Reedgarden/WRS-HW/mechanics/v3.4/emblema seven.JPG

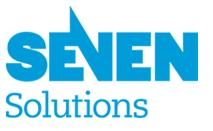
mechanics/v3.4/emblema seven.JPG
