Reedgarden/WRS-HW/mechanics/v3.4/BOX_WRS_PART_LIST.xls

 | SEVEN SOLUTIONS S.L.
TEAM | BOX_WRS
PROYECT | WHITE RABBIT
DOCUMENT | Part List
VERSION | 3.4
MADE BY | RODRIGO AGIS
VERIFIED BY | DAVID RAMIREZ
APPROVED BY | RODRIGO AGIS
DATE | 05/11/2015
OBSERVATIONS
ITEM | DESCRIPTION | MANUFACTURER | MANUFACTURER PN | QUANTITY PER SWITCH
1 | FAN 40x40x20 | Gicoda | MB40201VX-000U-A99 | 2
2 | FINGER GUARD | MULTICOMP | 1710466 | 2
3 | WIRE TO BOARD CONNECTOR | WURTH ELEKTRONIK | 61900211621 | 2
4 | PIN TERMINAL FAN | WURTH ELEKTRONIK | 61900113722DEC | 4
5 | COOLER MOUNTING FPGA | MALICO | CL-Y-35X35 | 1
6 | COOLER FPGA H = 12 mm | MALICO | MBH35002-12P/2.6 | 1
7 | SILICON PAD 1.06mm, 4"x4" | BERGQUIST | GP5000S35-0.040-02-0404 | 1 / 9
8 | POWER SUPPLY, 12V, 80W | EOS | LFVLT80-1001 | 1
9 | POWER FILTER, 4 A-230V | SCHURTER | DC12.3102.001 | 1
10 | POWER WIRE 230V | APSA | 1450/2.5 SW | 1
11 | WIRE 18AWG, 1.169mm^2 BLACK | ALPHAWIRE | 6715 BK005 | 25 CM
12 | WIRE 18AWG,1.169mm^2 RED | ALPHAWIRE | 6715 RD005 | 45 CM
13 | WIRE 18AWG, 1.169mm^2 BLUE | ALPHAWIRE | 6715 BL005 | 25 CM
14 | WIRE 18AWG, 1.169mm^2 YELLOW/GREEN | ALPHAWIRE | 6715 GY005 | 40 CM
15 | TERMINAL PIN SOCKET FACTON, RED 6.35MM ISOLATED | MULTICOMP | FDFNYD1-250 | 4
16 | TERMINAL PIN, BULLET, PLUG, RED | JST (JAPAN SOLDERLESS TERMINALS) | FVDAGM1.25-5 (LF) | 1
17 | TERMINAL PIN, BULLET, SOCKET, RED | JST (JAPAN SOLDERLESS TERMINALS) | CVDAGF1.25-5 (LF) | 1
18 | TERMINAL PIN FASTON ISOLATED, RING, 3MM, RED | JST (JAPAN SOLDERLESS TERMINALS) | FVWS1.25-3 (LF) | 4
19 | RESET WIRE | JST (JAPAN SOLDERLESS TERMINALS) | SMF-20LV300-D.. | 1
20 | WIRE CASE CONNECTOR | JST (JAPAN SOLDERLESS TERMINALS) | 1P-SMF | 25 CM
21 | WIRE CONNECTOR | SULLINS CONNECTOR SOLUTIONS | LPPB032CFFN-RC | 1
22 | SPACERS SCB H=8mm D=4,75mm | HARWIN | 1703088 | 4
23 | NUT IOX M4 | DURATOOL | M4- HFA2-S100- | 9
24 | WASHER INOX M3 | DURATOOL | 6797/3.0 | 2
25 | WASHER INOX M4 | DURATOOL | 6797/4.3 | 5
26 | SCREW METAL BOX INOX DIN7991 M3x8MM | TR FASTENINGS | M38 KHHTMCS100- | 13
27 | SCREW METAL BOX INOX DIN7991 M3x12MM | TR FASTENINGS | M312 KHA2MCS50- | 2
28 | SCREW PCB MINI BACK-PLANE GROUND ISO 7380 M3x8MM | DURATOOL | M38 BHA2MCS100- | 12
29 | SCREW SCB ISO 7380 M3X16MM | TR FASTENINGS | W/M3/16/BHA2MC/TC1D | 4
30 | SCREW GROUND METAL BOX ISO 7380 M4x10MM | TR FASTENINGS | M410 BHA2MCS100- | 5
31 | SCREW GROUND (BACK) 4x25MM INOX | TR FASTENINGS | M425 SOA2CSS50- | 1
32 | SCREW FAN ISO 7380 M4X30MM | TR FASTENINGS | M430 KHHTMCS100- | 8
33 | PIN TERMINAL SUPPLY (OUT 12V, IN 230V), paso 3.96MM, 18 a 24 DWG | MOLEX | 08-50-0106 | 6
34 | TERMINAL PIN IN 12V PCB. | TE CONNECTIVITY / AMP | 163306-2 | 2
35 | SUPPLY CONNECTOR COVER PCB (12V), 2 PINS | TE CONNECTIVITY / AMP | 1-480318-0 | 1
36 | SUPPLY CONNECTOR COVER ( OUT 12V), 12 PINS, 3.96mm,. | MOLEX | 09-50-3121 | 1
37 | SUPPLY CONNECTOR PINS COVER 3 PINS (IN 230V), 3.96mm. | MOLEX | 09-50-3031 | 1
