Reedgarden/WRS-HW/circuit_board/wrs_v3/SCB_SAM9G45/PartLists/SCB_White_Rabbit_Part_List_3_4.1.xls

 |  |  | SEVEN SOLUTIONS S.L.
 |  | EQUIPO | SCB
 |  | PROYECTO | WHITE RABBIT
 |  | DOCUMENTO | 7S_IDC14-SCB-V3_4-PL-V3_41
 |  | VERSIÓN | 3.41
 |  | REALIZADO POR | J. GABRIEL RAMÍREZ
 |  | VERIFICADO POR | ÁNGEL TOBARUELA
 |  | APROBADO POR | J. GABRIEL RAMÍREZ
 |  | FECHA | 22/09/2014
 |  | COMENTARIOS | Cambios conforme PC-02
Position | Manufacturer PN | Manufacturer | Description | Designator | Footprint | Quantity | Distributor1 | Distributor1 PN | Cambios con respecto a V3.4
1 | SCB_V3_4 | Labs Circuits | 12 Layers PCB | N/A | N/A | 1 | N/A | N/A
2 | C2012X5R0J226M | TDK | 22uF ±20% 6,3V X5R Capacitor | C1, C2, C3, C4, C75, C76, C85, C86, C247, C263, C266, C268, C269, C270, C271, C283, C292, C294, C295, C296, C297, C300, C301, C302, C311, C429, C430, C431, C432 | CC2012-0805 | 29 | Digikey | 445-1422-1-ND
3 | C1608X5R1A475K | TDK | 4,7uF ±10% 10V X5R Capacitor | C10, C23, C68, C71, C72, C74, C84, C91, C92, C93, C94, C95, C96, C218, C238, C246, C255, C256, C264, C267, C273, C274, C275, C276, C277, C284, C287, C303, C304, C312, C318, C322, C323 | CC1608-0603 | 33 | Digikey | 445-5170-1-ND
4 | C1005X7R1C224K | TDK | 220nF ±10% 16V X7R Capacitor | C104, C105, C106, C107, C108, C109, C110, C111, C112, C113, C114, C115, C116, C117, C118, C119, C120, C121, C123, C124, C126, C127, C128, C129, C130, C131, C132, C133, C134, C135, C136, C137 | CC1005-0402 | 32 | Digikey | 445-5936-1-ND
5 | C1005X7R1E102K | TDK | 1nF ±10% 25V X7R Capacitor |  | CC1005-0402 | 0 | Digikey | 445-4924-1-ND
6 | C1608C0G1H330J | TDK | 33pF ±5% 50V COG Capacitor | C164 | CC1608-0603 | 1 | Digikey | 445-1275-1-ND
7 | CC0603KRX7R9BB104 | Phycomp | 100nF ±10% 50V X7R Capacitor |  | CC1608-0603 | 0 | Digikey | 311-1344-1-ND
8 | C1005C0G1H100C | TDK | 10pF ±5% 50V NP0 Capacitor | C166, C202, C204, C205, C314 | CC1005-0402 | 5 | Digikey | 445-4896-1-ND
9 | CC0603KRX7R6BB224 | Yageo | 220nF ±10% 10V X7R Capacitor | C165, C168 | CC1608-0603 | 2 | DigiKey | 311-1346-1-ND
10 | C1608C0G1H680J | TDK | 68pF ±5% 50V COG Capacitor | C170 | CC1608-0603 | 1 | Digikey | 445-1279-1-ND
11 | C1005C0G1H150J | TDK | 15pF ±5% 50V NP0 Capacitor | C19, C20 | CC1005-0402 | 2 | Digikey | 445-1237-1-ND
12 | C1005X7R1H471K | TDK | 470pF ±10% 50V X7R Capacitor |  | CC1005-0402 | 0 | Digikey | 445-1255-1-ND
13 | C1005C0G1H270J | TDK | 27pF ±5% 50V NP0 Capacitor | C21, C22 | CC1005-0402 | 2 | Digikey | 445-1240-1-ND
14 | B32529C1104K000 | EPCOS | 100nF ±10% 100V Polyester Capacitor | C214 |  | 1 | Farnell | 9750983
15 | C2012X5R1C226K | Phycomp | 22uF ±10% 16V X5R Capacitor | C239, C248, C254, C257, C278, C279, C305, C306 | CC2012-0805 | 8 | Digikey | 445-6797-1-ND
16 | ECJ-0EB1H272K | Panasonic | 2,7nF ±10% 50V X7R Capacitor | C163, C206, C245, C262, C265, C282, C310 | CC1005-0402 | 7 | Digikey | PCC1726CT-ND
17 | T520D227M010ATE018 | Kemet | 220uF ±20% 10V 18mOhm Tantalum Capacitor | C249, C258, C280, C307 | D | 4 | Digikey | 399-4045-1-ND
18 | T520D227M006ATE009 | Kemet | 220uF ±20% 6,3V 9mOhm Tantalum Capacitor | C259, C260, C288, C289, C290, C291, C427, C428 | D | 8 | Digikey | 399-4042-1-ND
19 | C1005X7R1E223K | TDK | 22nF ±10% 25V X7R Capacitor |  | CC1005-0402 | 0 | Digikey | 445-1261-1-ND
20 | C1608X5R0J106M | TDK | 10uF ±20% 6,3V X5R Capacitor | C35, C36, C42, C46, C47, C55, C140, C144, C151, C155, C156, C161, C167, C175, C203, C211 | CC1608-0603 | 16 | Digikey | 445-4112-1-ND
21 | C1005X7R1E473K | TDK | 47nF ±10% 25V X7R Capacitor | C53, C54, C328 | CC1005-0402 | 3 | Digikey | 445-4941-1-ND
22 | C1005X7R1C104K | TDK | 100nF ±10% 16V X7R Capacitor | C5, C6, C7, C8, C9, C11, C12, C13, C14, C15, C16, C17, C18, C24, C25, C26, C29, C30, C31, C33, C34, C37, C38, C40, C41, C44, C45, C52, C56, C57, C59, C60, C100, C141, C142, C143, C146, C148, C159, C160, C162, C169, C171, C172, C173, C174, C176, C177, C178, C180, C181, C183, C184, C186, C187, C191, C192, C193, C194, C201, C207, C208, C209, C210, C212, C213, C215, C216, C217, C219, C220, C221, C222, C223, C224, C225, C226, C227, C228, C229, C230, C231, C232, C233, C234, C240, C241, C242, C243, C244, C253, C261, C285, C286, C293, C298, C299, C309, C316, C317, C319, C320, C321, C324, C325, C326, C422 | CC1005-0402 | 111 | Digikey | 445-4952-1-ND
23 | C1005X7R1E103K | TDK | 10nF ±10% 50V X7R Capacitor | C43, C58, C88, C89, C90, C99, C101, C102, C103, C122, C125, C138, C139, C149, C150, C152, C153, C154, C157, C158, C185, C189, C190, C195, C196, C197, C199, C327 | CC1005-0402 | 28 | Digikey | 445-1260-1-ND
24 | C1005X5R1C105K | TDK | 1uF ±10% 16V X5R Capacitor | C61, C235, C236, C237, C250, C251, C252, C272, C281, C315 | CC1005-0402 | 10 | Digikey | 445-4978-1-ND
25 | o.c. | Phycomp | Capacitor |  | CC1608-0603 | 0 | Digikey
26 | C1005X5R1C474K | TDK | 470nF ±10% 16V X5R Capacitor | C69, C70, C73, C83, C87 | CC1005-0402 | 5 | Digikey | 445-4976-1-ND
27 | T520D337M006ATE025 | Kemet | 330uF ±20% 6,3V 25mOhm Tantalum Capacitor | C77, C78, C79, C80, C81, C82, C97, C98 | D | 8 | Digikey | 399-4053-1-ND
28 | 1888250-1 | Tyco Electronics | Low Profile uTCA Ethernet Jack (RJ45) | CN1 | TYCO_ETHERNET_1888250-1 | 1 | Digikey | A98526-ND
29 | KX15-20K4DE |  | Multipin B2B Connector (plug) 20 pins |  | JAE_KX15_20P | 0 | Digikey | 670-1305-ND
30 | BM02B-SRSS-TB(LF)(SN) | JAPAN SOLDERLESS TERMINALS | Disconnectable Crimp Style Connector, 1.0mm pitch | CN3 | SH_CRIMP_1MM_2 | 1 | Farnell | 1679127
31 | UTCA_MCH_TONGUE3 | N/A | microTCA MTCA.0 standard MCH connector 3 |  | UTCA_MCH_TONGUE2_3_4 | 0 | N/A | N/A
32 | 1734035-1 | TE CONNECTIVITY | Mini USB Receptacle Type B Right Angle |  | USBB-G | 0 | Farnell | 1654060
33 | TS4148 RZ | Taiwan Semiconductor | High Speed Switching Diode | D1, D2, D3, D4 | CC1608-0603 | 4 | Farnell | 8150192
34 | LG L29K-G2J1-24-Z | Osram | LED SMARTLED GREEN 570NM | D11, D12, D13, D14 | CD1608-0603 | 4 | DigiKey | 475-2709-1-ND
35 | S2M-TP | Fairchild | Standard Diode 2A, 1KV, SMD | D16 |  | 1 | Digikey | S2M-TPMSCT-ND
36 | BAT54A-G | Comchip Technology | Schottky Barrier Double 200mA Diode | D5, D6, D9, D10 | SOT23 | 4 | Digikey | 641-1319-1-ND
37 | BAV99 | NXP | Silicon Switching Diode Array for High-Speed Switching | D8, D15 | SOT-23 | 2 | Farnell | 1081211
38 | SN74LVT125D | TEXAS INSTRUMENTS | Quad Buffer with 3-State Outputs with TTL Compatible Inputs | IC1 | PW014 | 1 | Farnell | 9592849
39 | AD8541AKSZ | Analog Devices | General-Purpose CMOS Amplifier, Rail-to-Rail input and output, 1MHz Bandwidth |  | SOT65P210X110-5N | 0 | Digikey | AD8541AKSZ-REEL7CT-ND
40 | ADCMP600BRJZ-R2 | Analog Devices | Rail-to-Rail, Very Fast, 2.5V to 5.5V, Single-Supply TTL/CMOS Comparators | IC11 | SOT23-5AL | 1 | Digikey | ADCMP600BRJZ-REEL7CT-ND
41 | MC100LVEP14DTG | On Semiconductors | Low-Voltage 1:5 Differential LVECL/LVPECL/LVEPECL/HSTL Clock Driver | IC12 | 948E-02_N | 1 | DigiKey | MC100LVEP14DTGOS-ND
42 | CDCM61002RHBT | Texas Instruments | Low Jitter Clock Generator, Two Outpust, Integrated VCO | IC13 | QFN32_POWERPAD | 1 | Farnell | 1710794
43 | AD9516-4BCPZ | Analog Devices | Clock Generator 2.5GHz VCO, 14 outputs (LVPECL, LVDS/CMOS) | IC16 | QFN50P900X900X100-64M | 1 | Digikey | AD9516-4BCPZ-ND
44 | TMP100NA/250 | TEXAS INSTRUMENTS | I2C Temperature Sensor | IC17, IC18, IC19, IC20 | SOT23A-6L | 4 | DigiKey | 296-12749-1-ND
45 | DS1374U-33+ | Maxim | I2C, 32 BIT BINARY COUNTER WATCHDOG RTC |  | UMAX10 | 0 | Digikey | DS1374U-33+-ND
46 | DS90LV011ATMF | National Semiconductor | Single High Speed Differential Driver | IC21 | MF05A_N | 1 | Digikey | DS90LV011ATMFCT-ND
47 | FNETHE025 | Pericom | SMD oscillator 3.3V (Elfa) | IC22, IC40 | SPXO | 2 | DigiKey | FNETHE025CT-ND
48 | AT45DB642D-CNU | Atmel | 64-megabit 2.7V, Dual-Interface DataFlash | IC25 | 8CN3 | 1 | DigiKey | AT45DB642D-CNU-ND
49 | SN74LVC1G32DBVR | TEXAS INSTRUMENTS | Single 2-Input Positive-OR Gate | IC26 | SOT23-5AL | 1 | DigiKey | 296-9847-1-ND
50 | LM385M3-2.5/NOPB | National Semiconductor | Micropower Voltage Reference 2.5V Diode | IC28 | MF03A_N | 1 | DigiKey | LM385M3-2.5CT-ND
51 | DS1374U-18+ | Maxim | I2C, 32 BIT BINARY COUNTER WATCHDOG RTC |  | UMAX10 | 0 | Digikey | DS1374U-18+-ND
52 | MT29F4G16ABBDAHC:D TR | Micron Techology | NAND Flash 256Mx16, 1.8V Asynch/Page | IC30 | VFBGA63 | 1 | Digikey | 557-1463-1-ND
53 | MAX3232CDBR | TEXAS INSTRUMENTS | 3-V to 5.5V Multichannel RS-232 Line Driver/Receiver with +/-15-KV ESD Protection | IC31 | SSOP16 | 1 | DigiKey | 296-13093-1-ND
54 | AP7173-SPG-13 | Diodes Inc. | 1.5A Low Dropout Linera Regulator | IC32, IC34, IC35, IC39, IC48 | SOIC127P600-8AL | 5 | Digikey | AP7173-SPG-13DICT-ND
55 | XC6VLX240T-1FFG1156C | Xilinx | Virtex-6 LXT Platform FPGA, 600 User I/Os, 20 GTXs, 1156-Ball FFBGA, Speed Grade 1, Commercial Grade | IC33 | FF1156 | 1 | CERN | N/A
56 | PC28F256P30BFA | Numonyx | NOR Flash Memory, 256Mbit |  | BGA64C100P8X8_1300X1000X120 | 0 | Digikey | PC28F256P30BFA-ND
57 | MCP1802T-3002I/OT | Microchip Technology | 300 mA, High PSRR, Low Quiescent Current LDO, 5-Pin SOT-23, Industrial Temperature, Tape and Reel | IC38, IC44 | SOT-23-OT5_N | 2 | DigiKey | MCP1802T-3002I/OTCT-ND
58 | VM53S3-25.000-2.5/-30+75 | MEC | VCTCXO 25MHz Oscillator | IC4 | VCTCXO_VM53S | 1 | RS | 672-0797
59 | LAN8720A-CP | SMSC | RMII Ethernet Transceiver with Auto MIDIX | IC41 | QFN50P400X400-24W4M | 1 | Digikey | 638-1080-ND
60 | CY7C1314KV18-250BZXC | Cypress Semic. | 18-Mbit (512Kx36) QDRII SRAM 2-Word Burst Architecture |  | BGA165C100P11X15_1300X1500X140 | 0 | Digikey | CY7C1314KV18-250BZXC-ND
61 | TPS51200DRCR | TEXAS INSTRUMENTS | Sink/Source DDR Termination Regulator |  | SON50P300X300X100-11N-R175X250 | 0 | Digikey | 296-26978-1-ND
62 | TPS53126RGET | TEXAS INSTRUMENTS | Dual Synchronous Step-Down Controller For Low Voltage Power Rails | IC46, IC47 | QFN50P400X400X100-25N-S255 | 2 | DigiKey | 296-24598-1-ND
63 | AD5662BRJZ | Analog Devices | NanoDAC 16 Bits, SPI, 2.7V to 5.5V, 250uA, Rail-to-Rail Output | IC5, IC8 | SOT23-8 | 2 | DigiKey | AD5662BRJZ-2REEL7CT-ND
64 | MT47H32M16HR-25E IT:G TR | Micron Techology | DDR2 SDRAM 8Mx16x4 Banks | IC50 | BGA-84 | 1 | DigiKey | 557-1520-1-ND
65 | AT91SAM9G45-CU | Atmel | ARM9 MCU 400 MHZ, RAM 64KB, ROM 64KB, 160 I/Os, Ethernet, I²C, MMC, SPI, SSC, UART/USART, USB, AC'97, LCD, POR, PWM, WDT | IC6 | TFBGA324 | 1 | DigiKey | AT91SAM9G45-CU-ND
66 | FRETHE025 | Pericom | VCXO 25MHz Oscillator | IC7 | vs-705 | 1 | Digikey | FRETHE025-ND
67 | ICS83023AMILF | IDT | 350MHz Differential-to-LVCMOS Dual Translator/Buffer | IC9 | TSOP65P490-8AN | 1 | Digikey | 800-1102-5-ND
68 | QSS-048-01-L-D-DP QSS-075-01-L-D-A | Samtec | High Speed Ground Plane Socket, 48 Differential Pair Signaling, | J1, J2 | QSS-048-01-X-D-DP-A | 2 | Samtec
69 | QSS-016-01-L-D-DP | Samtec | High Speed Ground Plane Socket, 16 Differential Pair Signaling, |  | QSS-016-01-X-D-DP-A | 0 | Samtec
70 | DC10A | CLIFF ELECTRONIC COMPONENTS | Power Jack 5A @ 12V |  | dc-10 | 0 | Farnell | 224959
71 | 742792093 | Wurth Electronics Inc | FERRITE BEAD 2200 OHM .20A 0805 | L1, L16, L17, L18 | 742792093 | 4 | DigiKey | 732-1609-1-ND
72 | IHLP2525CZER1R5M01 | Vishay/Dale | Low Profile, High Current Inductor, 1.5uH±20%, 9A, 15mOhm | L11, L13, L14, L15 | IHLP2525 | 4 | Digikey | 541-1007-1-ND
73 | BLM18KG221SN1D | Murata | 220R@100MHz 2,2A 50mOhm Ferrite Bead | L2, L3, L4, L5, L6, L7, L8, L9, L12, L19, L20 | 0603 | 11 | Digikey | 490-5255-1-ND
74 | 152123 | Amphenol | SMC Straight Connector | P1, P3, P4, P7, P8 | SMB_V-RJ45 | 5 | Digikey | ACX1509-ND
75 | M22-5320305 | Harwin | Header, 6-Pin, Dual row, 2,54 mm pitch | P2 | HDR2X3 | 1 | Digikey | 952-1340-ND
76 | 0878321421 | Molex | SMD Header, 7-Pin, Dual row, 2mm pitch | P5 | CONN_HDR_SMD_2mm_2x7 | 1 | Digikey | WM4231-ND
77 | SBH11-PBPC-D10-ST-BK | Sullins Connector Solutions | Header, 10-Pin, Dual row, 2,54mm pitch | P6 | HDR2X10 | 1 | DigiKey | S9172-ND
78 | BG055-03A-1-0450-0530-0350-L-G | GLOBAL CONNECTOR TECHNOLOGY |  |  | HDR1x3_BG055 | 0 | Farnell | 1798981
79 | NDS331N | Fairchild | N-Channel Logic Level Enhancement Mode Field Effect Transistor | Q1, Q2, Q3 | SOT23-3 | 3 | Digikey | NDS331NCT-ND
80 | CRCW0805100RFKEAHP | Vishay/Dale | 100R ±1% 0.33W ±100ppm/°C Resistor | R31, R32, R257, R258 | 0805 | 4 | Digikey | 541-100TCT-ND
81 | ERJ-2RKF2201X | Panasonic | 2K2 ±1% 0.1W ±100ppm/°C Resistor | R36, R38 | 0402 | 2 | DigiKey | P2.20KLCT-ND
82 | ERJ-2RKF3002X | Panasonic | 30K ±1% 0.1W ±100ppm/°C Resistor | R107, R175 | 0402 | 2 | DigiKey | P30.0KLCT-ND
83 | RC0402FR-0722KL | Yageo | 22K ±1% 0.063W ±100ppm/°C Resistor | R116, R176, R206 | 0402 | 3 | DigiKey | 311-22.0KLRCT-ND
84 | ERJ-2RKF4701X | Panasonic | 4K7 ±1% 0.1W ±100ppm/°C Resistor | R45, R47, R48, R49, R55, R100, R102, R110, R111, R117, R120, R126, R132, R185, R189, R200, R202, R203, R208, R209, R232, R237, R239, R240, R243, R248, R249, R252, R256 | 0402 | 29 | DigiKey | P4.70KLCT-ND
85 | ERJ-2RKF33R0X | Panasonic | 33R ±1% 0.1W ±100ppm/°C Resistor | R30, R63, R70, R78, R142, R143, R144, R146, R147, R151 | 0402 | 10 | DigiKey | P33.0LCT-ND
86 | ERJ-2RKF1501X | Panasonic | 1K5 ±1% 0.1W ±100ppm/°C Resistor | R159, R186, R195, R196, R236 | 0402 | 5 | DigiKey | P1.50KLCT-ND
87 | ERJ-2RKF4871X | Panasonic | 4K87 ±1% 0.1W ±100ppm/°C Resistor | R178 | 0402 | 1 | DigiKey | P4.87KLCT-ND
88 | ERJ-2RKF2431X | Panasonic | 2K43 ±1% 0.1W ±100ppm/°C Resistor | R180 | 0402 | 1 | DigiKey | P2.43KLCT-ND
89 | ERJ-2RKF6811X | Panasonic | 6K81 ±1% 0.1W ±100ppm/°C Resistor | R194 | 0402 | 1 | DigiKey | P6.81KLCT-ND
90 | ERJ-2RKF1212X | Panasonic | 12K1 ±1% 0.1W ±100ppm/°C Resistor | R197 | 0402 | 1 | DigiKey | P12.1KLCT-ND
91 | o.c. | N/A, Panasonic | SMD Resistor |  | 0402 | 0 | DigiKey, N/A | N/A
92 | ERJ-2RKF4700X | Panasonic | 470R ±1% 0.1W ±100ppm/°C Resistor | R20, R22, R33, R145 | 0402 | 4 | DigiKey | P470LCT-ND
93 | RC0603JR-070RL | Panasonic | 0R0 Ohm 1/10W 0603 Resistor | R177 | 0603 | 1 | DigiKey | 311-0.0GRCT-ND
94 | ERJ-2RKF2490X | Panasonic | 249R ±1% 0.1W ±100ppm/°C Resistor |  | 0402 | 0 | DigiKey | P249LCT-ND
95 | ERJ-2RKF9311X | Panasonic | 9K31 ±1% 0.1W ±100ppm/°C Resistor | R228, R234 | 0402 | 2 | DigiKey | P9.31KLCT-ND
96 | ERJ-2RKF2000X | Panasonic | 200R ±1% 0.1W ±100ppm/°C Resistor | R42, R68, R71, R72, R73, R81, R82, R84, R85, R87, R88, R89, R91, R92, R93, R141, R246, R247 | 0402 | 18 | DigiKey | P200LCT-ND
97 | ERJ-2RKF2801X | Panasonic | 2K8 ±1% 0.1W ±100ppm/°C Resistor | R230 | 0402 | 1 | DigiKey | P2.80KLCT-ND
98 | ERJ-2RKF1302X | Panasonic | 13K ±1% 0.1W ±100ppm/°C Resistor | R241 | 0402 | 1 | DigiKey | P13.0KLCT-ND
99 | ERJ-2RKF1000X | Panasonic | 100R ±1% 0.1W ±100ppm/°C Resistor | R29, R39, R59, R90, R171, R193, R218, R220, R223, R224, R225, R245, R250 | 0402 | 13 | DigiKey | P100LCT-ND
100 | ERJ-2RKF1002X | Panasonic | 10K ±1% 0.1W ±100ppm/°C Resistor | R4, R5, R6, R11, R35, R37, R106, R128, R129, R138, R165, R166, R167, R168, R169, R170, R181, R188, R190, R191, R198, R199, R207, R211, R229, R231, R238, R242 | 0402 | 28 | DigiKey | P10.0KLCT-ND
101 | CRCW060333R0FKEAHP | Vishay/Dale | 33R ±1% 0.25W ±100ppm/°C Resistor | R34, R41, R172, R173, R182, R183 | 0603 | 6 | DigiKey | 541-33.0SCT-ND
102 | ERJ-2RKF1001X | Panasonic | 1K ±1% 0.1W ±100ppm/°C Resistor | R101, R103, R104, R105, R112, R113, R114, R115, R121, R124, R133, R136, R205 | 0402 | 13 | DigiKey | P1.00KLCT-ND
103 | CRCW060349R9FKEAHP | Vishay/Dale | 49R9 ±1% 0.25W ±100ppm/°C Resistor | R40, R154, R155, R156, R157 | 0603 | 5 | DigiKey | 541-49.9SCT-ND
104 | ERJ-2RKF3300X | Panasonic | 330R ±1% 0.1W ±100ppm/°C Resistor | R1, R46, R160, R161, R162, R163, R184, R217, R219, R221, R222, R226 | 0402 | 12 | DigiKey | P330LCT-ND
105 | ERJ-2GE0R00X | Panasonic | 0R0 Ohm 1/10W 0402 Resistor | R28, R152, R153, R187, R192, R210, R233, R251 | 0402 | 8 | DigiKey | P0.0JCT-ND
106 | ERJ-2RKF1003X | Panasonic | 100K ±1% 0.1W ±100ppm/°C Resistor | R7, R8, R9, R10, R158 | 0402 | 5 | DigiKey | P100KLCT-ND
107 | ERJ-2RKF49R9X | Panasonic | 49R9 ±1% 0.1W ±100ppm/°C Resistor | R23, R24, R25, R26, R27, R75, R77, R174 | 0402 | 8 | DigiKey | P49.9LCT-ND
108 | ERJ-3EKF8200V | Panasonic | 820R ±1% 0.1W ±100ppm/°C Resistor | R79 | 0603 | 1 | DigiKey | P820HCT-ND
109 | ERJ-3EKF3900V | Panasonic | 390R ±1% 0.1W ±100ppm/°C Resistor | R80 | 0603 | 1 | DigiKey | P390HCT-ND
110 | ERJ-2RKF4121X | Panasonic | 4K12 ±1% 0.1W ±100ppm/°C Resistor | R83, R98, R99, R108, R109, R118, R130, R148, R204 | 0402 | 9 | DigiKey | P4.12KLCT-ND
111 | ERJ-2RKF5101X | Panasonic | 5K1 ±1% 0.1W ±100ppm/°C Resistor | R86 | 0402 | 1 | DigiKey | P5.10KLCT-ND
112 | EXB-E10C470J | Panasonic | 47R, 62.5mW Chip Resistor Bussed Network |  | EXBE | 0 | DigiKey | U8470CT-ND
113 | MNR18E0APJ270 | Rohm | 27R, 62.5mW Chip Resistor 8 Elements Array | RP15, RP16, RP17, RP18, RP19, RP20 | RESCAXS50P160X380X60-16N | 6 | DigiKey | MNR18270CT-ND
114 | FSM6JSMA | Tyco Electronics | Push button | S1, S2 | SWITCH | 2 | Farnell | 1555991
115 | 219-4MST | CTS Electrocomponents | 4 Positions DIP SWITCH |  | NHDS-8 | 0 | Digikey | CT2194MST-ND
116 | IRF9910Pbf | INTERNATIONAL RECTIFIER | Dual N-Channel 20V 10A MOSFET Logic Level Gate, 9.3mOhm@12A | T2, T3, T4, T5 | SOIC127P600X175-8N | 4 | DigiKey | IRF9910PBFCT-ND
117 | H1260NL | Pulse | Ethernet Trafo (TME) | Tr1 | H1260NL | 1 | Digikey | 553-1328-ND
118 | 1812WBT2_4LB | Coilcraft | SMT Mini WideBand Transformer 2:1, 11-200 MHz |  | 1812WBT2_4LB | 0 | Coilcraft | 1812WBT2_4LB
119 | ABS09-32.768KHZ-T | Raltron | Crystal Oscillator 32768 Hz 12,5 pF | X1 | XTAL_32k | 1 | Newark | 14N8752
120 | 7M-12.000MAAJ-T | TXC Corp. | SMD Crystal 7M Series 18pF 30 ppm | X2 | OSC_IQD_CFPS-39 | 1 | DigiKey | 887-1121-1-ND
121 | GRPB032VWVN-RC | Sullins Connector Solutions | THT Header, 3-Pin, Dual row, 1.27mm pitch | P10 | MHDR2X3_1.27mm | 1 | DigiKey | S9015E-03-ND
122 | ABS09-32.768KHZ-7-T | Abracon Corp. | Crystal 32.768 Hz 7,0pF SMD |  | ABS09 | 0 | Farnell | 1633672
123 | IVT3200C | Rakon | SMD Temperature Compensated Crystal Oscillators |  | OSC_RAKON_IVT3200C | 0
124 | WBC1-1LB | Coilcraft | SMT Mini WideBand Transformer 1:1, 10uH | Tr3 | SMT-6P150P | 1 | Coilcraft
125 | ERJ-3EKF75R0V | Panasonic | 75R ±1% 0.1W ±100ppm/°C Resistor |  | 0603 | 0 | DigiKey | P75.0HTR-ND
126 | ERJ-2RKF75R0X | Panasonic | 75R ±1% 0.1W ±100ppm/°C Resistor | R69, R76, R94, R95, R140, R253, R254, R255 | 0402 | 8 | DigiKey | P75.0LCT-ND | Se añaden R69, R94, R140 y R95. Cantidad pasa de 2 a 8
127 | MC100EP52DTG | On Semiconductors | Differential Data and Clock D-Type Flip-Flop | U1 |  | 1 | Digikey | MC100EP52DTGOS-ND
128 | CRCW060320R0FKEAHP | Vishay Dale | 20R ±1% 0.25W ±100ppm/°C Resistor | R21 |  | 1 | Digikey | 541-20.0SCT-ND
