Reedgarden/WRS-HW/mechanics/v3.4/Creotech_WRS_mechanics/WRS_assembly_20160425.stp

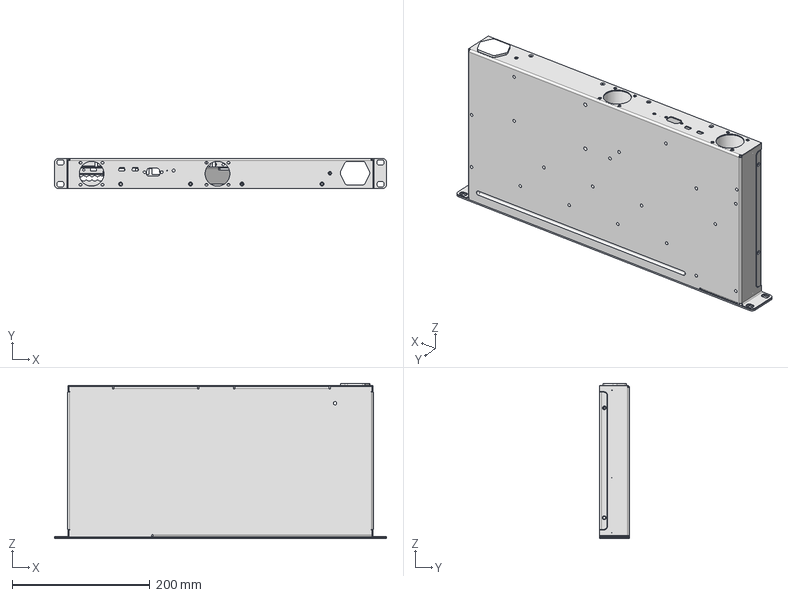
[picture p2: CAD file, 2016-04-26]
mechanics/v3.4/Creotech_WRS_mechanics/WRS_assembly_20160425.stp
482.6 x 43.5 x 225.8 mm
WRS_FMC_20150925_MK
WRS_gniazdo_zasilania_20150925_MK
WRS_kierownica_20150925_MK
WRS_panel_przedni_20150925_MK
WRS_podstawa_20150928AK
WRS_pokrywa_20150925_MK
WRS_wentylator_20150925_MK x 2
WRS_PCB_main_20150925_MK
WRS_blaszka_laczaca_20150928_MK
WRS_slupek_z_szesciokat_M3x8_nieprzelotowy_20151208_MK x 5
WRS_slupek_z_szesciokat_M3_20150925_MK x 19
WRS_slupek_z_szesciokat_M3x6_przelotowy_krotki_20151208_MK
EMC SFP
Mocowanie Gory prawy
Mocowanie Gory
