Reedgarden/WRS-HW/(list of files, cad)

Other CAD files:
mechanics/v3.4/silk-screen_printing_v3.4.dwg
mechanics/White Rabbit V3 Box.dwg
mechanics/old/v3.1/White Rabbit V3 Box.dwg
mechanics/v3.3/wrs-v3.3-box_v4-1-2.dwg
