Reedgarden/WRS-HW/circuit_board/wrs_v3/Docs_PDF/SCB Manufacturing PCB Specification.pdf

## SCB (Switching Core Board) Manufacturing PCB Specification

1 PCB General data.

- Dimension: 180,61 mm x 73,51mm
- Thickness: 1,60 mm ± 10%
- Number of layers: 12
- 6 routing layers (“Top Layer”, “MidLayer1”, “MidLayer2”, “MidLayer3”, “MidLayer4” and “Bottom Layer”)
- 6 plane layers (“GND1”, “GND2”, “GND3”, “PWR1”, “PWR2” and “PWR3”)
- Components total: 818 (top: 445, bottom: 373)
- SMD components: Yes, both sides
- Silkscreen: Yes, both sides
- Nets: 1006
- Vias: 3110, two sizes:
- Hole Sizes: 0,15mm and 0,4 mm
- Via Diameters: 0,4mm and 0,6 mm
- Pads: 4866
- Plating Finish: Nickel-Gold
- Controlled Impedance: Yes, in all the routing layers

### 2 Stack-Up Diagram

Top Layer | 17 + 25 µm
PrePreg | 65 µm
GND1 | 17 µm
Core | 150 µm
MidLayer1 | 17 µm
PrePreg | 130 µm
PWR1 | 17 µm
Core | 150 µm
MidLayer2 | 17 µm
PrePreg | 130 µm
GND2 | 17 µm
Core | 100 µm
PWR2 | 17 µm
PrePreg | 130 µm
MidLayer3 | 17 µm
Core | 150 µm
GND3 | 17 µm
PrePreg | 130 µm
MidLayer4 | 17 µm
Core | 150 µm
PWR3 | 17 µm
PrePeg | 65 µm
Bottom Layer | 17 + 25 µm
Thickness Total: | 1,604 mm ± 10%

### ©Seven Solutions S.L. 2011

Version: 0.0.

## SCB (Switching Core Board) Manufacturing PCB Specification

### 3 Layer Stack-Up Detail

Layer Name | Gerber Document | Copper Thickness | Dielectric Height | Dielectric Material | Dielectric Constant | 50Ώ Impedance Width | 100Ώ Differential Impedance Width/Gap
Top Solder Mask | (.GTS) | | 10 µm | Solder Resist | 3,5
Top Layer | (.GTL) | 42 µm | | | | 100 µm | 100µm/265µm
PrePreg | | | 65 µm | FR-4 | 4,6
GND1 | (.GP1) | 17 µm
Core | | | 150 µm | FR-4 | 4,5
MidLayer1 | (.G1) | 17 µm | | | | 100 µm | 100 µm/261 µm
PrePreg | | | 130 µm | FR-4 | 4,7
PWR1 | (.GP2) | 17 µm
Core | | | 150 µm | FR-4 | 4,5
MidLayer2 | (.G2) | 17 µm | | | | 100 µm | 100 µm/261 µm
PrePreg | | | 130 µm | FR-4 | 4,7
GND2 | (.GP3) | 17 µm
Core | | | 100 µm | FR-4 | 4,5
PWR2 | (.GP4) | 17 µm
PrePreg | | | 130 µm | FR-4 | 4,7
MidLayer3 | (.G3) | 17 µm | | | | 100 µm | 100 µm/261 µm
Core | | | 150 µm | FR-4 | 4,5
GND3 | (.GP5) | 17 µm
PrePreg | | | 130 µm | FR-4 | 4,6
MidLayer4 | (.G4) | 17 µm | | | | 100 µm | 100 µm/261 µm
Core | | | 150 µm | FR-4 | 4,8
PWR3 | (.GP6) | 17 µm
PrePreg | | | 65 µm | FR-4 | 4,8
Bottom Layer | (.GBL) | 42 µm | | | | 100 µm | 100µm/265µm
Bottom Solder Mask | (.GBS) | | 10 µm | Solder Resist | 3,5

### ©Seven Solutions S.L. 2011

Version: 0.0.
