Reedgarden/WRS-HW/circuit_board/wrs_v3/mini_backplane_18SFP/Bugs and changes of V3_2.odt

List of modifications of Version 3.2 of miniBackplane (SFP, 18 ports):

Schematics:

- Connector_GTX.SchDoc:
  - Added signals ARM_DEBUG_TXD, ARM_DEBUG_RXD (both from ARM) and USB_SWITCH_CTR (from FPGA)
- Powe_Supply.SchDoc:
  - R37 changed from 4K7 to 10K
  - C39 and C40 voltage rated increased up to 10V
- I2C_Multiplexers.SchDoc:
  - Added I2C Temperature Sensor TMP100 for sensing PCB Tª (placed close the PSU)
- FPGA_USB.SchDoc name changed by TEST_USB.SchDoc:
  - Added two 1:2 multiplexer controlled by the FPGA. By default the usb port is connected to the ARM.
  - USB CP2101 chip configuration changed to bus powered.
- Connectors_GPIOs.SchDoc:
  - Added individual PSU fan controlled by the signal FAN_BOX_EN_PB7.
  - Added 0R resistors to choice the FPGA fan voltage (5V or 12V).
- WR_LINK.SchDoc:
  - Serial resistor on leds changed by 49R9 (FPGA fed) and by 133R (I2C fed)

PCB:

- Power supply connector J7 orientation changed in order to allow connection of the new PSU.
- Added teardrops on vias.
