Reedgarden/WRS-HW/circuit_board/wrs_v3/Docs_PDF/SCB_Schematics_V3_4.pdf

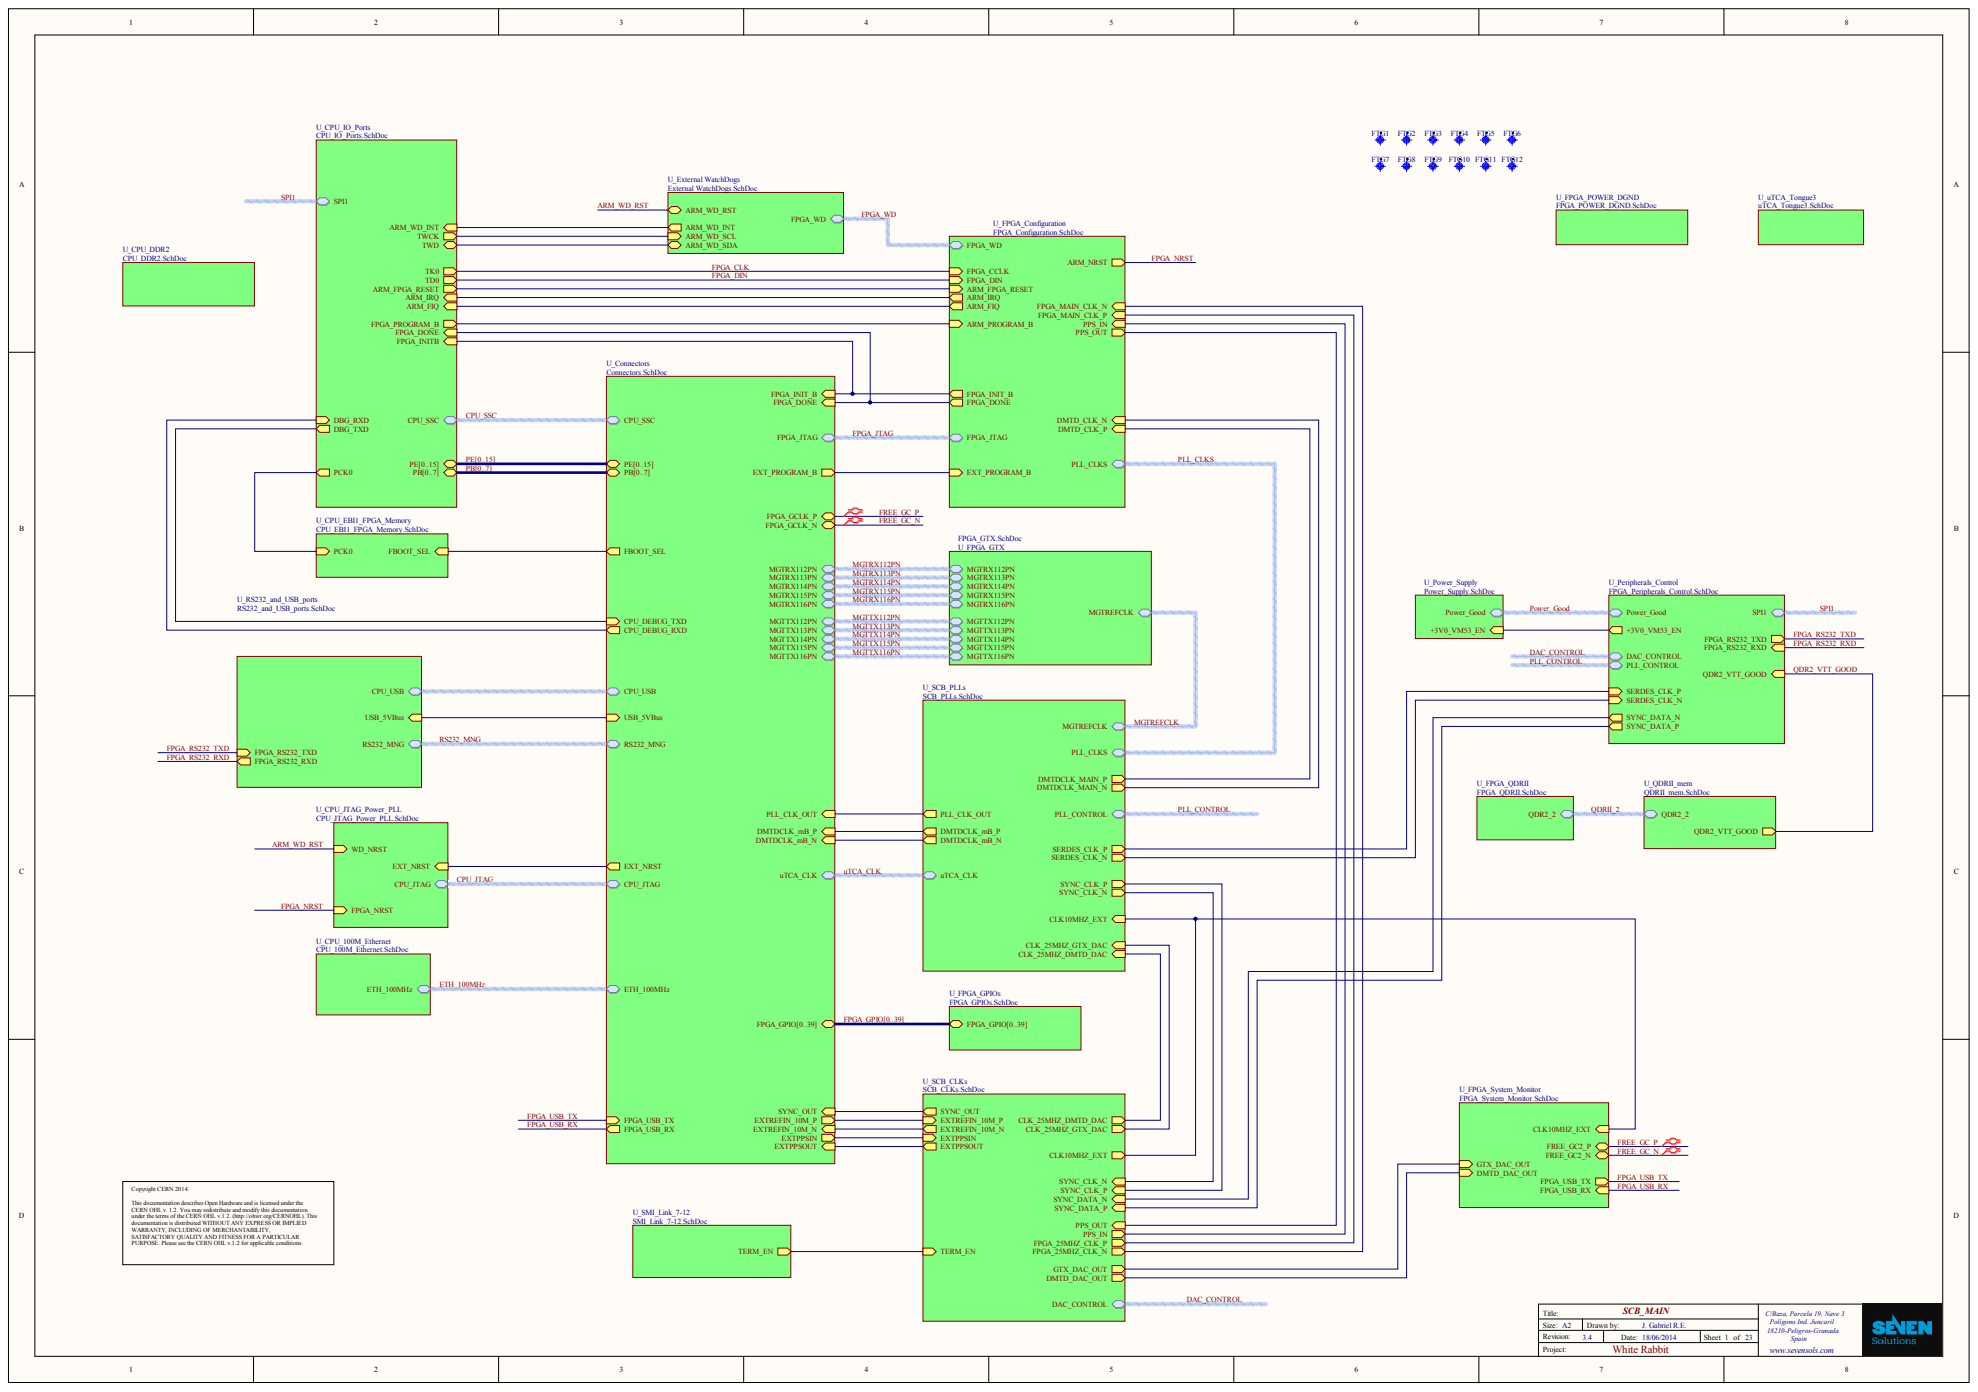
[picture p3: page 1]

FPGA_INIT_B

DBG_RXD CPU_SSC DBG_TXD

CPU_SSC | | FPGA_JTAG

This documentation describes Open Hardware and is licensed under the
CERN OHL v. 1.2. You may redistribute and modify this documentation
under the terms of the CERN OHL v.1.2. (http://ohwr.org/CERNOHL). This
documentation is distributed WITHOUT ANY EXPRESS OR IMPLIED
WARRANTY, INCLUDING OF MERCHANTABILITY,
SATISFACTORY QUALITY AND FITNESS FOR A PARTICULAR
PURPOSE. Please see the CERN OHL v.1.2 for applicable conditions.

Title: SCB_MAIN | C/Baza, Parcela 19, Nave 3 Polígono Ind. Juncaril 18210-Peligros-Granada Spain www.sevensols.com

Size: A2 | Drawn by: J. Gabriel R.E.
Revision: | Date: | Sheet of 23

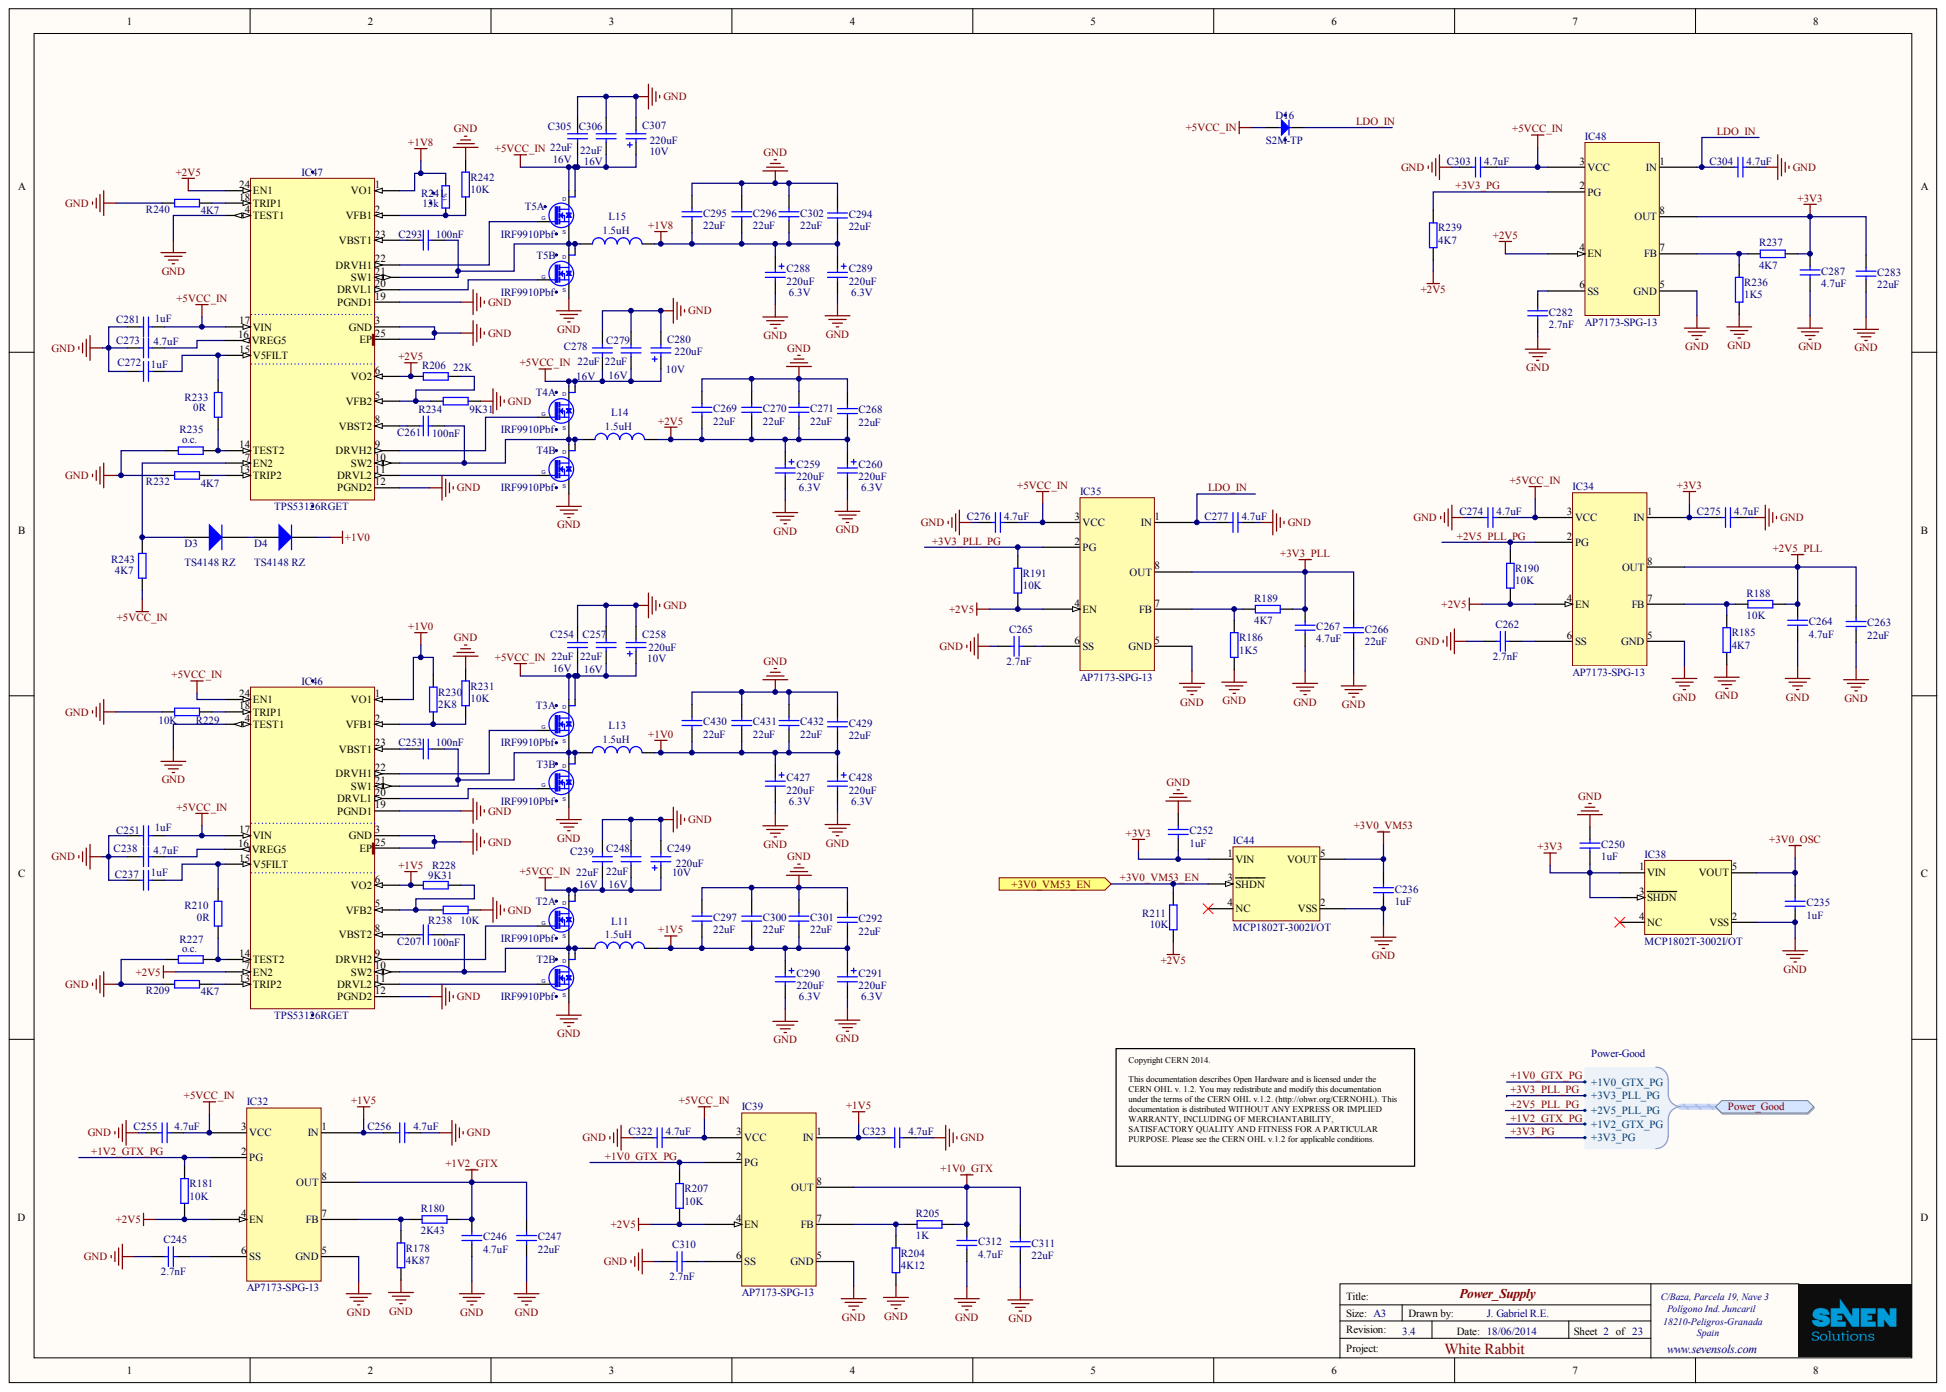
[picture p4: page 2]
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

Power_Supply | Spain

A3 | J. Gabriel R.E.

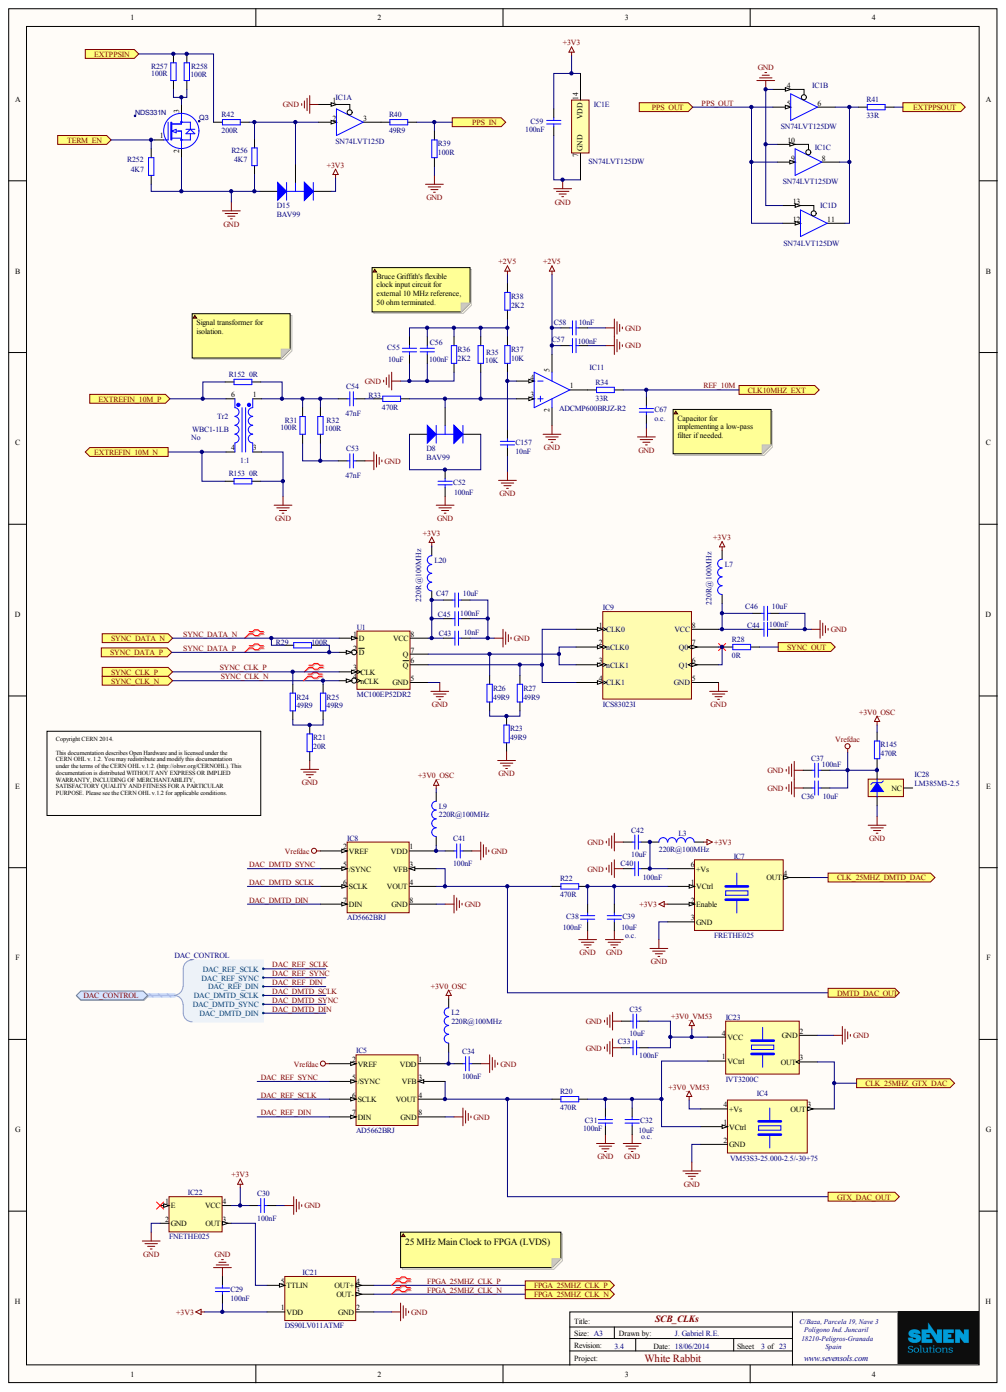
[picture p5: page 3]

Bruce Griffith's flexible
clock input circuit for
external 10 MHz reference,
50 ohm terminated.

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

25 MHz Main Clock to FPGA (LVDS)

SCB_CLKs | Spain

A3 | J. Gabriel R.E.

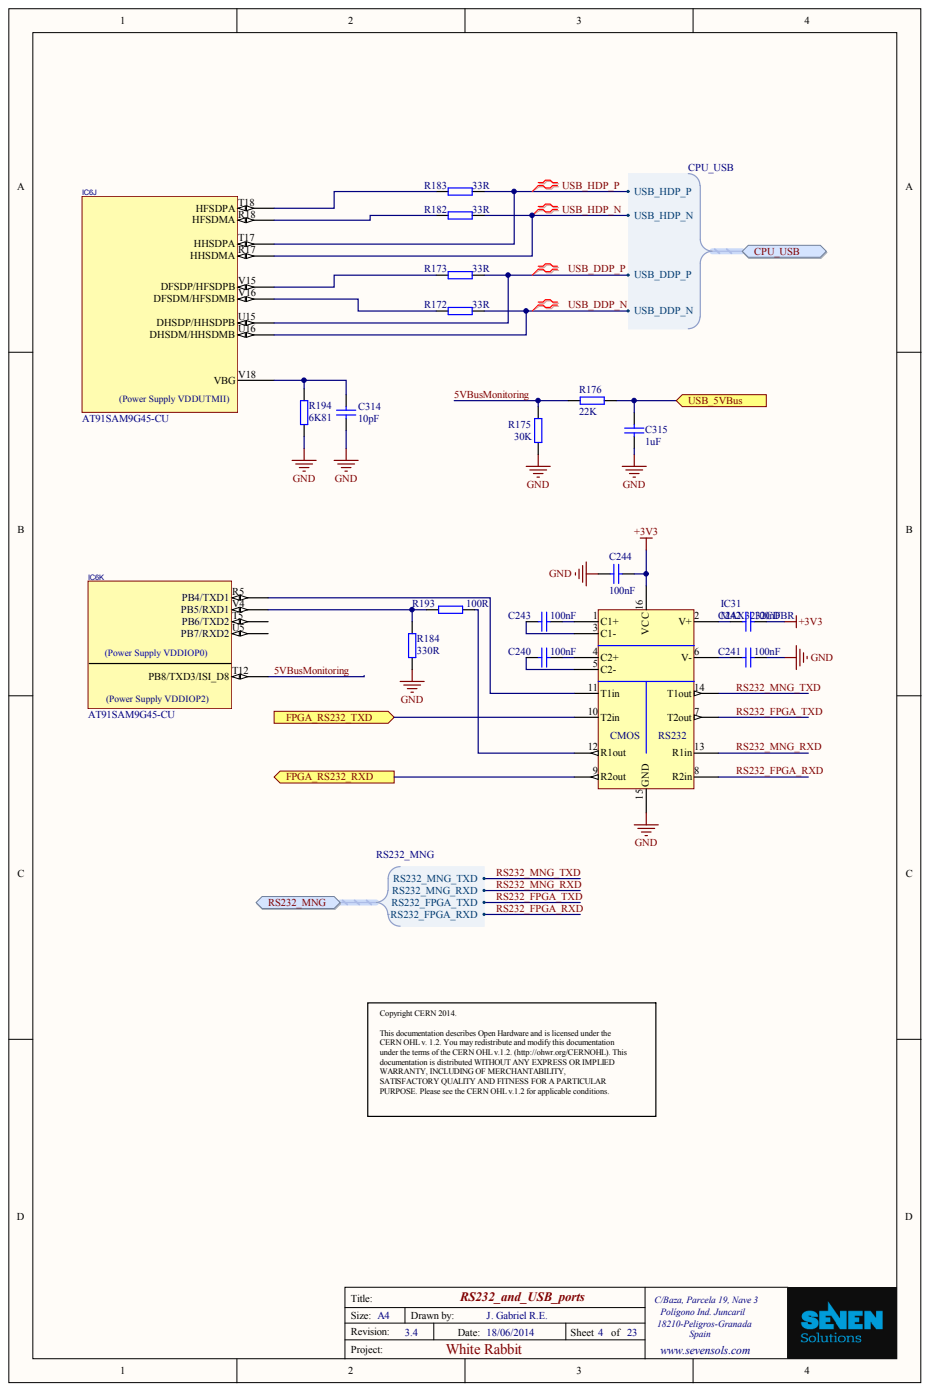
[picture p6: page 4]

DFSDM/HFSDMB V16 DFSDP/HFSDPB V15

DHSDM/HHSDMB U16 DHSDP/HHSDPB U15

T1in 11 | R2in 8 R2out 9

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

RS232_and_USB_ports | Spain

A4 | J. Gabriel R.E.

18210-Peligros-Granada 23

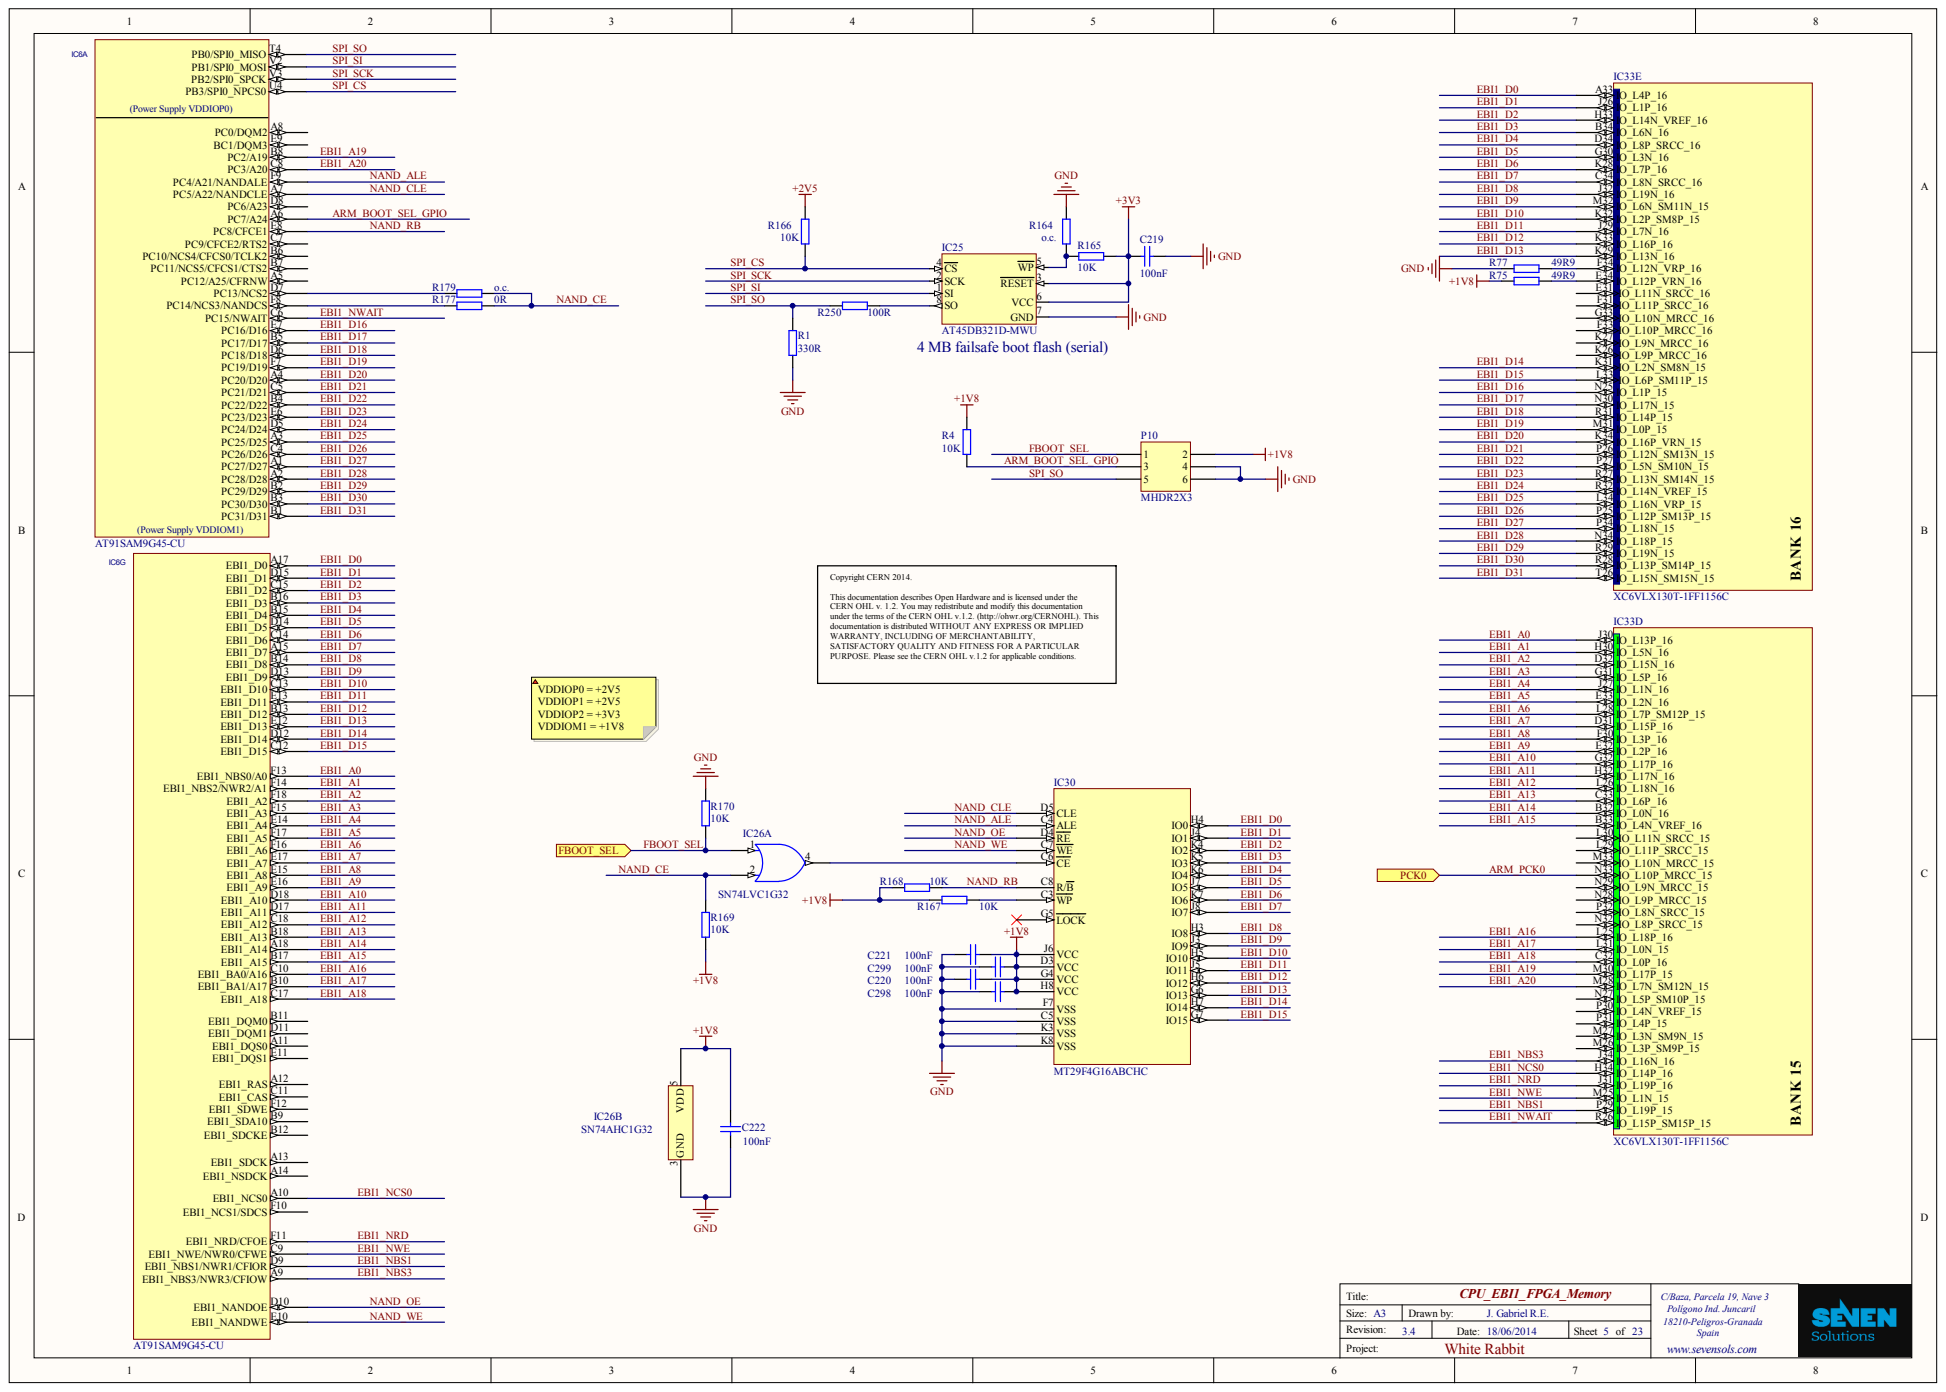
[picture p7: page 5]

Titl e : CP U_ EBI1_ FP GA_ Mem o ry | C/Baza, Parcela 19, Nave 3 Polígono Ind. Juncaril 18210-P e l igros-Granada Spai n www. s e v e n s ols.c o m

S i z e : A 3 | Dr awn b y : J. G abri e l R.E.
Re v i s i o n : . | Date : / / | S h e e t o f 3

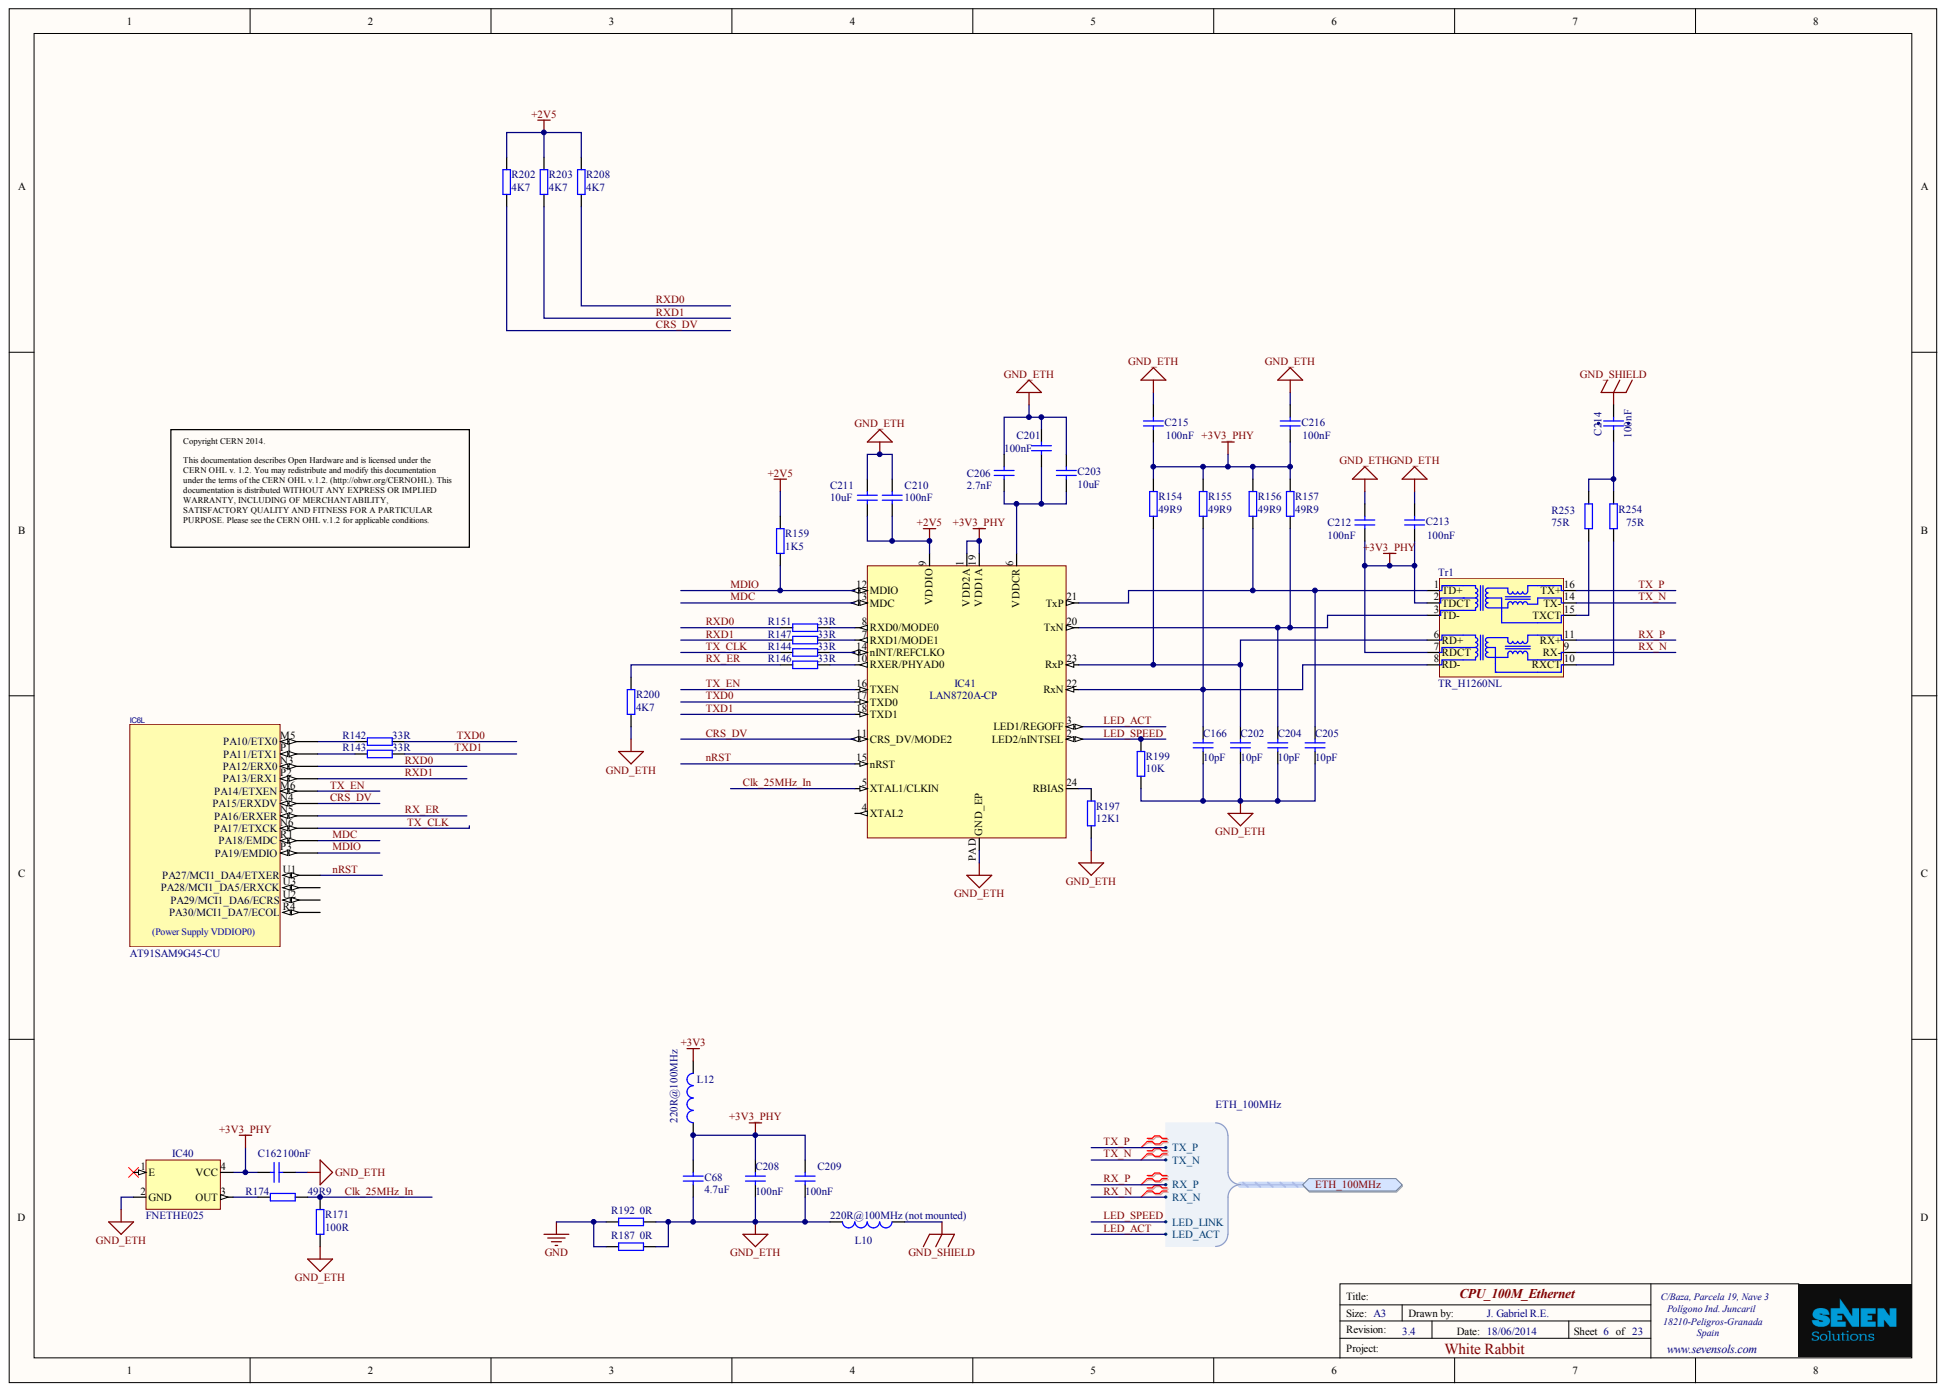
[picture p8: page 6]
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

TD- 3 | TXCT 15

CPU_100M_Ethernet | Spain

A3 | J. Gabriel R.E.

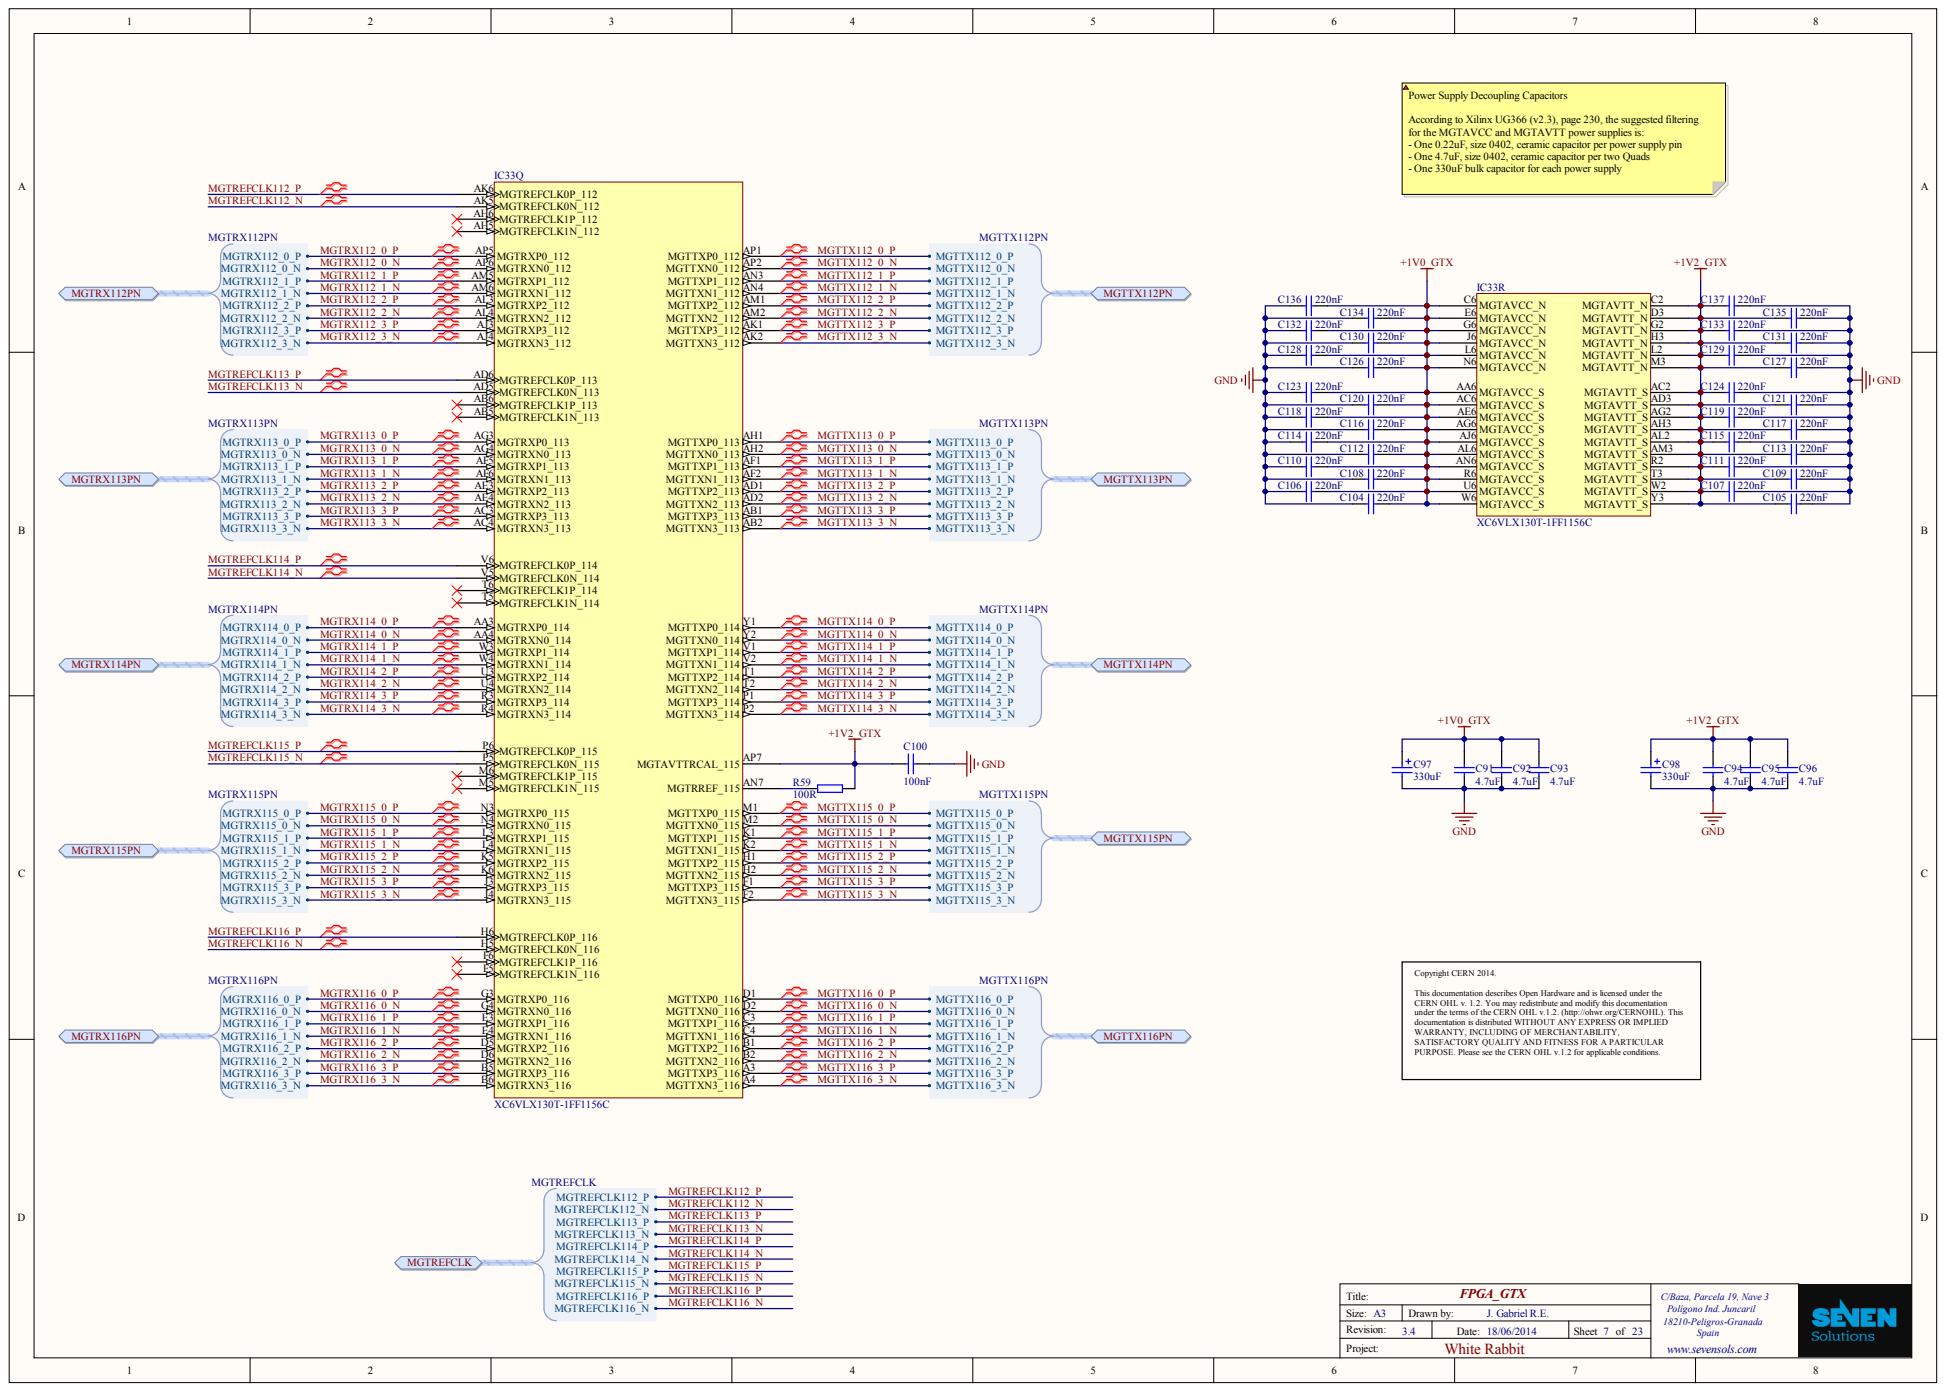
[picture p9: page 7]

Power Supply Decoupling Capacitors

According to Xilinx UG366 (v2.3), page 230, the suggested filtering
for the MGTAVCC and MGTAVTT power supplies is:
- One 0.22uF, size 0402, ceramic capacitor per power supply pin
- One 4.7uF, size 0402, ceramic capacitor per two Quads
- One 330uF bulk capacitor for each power supply

C132 | 220nF | | | MGTAVCC_N G6 | C133 | 220nF

C134 | 220nF | MGTAVCC_N E6 | | | C135 | 220nF

C130 | 220nF | MGTAVCC_N J6 | | | C131 | 220nF

C128 | 220nF | | | MGTAVCC_N L6 | C129 | 220nF

C126 | 220nF | MGTAVCC_N N6 | | | C127 | 220nF

C120 | 220nF | MGTAVCC_S AC6 | | | C121 | 220nF

C118 | 220nF | | | MGTAVCC_S AE6 | C119 | 220nF

C116 | 220nF | MGTAVCC_S AG6 | | | C117 | 220nF

C114 | 220nF | | | MGTAVCC_S AJ6 | C115 | 220nF

C110 | 220nF | | | MGTAVCC_S AN6 | C111 | 220nF

C112 | 220nF | MGTAVCC_S AL6 | | | C113 | 220nF

C108 | 220nF | MGTAVCC_S R6 | | | C109 | 220nF

C106 | 220nF | | | MGTAVCC_S U6 | C107 | 220nF

C104 | 220nF | MGTAVCC_S W6 | | | C105 | 220nF

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

FPGA_GTX | Spain

A3 | J. Gabriel R.E.

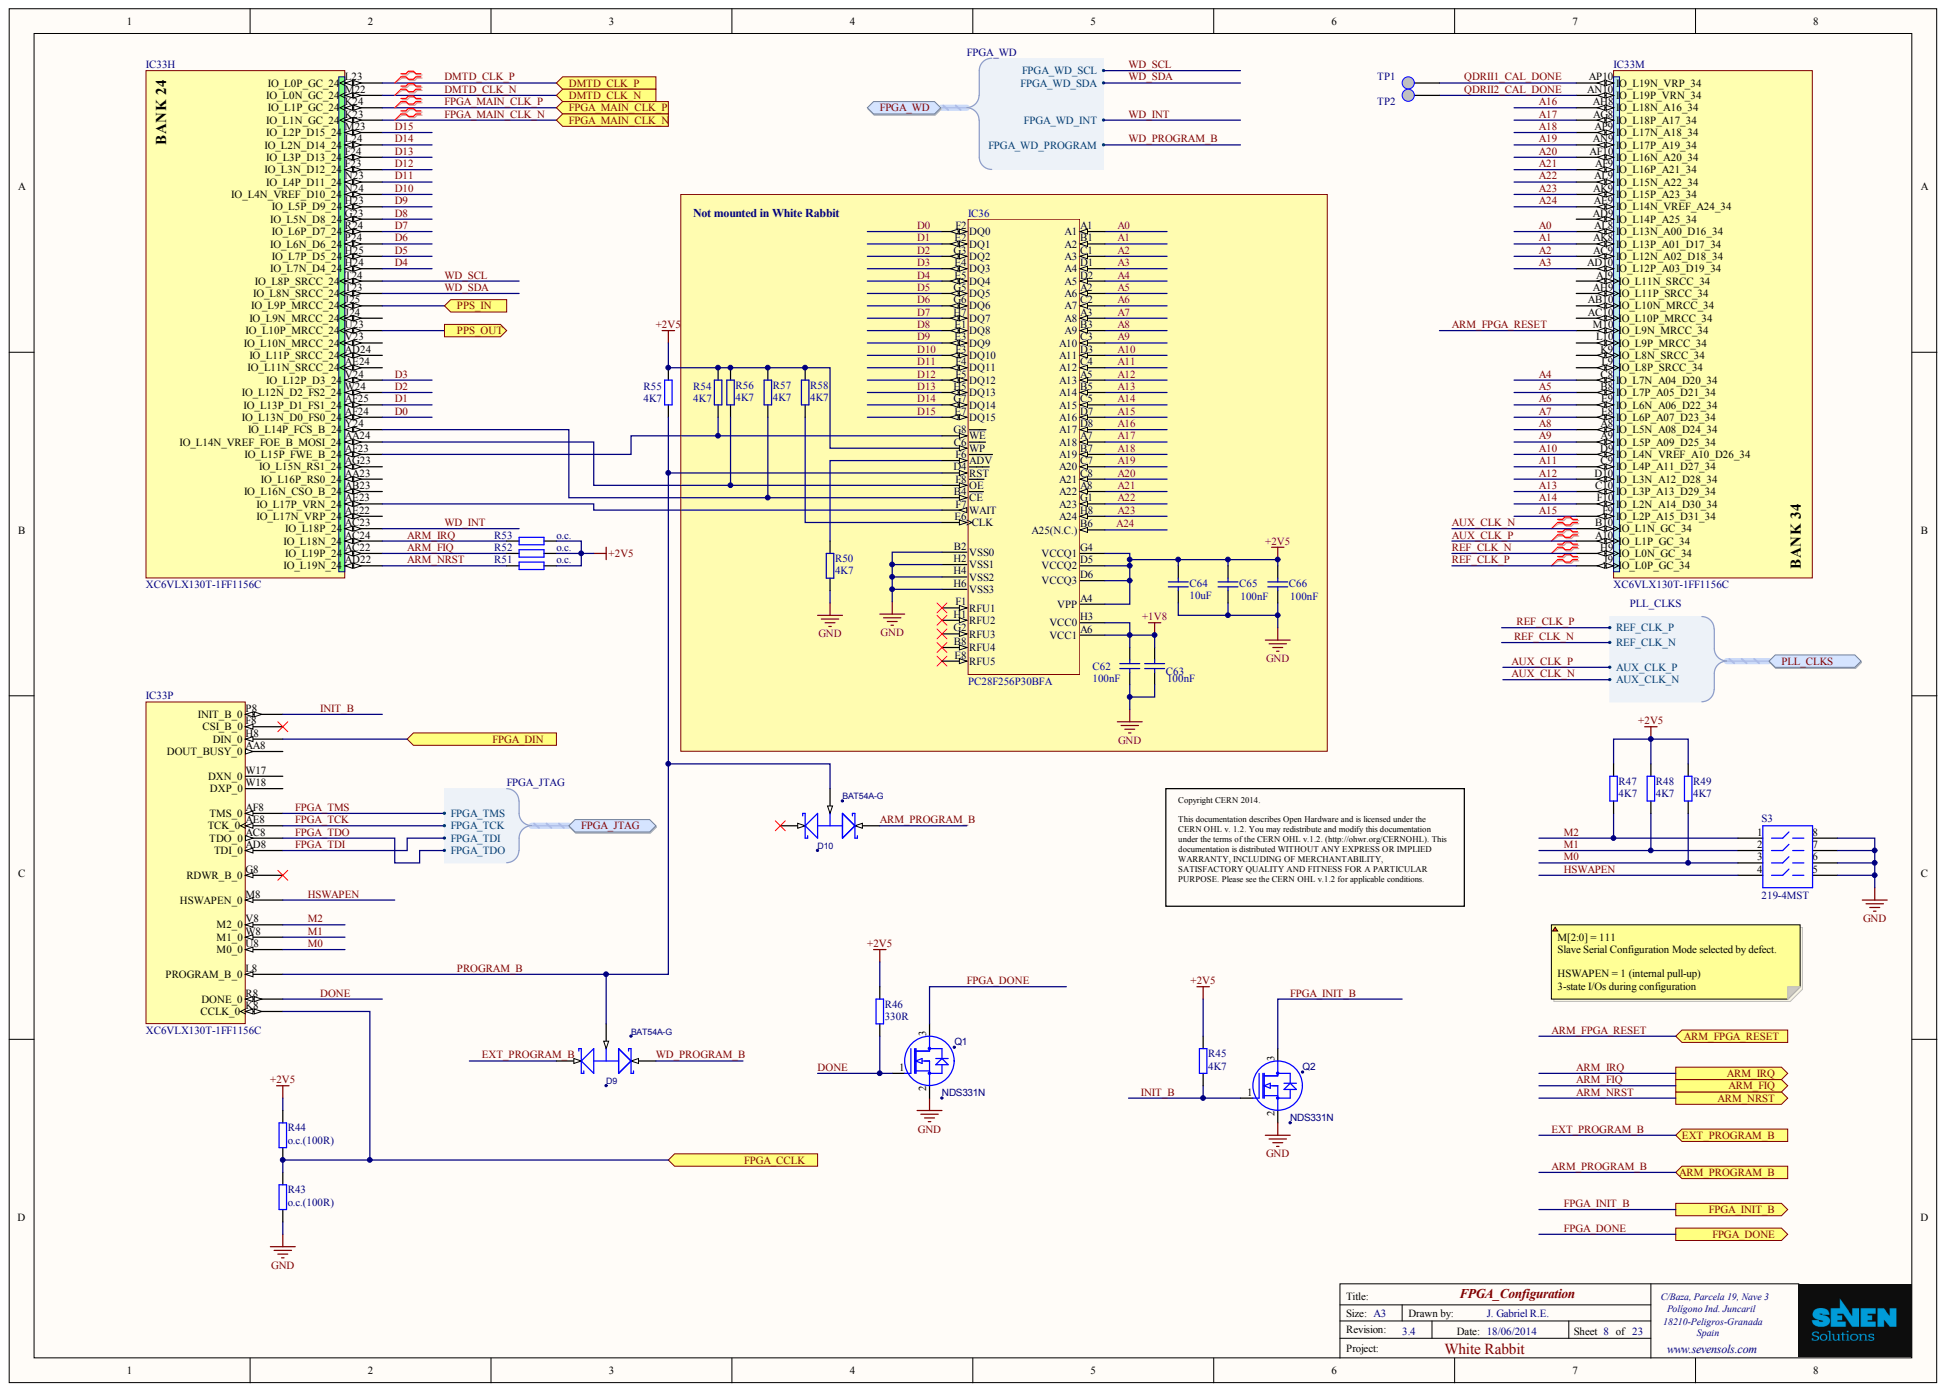
[picture p10: page 8]

Not mounted in White Rabbit

RST D4 | A20

CE B4 | A22
WAIT F7 | A23

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

Slave Serial Configuration Mode selected by defect.

HSWAPEN = 1 (internal pull-up)
3-state I/Os during configuration

FPGA_Configuration | Spain

A3 | J. Gabriel R.E.

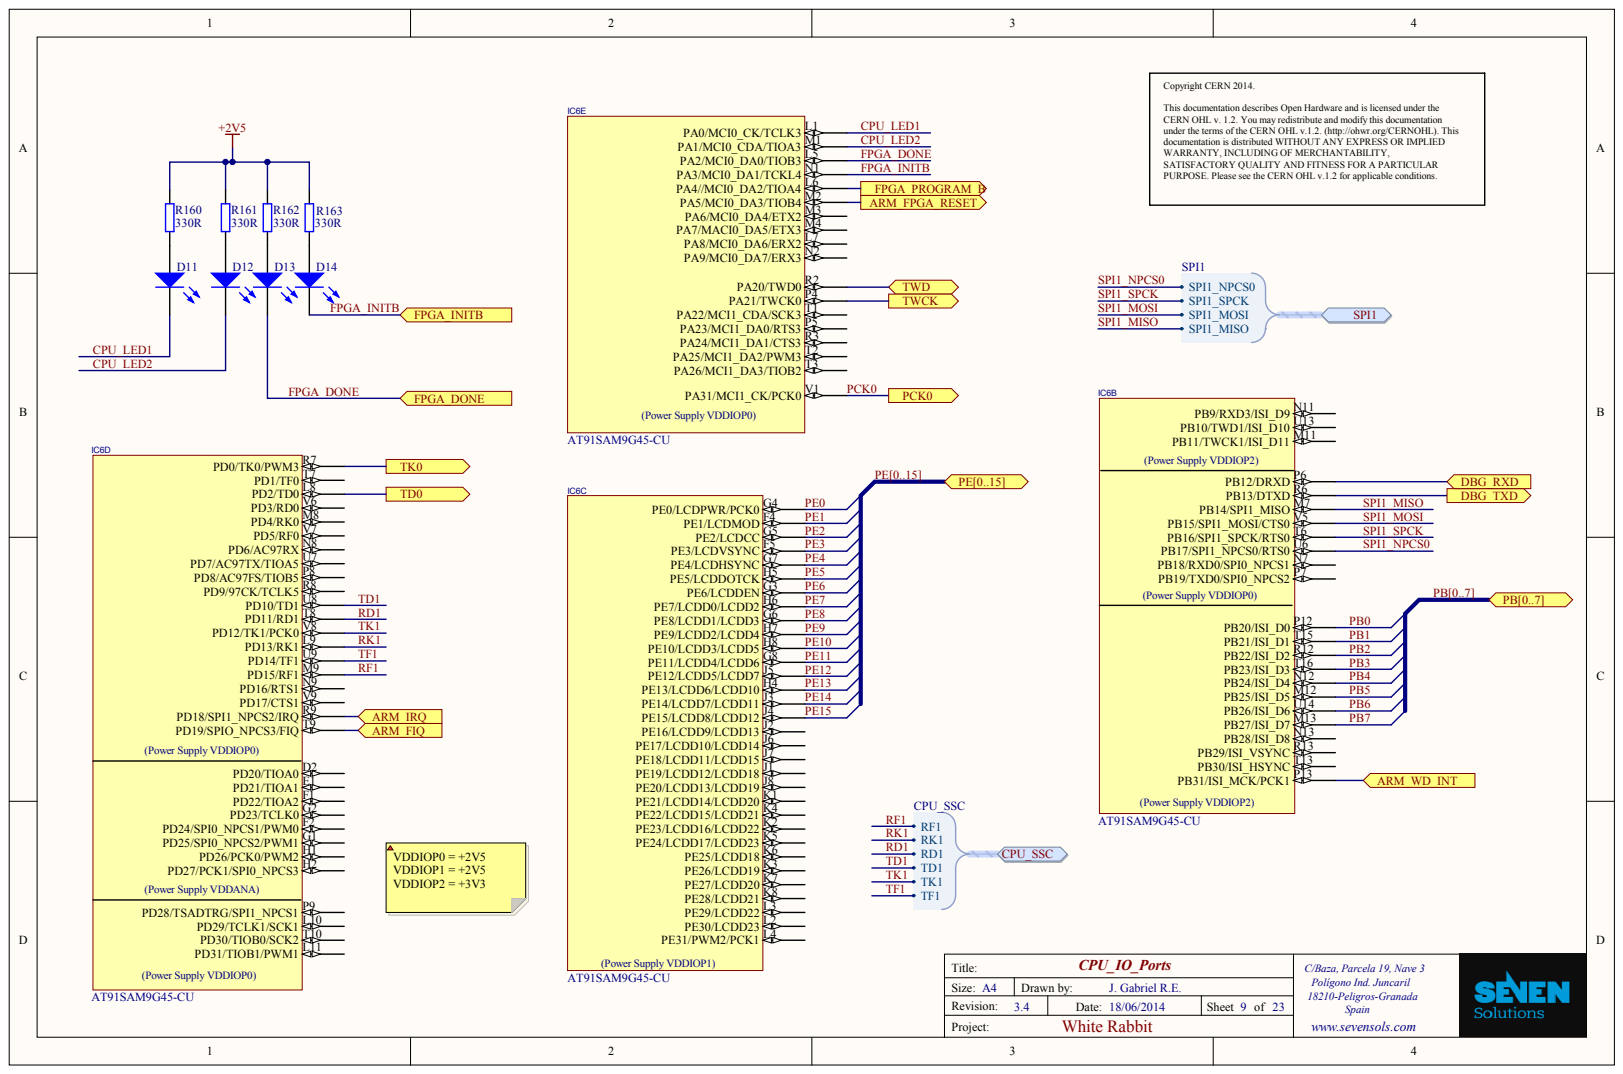
[picture p11: page 9]
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

CPU_IO_Ports Title: | C/Baza, Parcela 19, Nave 3 Polígono Ind. Juncaril 18210-Peligros-Granada Spain

Size: A4 | Drawn by: J. Gabriel R.E.
Revision: 3.4 | Date: 18/06/2014 | Sheet 9 of 23

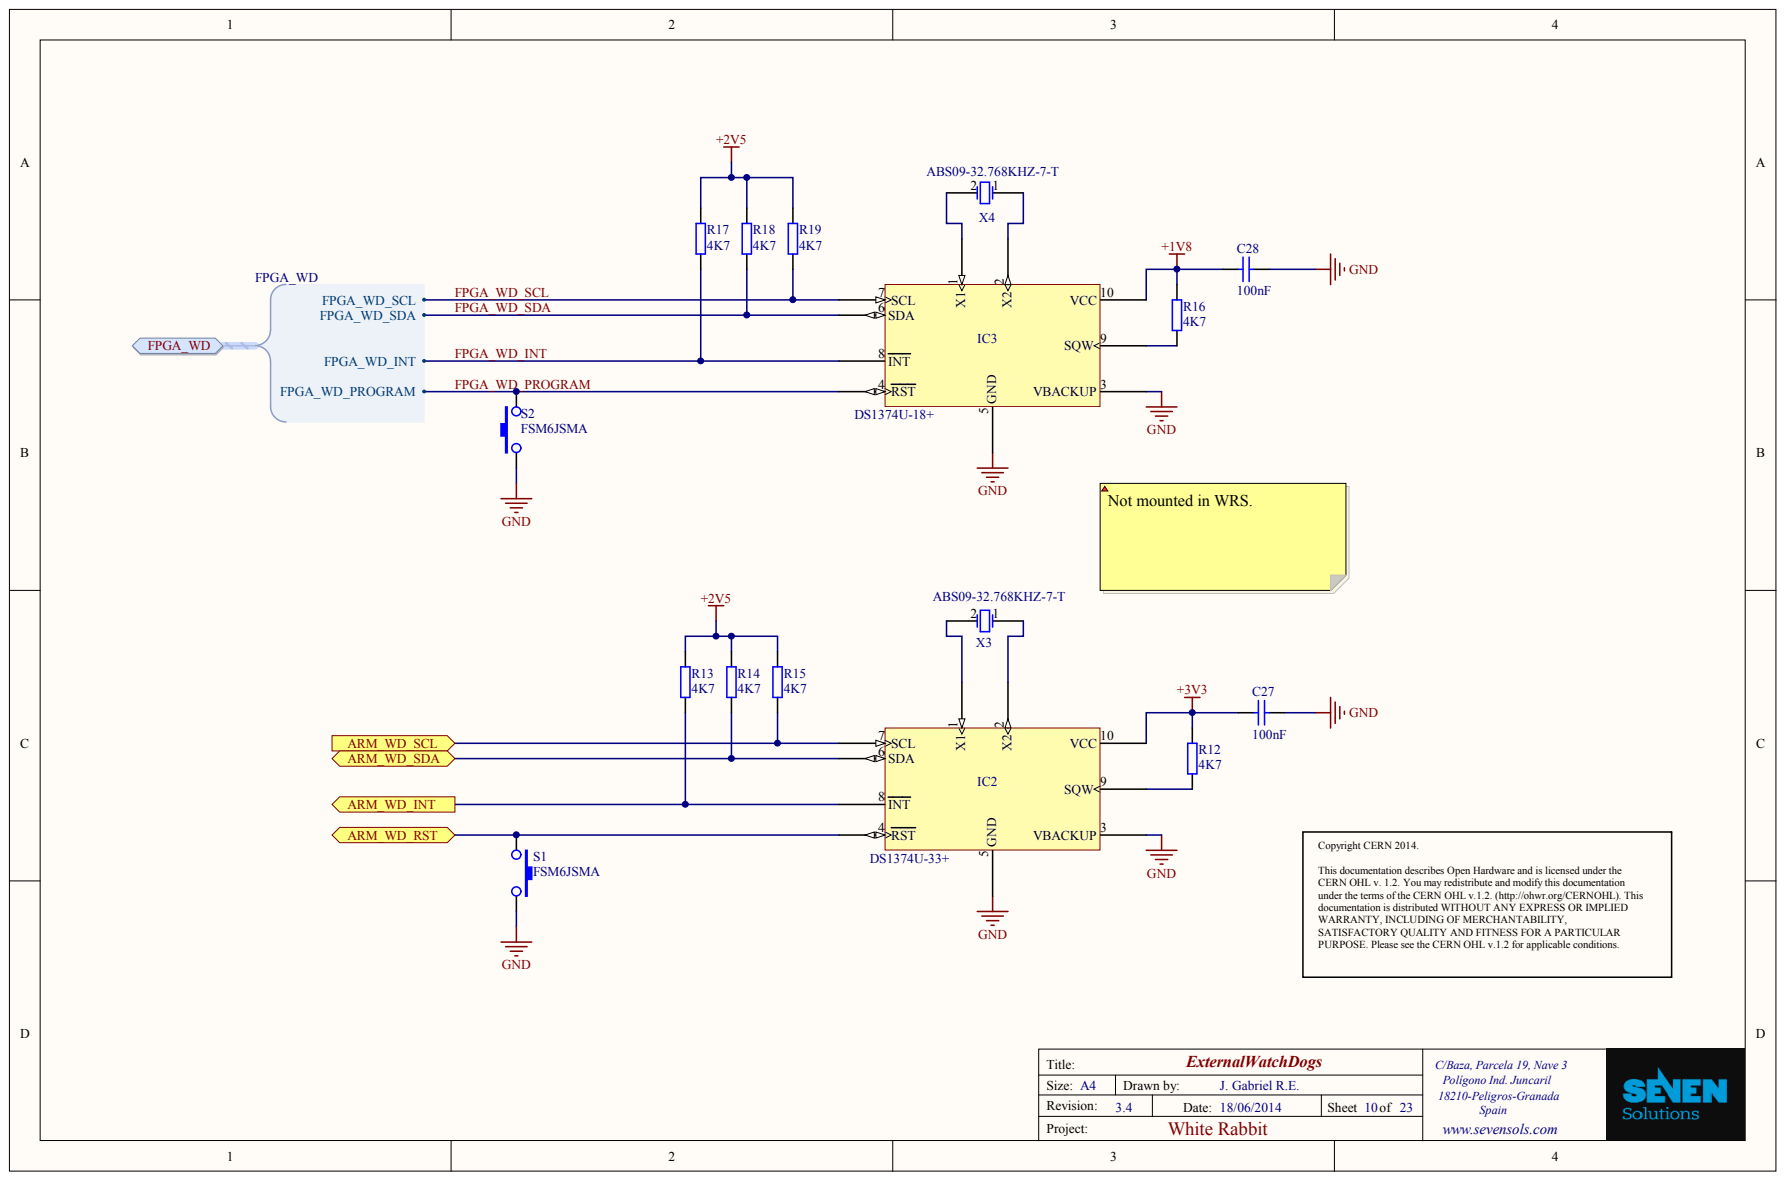
[picture p12: page 10]

Not mounted in WRS.

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

ExternalWatchDogs Title: | C/Baza, Parcela 19, Nave 3 Polígono Ind. Juncaril 18210-Peligros-Granada Spain

Size: A4 | Drawn by: J. Gabriel R.E.
Revision: 3.4 | Date: 18/06/2014 | Sheet 10 of 23

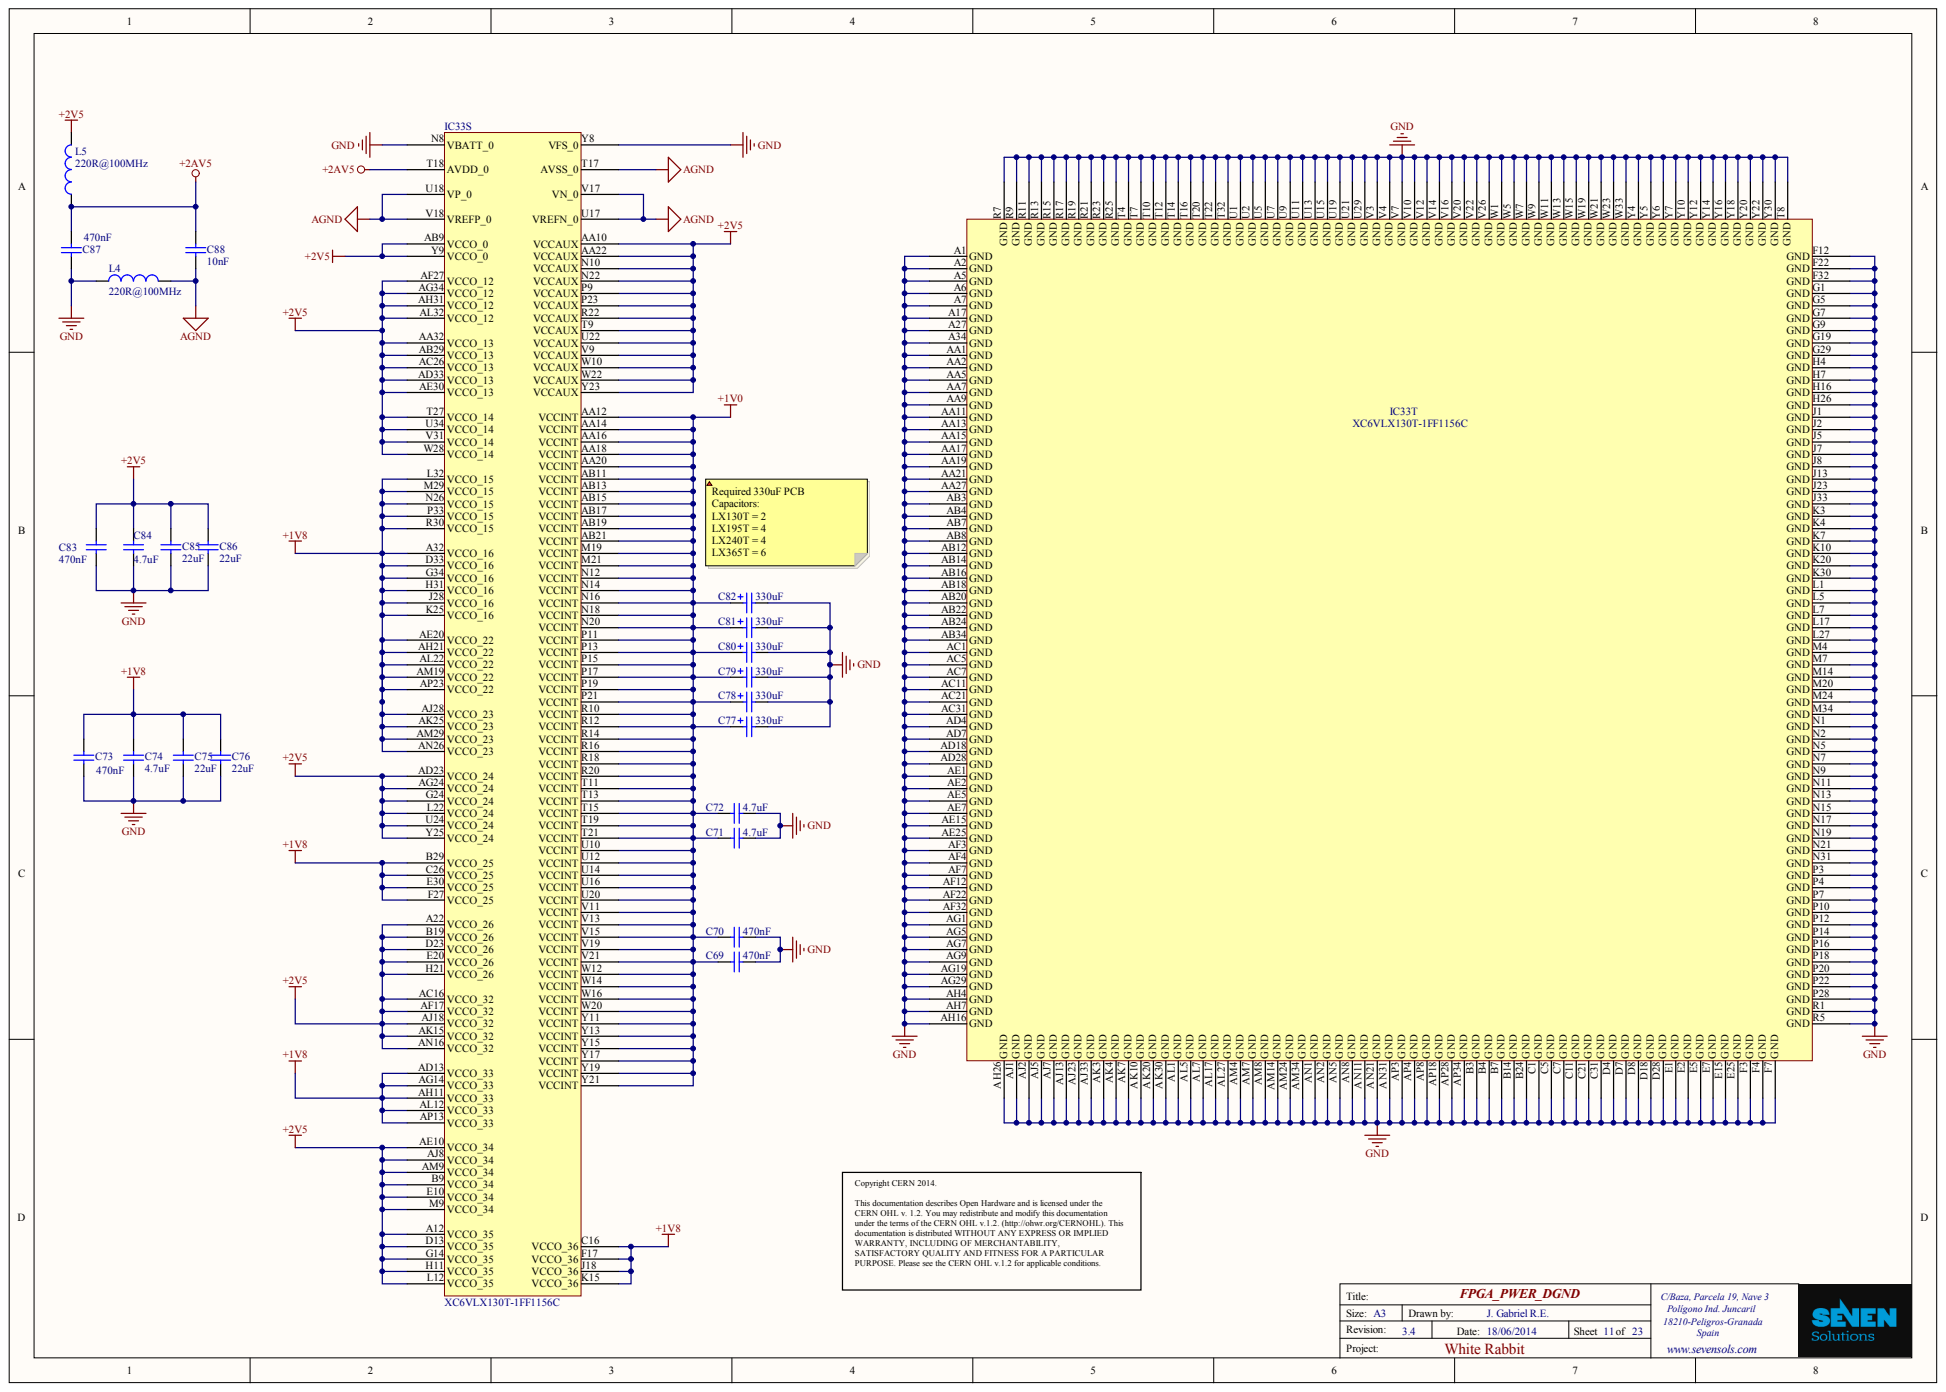
[picture p13: page 11]

GND
GND H4 GND H7 GND H16 GND H26 GND J1 GND J2 GND J5 GND J7 GND J8 GND J13 GND J23 GND J33 GND K3 GND K4 GND K7 GND K10 GND K20 GND K30 GND L1 GND L5 GND L7 GND L17 GND L27 GND M4 GND M7 GND M14 GND M20 GND M24 GND M34 GND N1 GND N2 GND N5 GND N7 GND N9 GND N11 GND N13 GND N15 GND N17 GND N19 GND N21 GND N31 GND P3 GND P4 GND P7 GND P10 GND P12 GND P14 GND P16 GND P18 GND P20 GND P22 GND P28 GND R1 GND R5

AA9
AA 1 1

AB1 8
AB2 0

AF 3
AF 4
AF 7
AF 1 2

AF 3 2
AG 1
AG 5

AL 1 2
AP1 3

AJ8
AM9

Titl e : FP GA_ P WER_ D GND | C/Baza, Parcela 19, Nave 3 Polígono Ind. Juncaril 18210-P e l igros-Granada Spai n www. s e v e n s ols.c o m

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

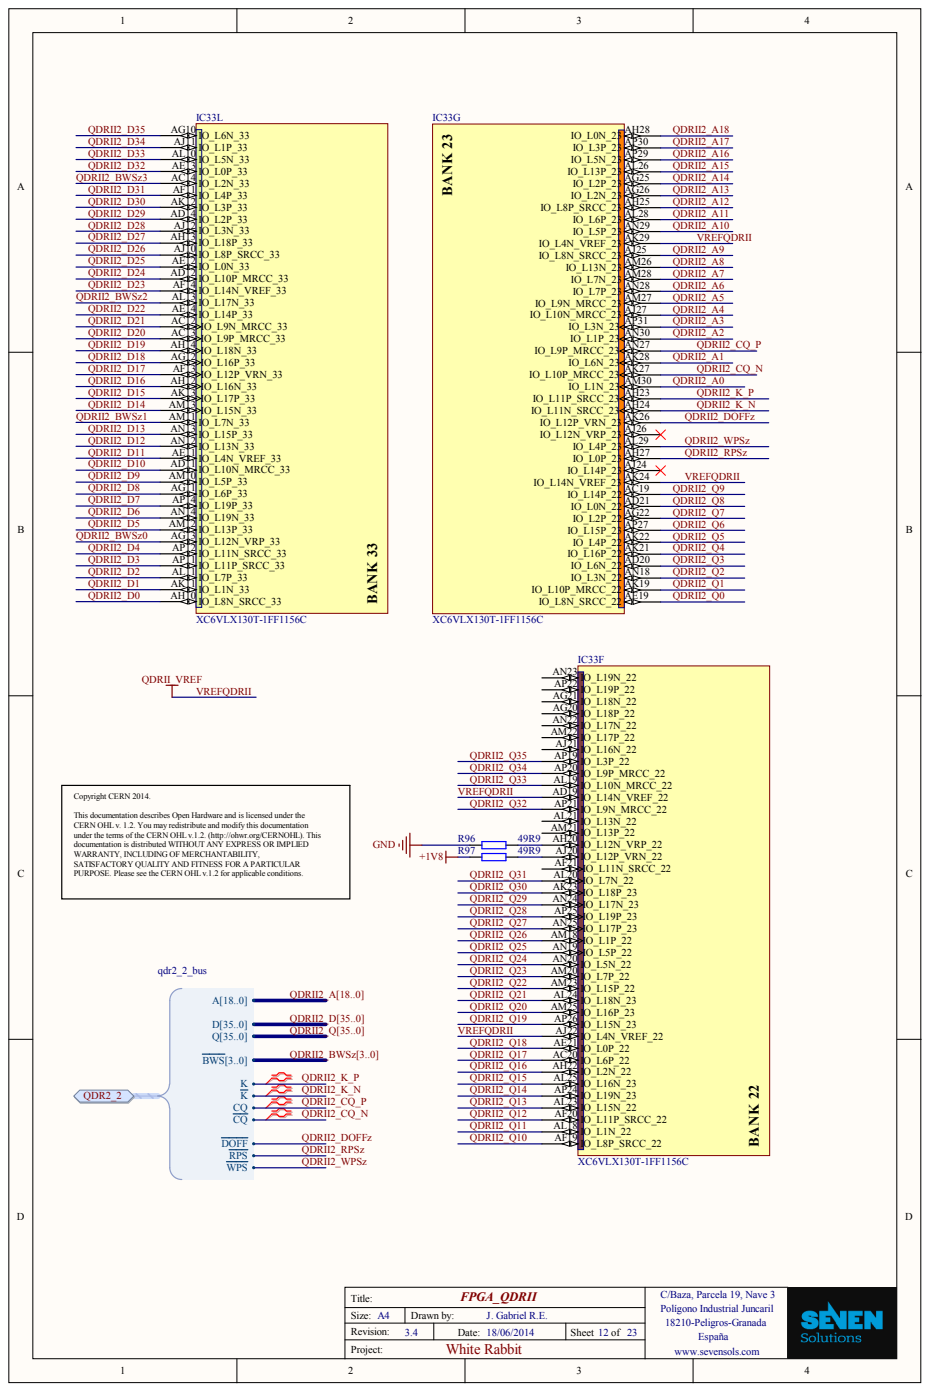
[picture p14: page 12]
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

FPGA_QDRII | Polígono Industrial Juncaril España

A4 | J. Gabriel R.E.

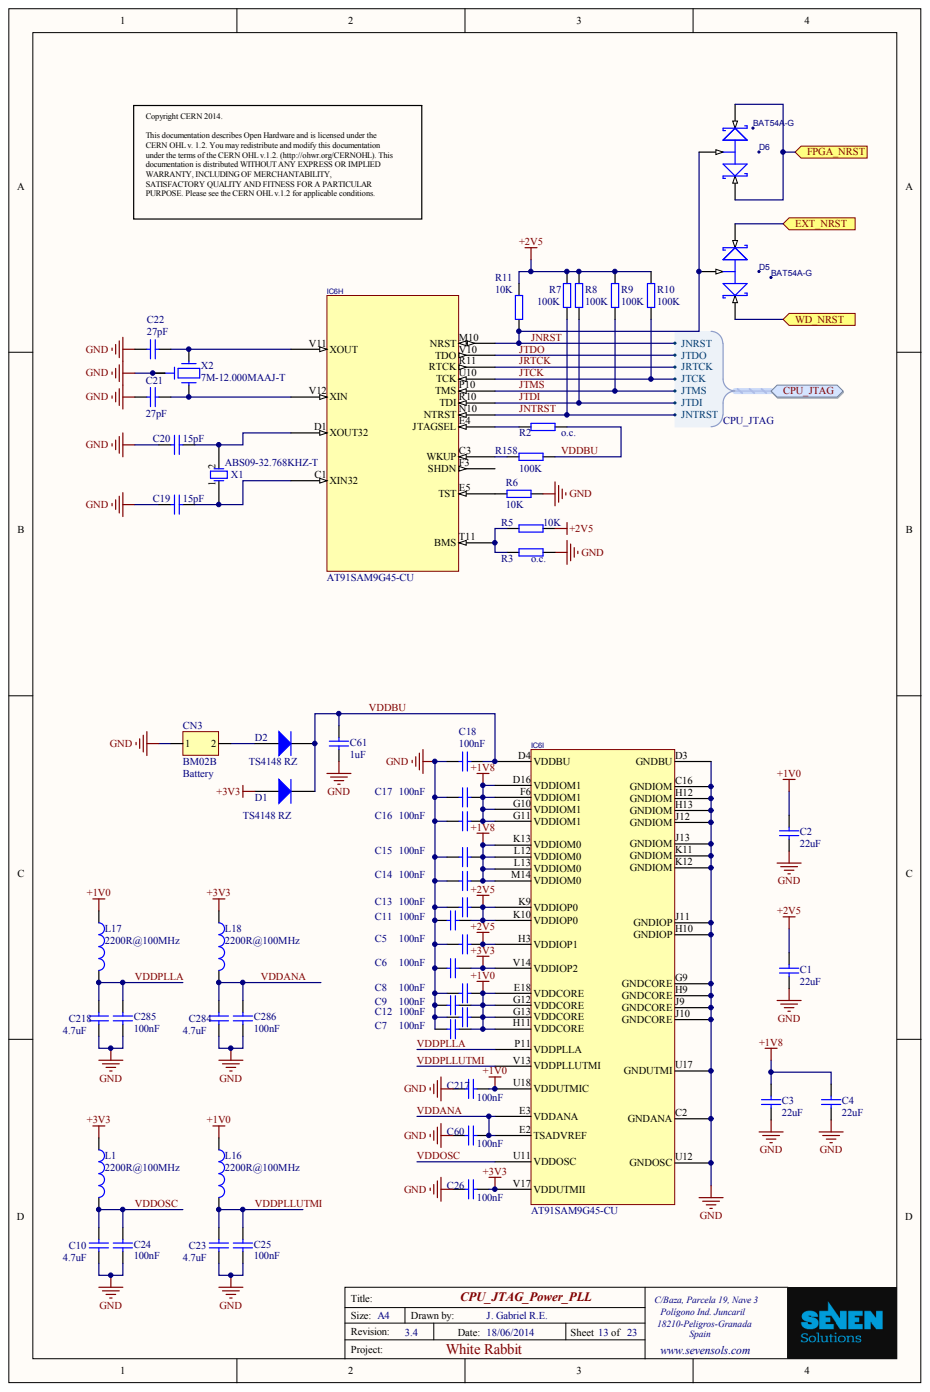
[picture p15: page 13]
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

NRST M10
NTRST N10 TDI R10 TMS P10 TCK U10 RTCK R11 TDO V10

JTCK
JTMS
JTDI

XOUT32 D1 | JNTRST

GNDIOM J12 GNDIOM H13 GNDIOM H12 GNDIOM C16

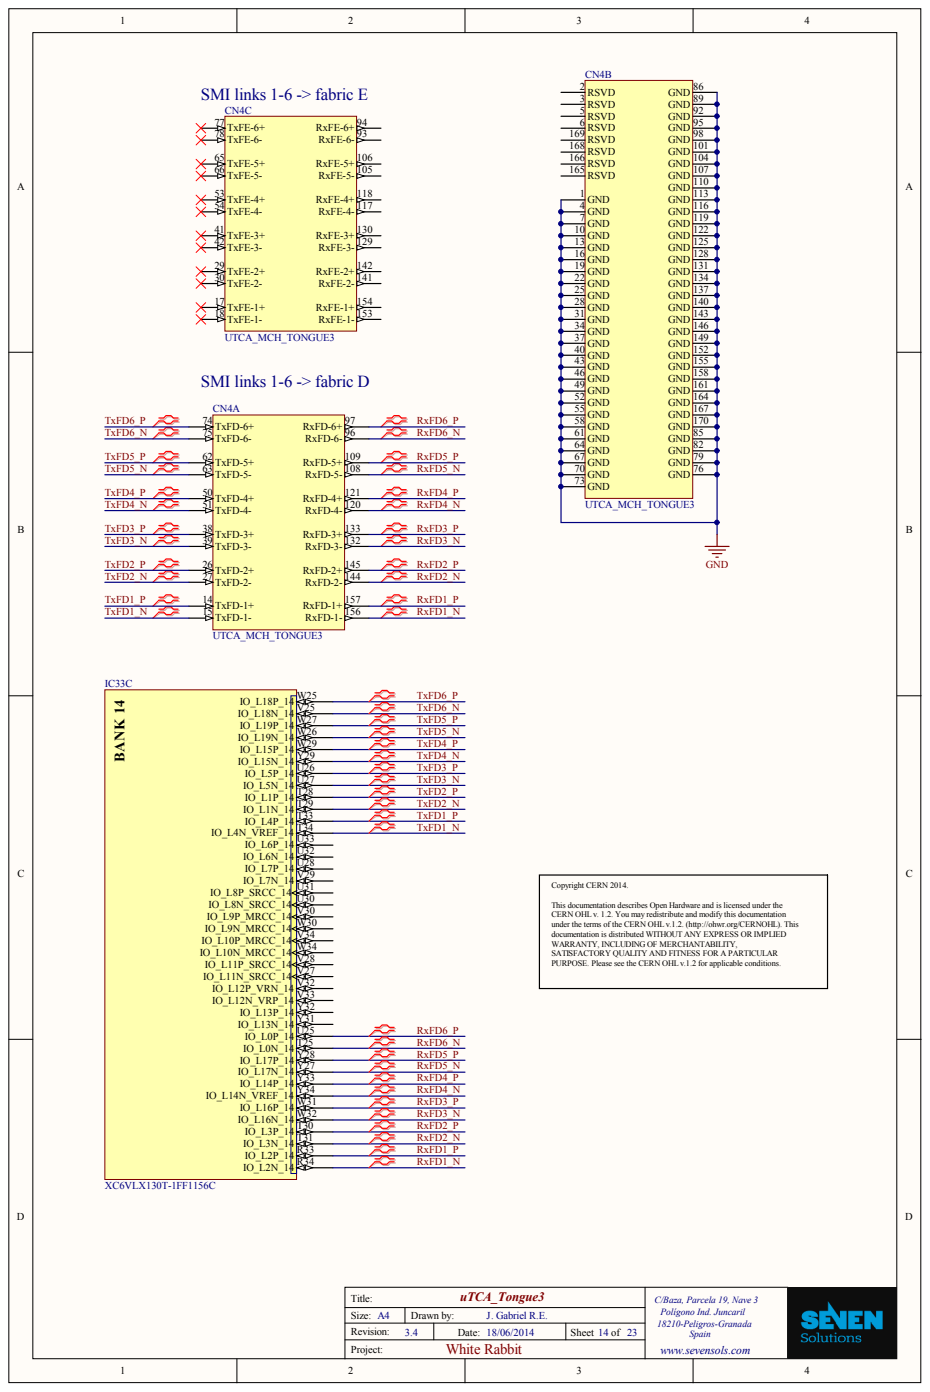
[picture p16: page 14]
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

uTCA_Tongue3 | Spain

A4 | J. Gabriel R.E.

18210-Peligros-Granada 23

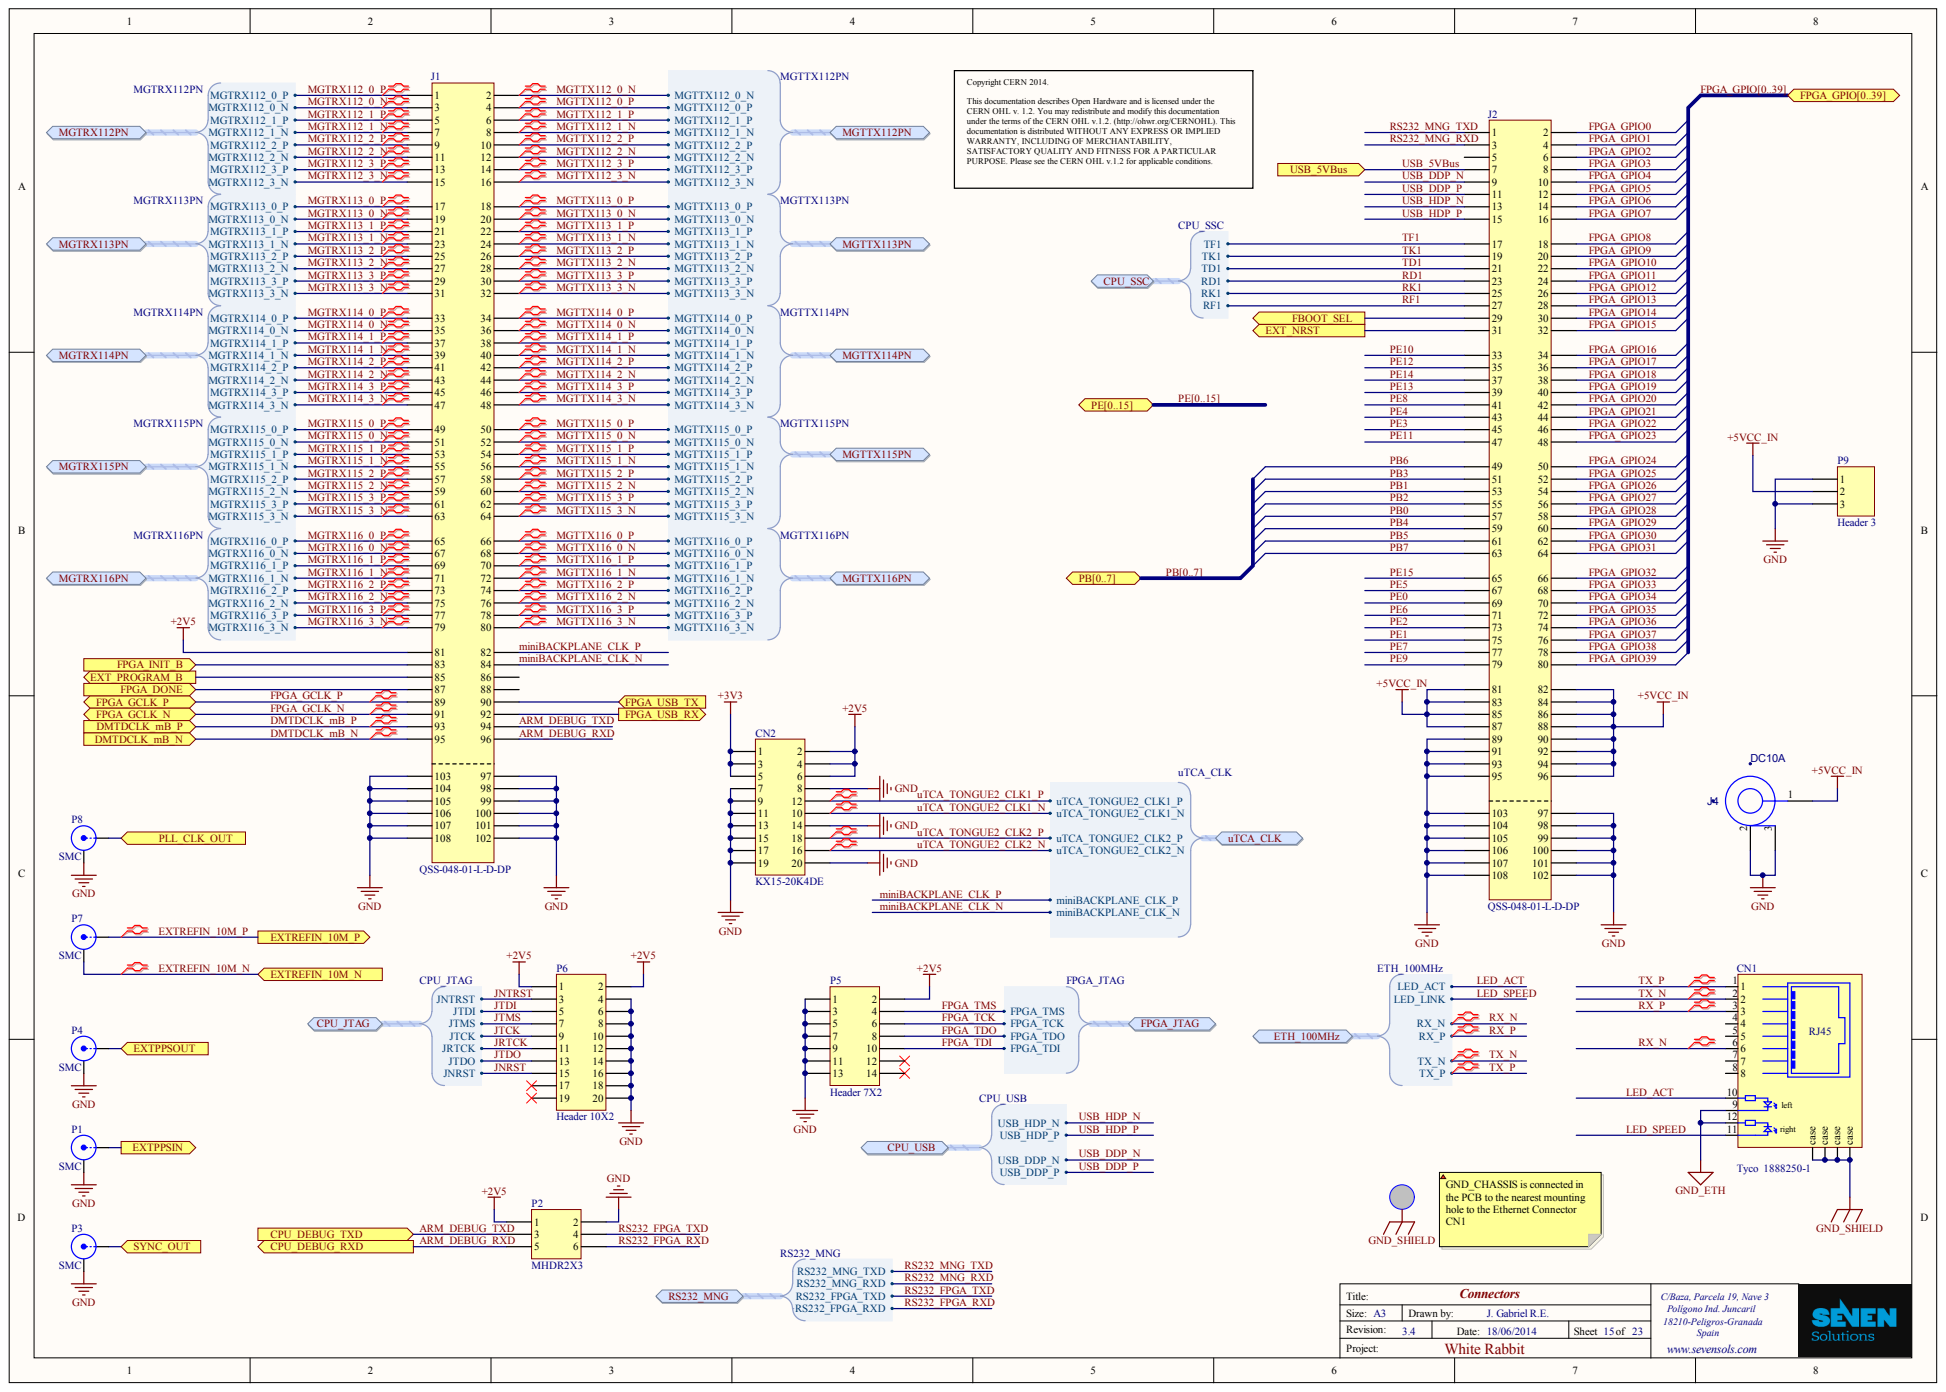
[picture p17: page 15]
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

12
11

GND_CHASSIS is connected in
the PCB to the nearest mounting
hole to the Ethernet Connector

Connectors | Spain

A3 | J. Gabriel R.E.

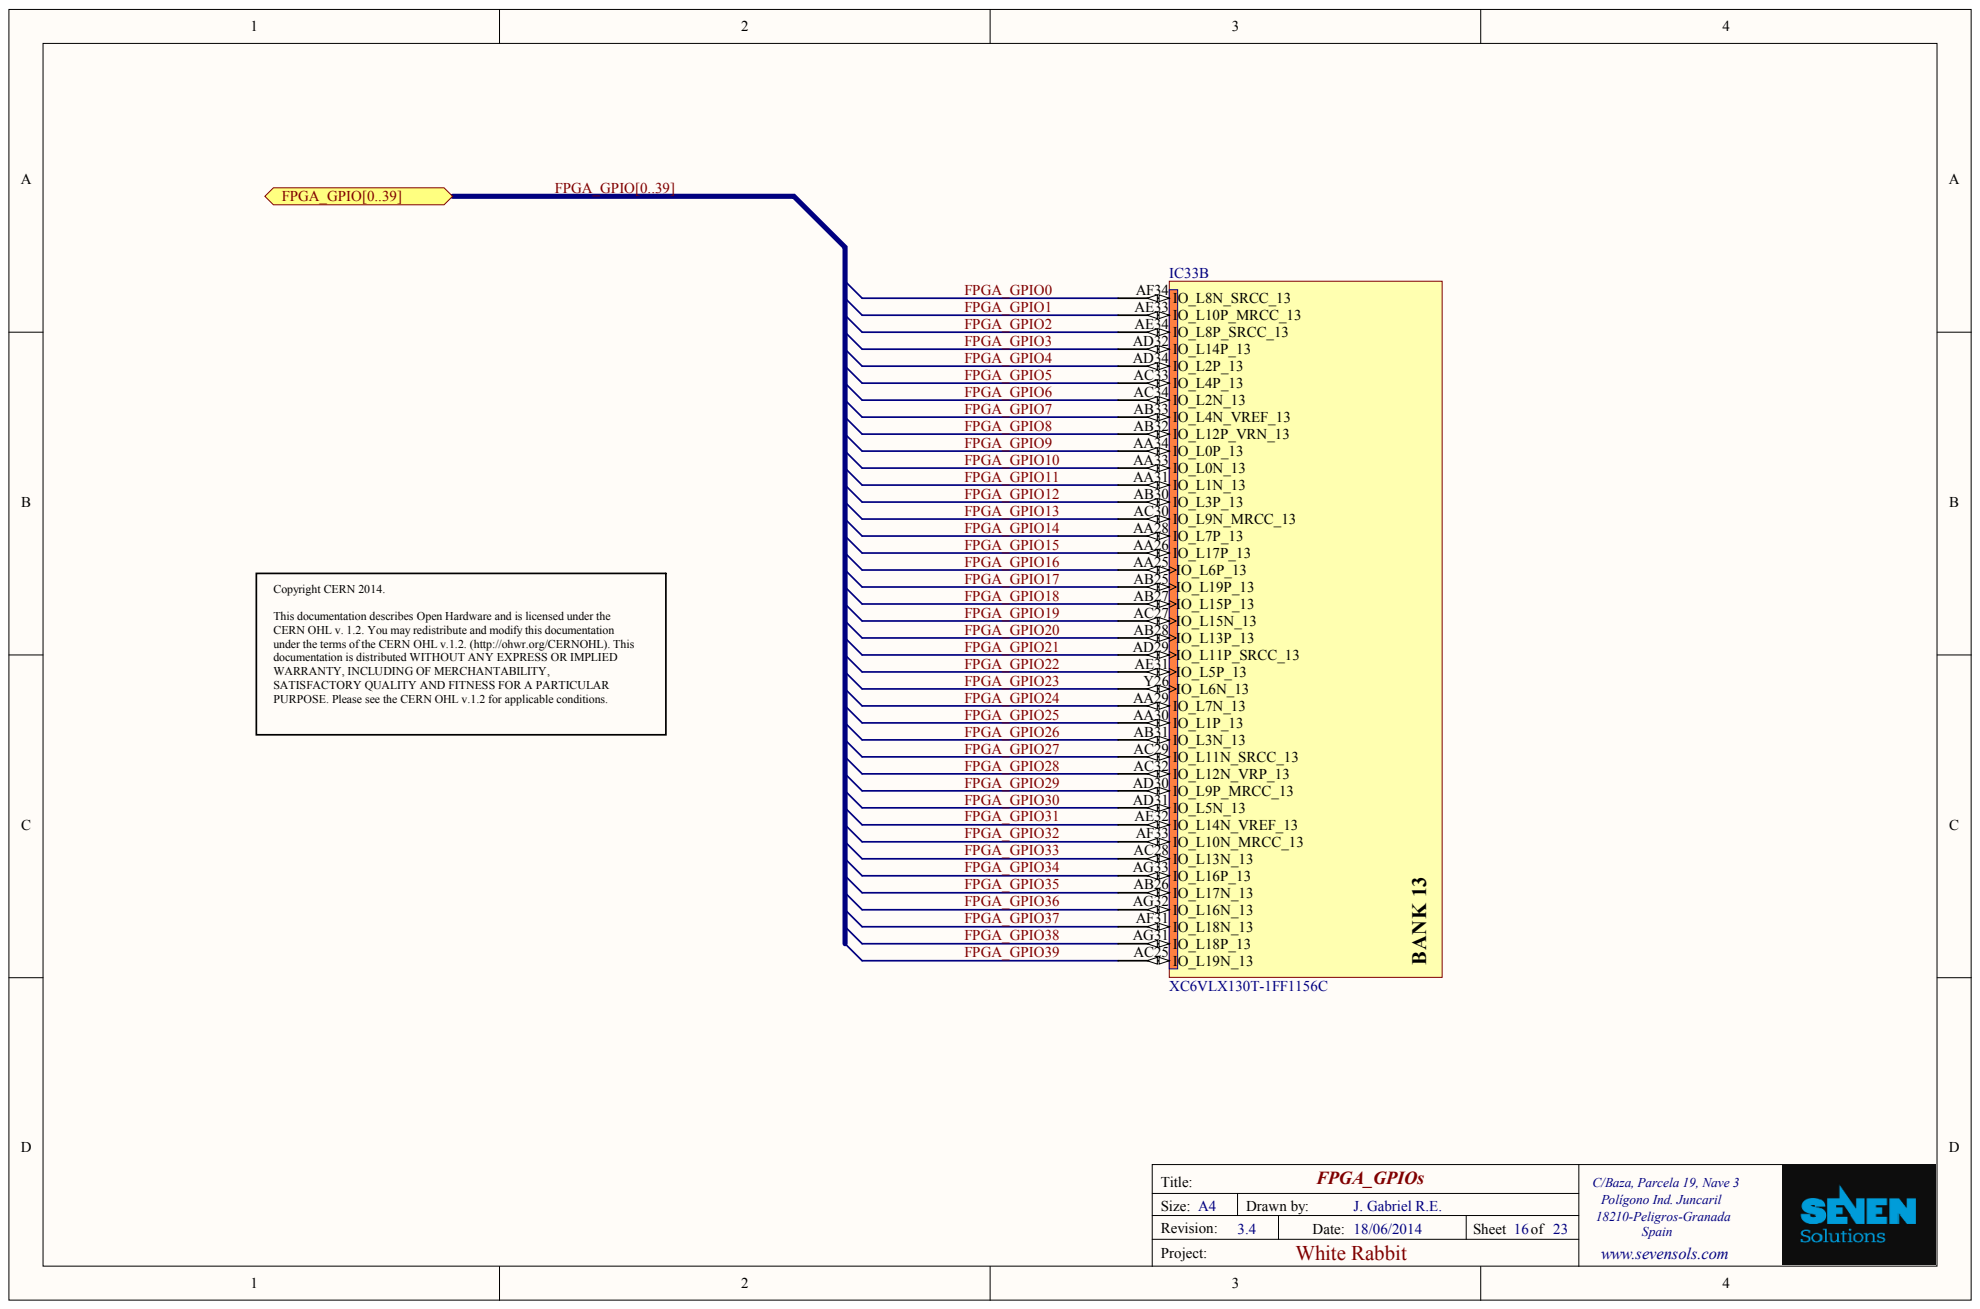
[picture p18: page 16]

This docu
CERN OHL v. 1.2. Y
under the terms o
documentation is di
WARRANTY, I
SATI
PURPOSE. Please see the CERN OHL v.1.2 for ap

T ANY EXPRESS OR IMPLIED

www.sevensols.com C/Baza, Parcela 19, Nave 3 Polígono Ind. Juncaril

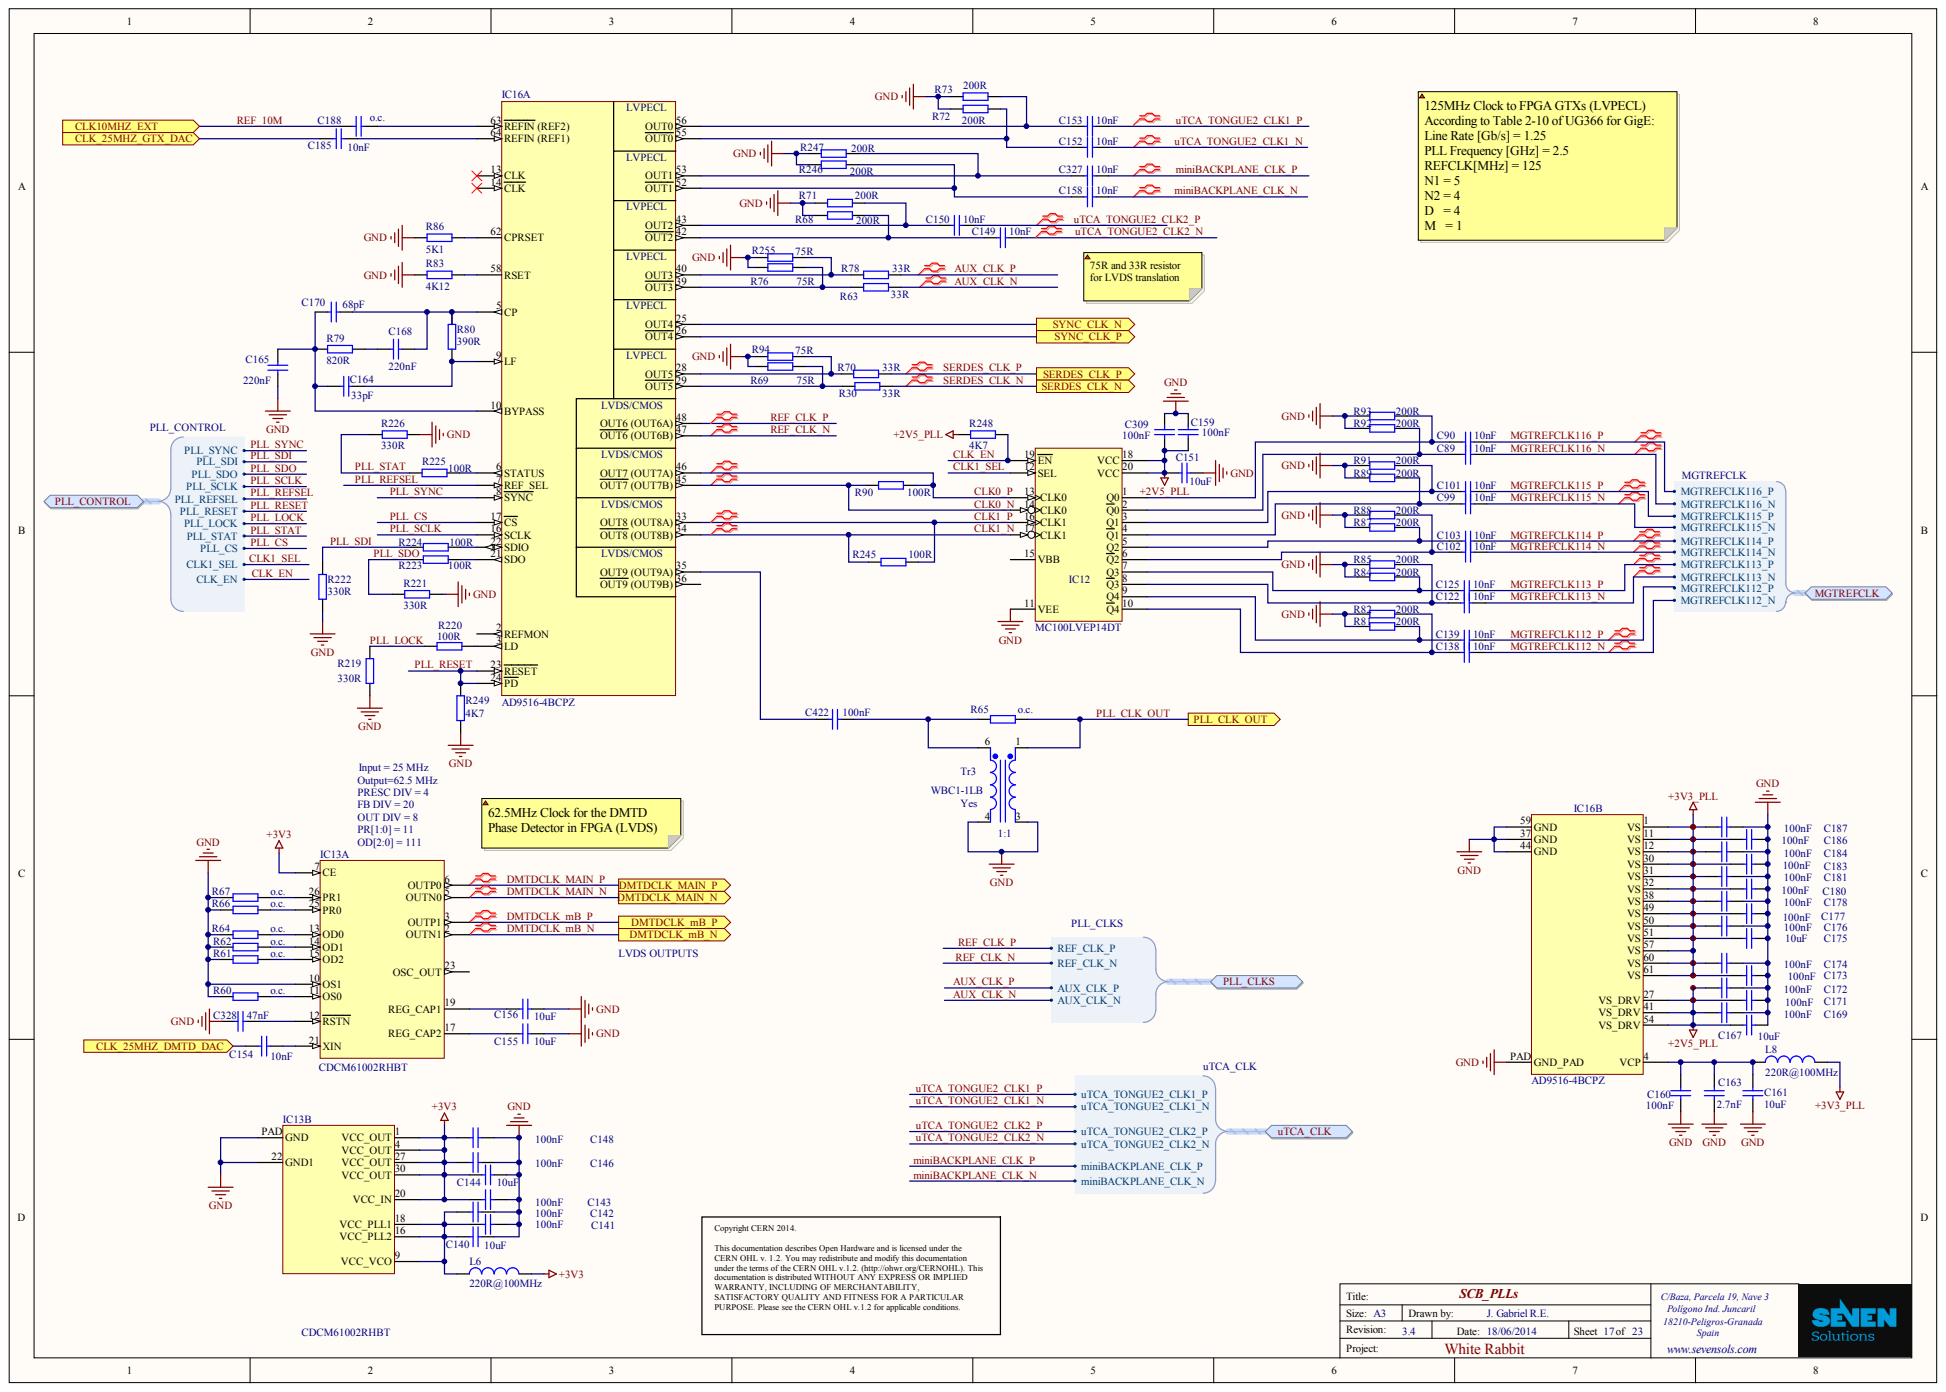
[picture p19: page 17]

125MHz Clock to FPGA GTXs (LVPECL)
According to Table 2-10 of UG366 for GigE:
Line Rate [Gb/s] = 1.25
PLL Frequency [GHz] = 2.5
REFCLK[MHz] = 125

220nF | BYPASS 10

62.5MHz Clock for the DMTD
Phase Detector in FPGA (LVDS)

R62 | o.c. | OD1 14
R61 | o.c. | OD2 15

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

SCB_PLLs | Spain

A3 | J. Gabriel R.E.

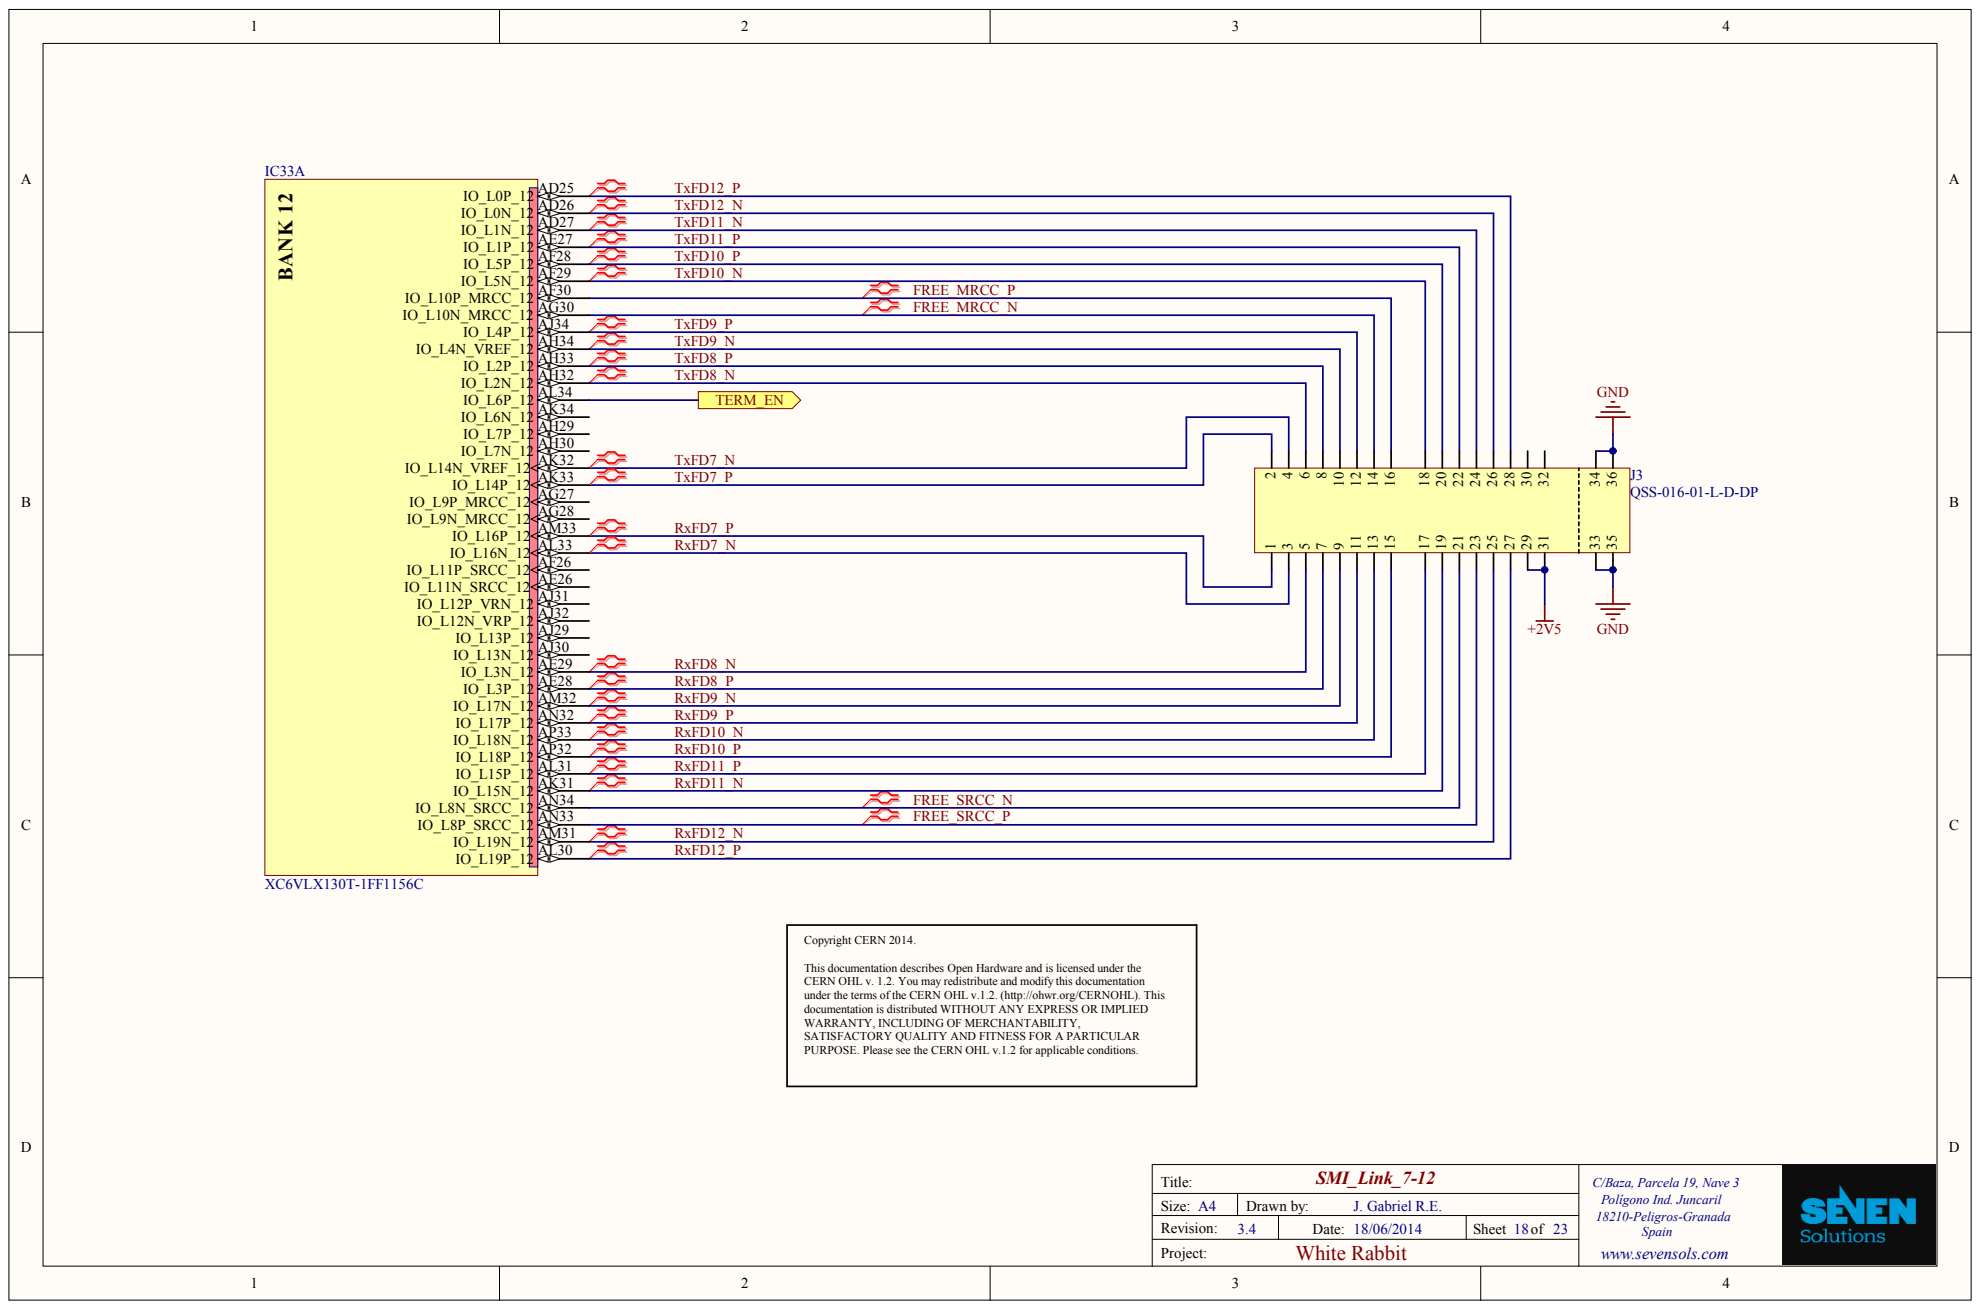
[picture p20: page 18]

AD2 6 | Tx FD12_N
AD2 7 | Tx FD11_N
AE27 | Tx FD11_P
A F28 | Tx FD10_P
A F29 | Tx FD10_N
A F30
AG3 0
AJ34 | Tx FD9_ P
AH3 4 | Tx FD9_N
AH3 3 | Tx FD8_ P
AH3 2 | Tx FD8_N
AL34 AK3 4 | TERM_EN

AH2 9
AH3 0
AK3 2 | Tx FD7_N
AK3 3 | Tx FD7_ P

AL33 | Rx FD7_N
A F26
AE26

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

T ANY EXPRESS OR IMPLIED

www.sevensols.com C/Baza, Parcela 19, Nave 3 Polígono Ind. Juncaril

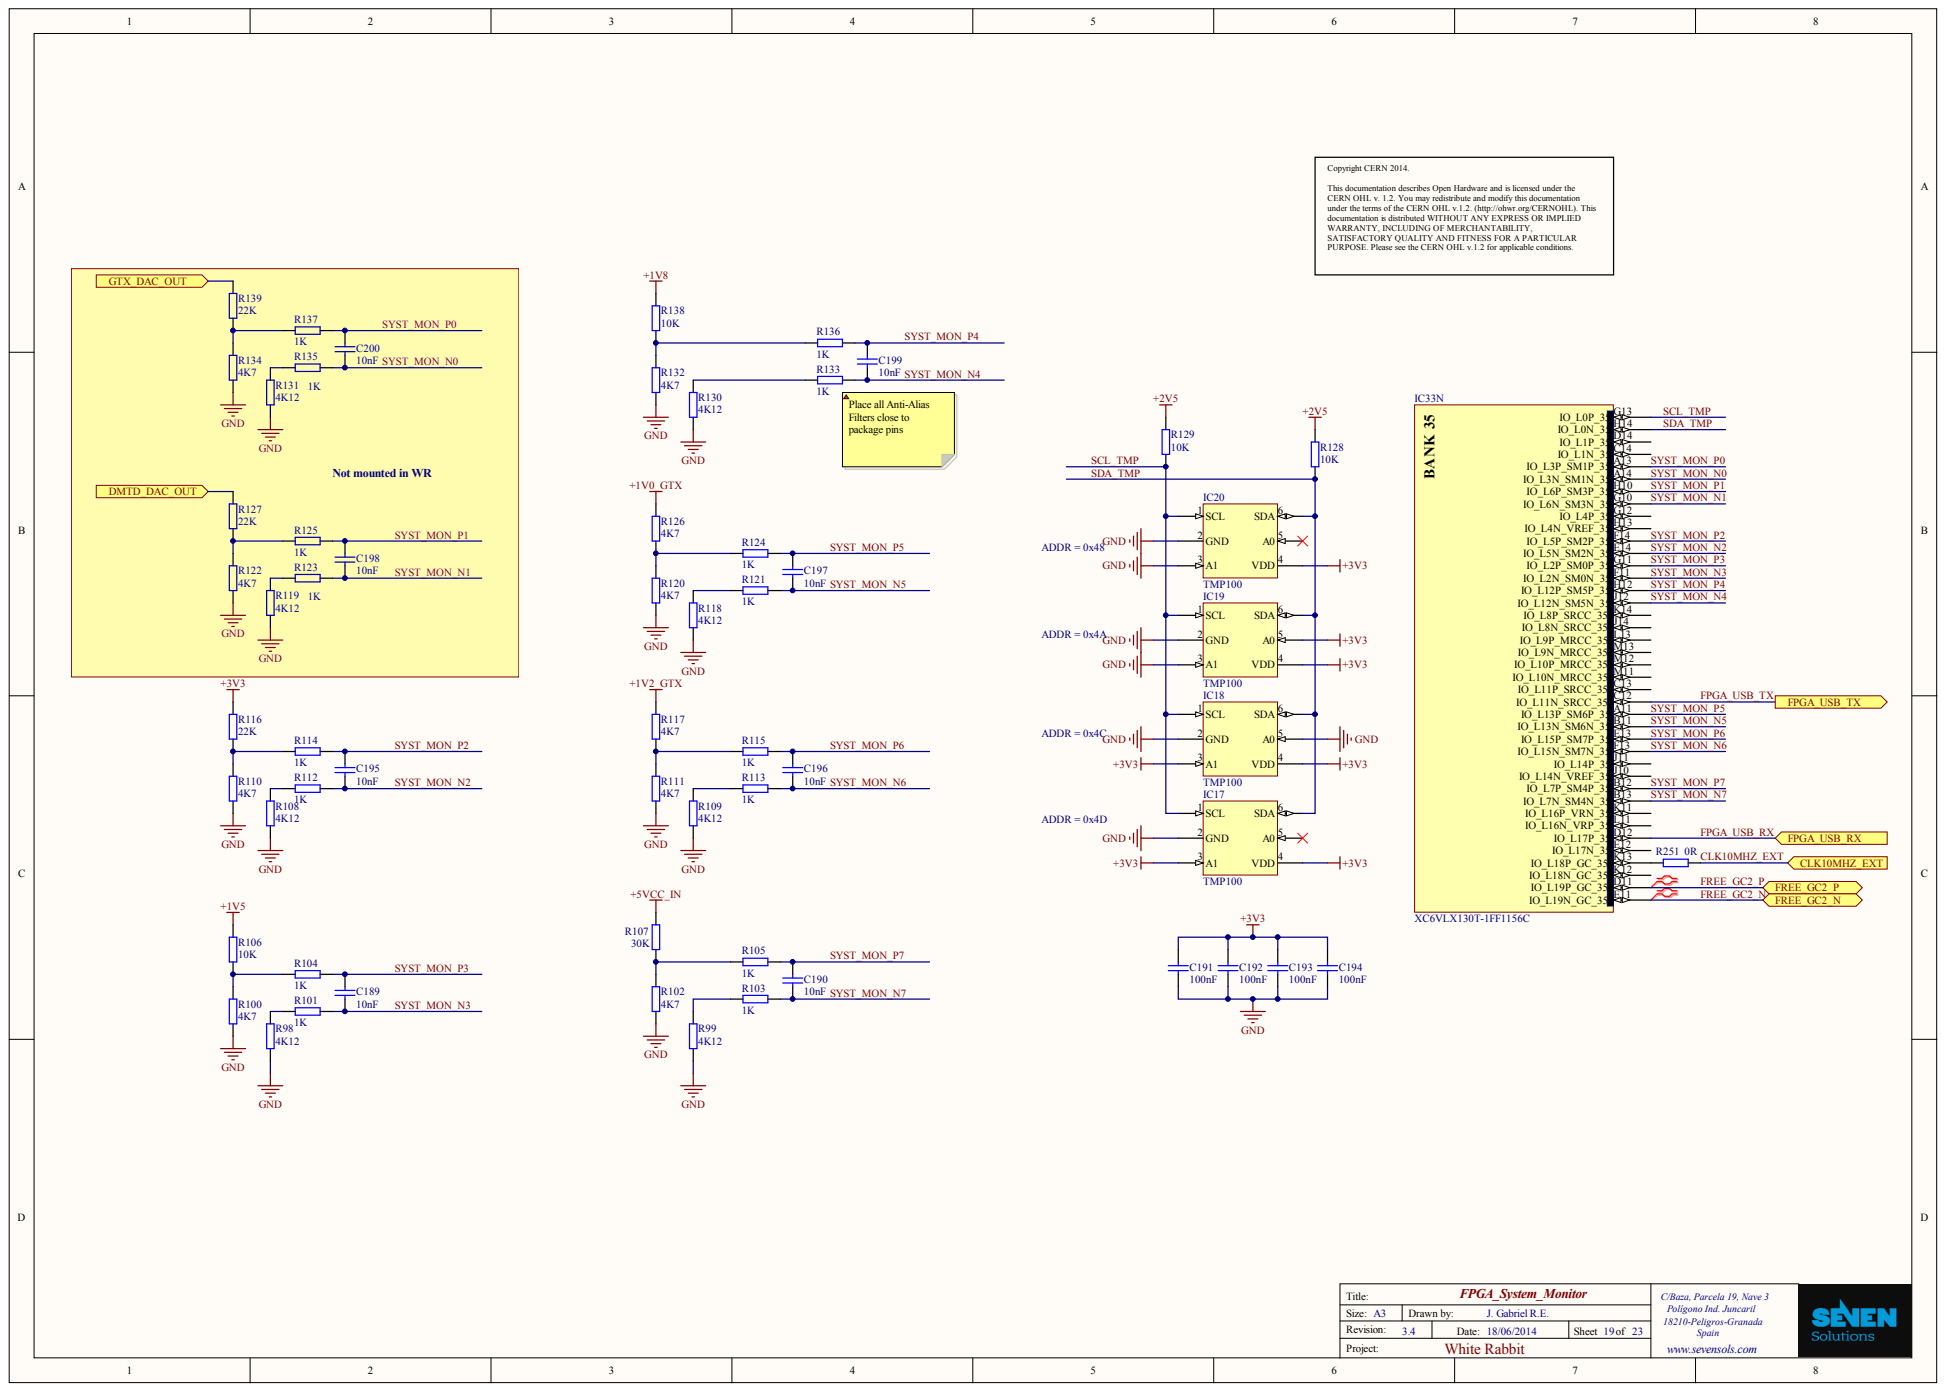
[picture p21: page 19]

2 | SCL SDA GND A0 A 1 VDD | 5

DGND GND GND GND GND GND

Titl e : FP GA_ Sys tem_ Mo n ito r | C/Baza, Parcela 19, Nave 3 Polígono Ind. Juncaril 18210-P e l igros-Granada Spai n www. s e v e n s ols.c o m

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

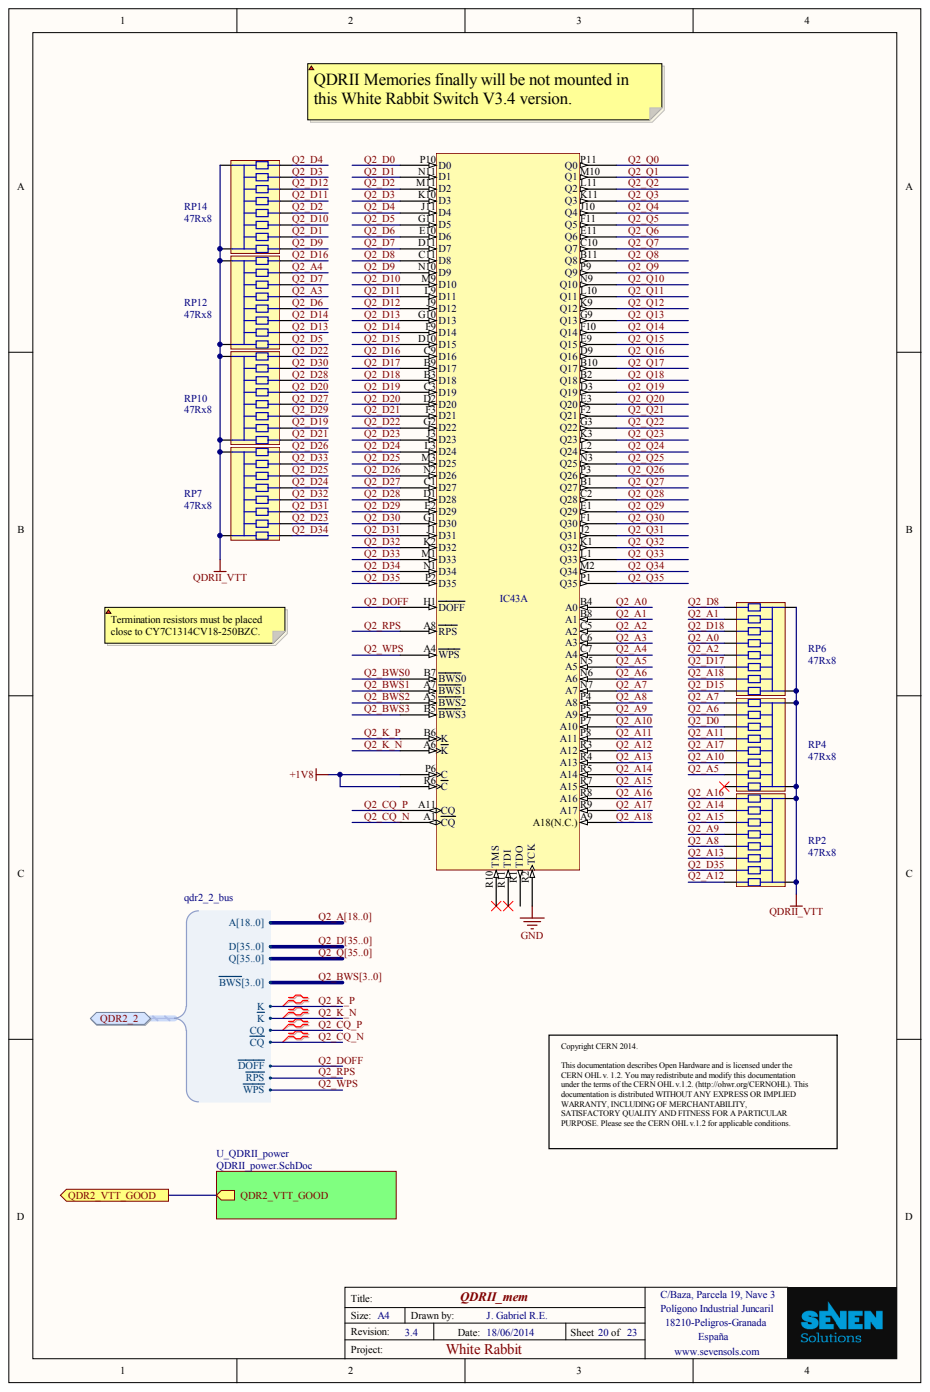
[picture p22: page 20]

QDRII Memories finally will be not mounted in
this White Rabbit Switch V3.4 version.

Termination resistors must be placed
close to CY7C1314CV18-250BZC.

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

QDRII_mem | Polígono Industrial Juncaril España

A4 | J. Gabriel R.E.

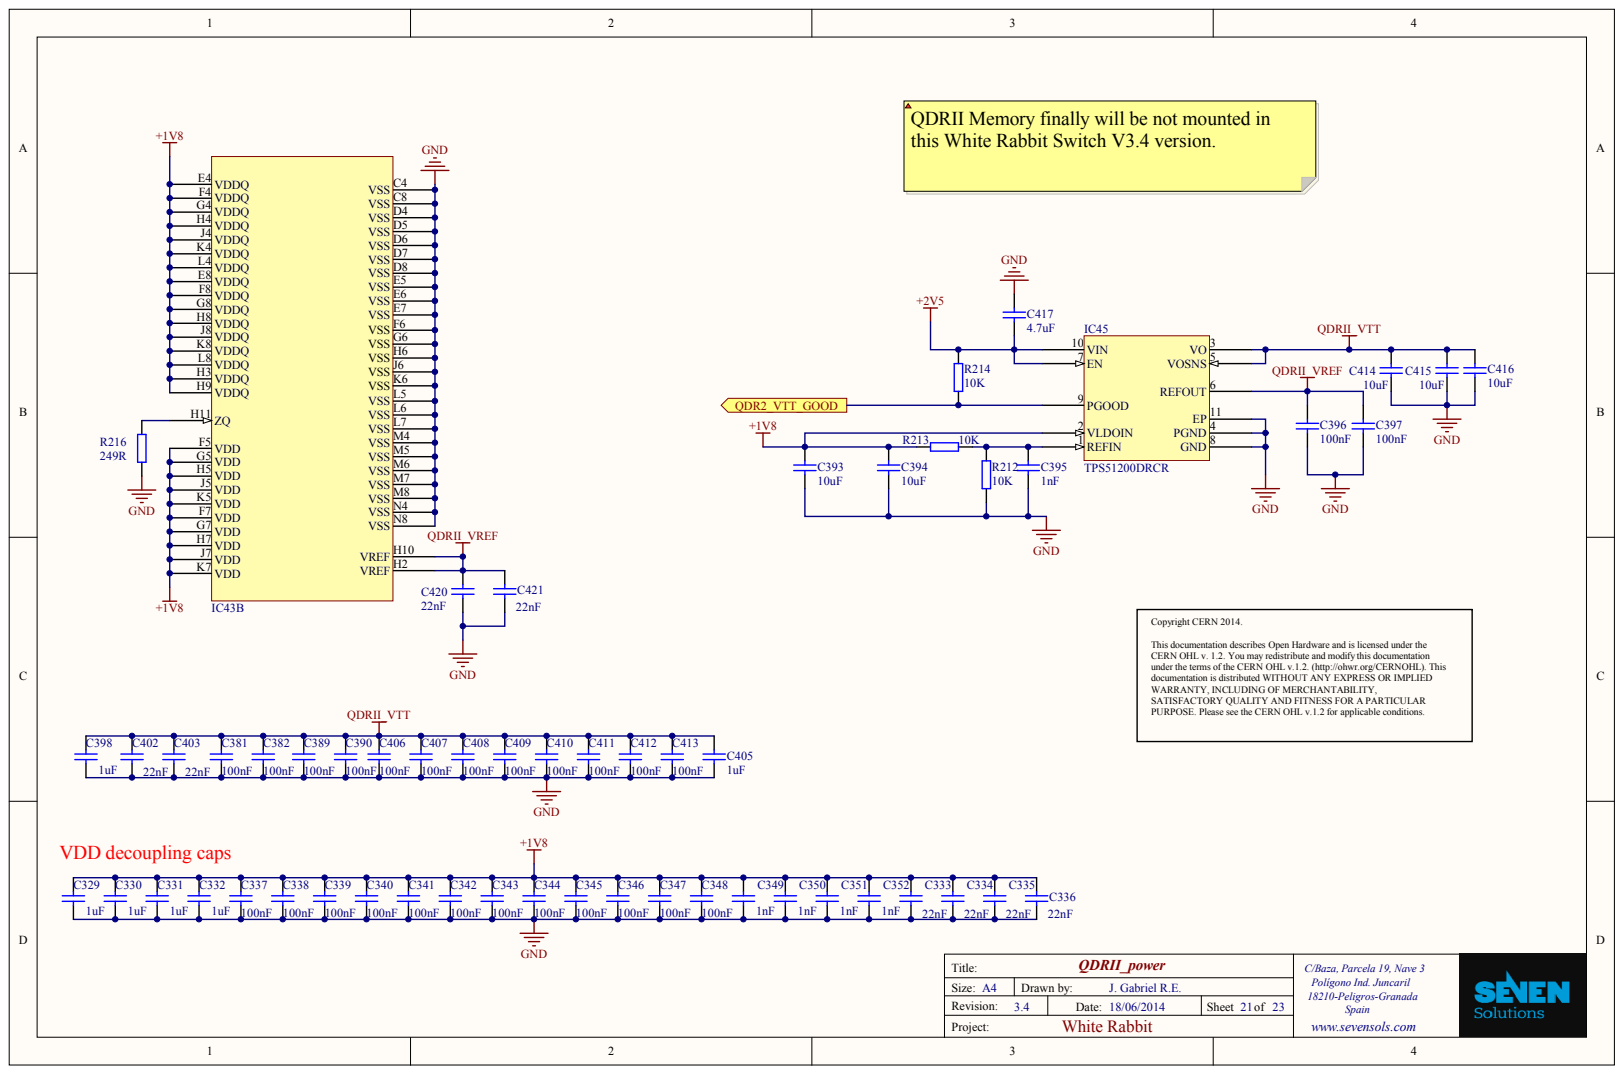
[picture p23: page 21]

QDRII Memory finally will be not mounted in
this White Rabbit Switch V3.4 version.

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

QDRII_power Title: | C/Baza, Parcela 19, Nave 3 Polígono Ind. Juncaril 18210-Peligros-Granada Spain

Size: A4 | Drawn by: J. Gabriel R.E.
Revision: 3.4 | Date: 18/06/2014 | Sheet 21 of 23

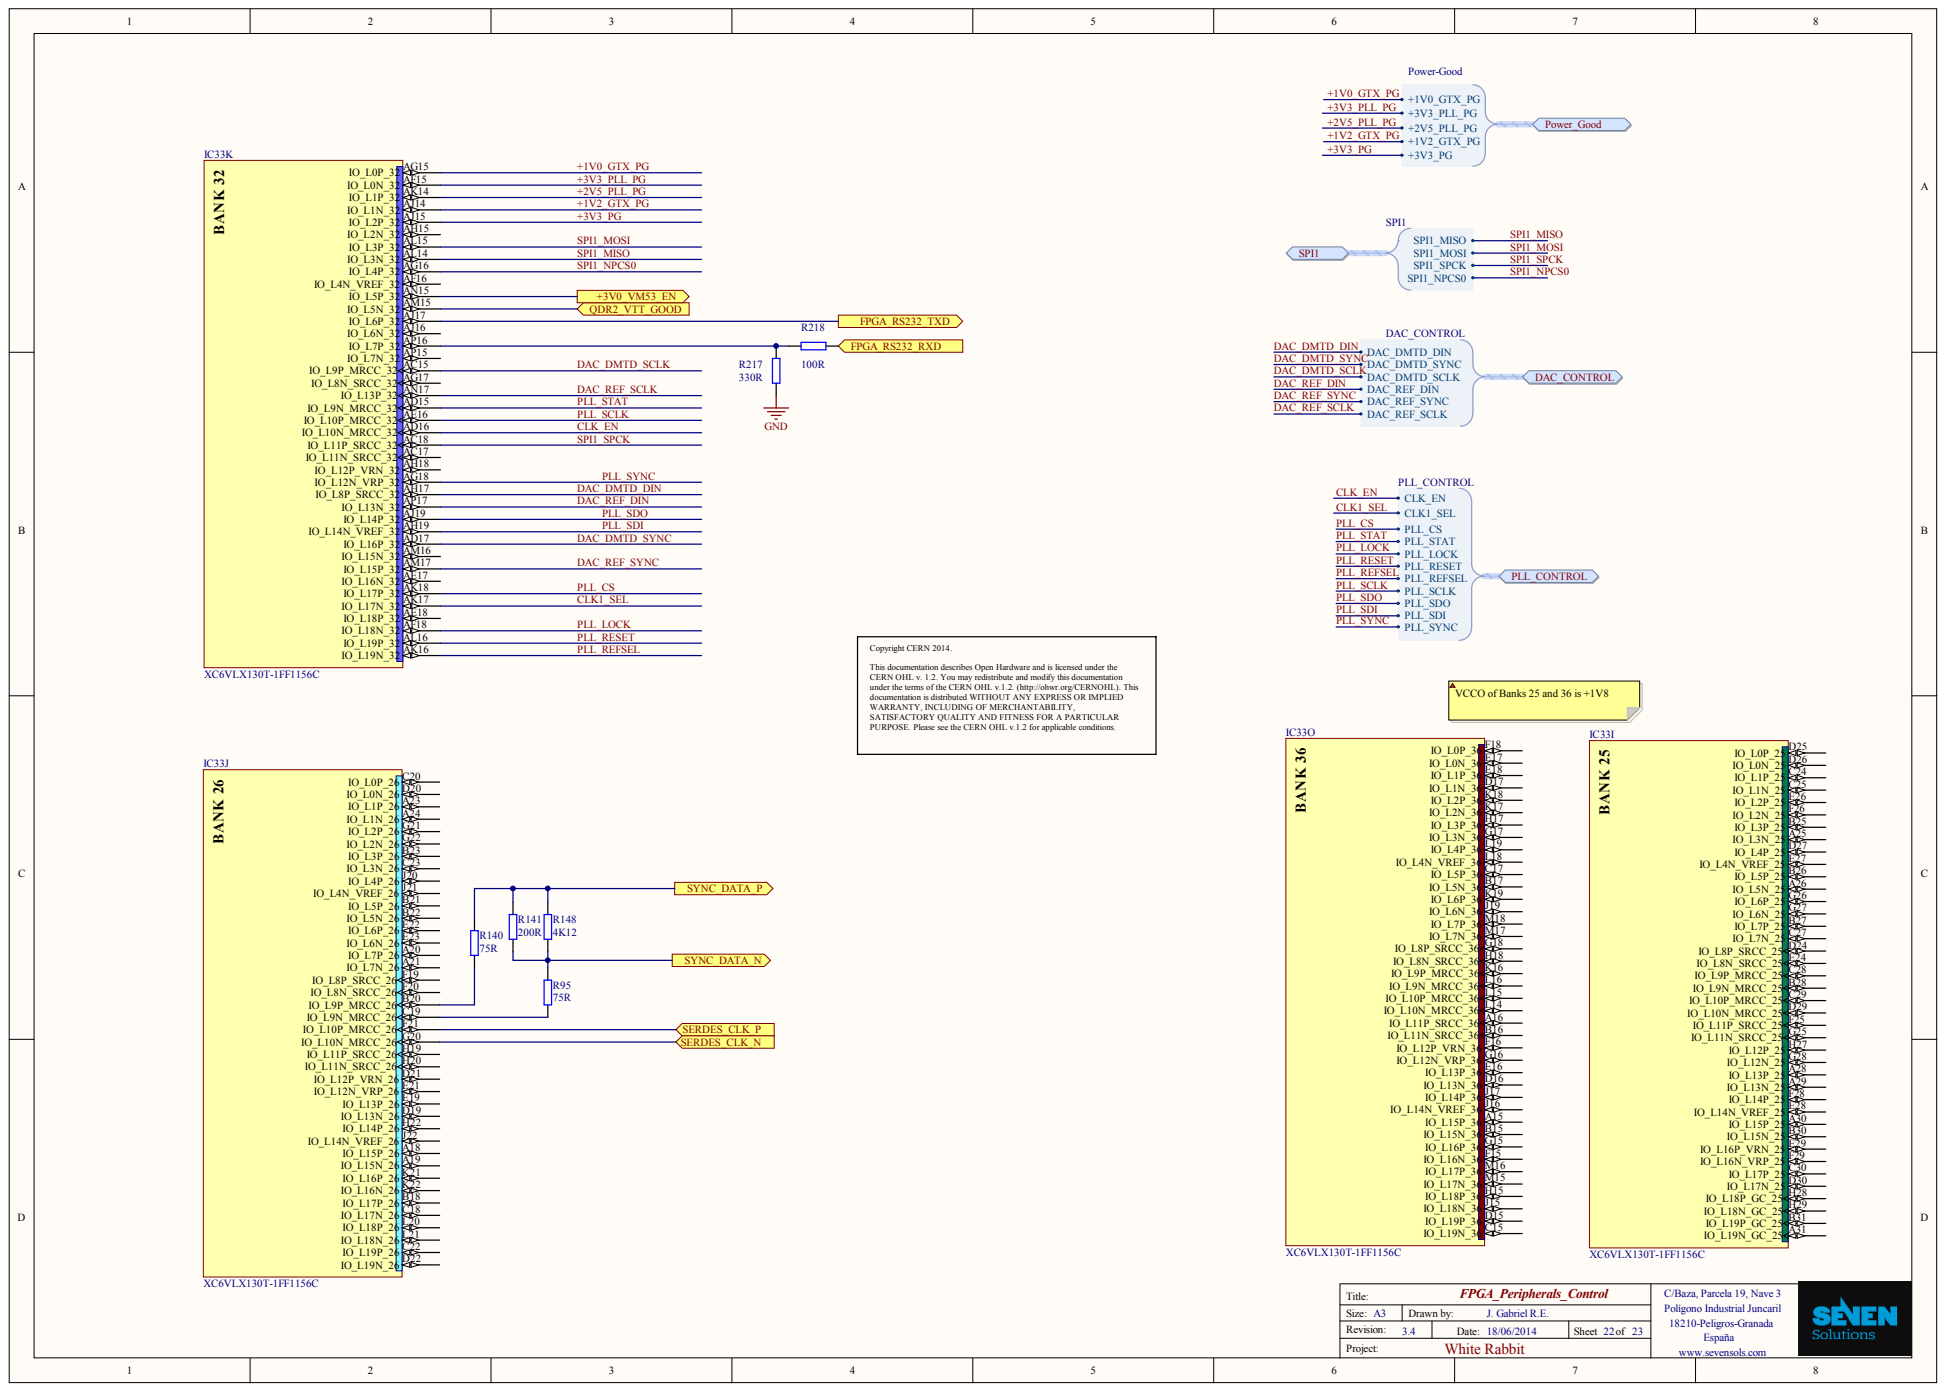
[picture p24: page 22]

Thi
CERN O
under the terms of the CERN

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

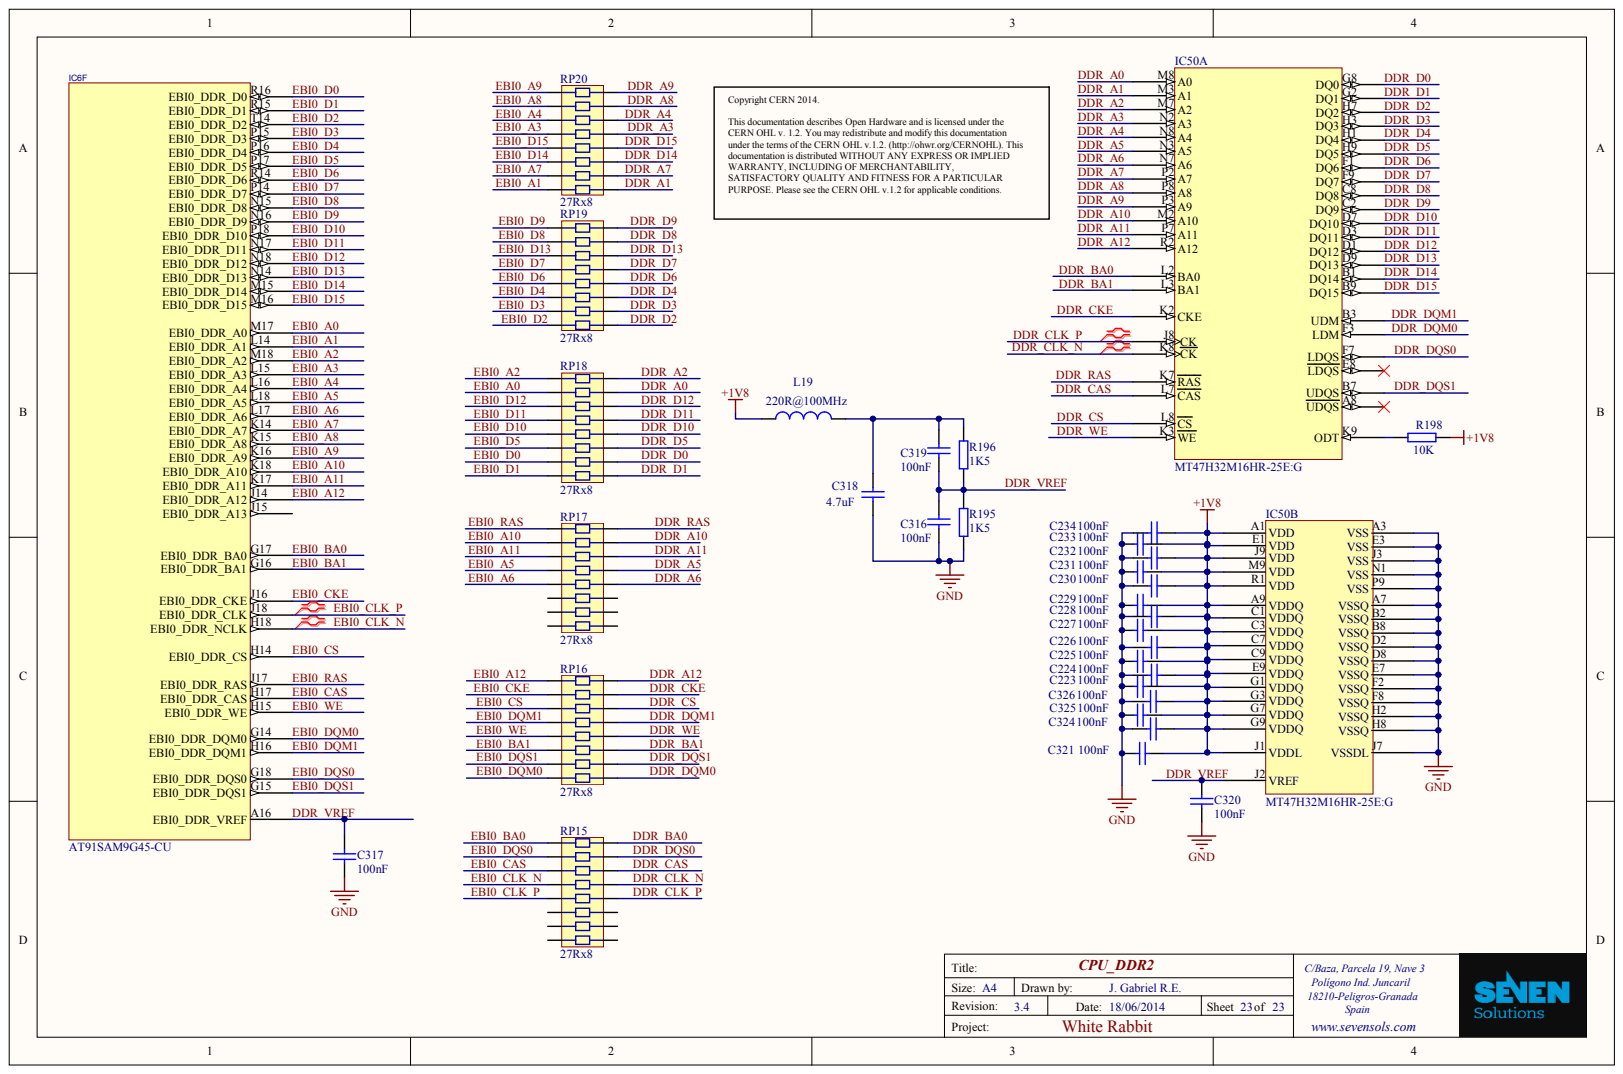
[picture p25: page 23]

T ANY EXPRESS OR IMPLIED

SATI
PURPOSE. Please see the CERN OHL v.1.2 for ap

M16HR-25E:G VDD A1 VDD J9 VDD E1 VDD M9 VDD R1

P 9
VDDQ C1 VDDQ C3 VDDQ C7 VDDQ C9 VDDQ E9 VDDQ G1 VDDQ G3 VDDQ G7 VDDQ G9 VDDL J1 Q D8

F 2
F 8

CPU_DDR 2 | www.sevensols.com C/Baza, Parcela 19, Nave 3 Polígono Ind. Juncaril 18210-Peligros-Granada Spain

A | y :
Re vision : | Date: 18/06/201 4 | S heet 2 3 o f 2 3
