Reedgarden/WRS-HW/circuit_board/wrs_v3/Docs_PDF/SCB.pdf

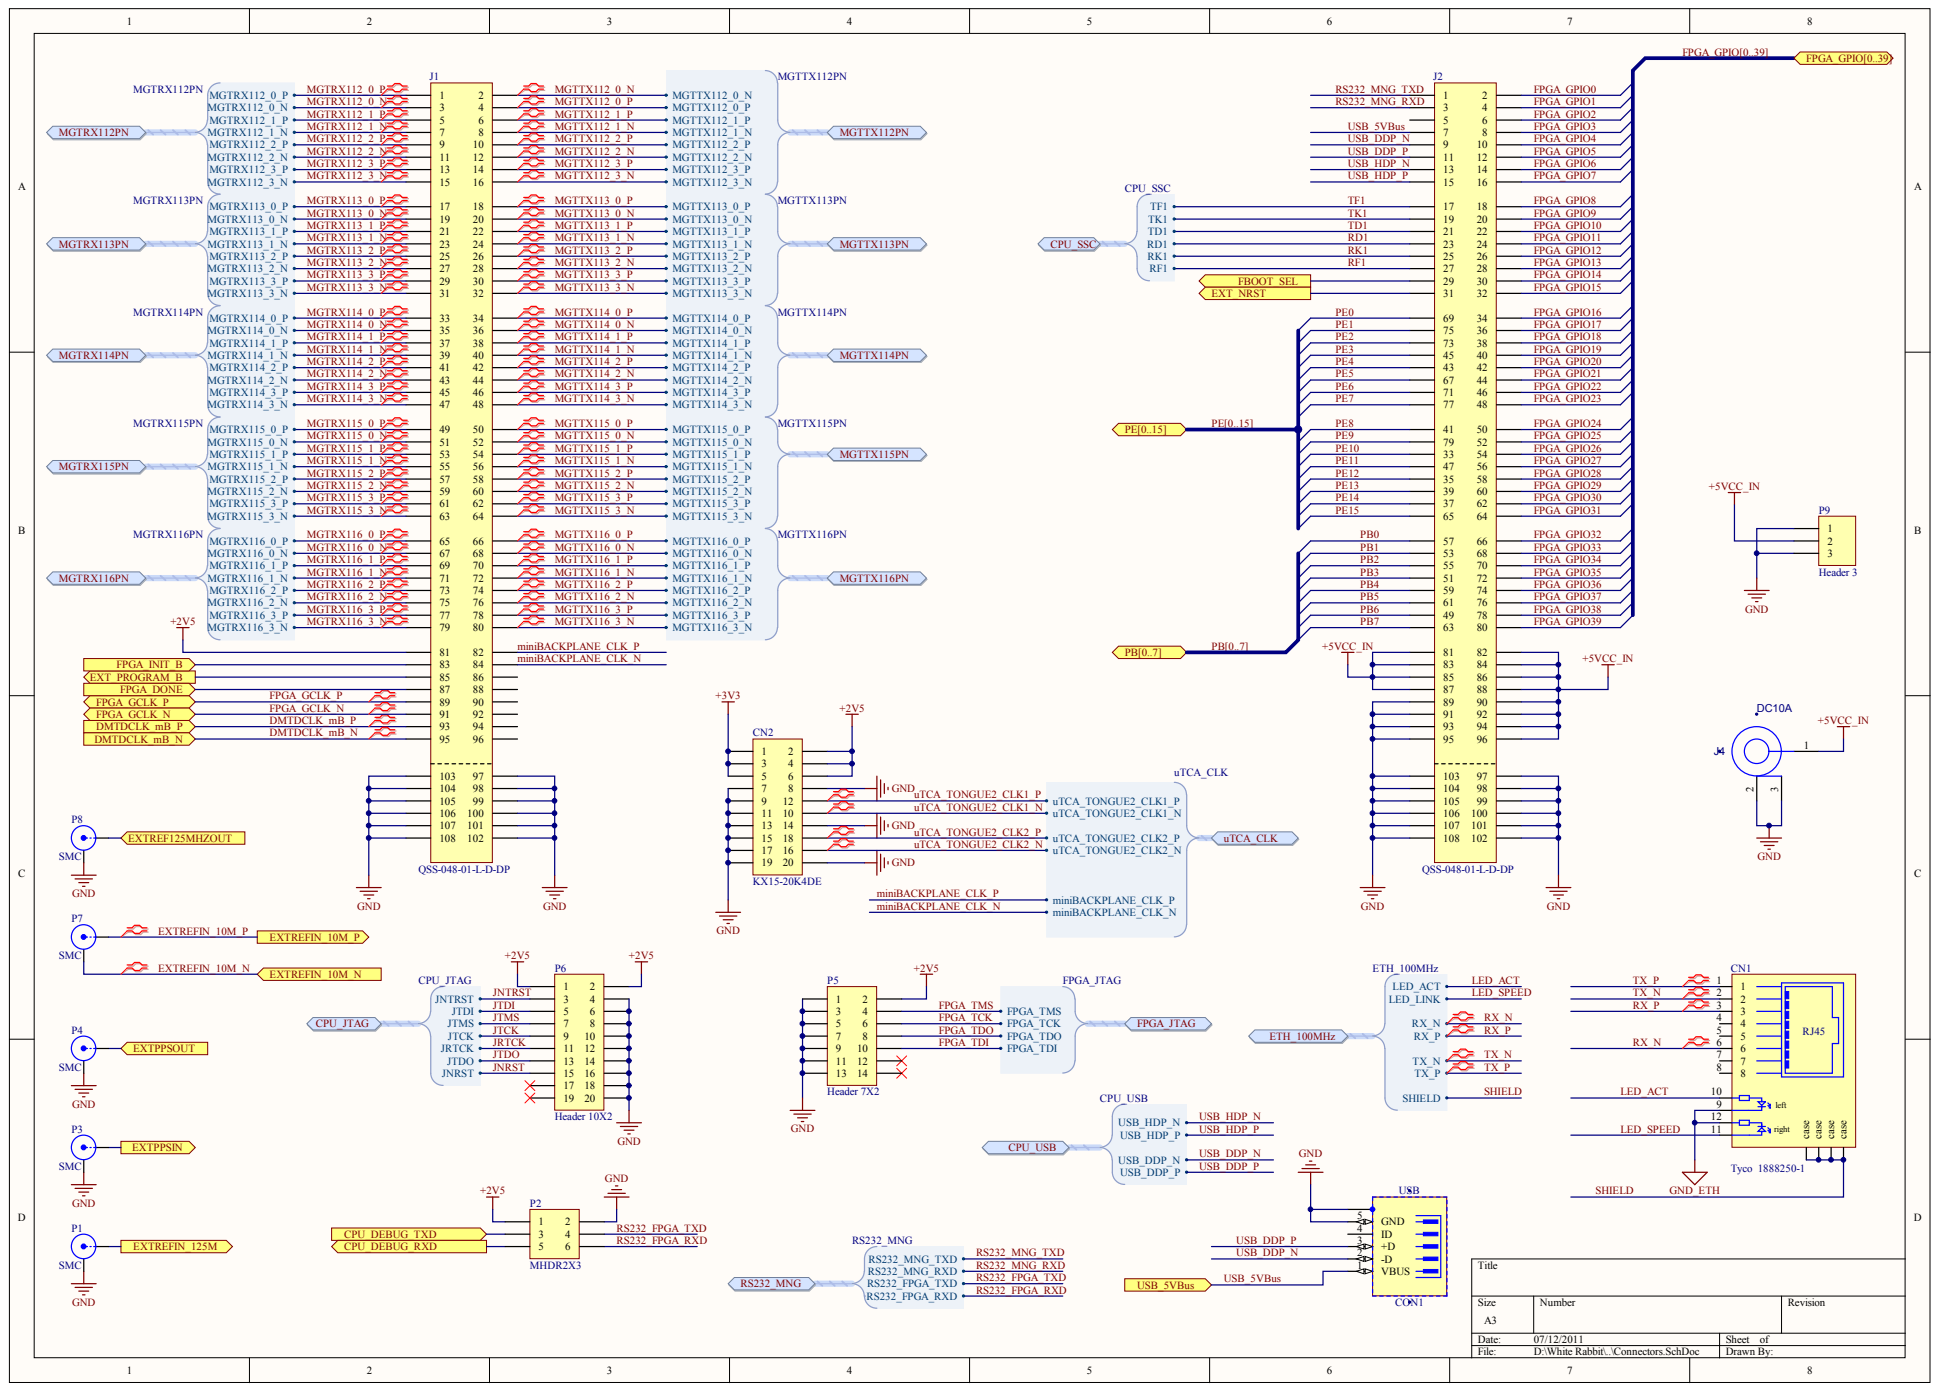
[picture p26: page 1]

12
11

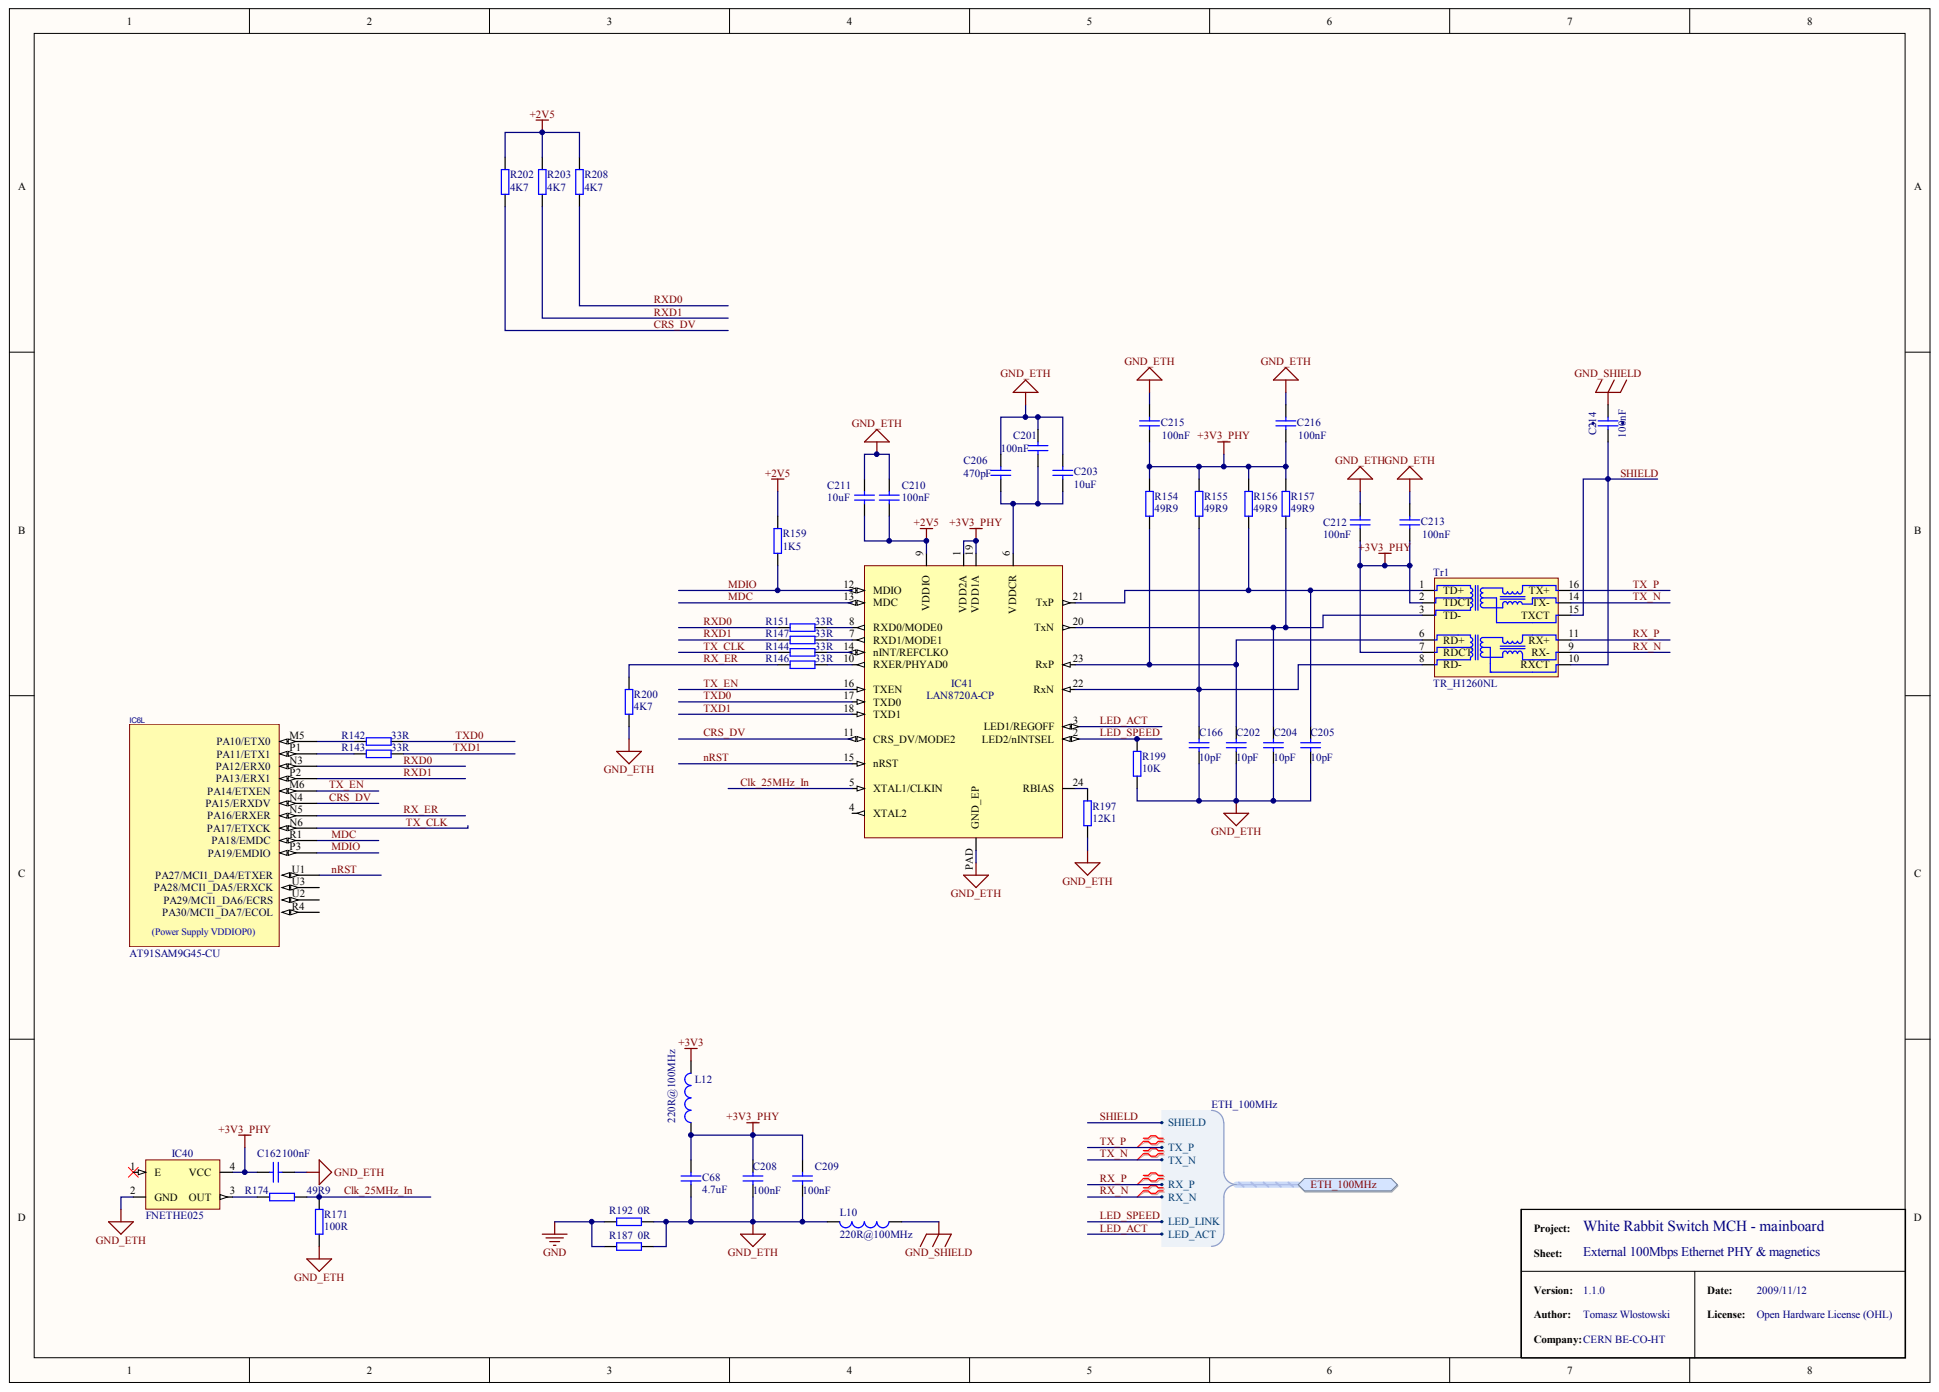
[picture p27: page 2]

External 100Mbps Ethernet PHY & magnetics

Open Hardware License (OHL)

Company:CERN BE-CO-HT

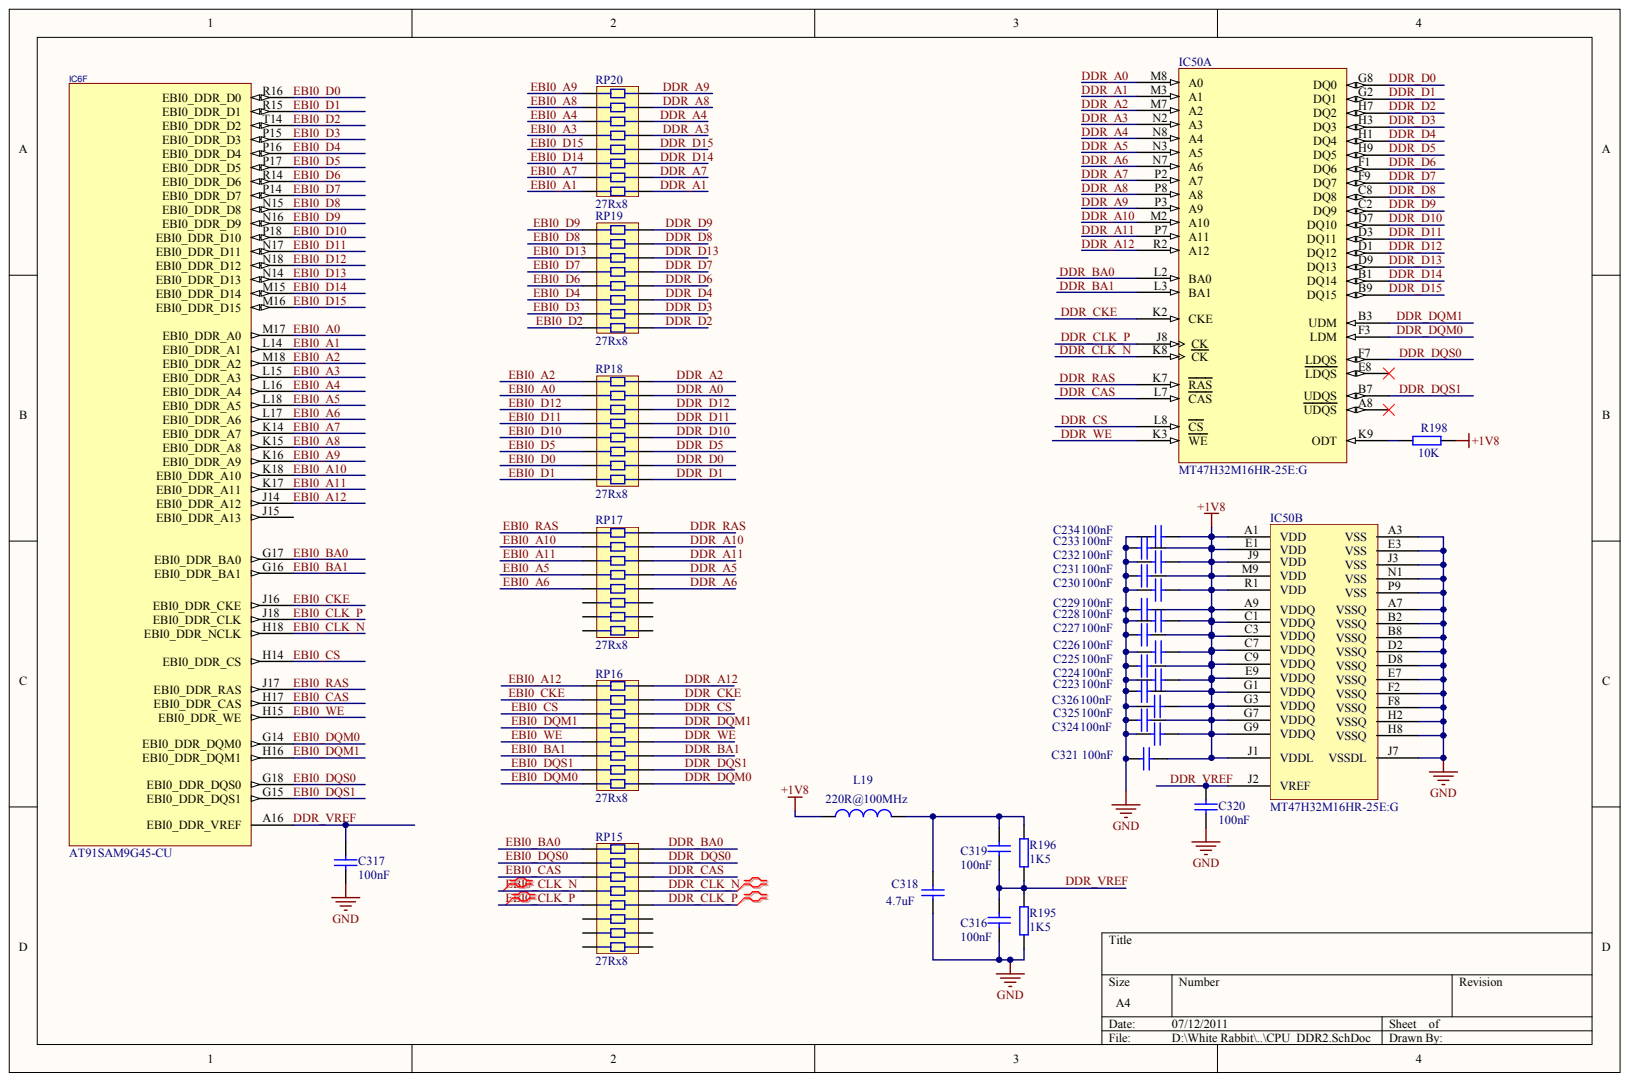
[picture p28: page 3]

F 2
F 8

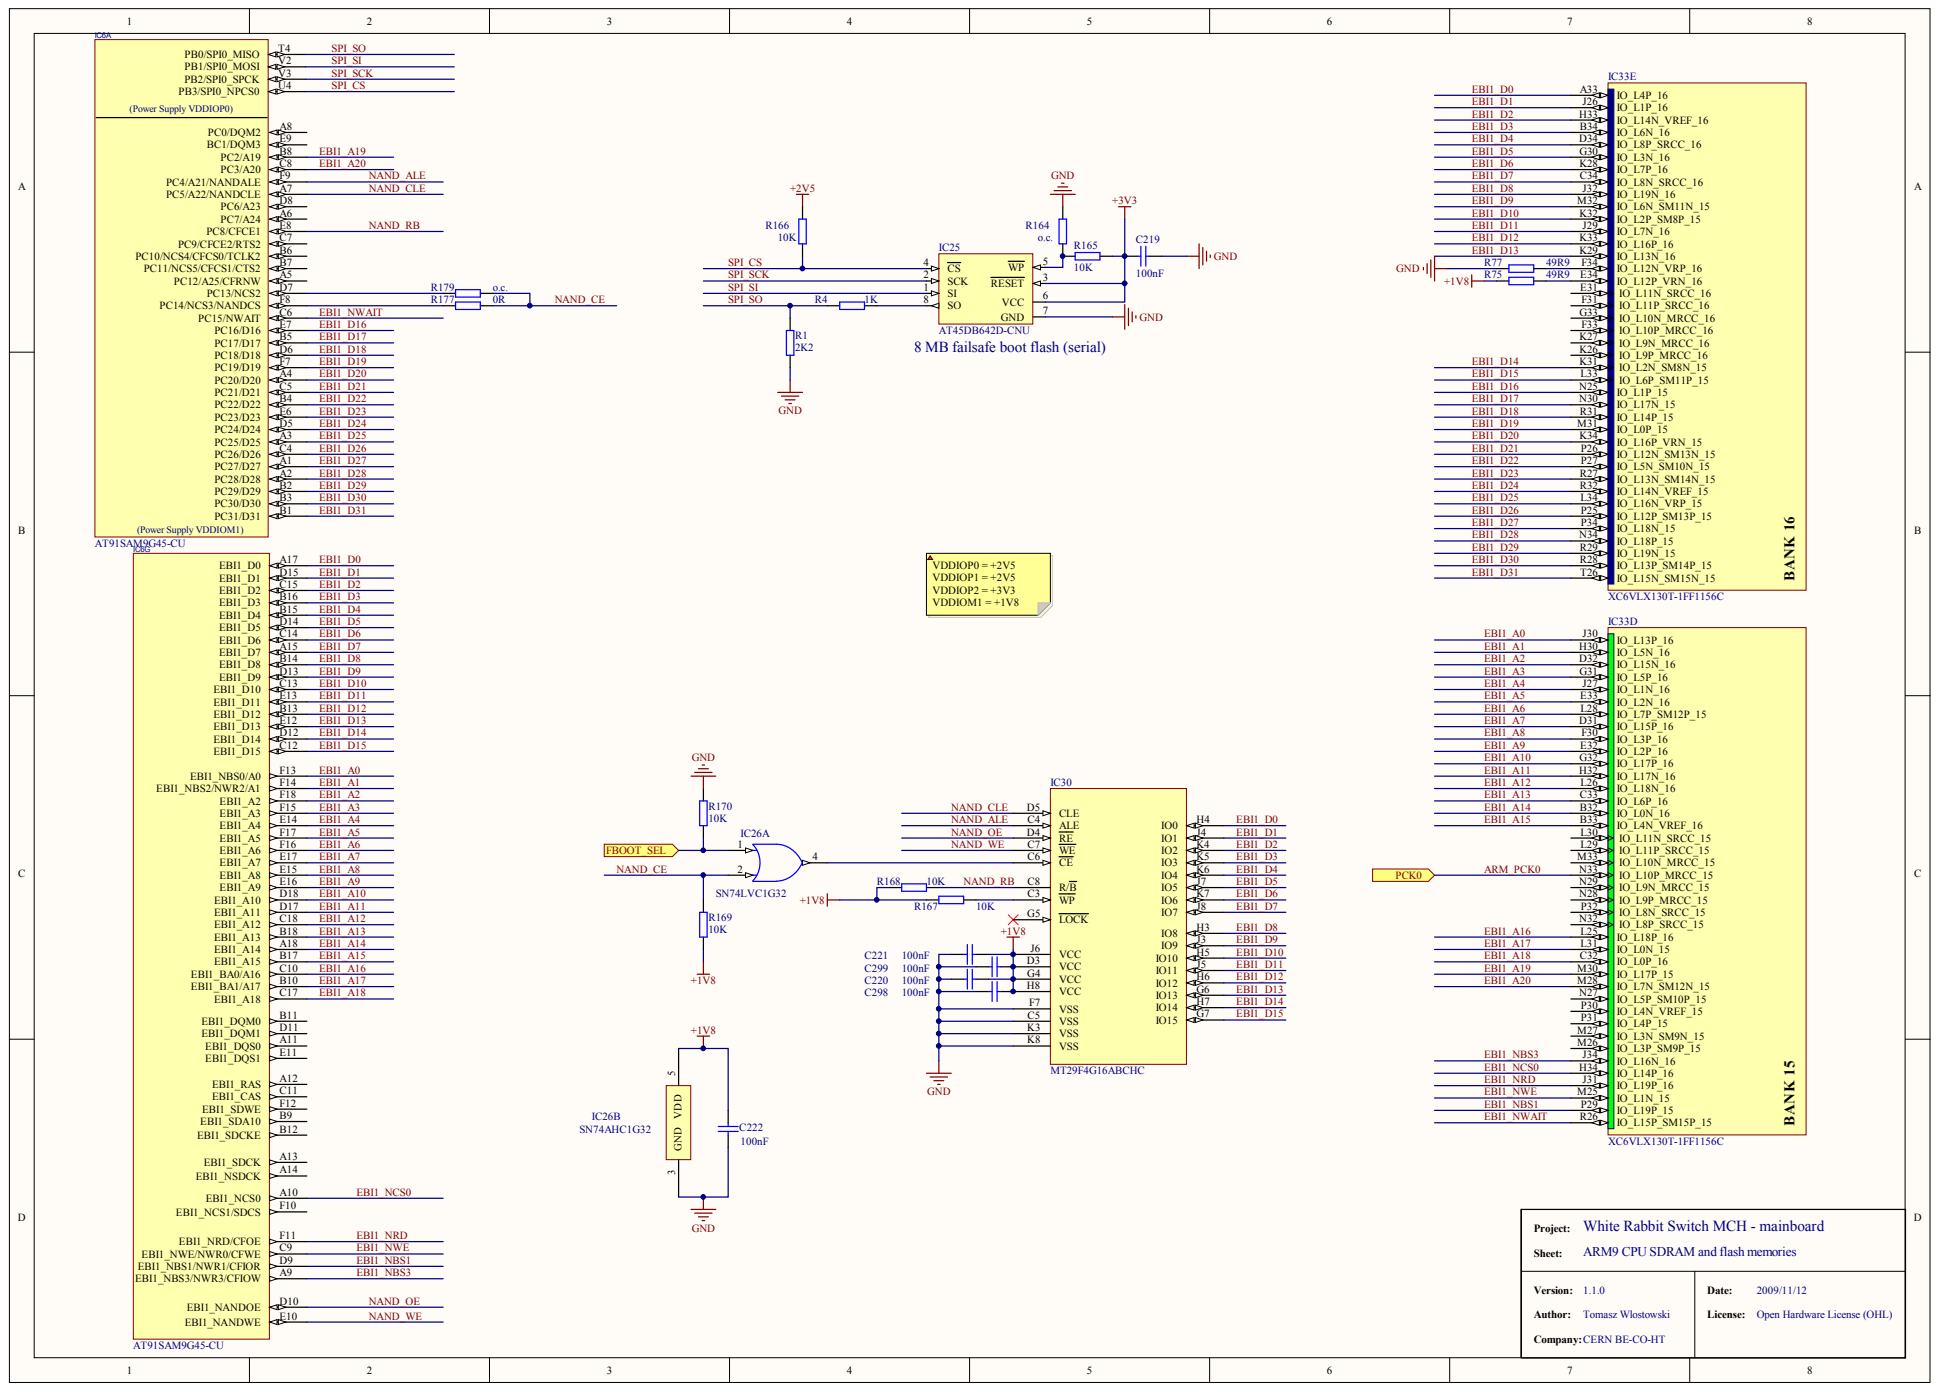
[picture p29: page 4]

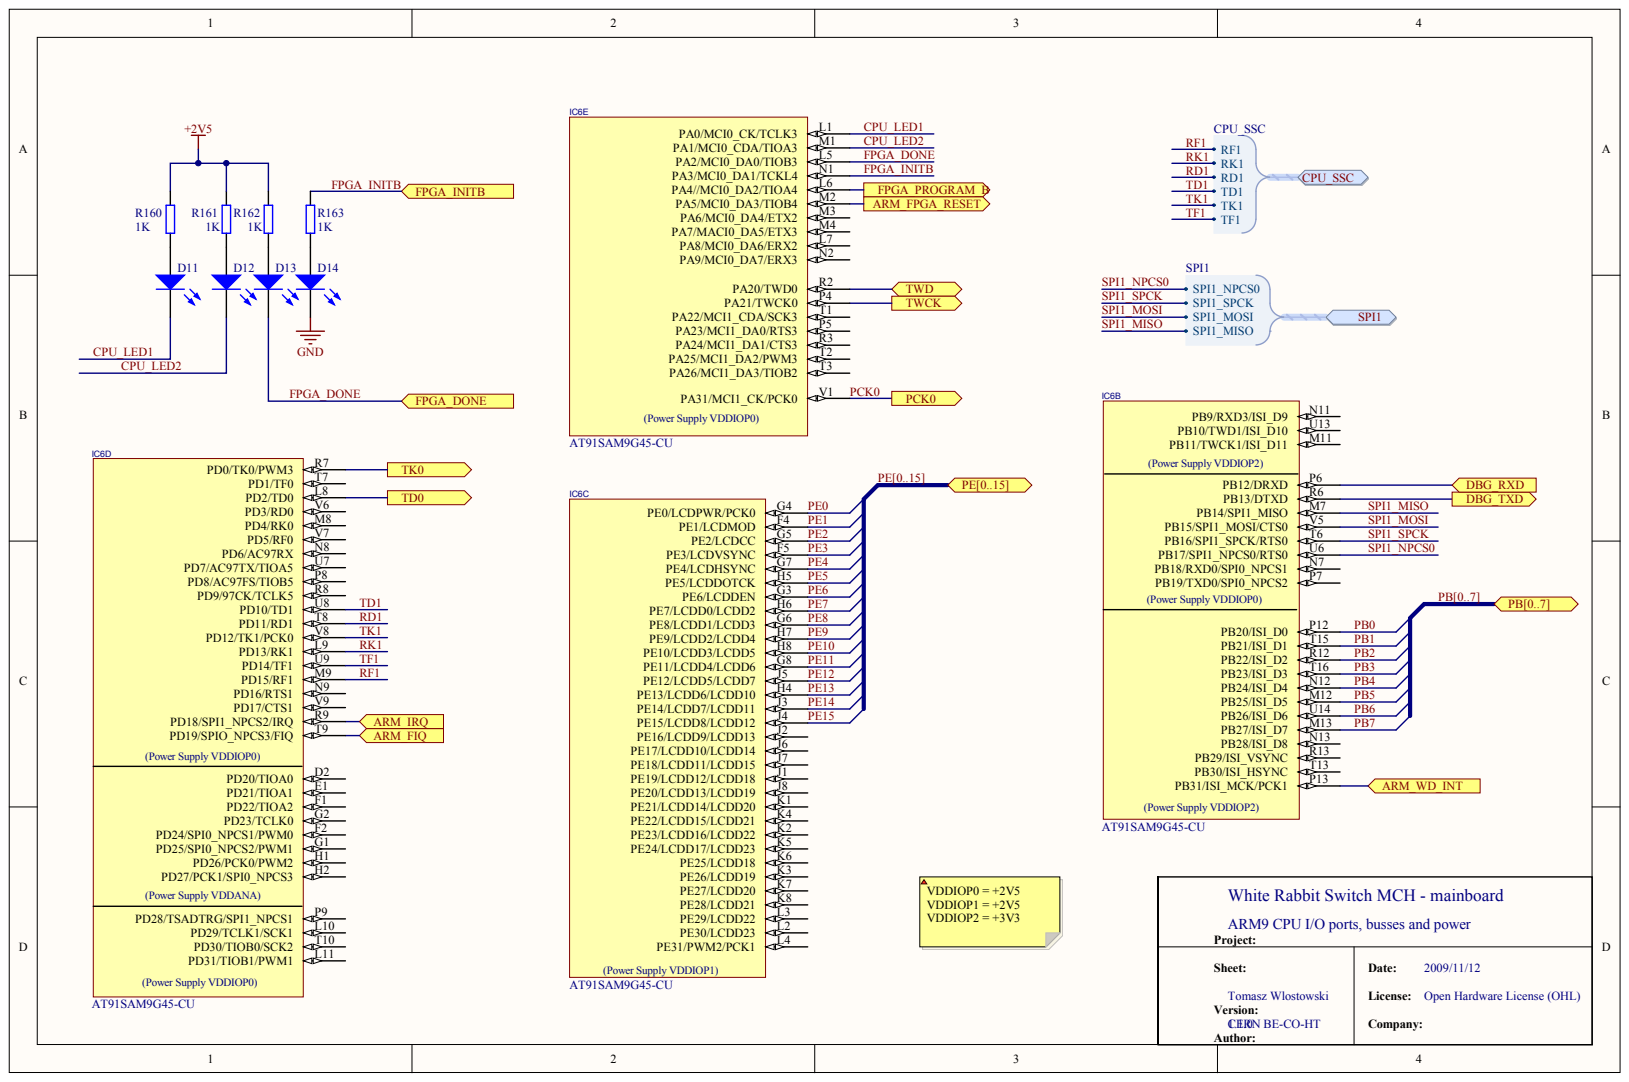
[picture p30: page 5]

White Rabbit Switch MCH - mainboard

ARM9 CPU I/O ports, busses and power
Project:

Open Hardware License (OHL)

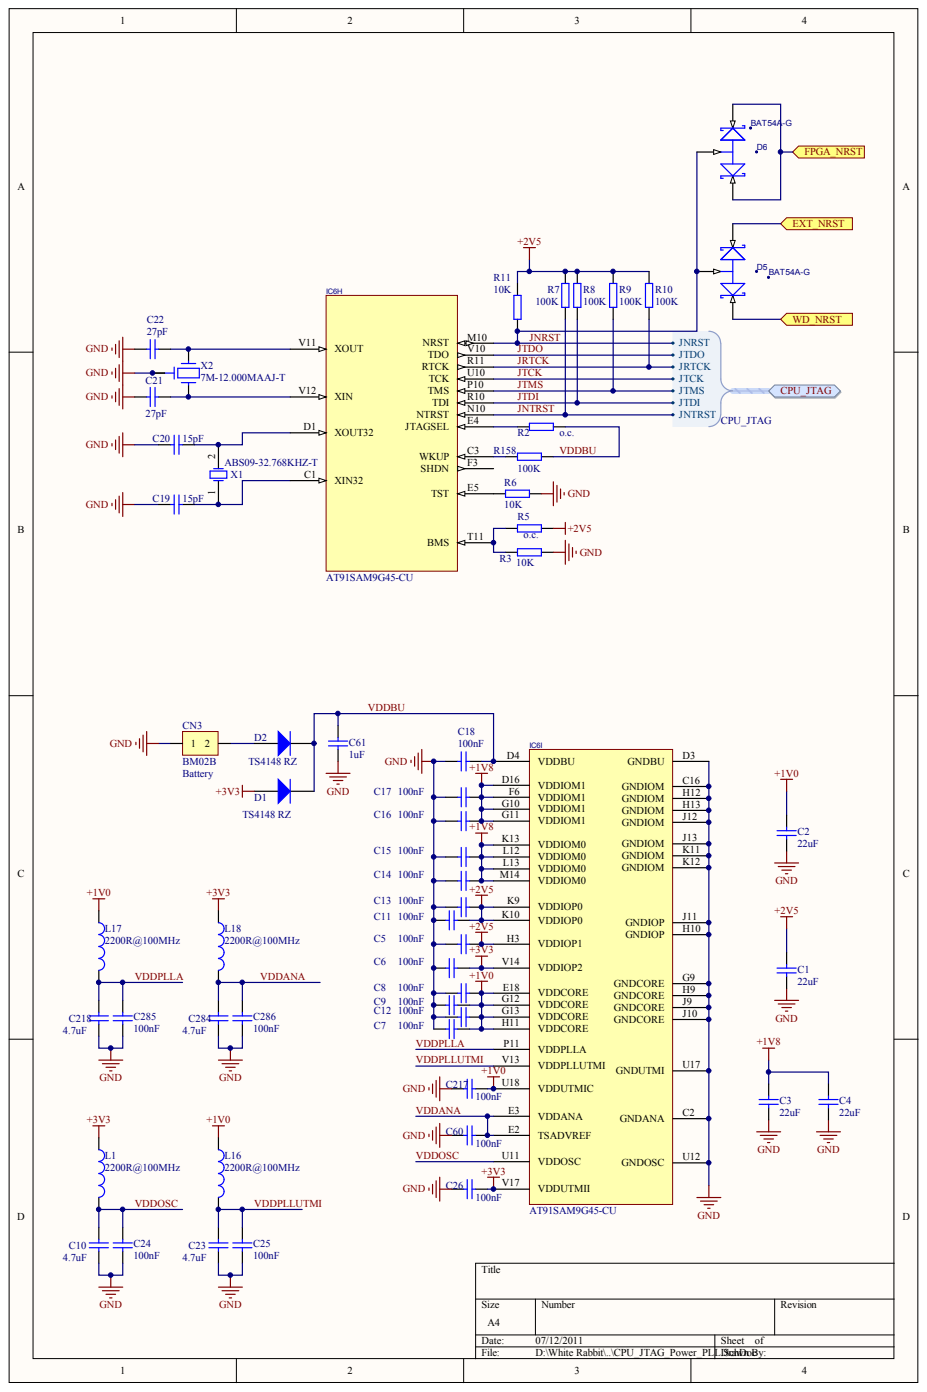
[picture p31: page 6]

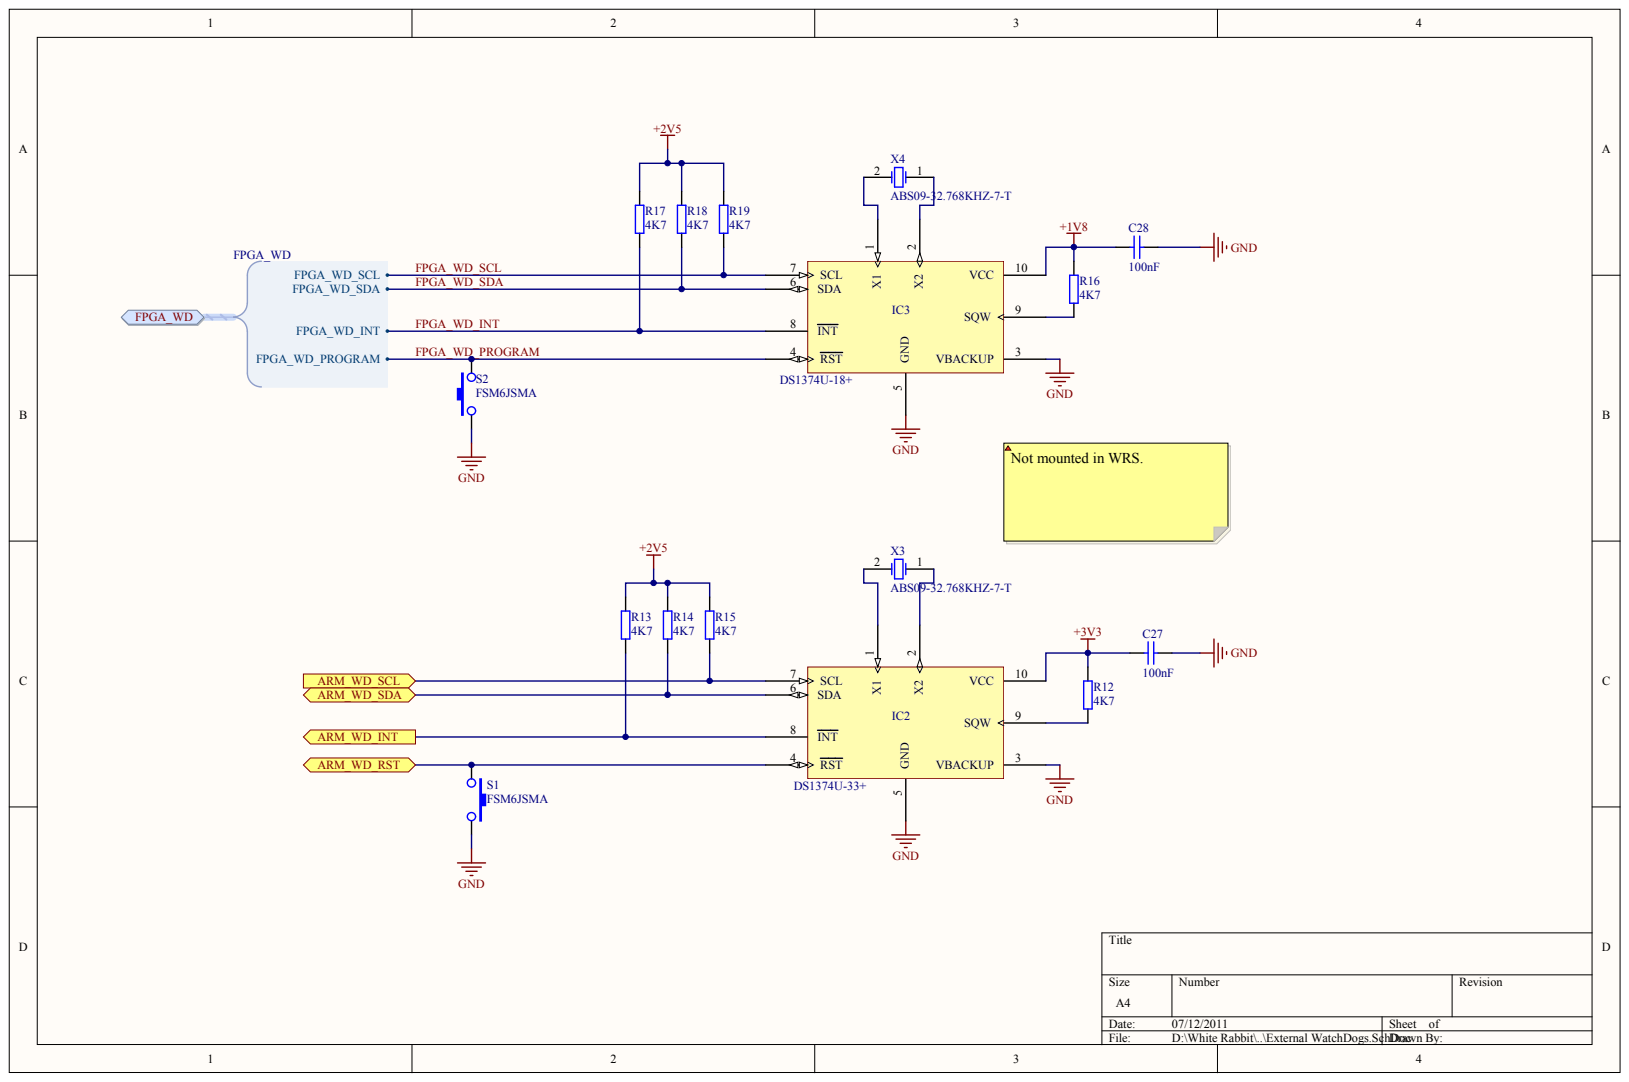
[picture p32: page 7]

Not mounted in WRS.

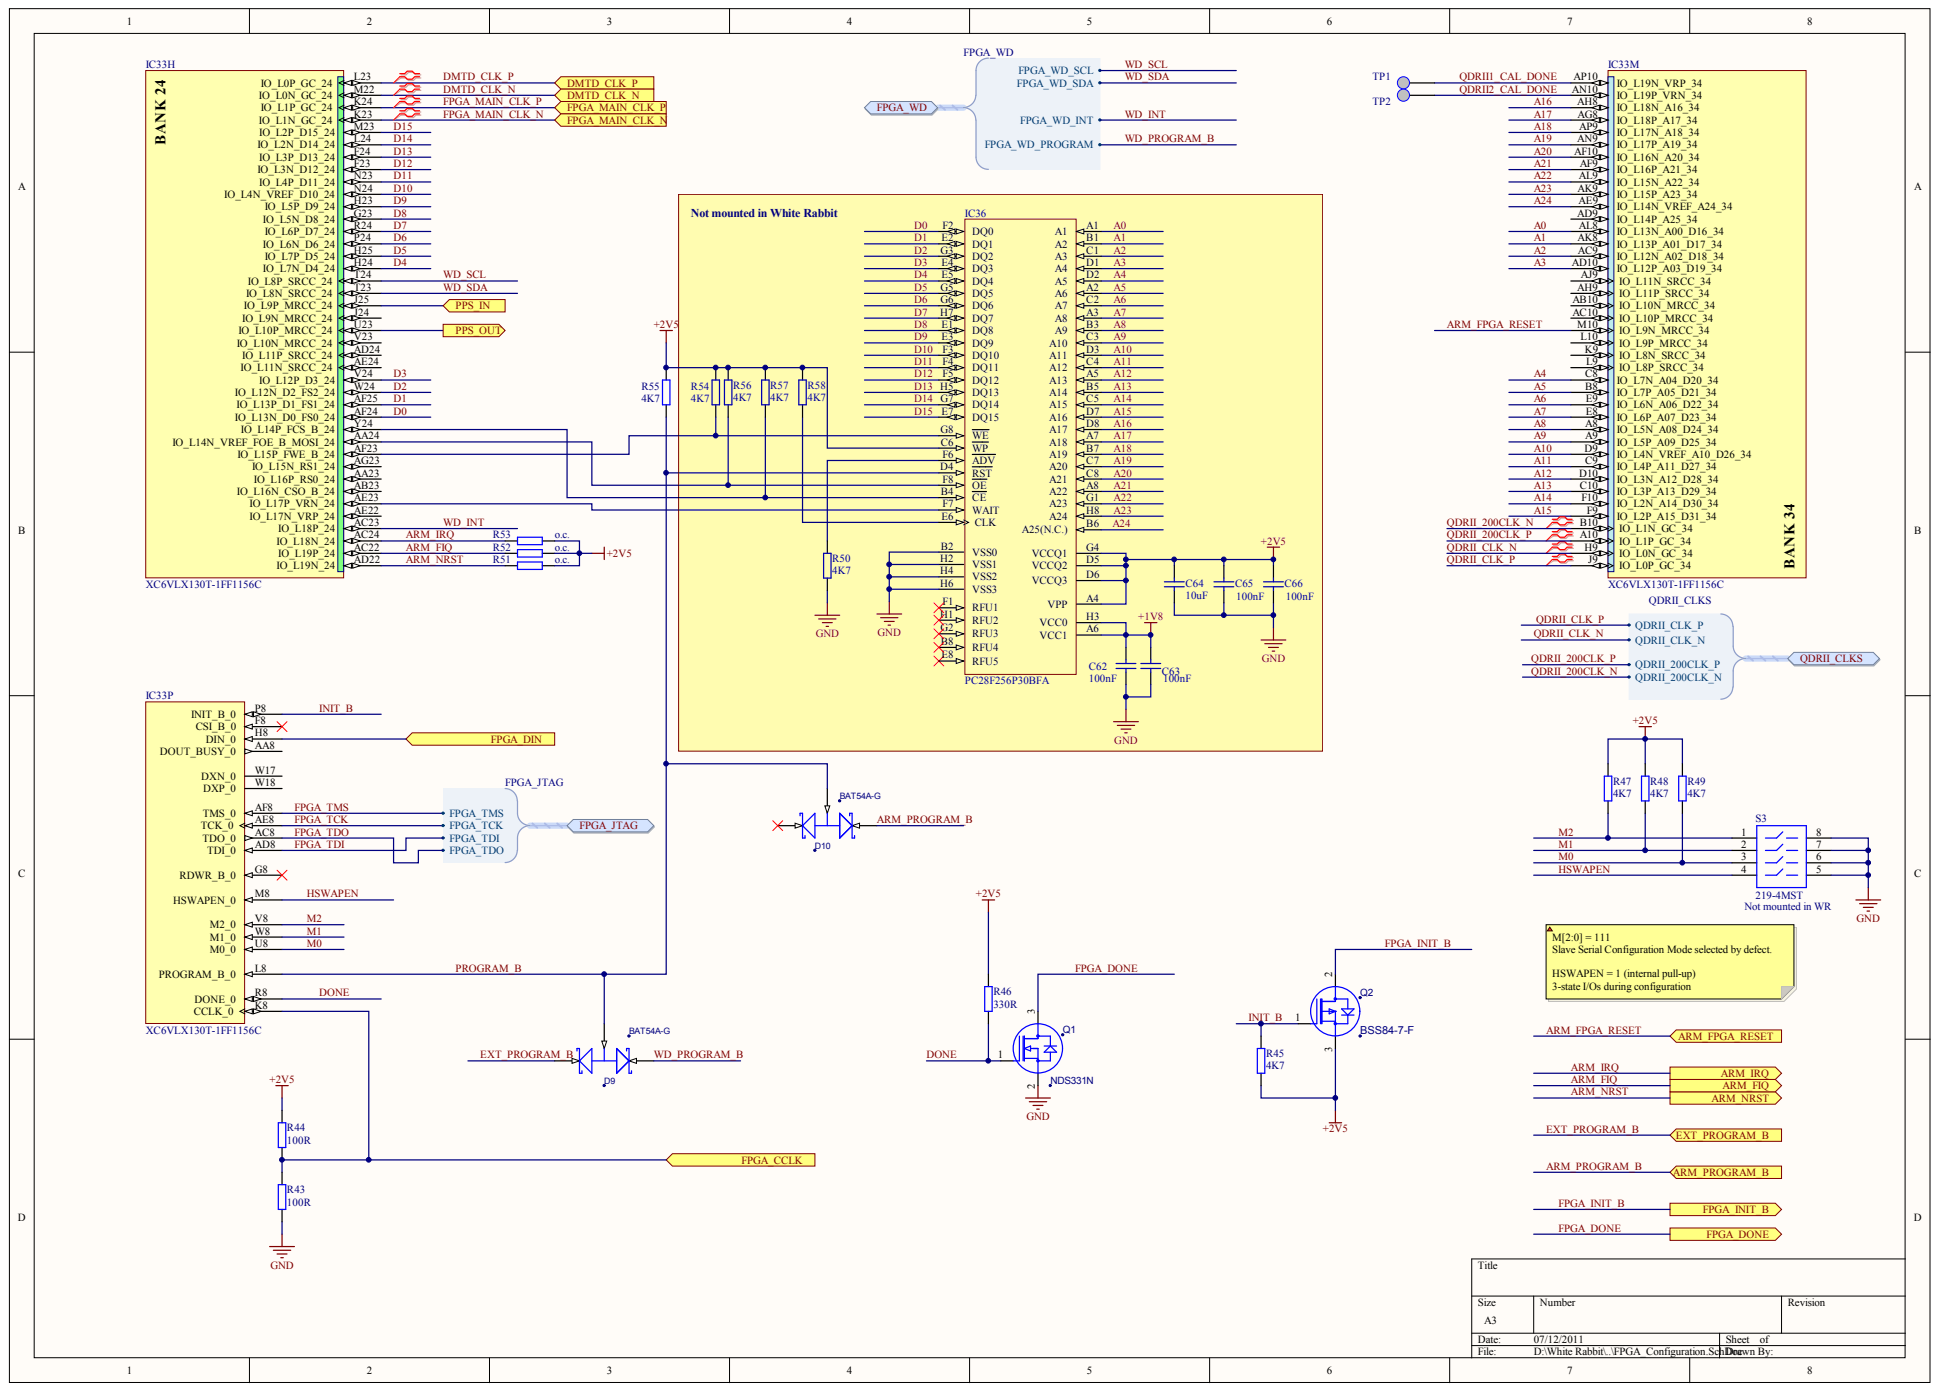
[picture p33: page 8]

Not mounted in White Rabbit

CE B4
WAIT F7 CLK E6

219-4MST
Not mounted in WR

Slave Serial Configuration Mode selected by defect.

HSWAPEN = 1 (internal pull-up)
3-state I/Os during configuration

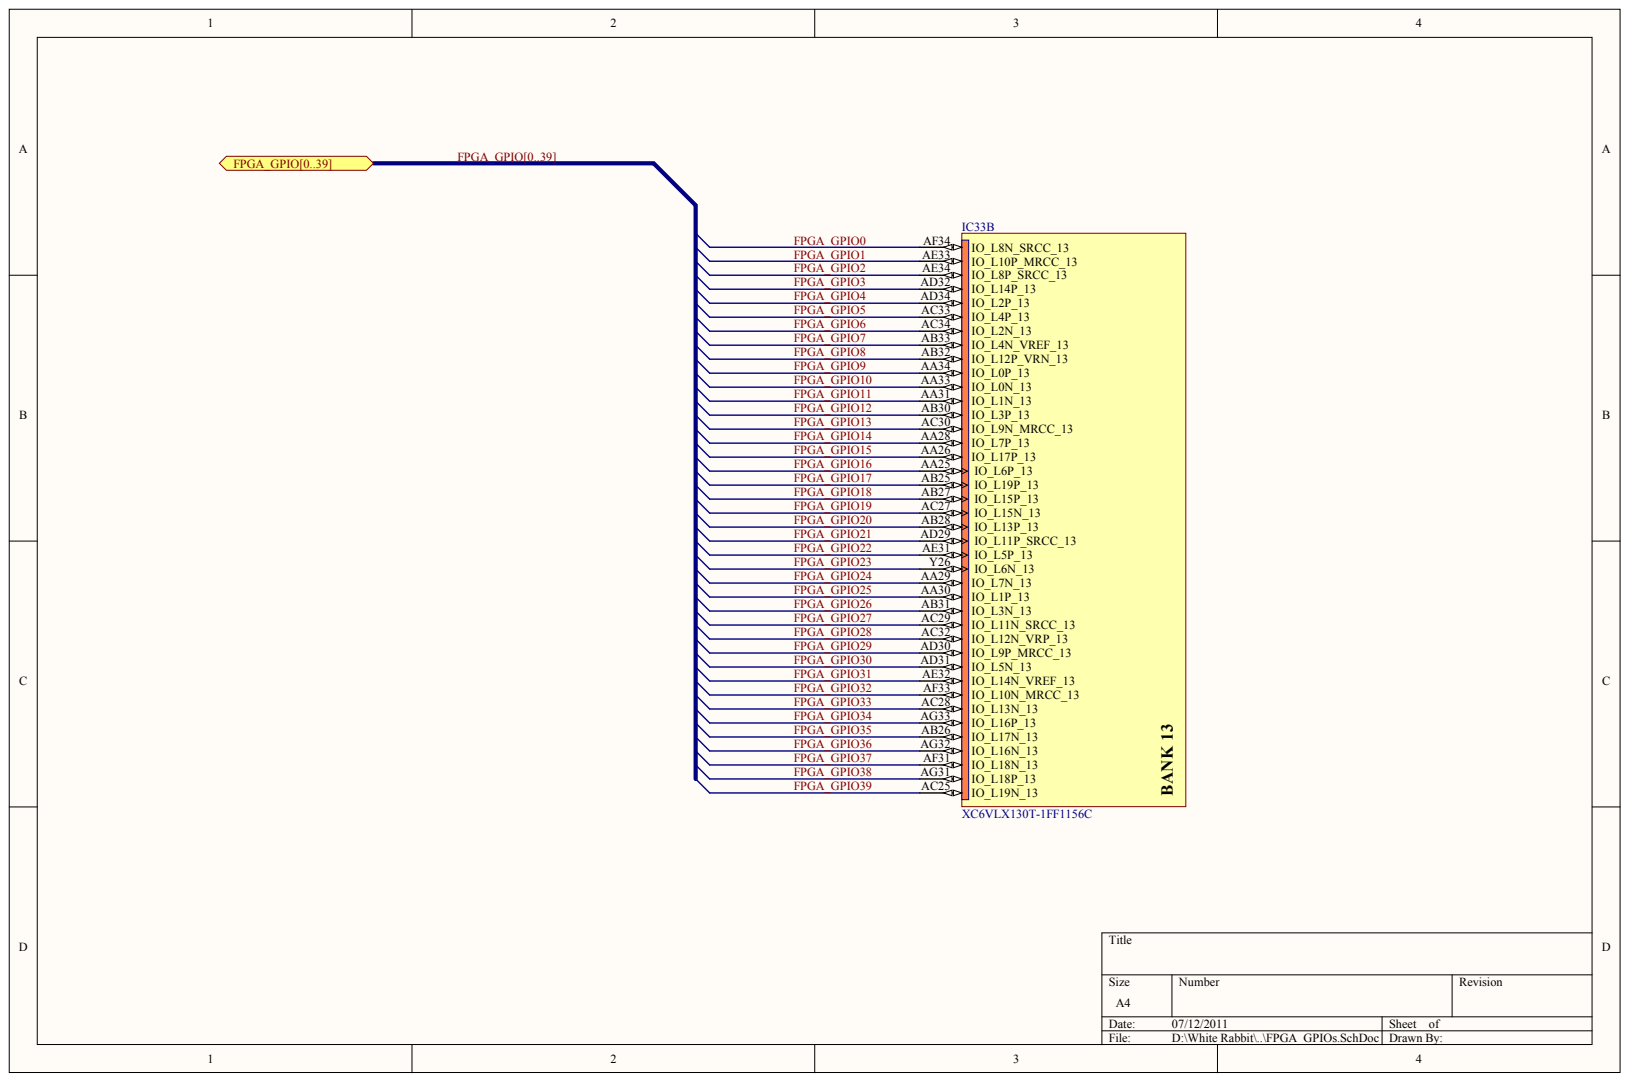
[picture p34: page 9]

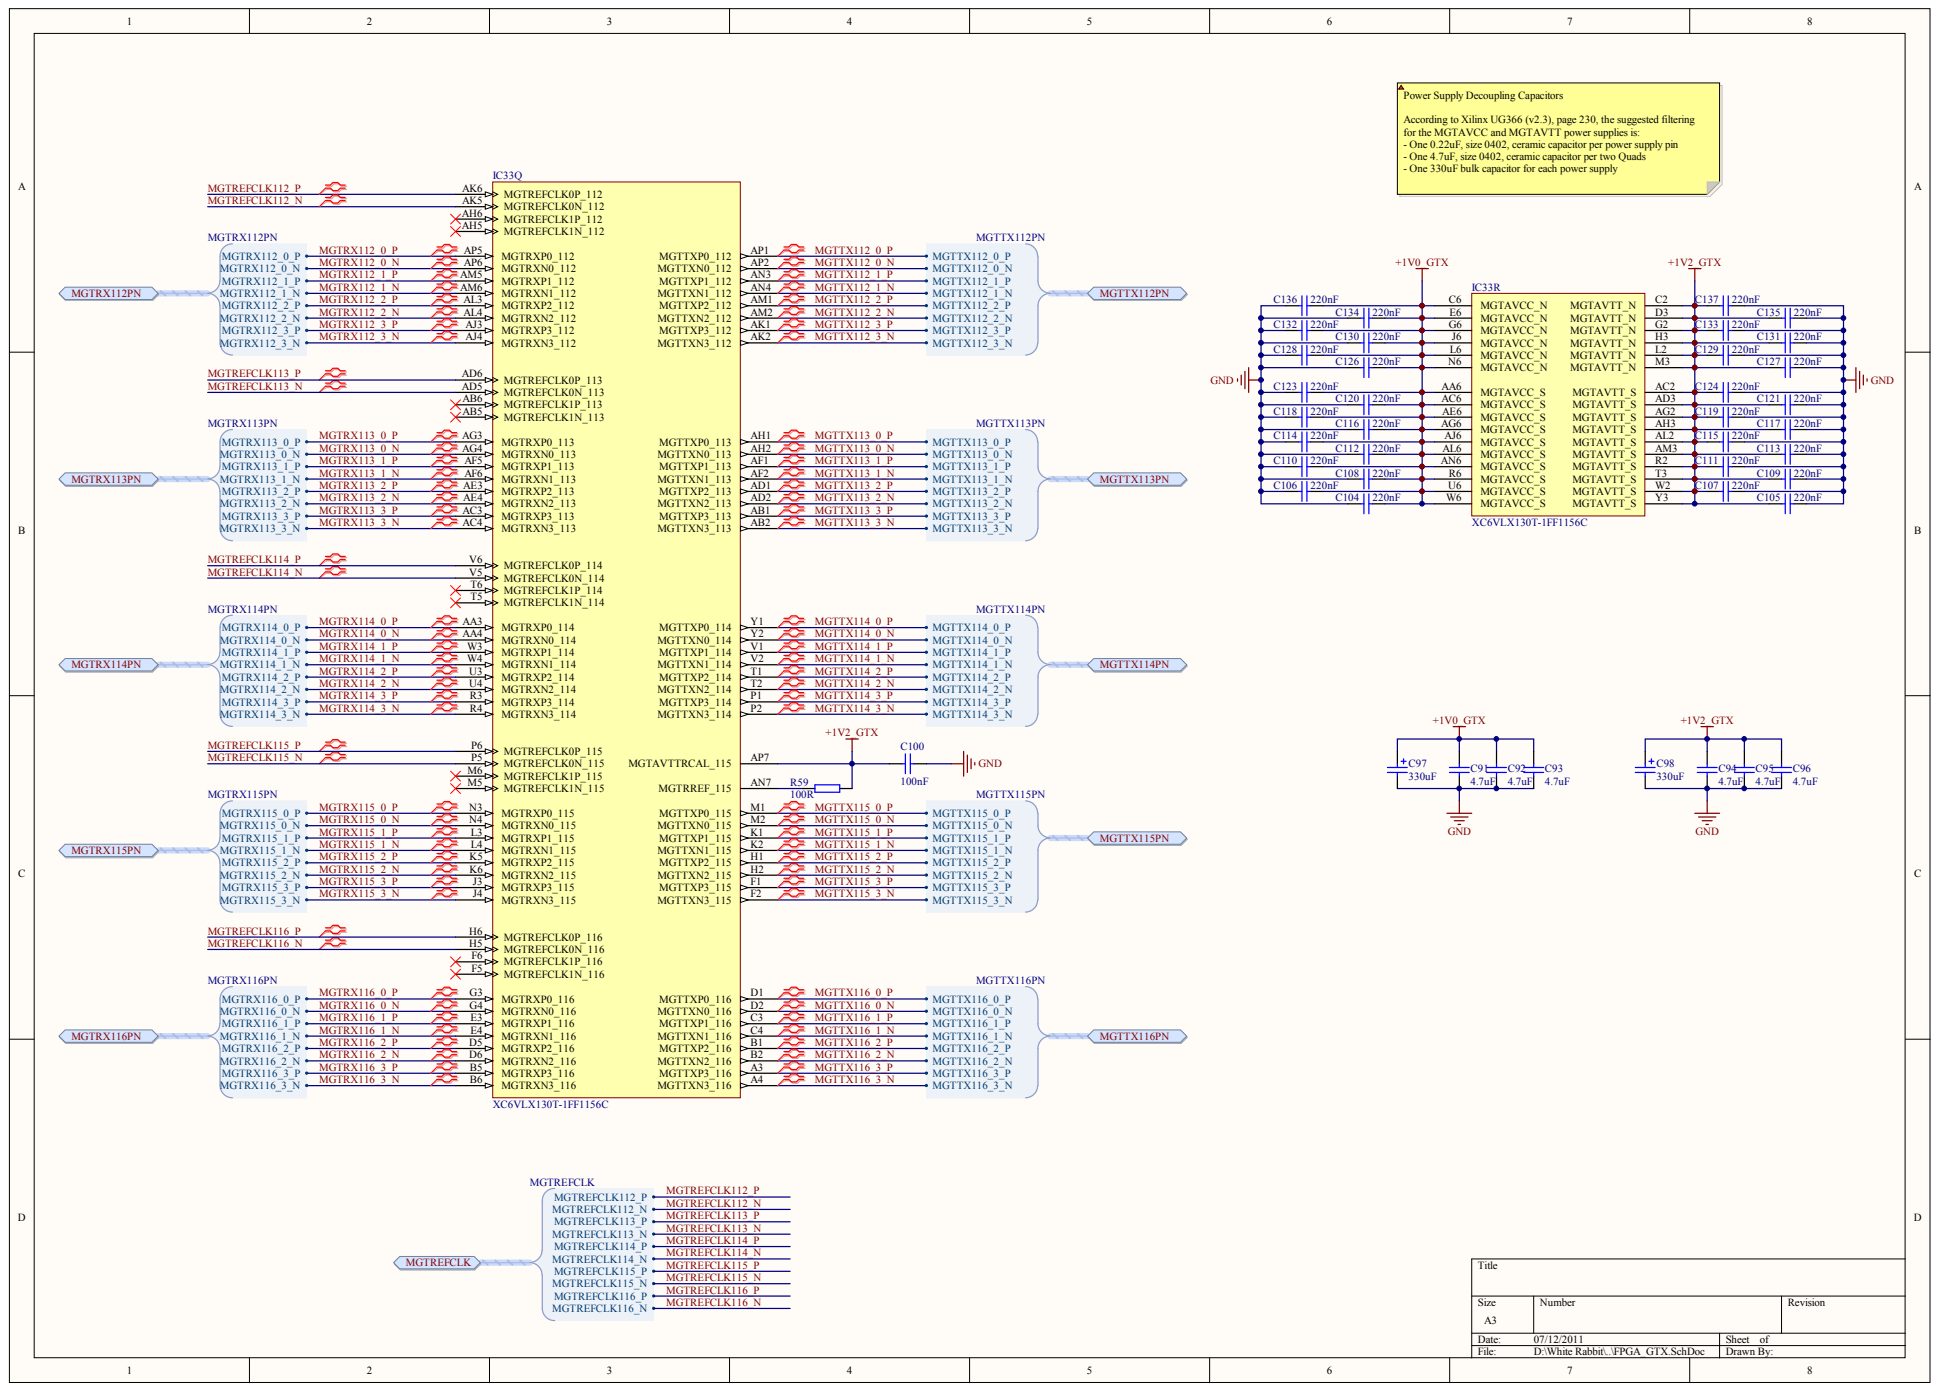
[picture p35: page 10]

Power Supply Decoupling Capacitors

According to Xilinx UG366 (v2.3), page 230, the suggested filtering
for the MGTAVCC and MGTAVTT power supplies is:
- One 0.22uF, size 0402, ceramic capacitor per power supply pin
- One 4.7uF, size 0402, ceramic capacitor per two Quads
- One 330uF bulk capacitor for each power supply

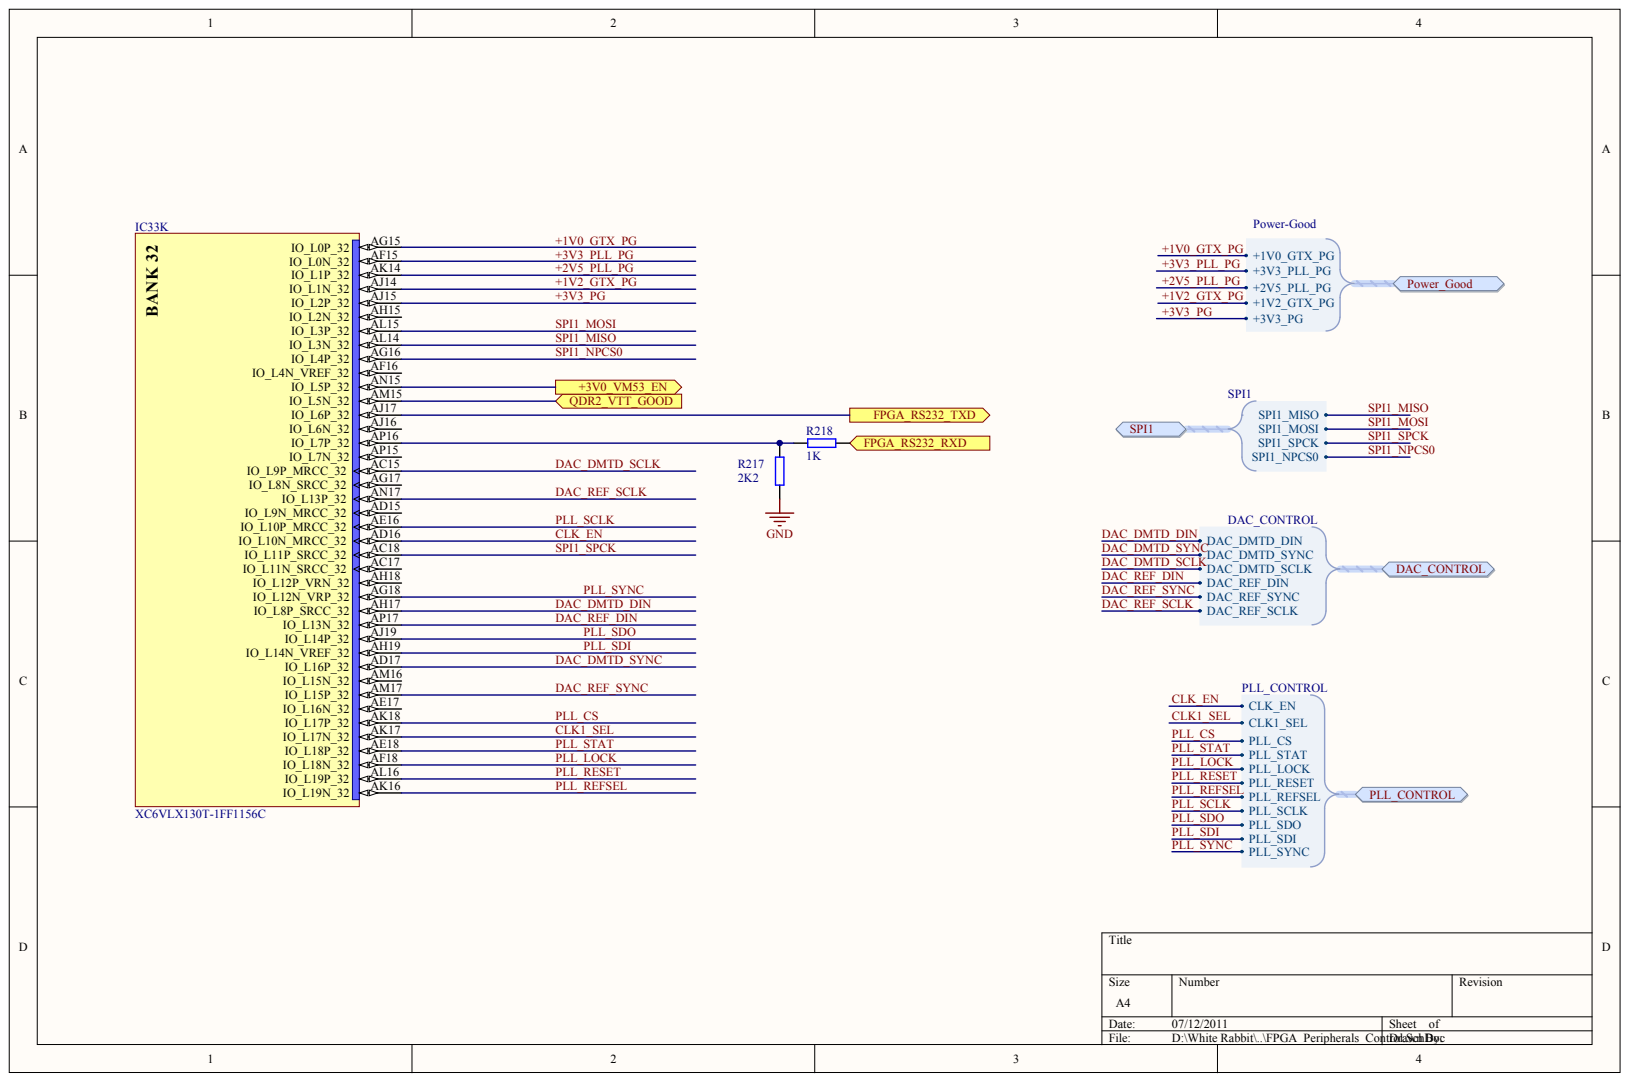
[picture p36: page 11]

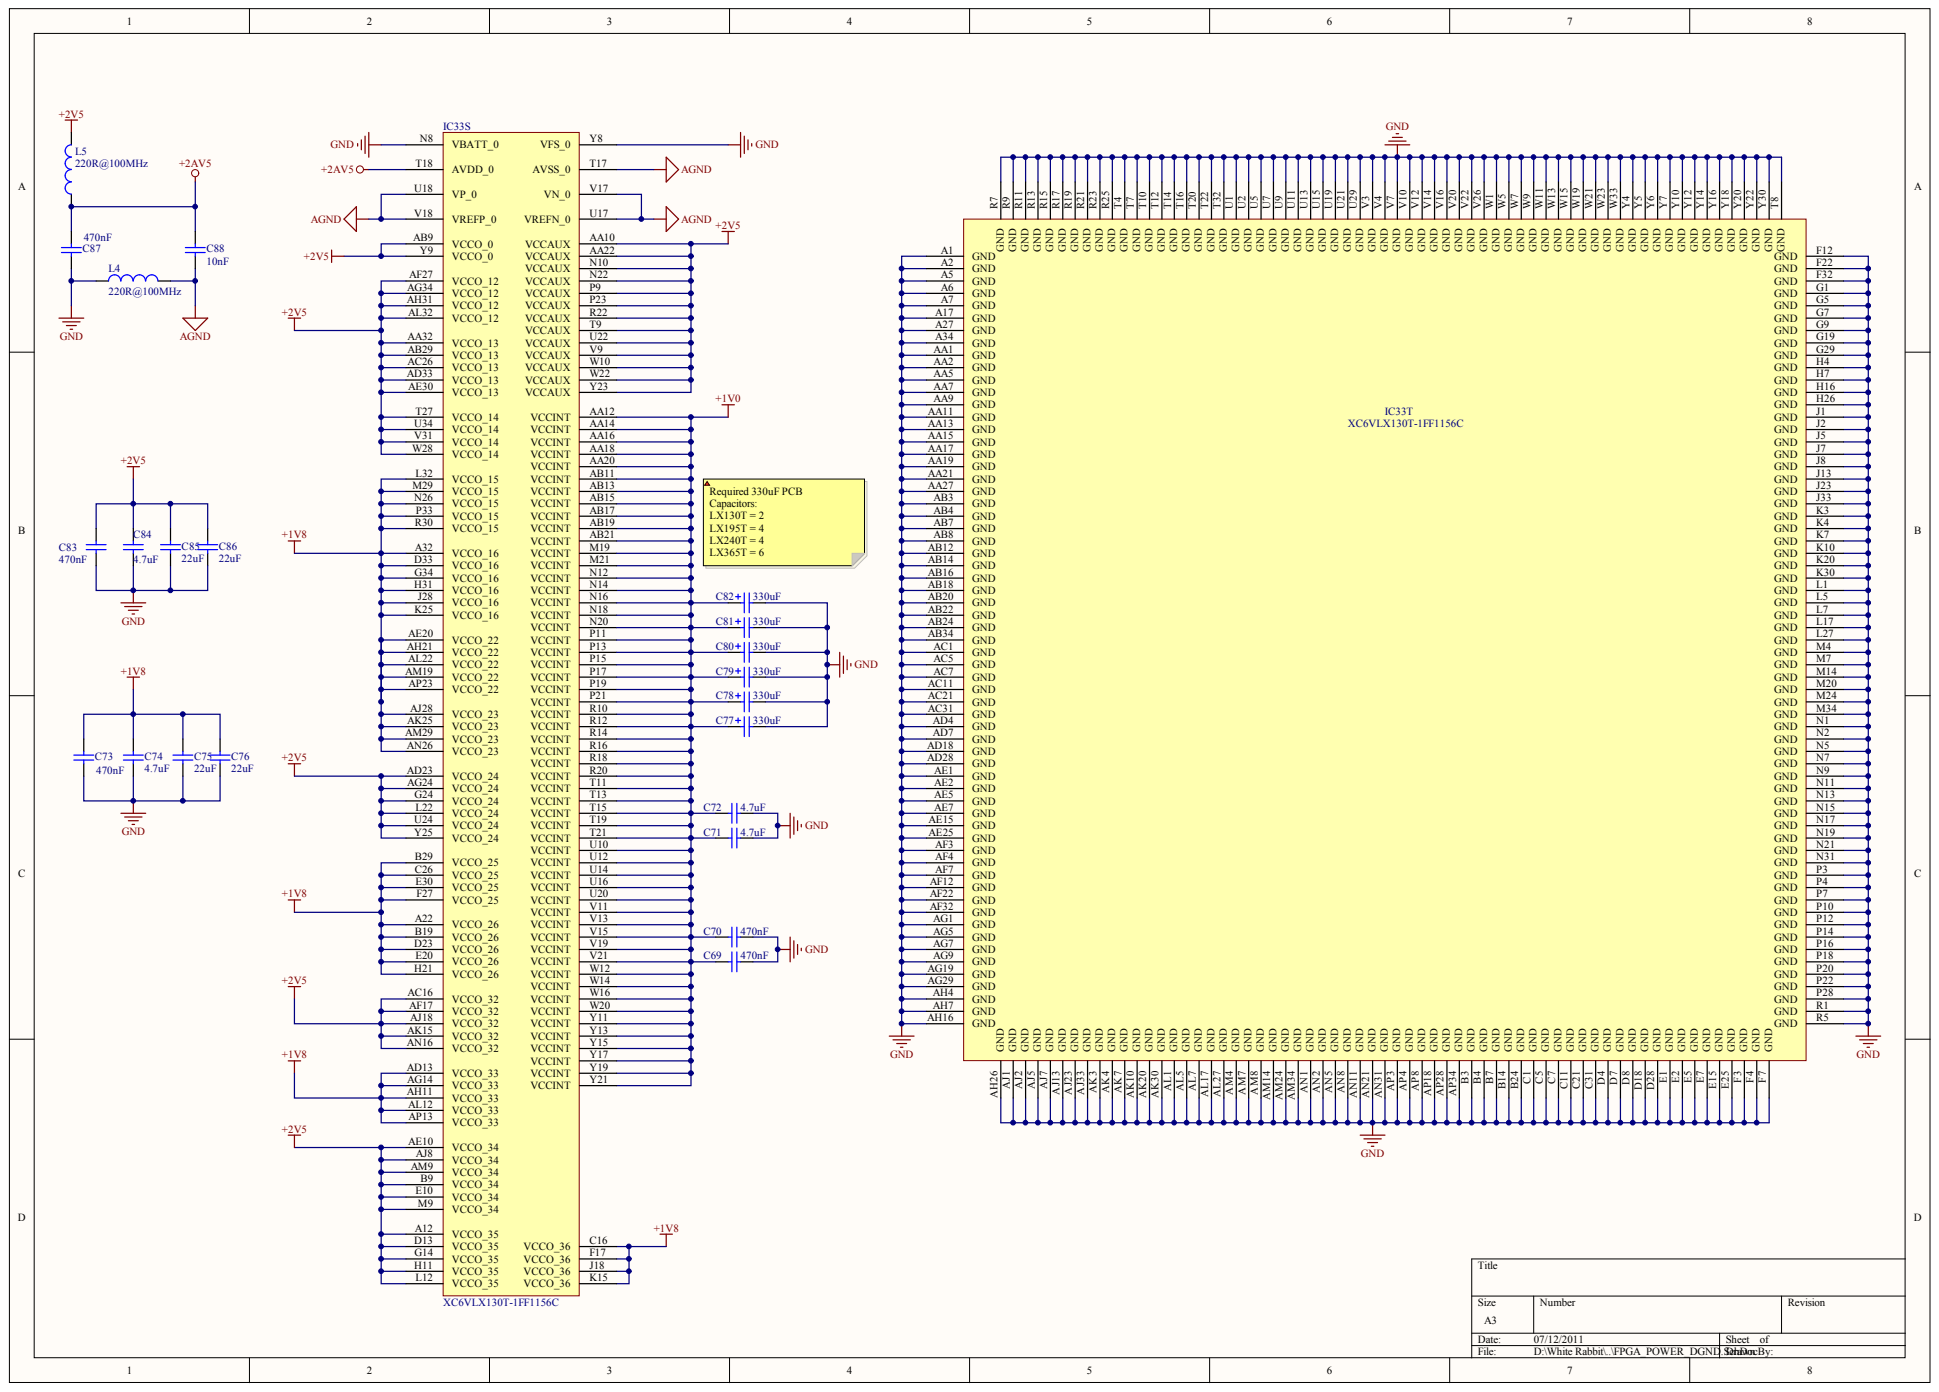
[picture p37: page 12]

AA9 | 6
AA 1 1

AL 1 2
AP 1 3

AJ 8
AM9

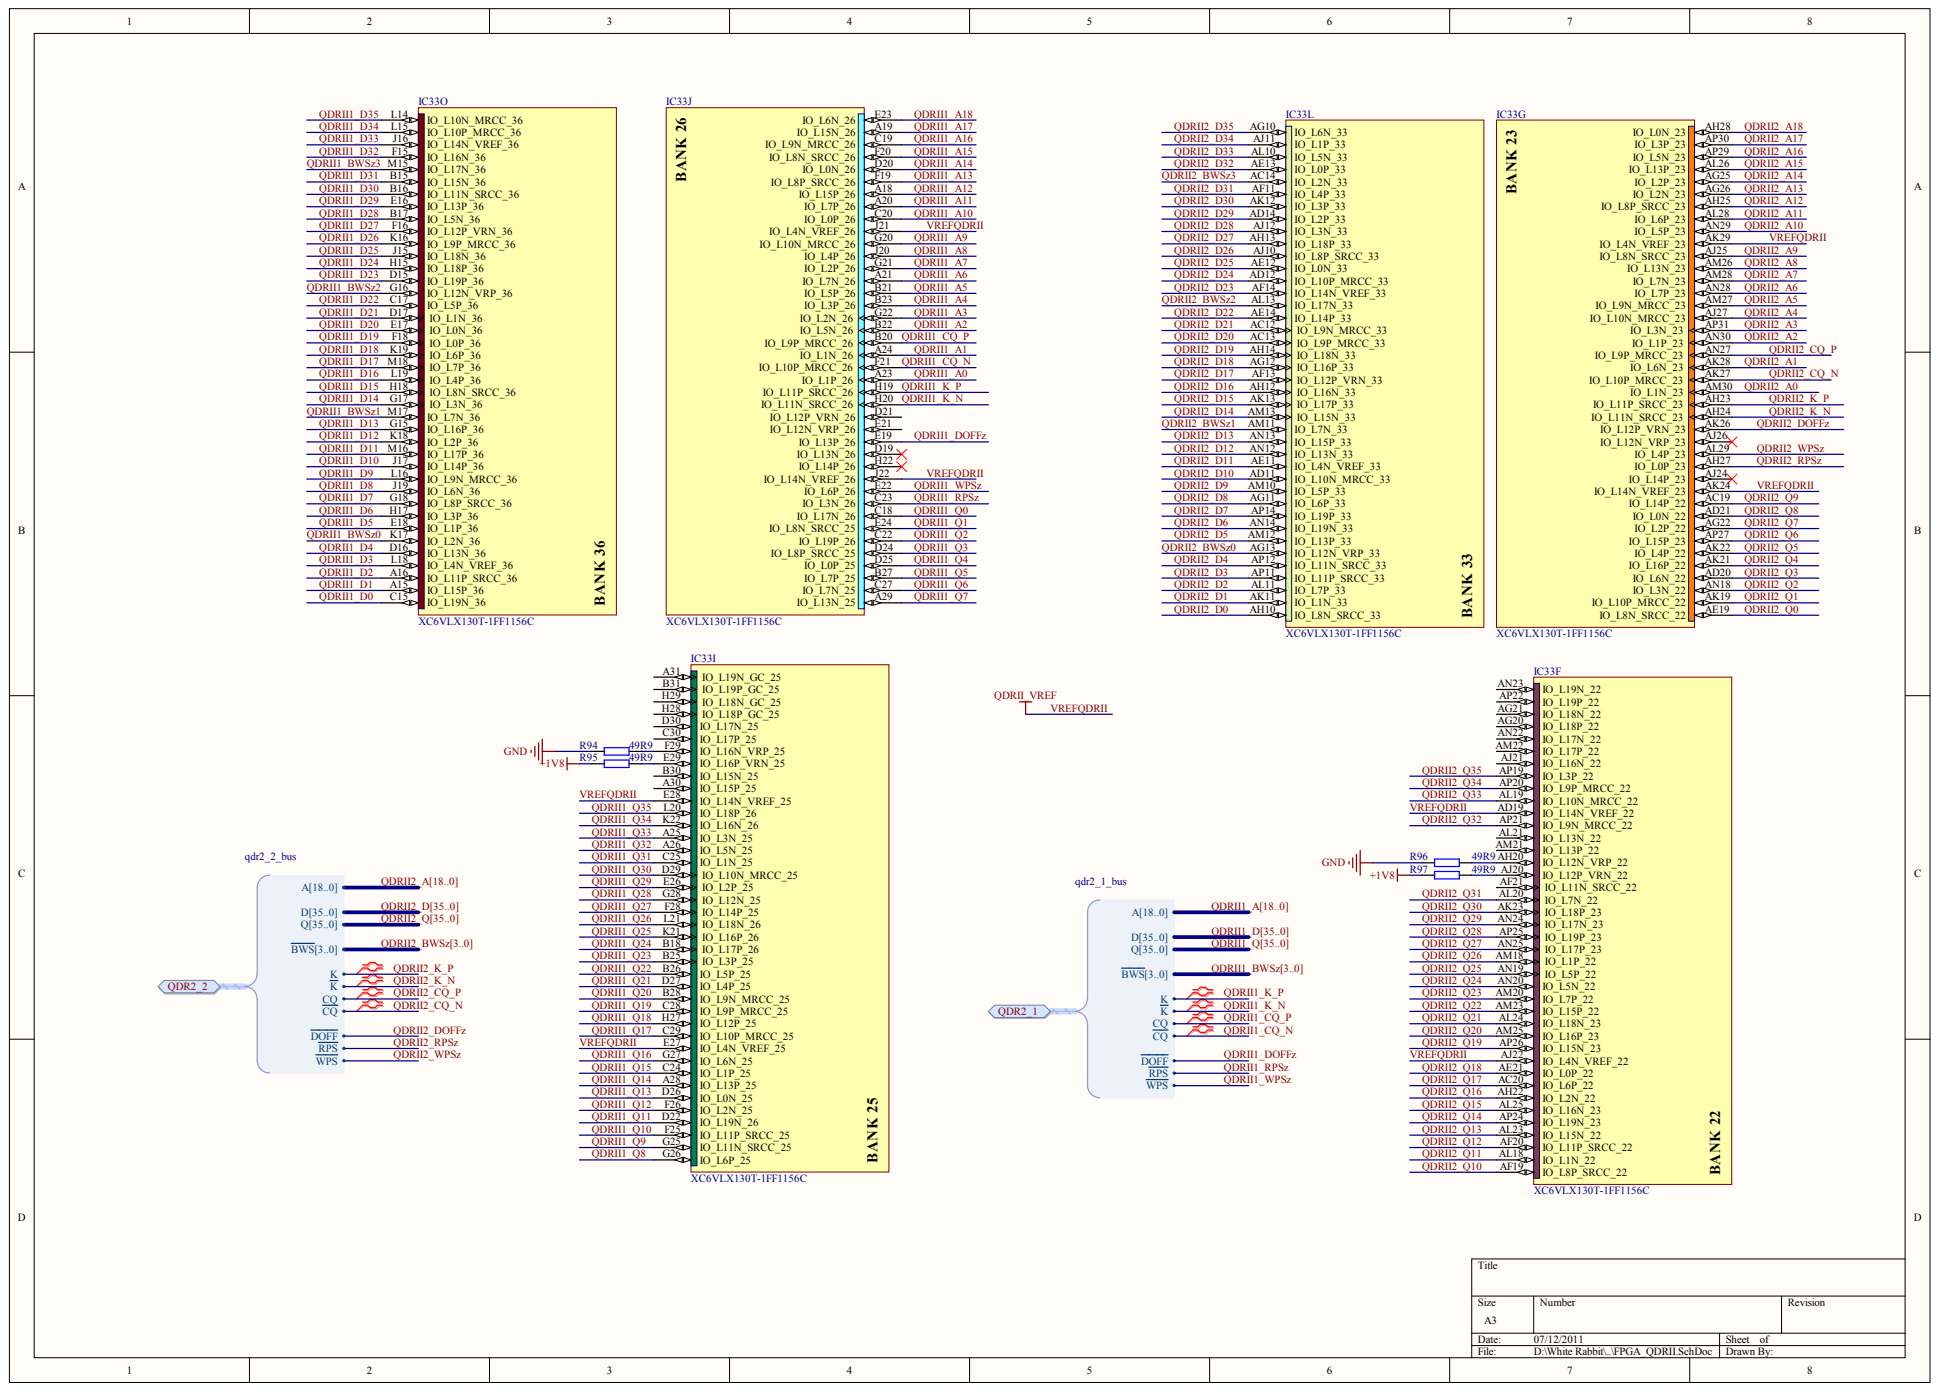
[picture p38: page 13]

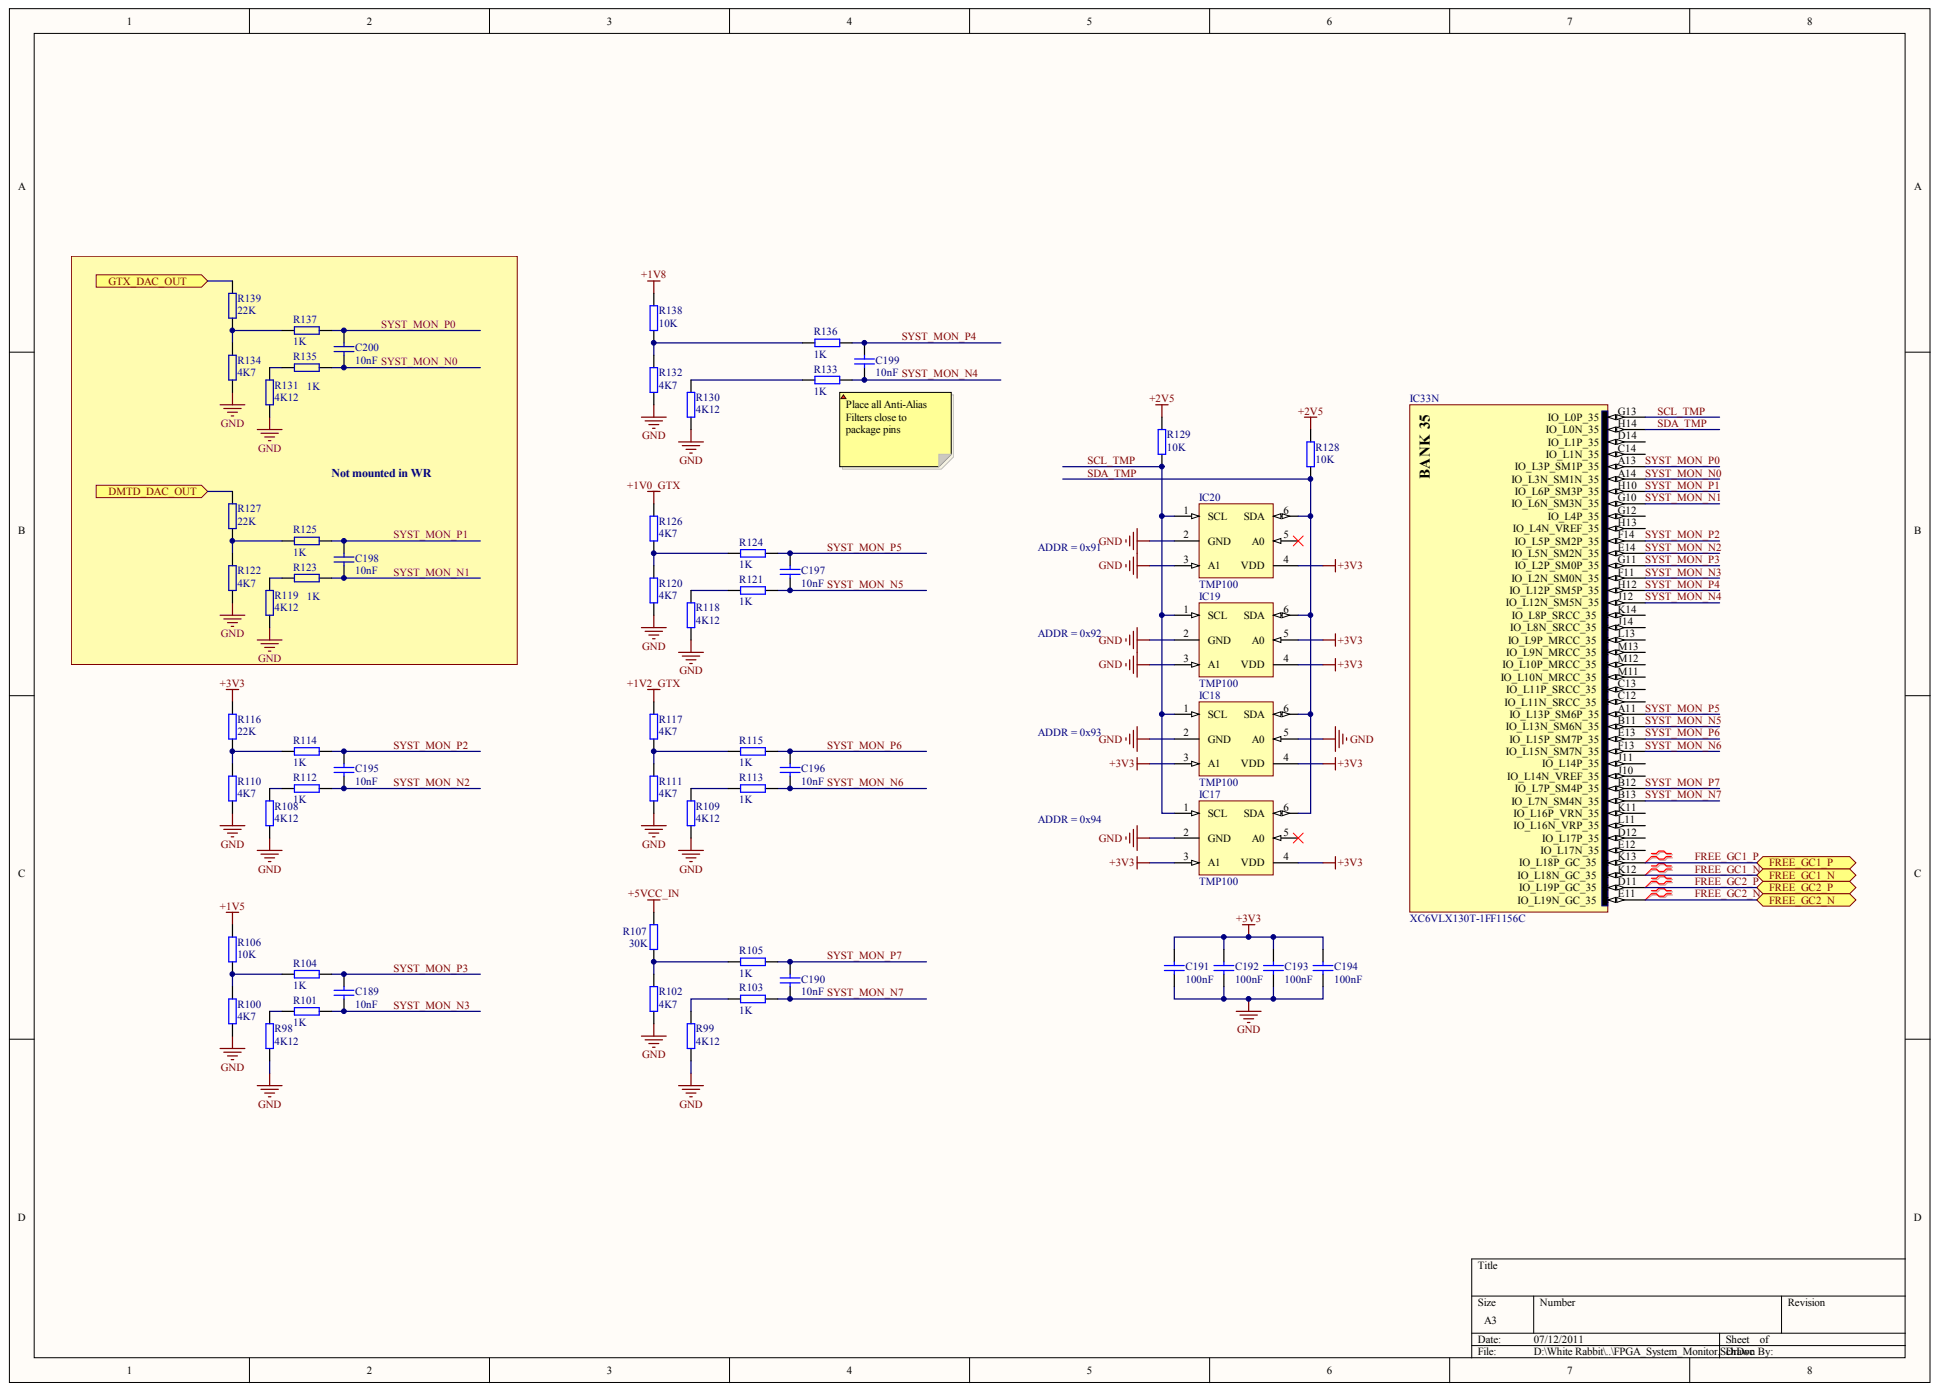
[picture p39: page 14]

2 | GND A0 A 1 VDD | 5

4GND GND GND GND GND GND

SDr chDo awnc By

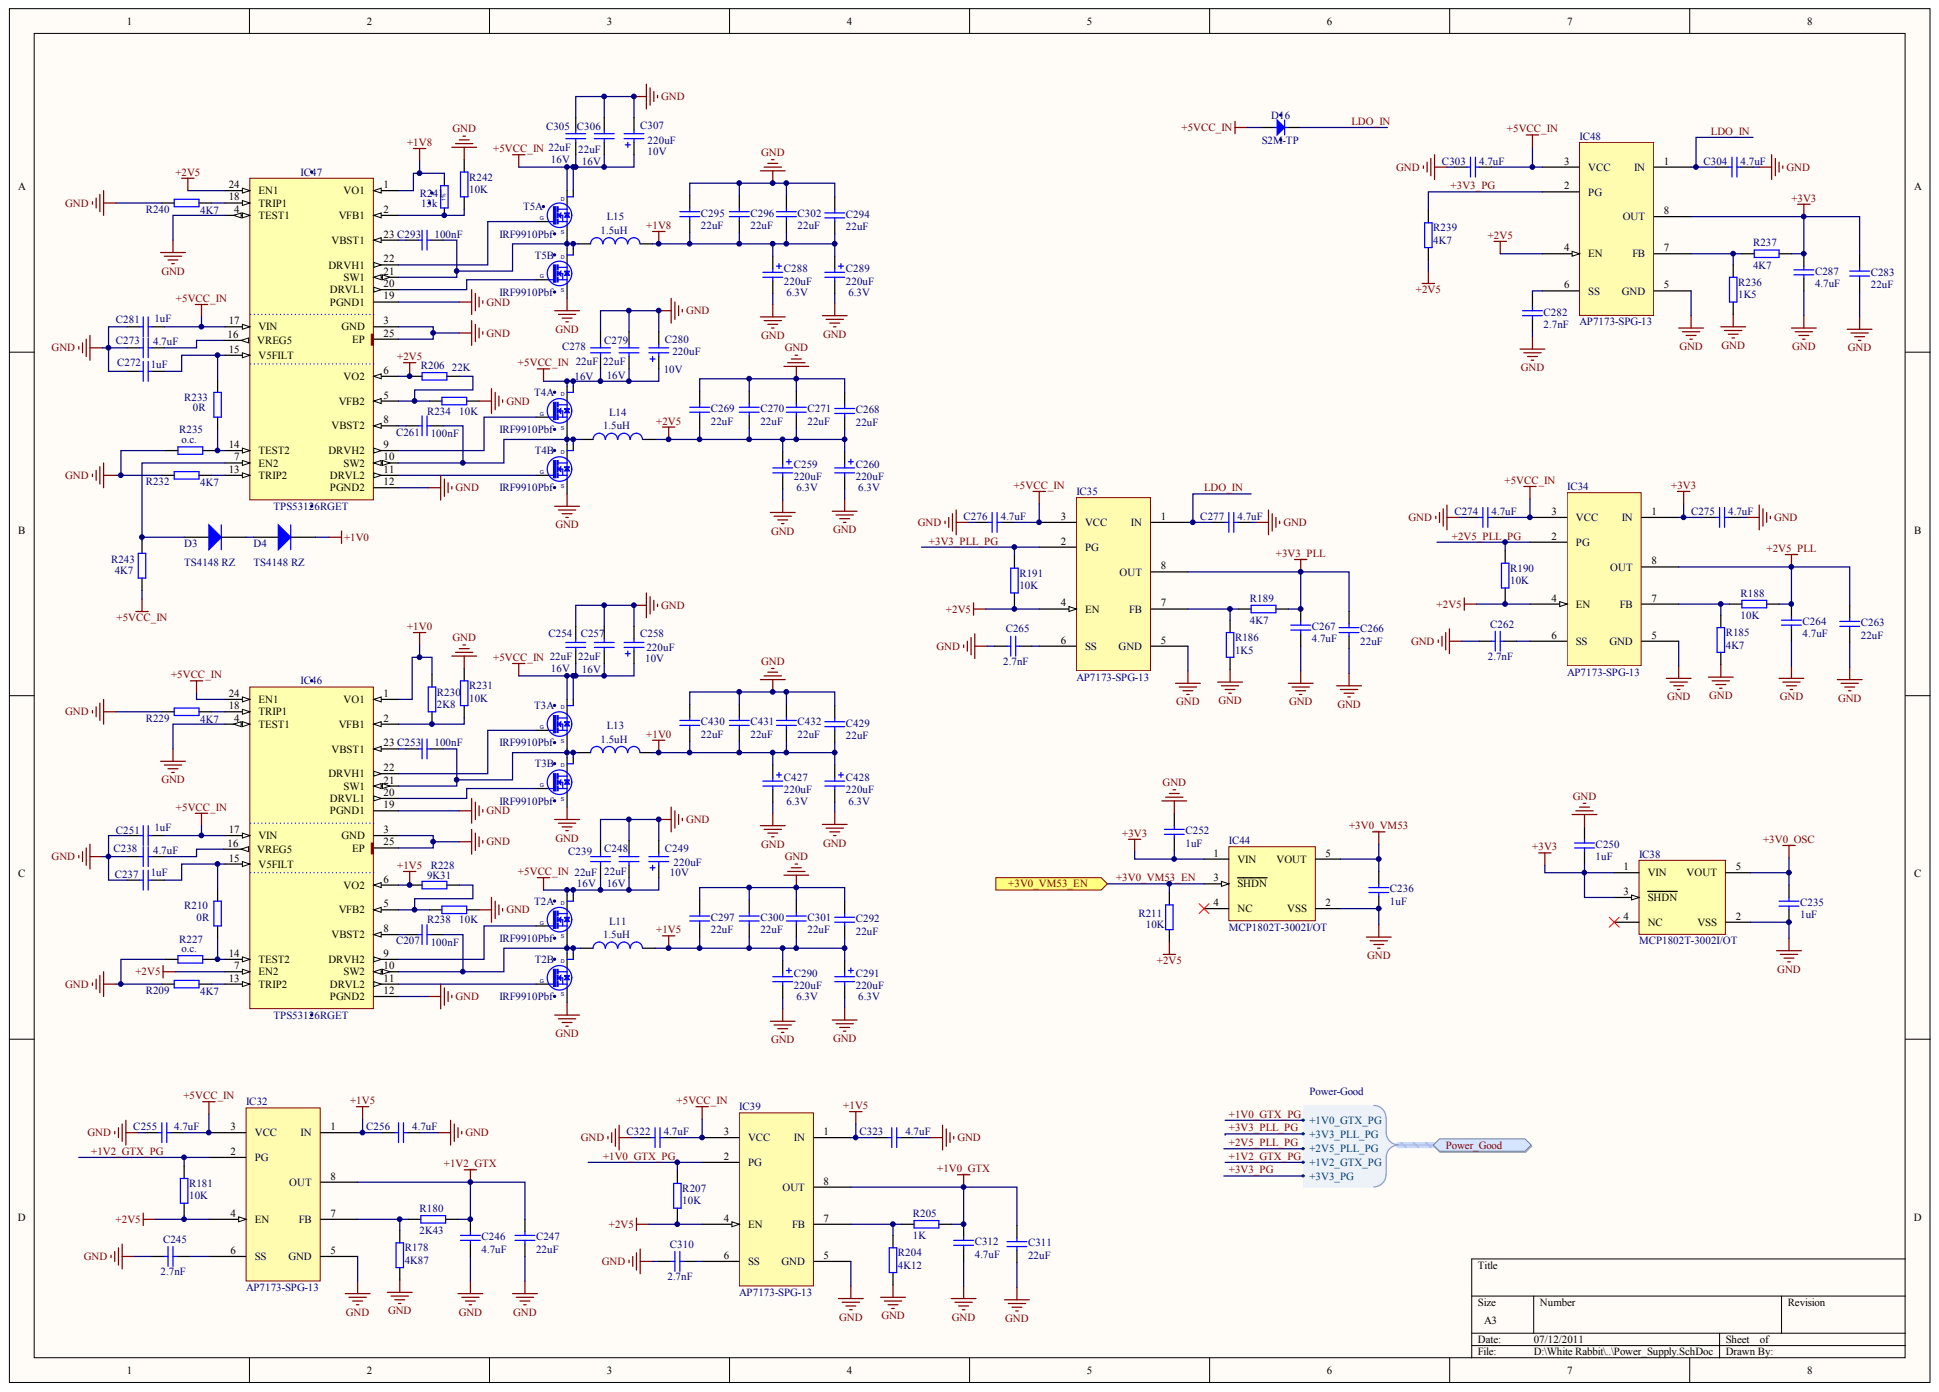
[picture p40: page 15]

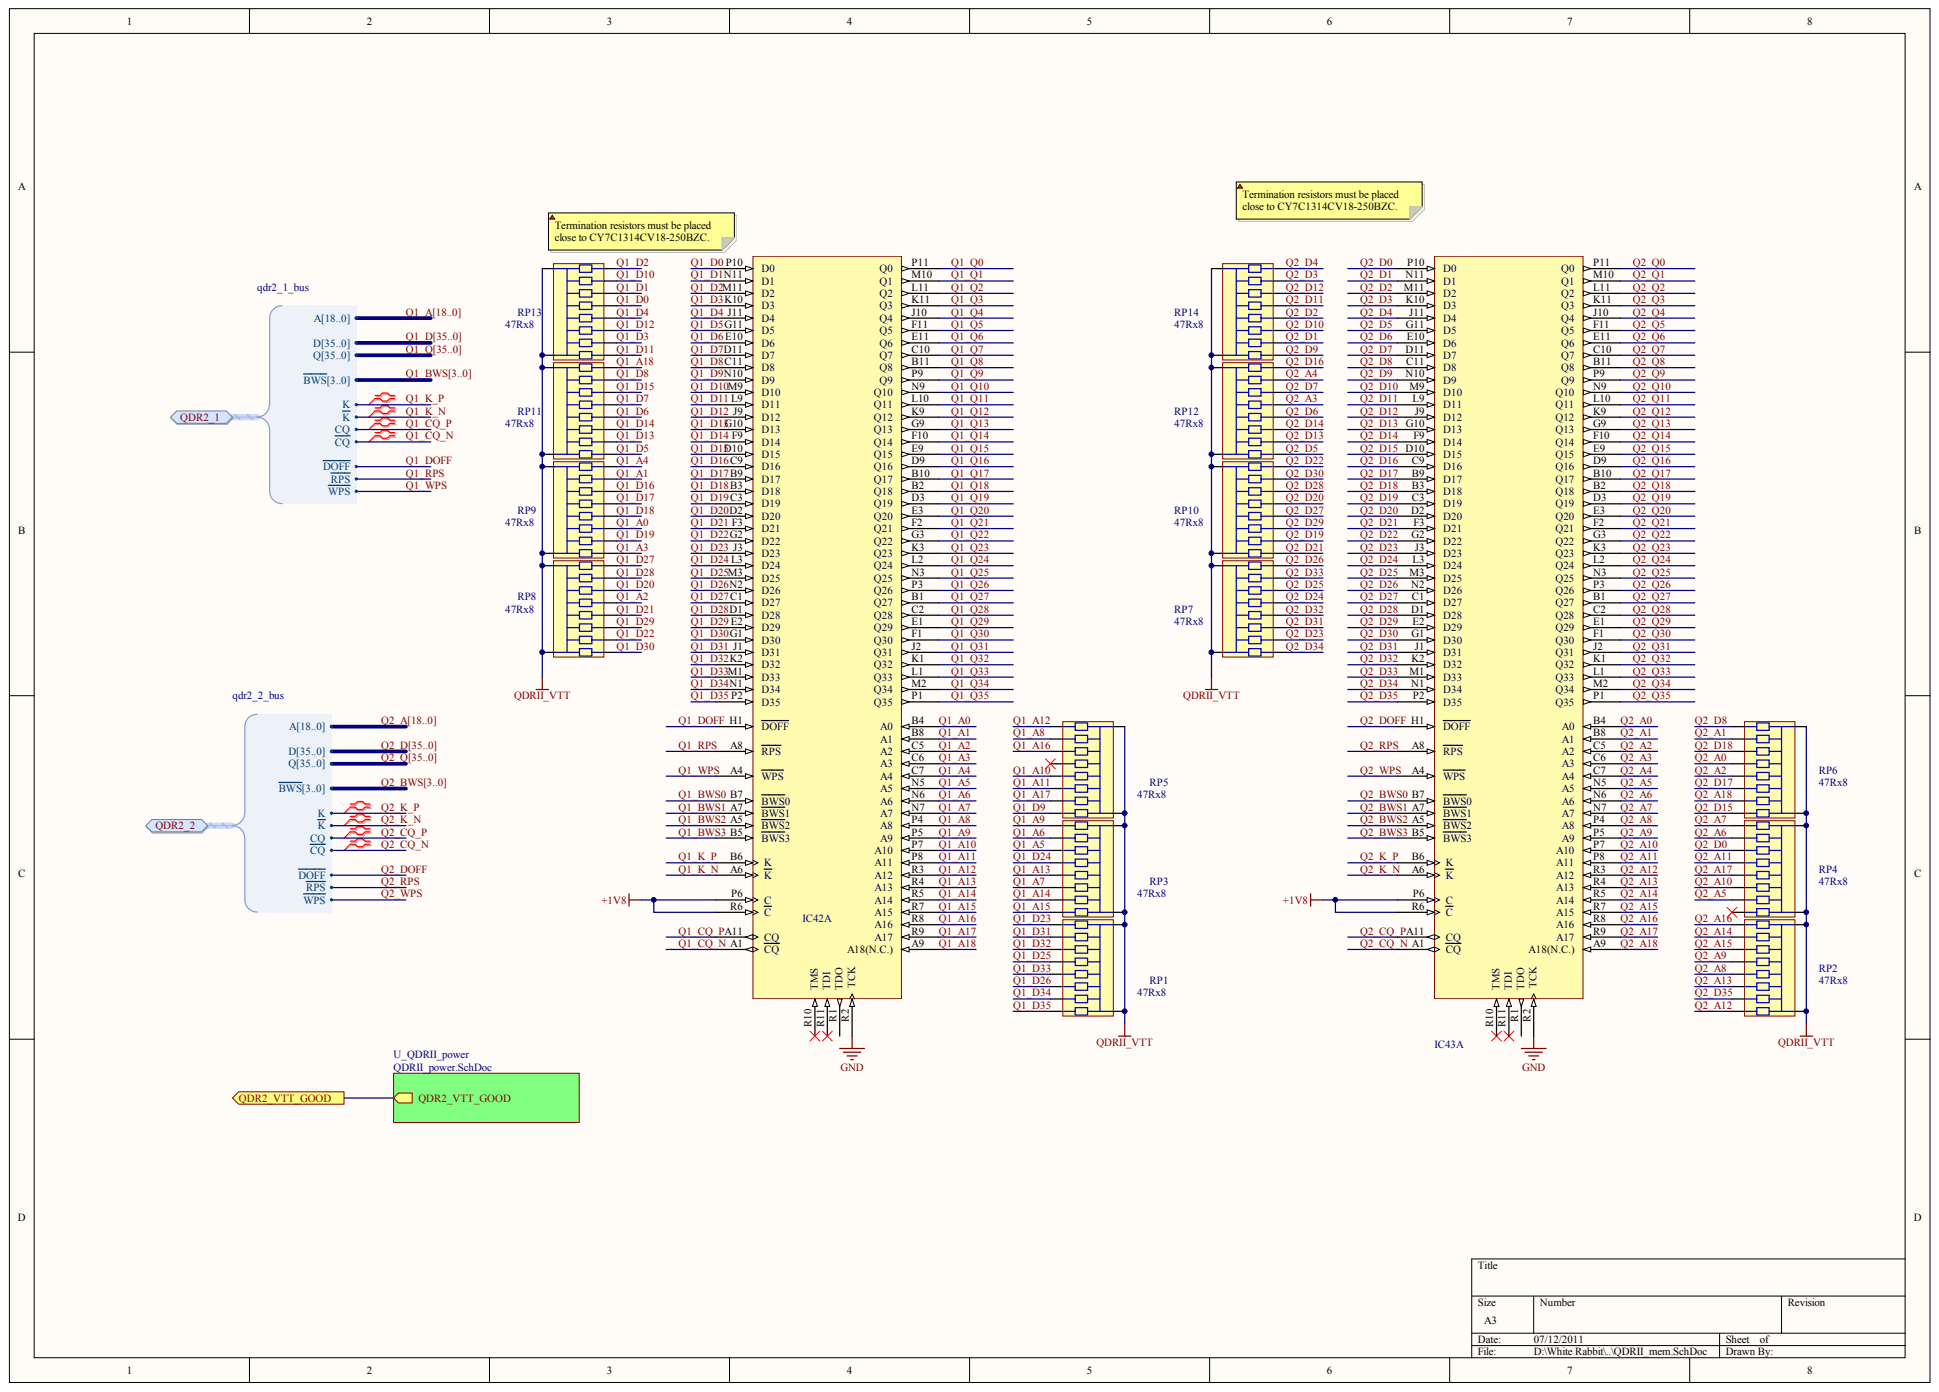
[picture p41: page 16]

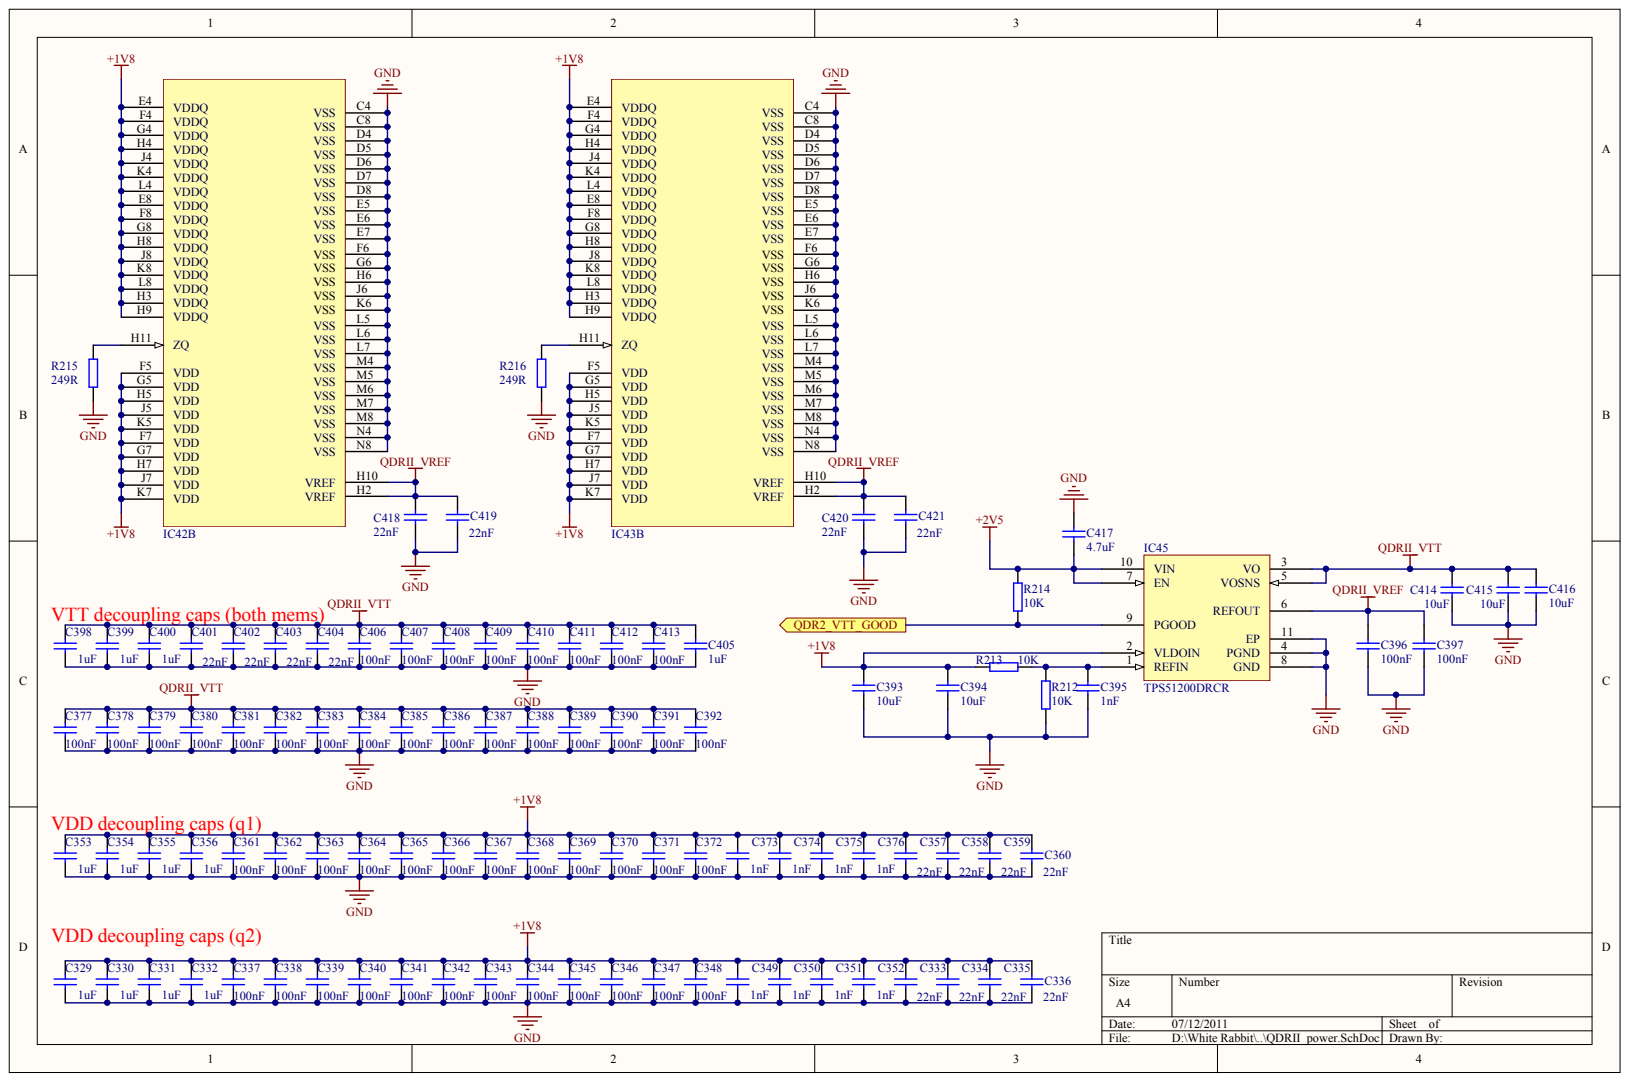
[picture p42: page 17]

VTT decoupling caps (both mems)

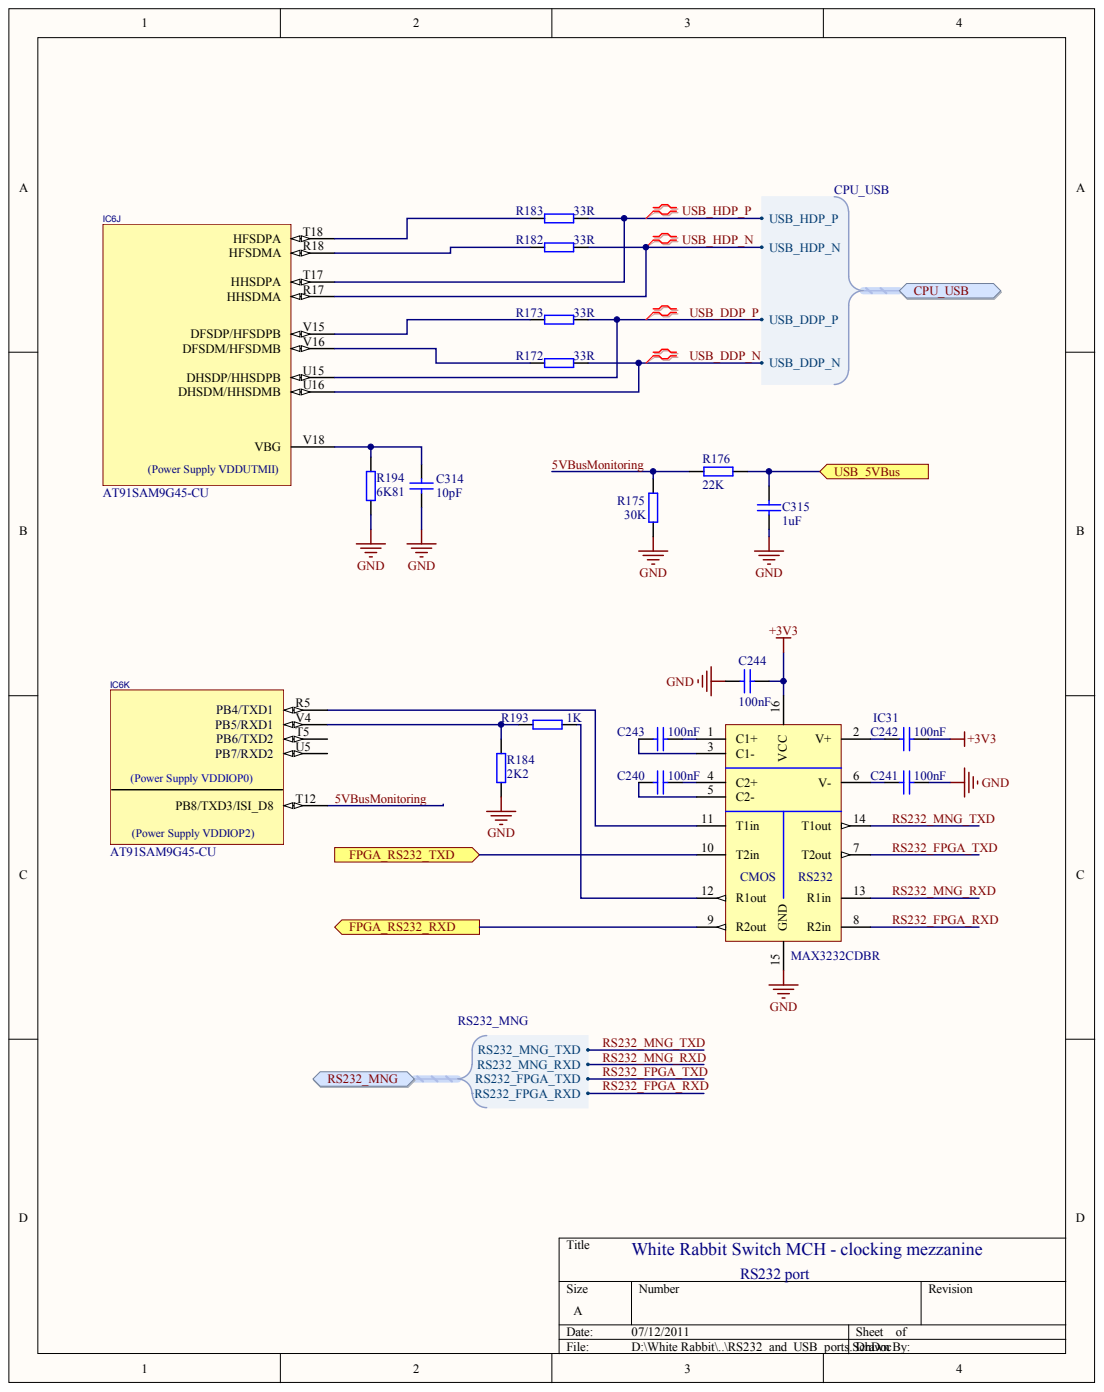
[picture p43: page 18]

White Rabbit Switch MCH - clocking mezzanine

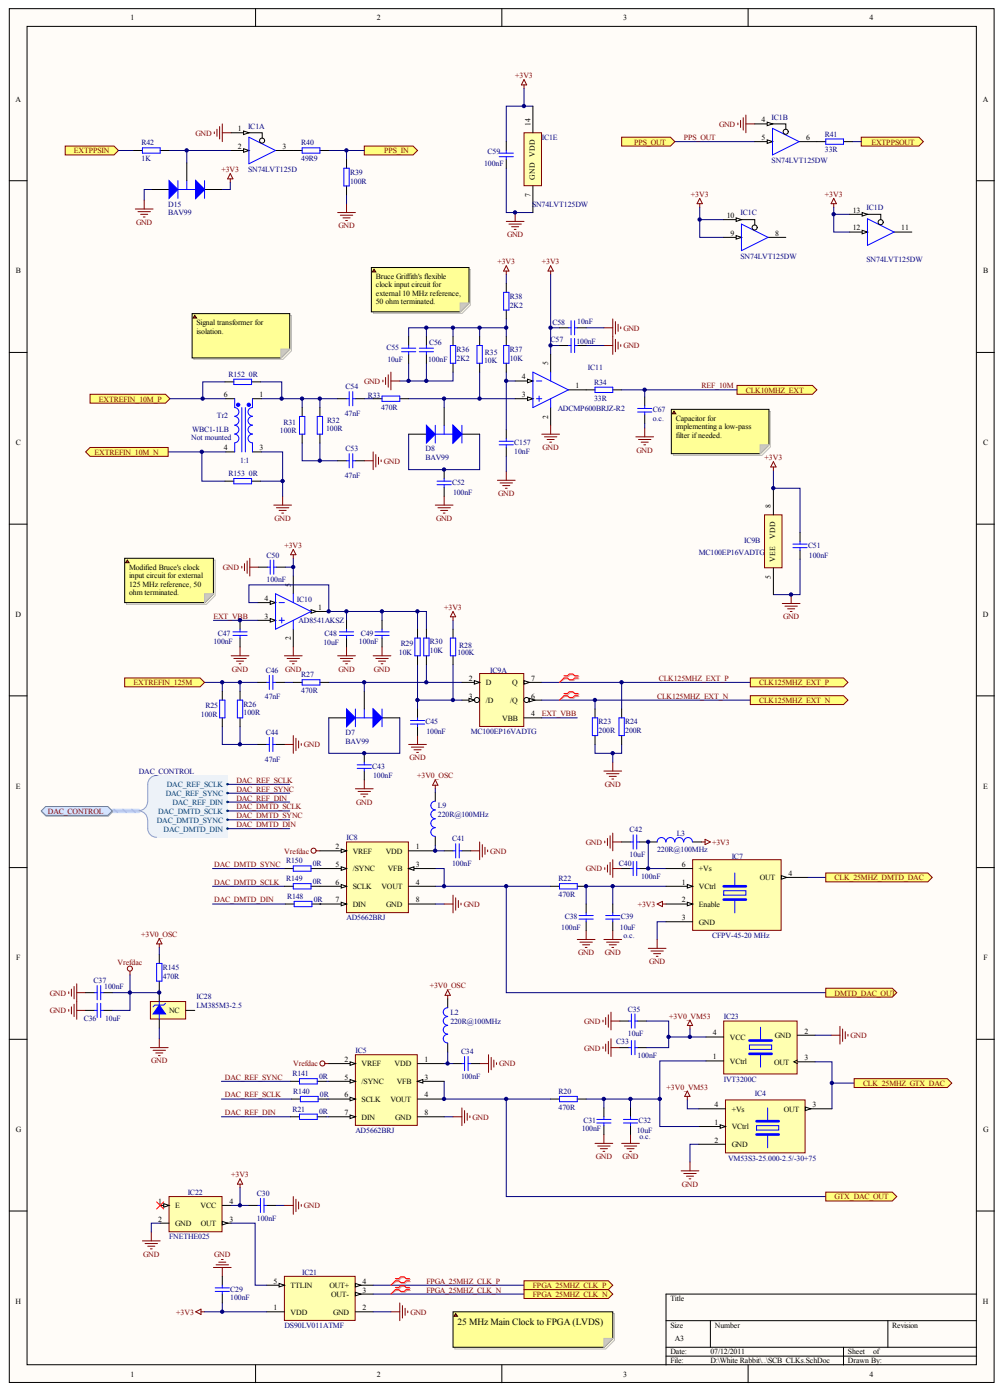
[picture p44: page 19]

Bruce Griffith's flexible
clock input circuit for
external 10 MHz reference,
50 ohm terminated.

Modified Bruce's clock
input circuit for external
125 MHz reference, 50
ohm terminated.

25 MHz Main Clock to FPGA (LVDS)

File: D:\White Rabbit\..\SCB_CLKs.SchDoc | Drawn By:

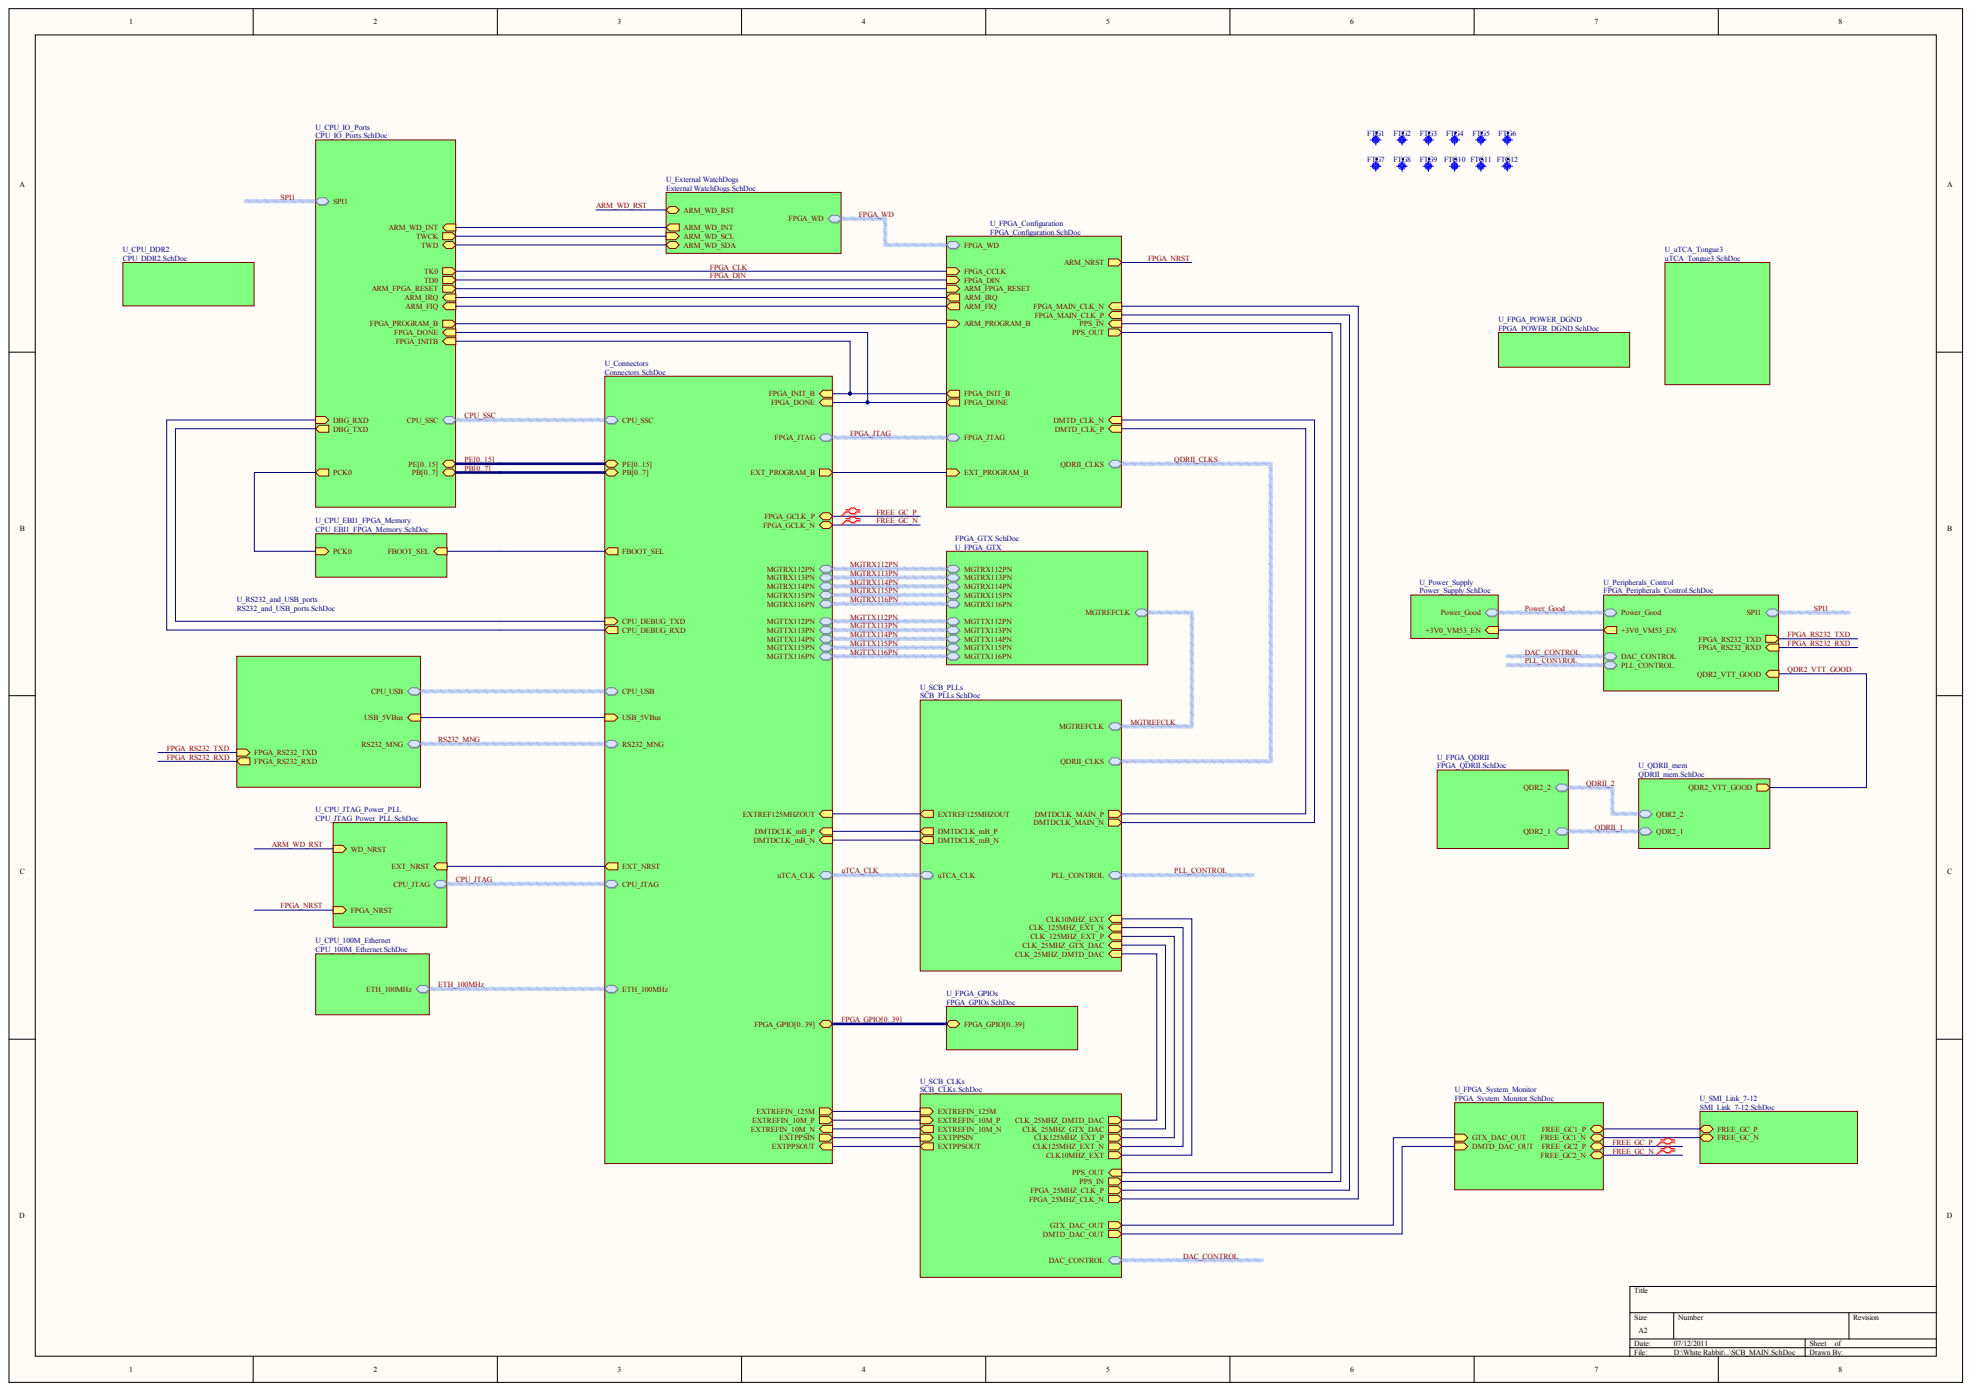
[picture p45: page 20]

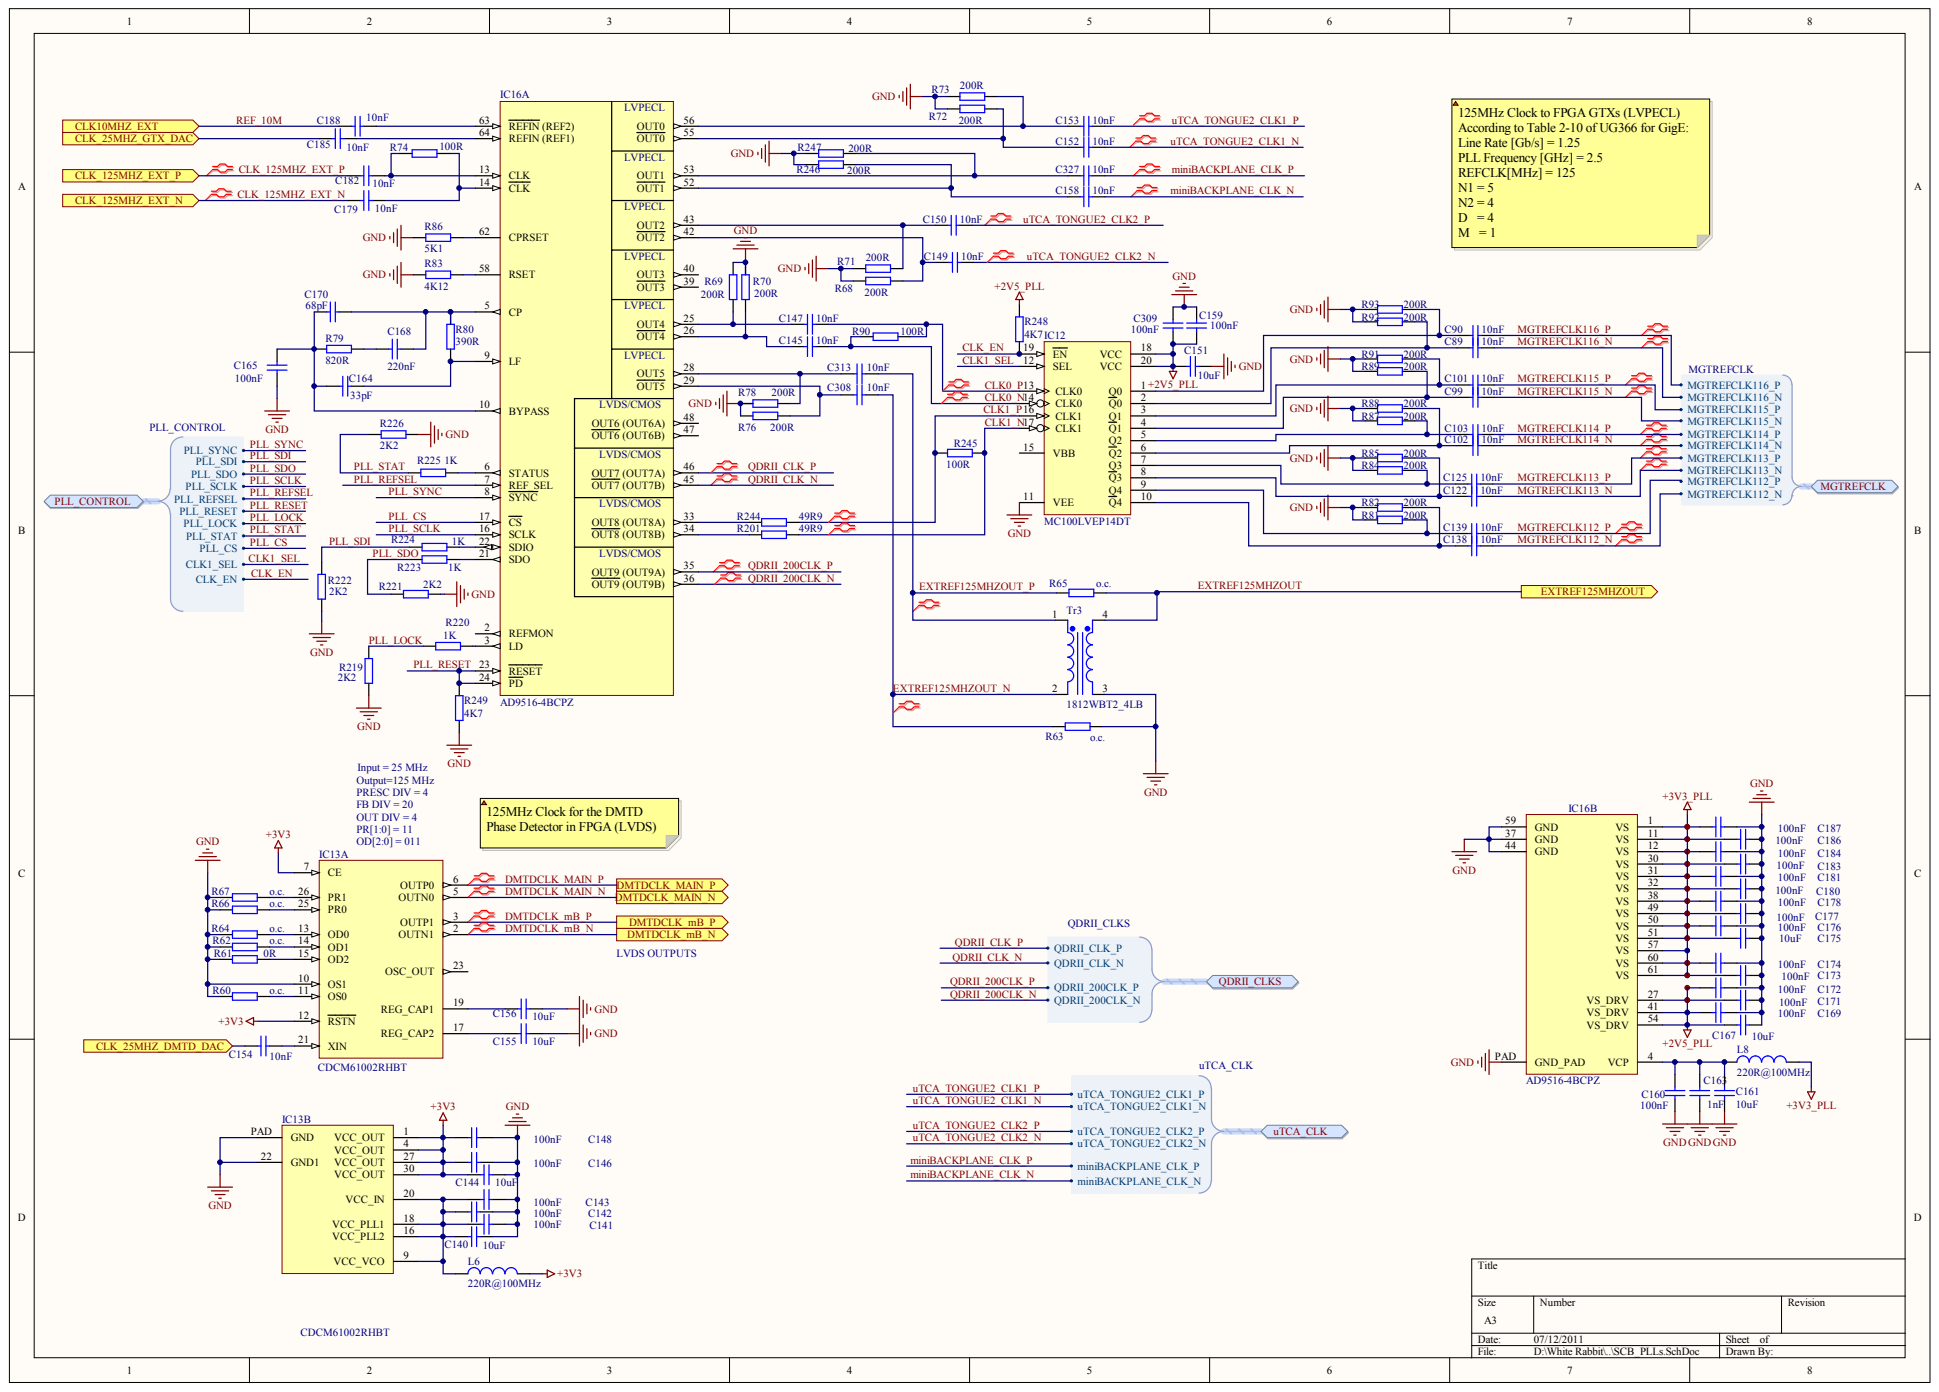
[picture p46: page 21]

REFIN (REF2) 63 | LVPECL OUT0
REFIN (REF1) 64 | 55 OUT0 56

125MHz Clock to FPGA GTXs (LVPECL)
According to Table 2-10 of UG366 for GigE:
Line Rate [Gb/s] = 1.25
PLL Frequency [GHz] = 2.5
REFCLK[MHz] = 125

220nF | BYPASS 10

C308 | 10nF | CLK0_P | CLK0 13

125MHz Clock for the DMTD
Phase Detector in FPGA (LVDS)

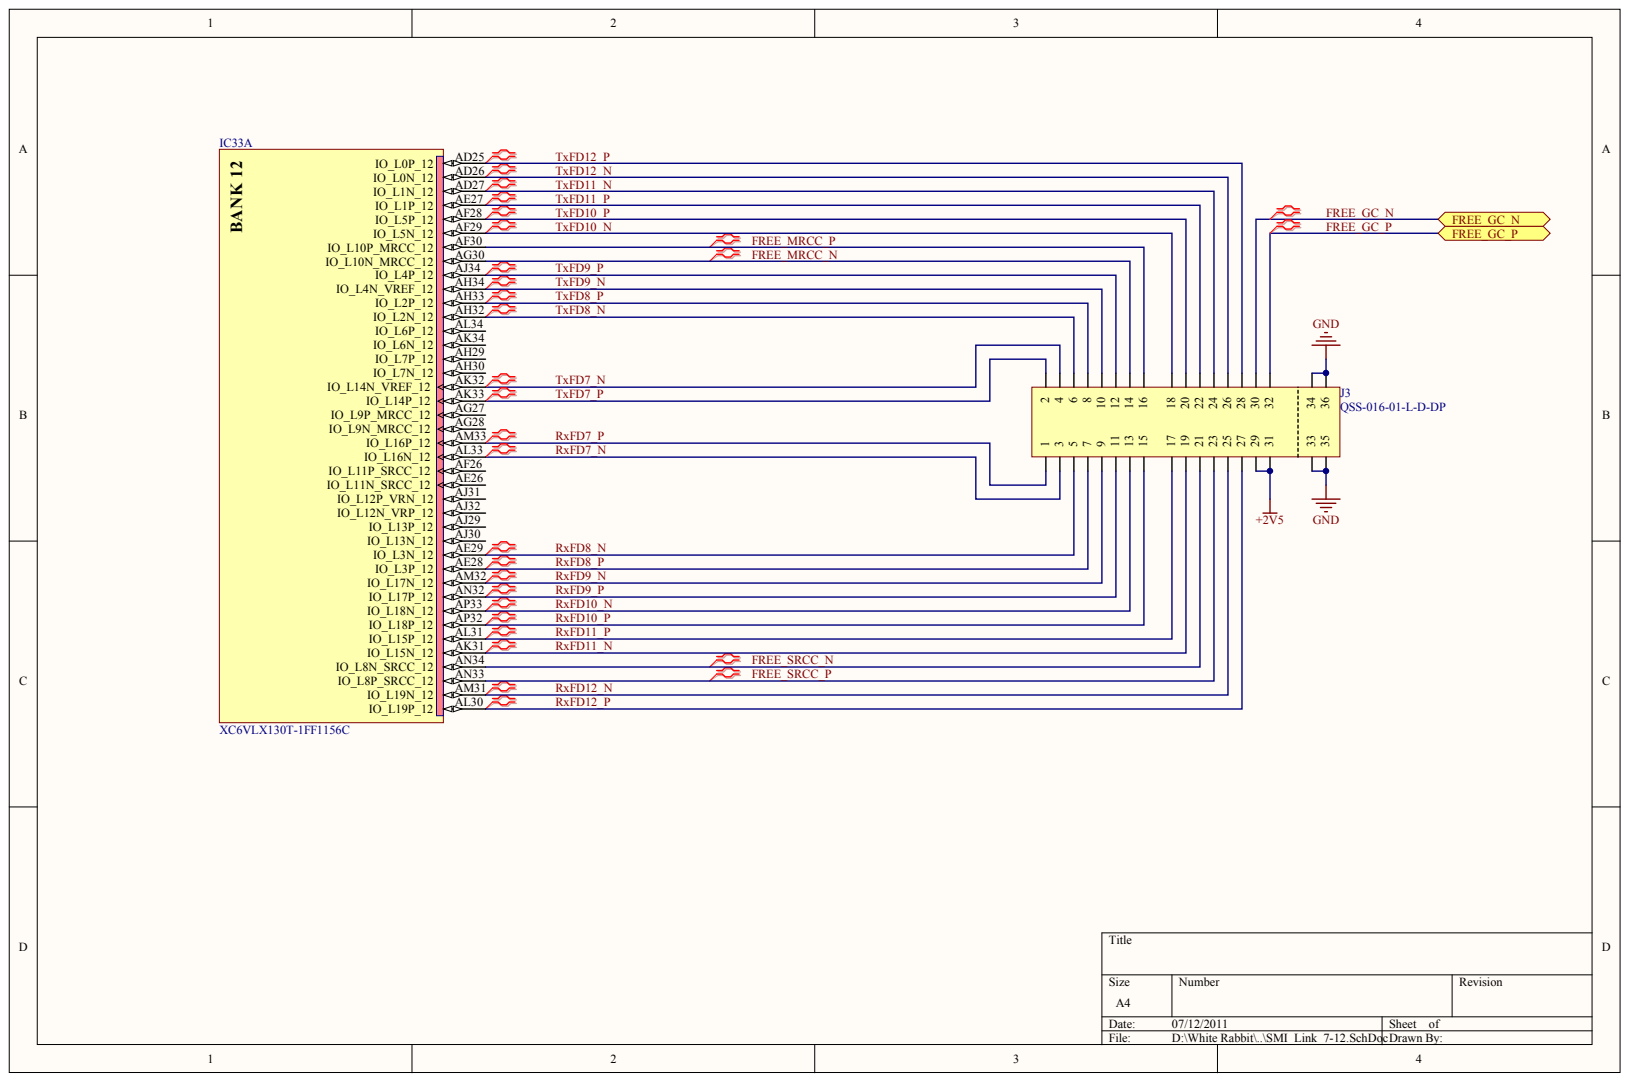
[picture p47: page 22]

AD2 6 | Tx FD12_N
AD2 7 | Tx FD11_N
AE27 | Tx FD11_P
A F28 | Tx FD10_P
A F29 | Tx FD10_N

AG3 0
AJ34 | Tx FD9_ P
AH3 4 | Tx FD9_N
AH3 3 | Tx FD8_ P
AH3 2 | Tx FD8_N
AL34

AH2 9
AH3 0
AK3 2 | Tx FD7_N
AK3 3 | Tx FD7_ P

AL33 | Rx FD7_N
A F26
AE26

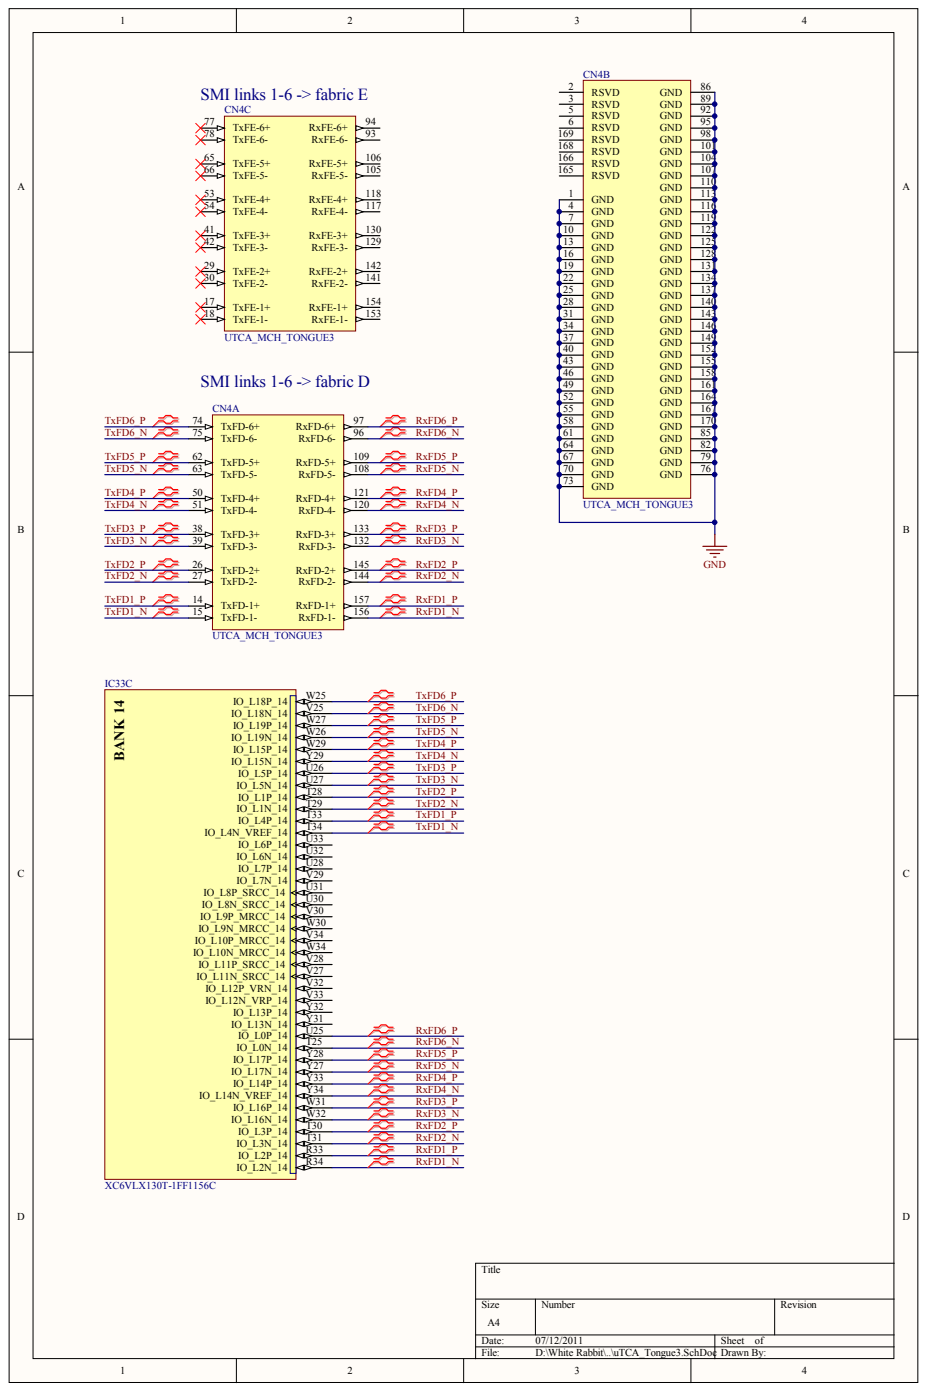
[picture p48: page 23]
