Reedgarden/WRS-HW/circuit_board/wrs_v3/mini_backplane_simple/mini_backplane_simple.pdf

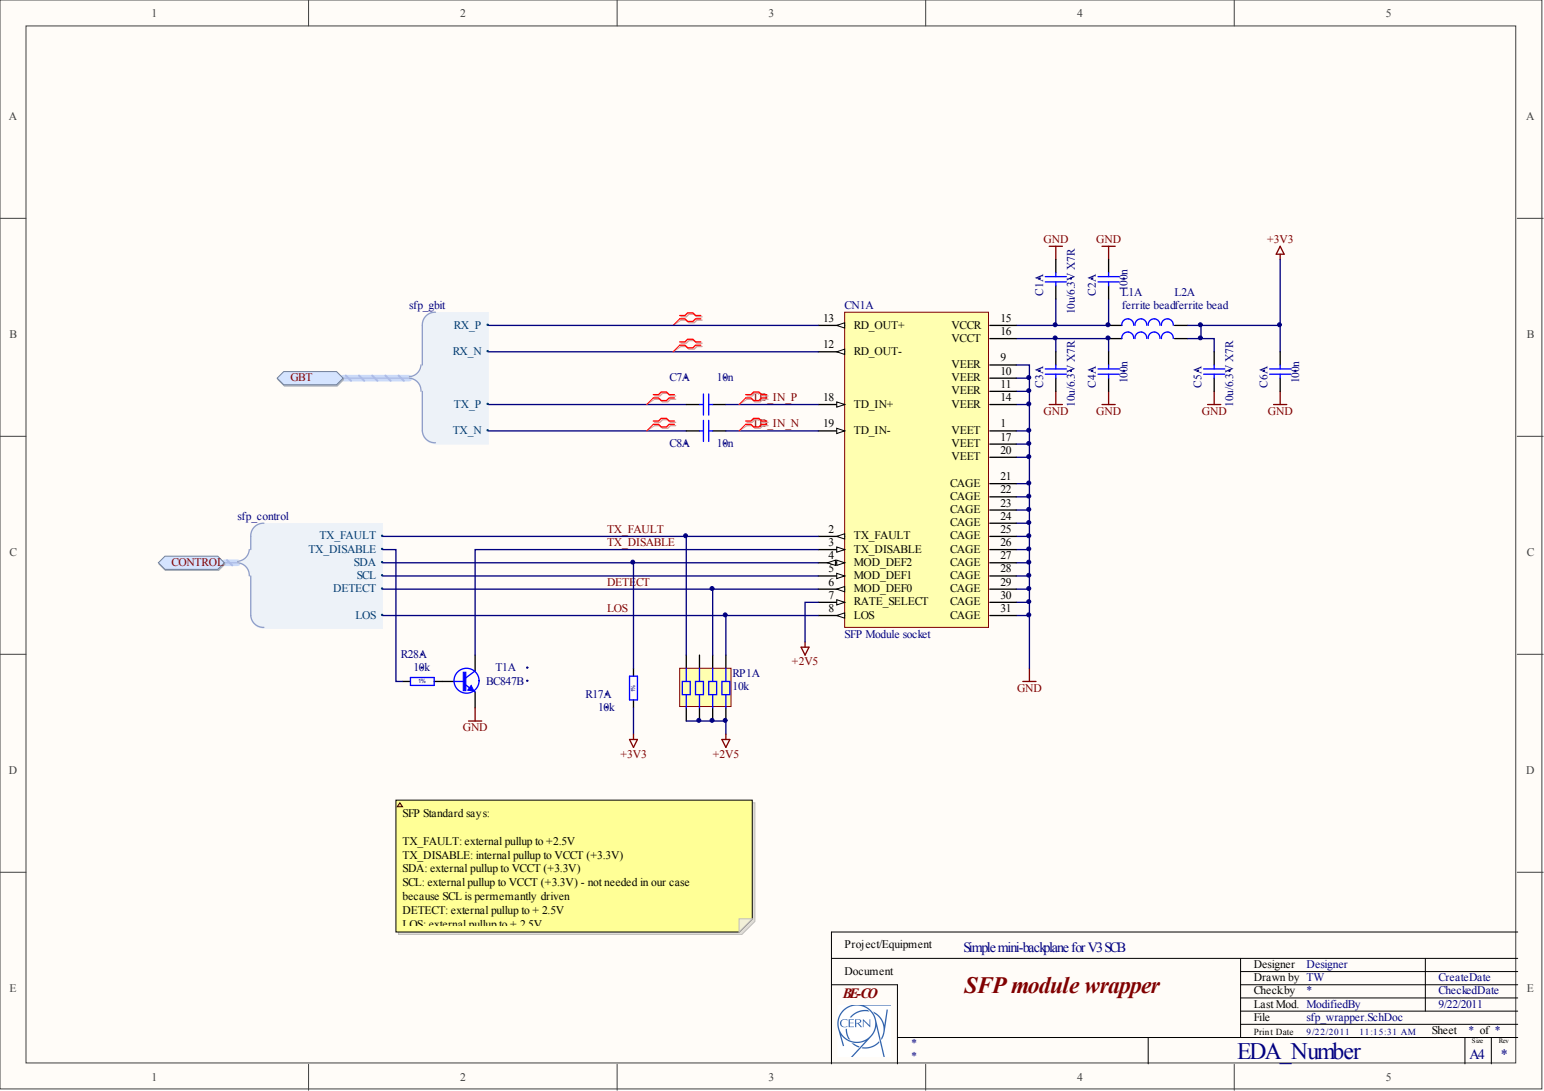
[picture p49: page 1]

TX_FAULT: external pullup to +2.5V
TX_DISABLE: internal pullup to VCCT (+3.3V)
SDA: external pullup to VCCT (+3.3V)
SCL: external pullup to VCCT (+3.3V) - not needed in our case
because SCL is permemantly driven
DETECT: external pullup to + 2.5V
LOS: external pullup to + 2.5V

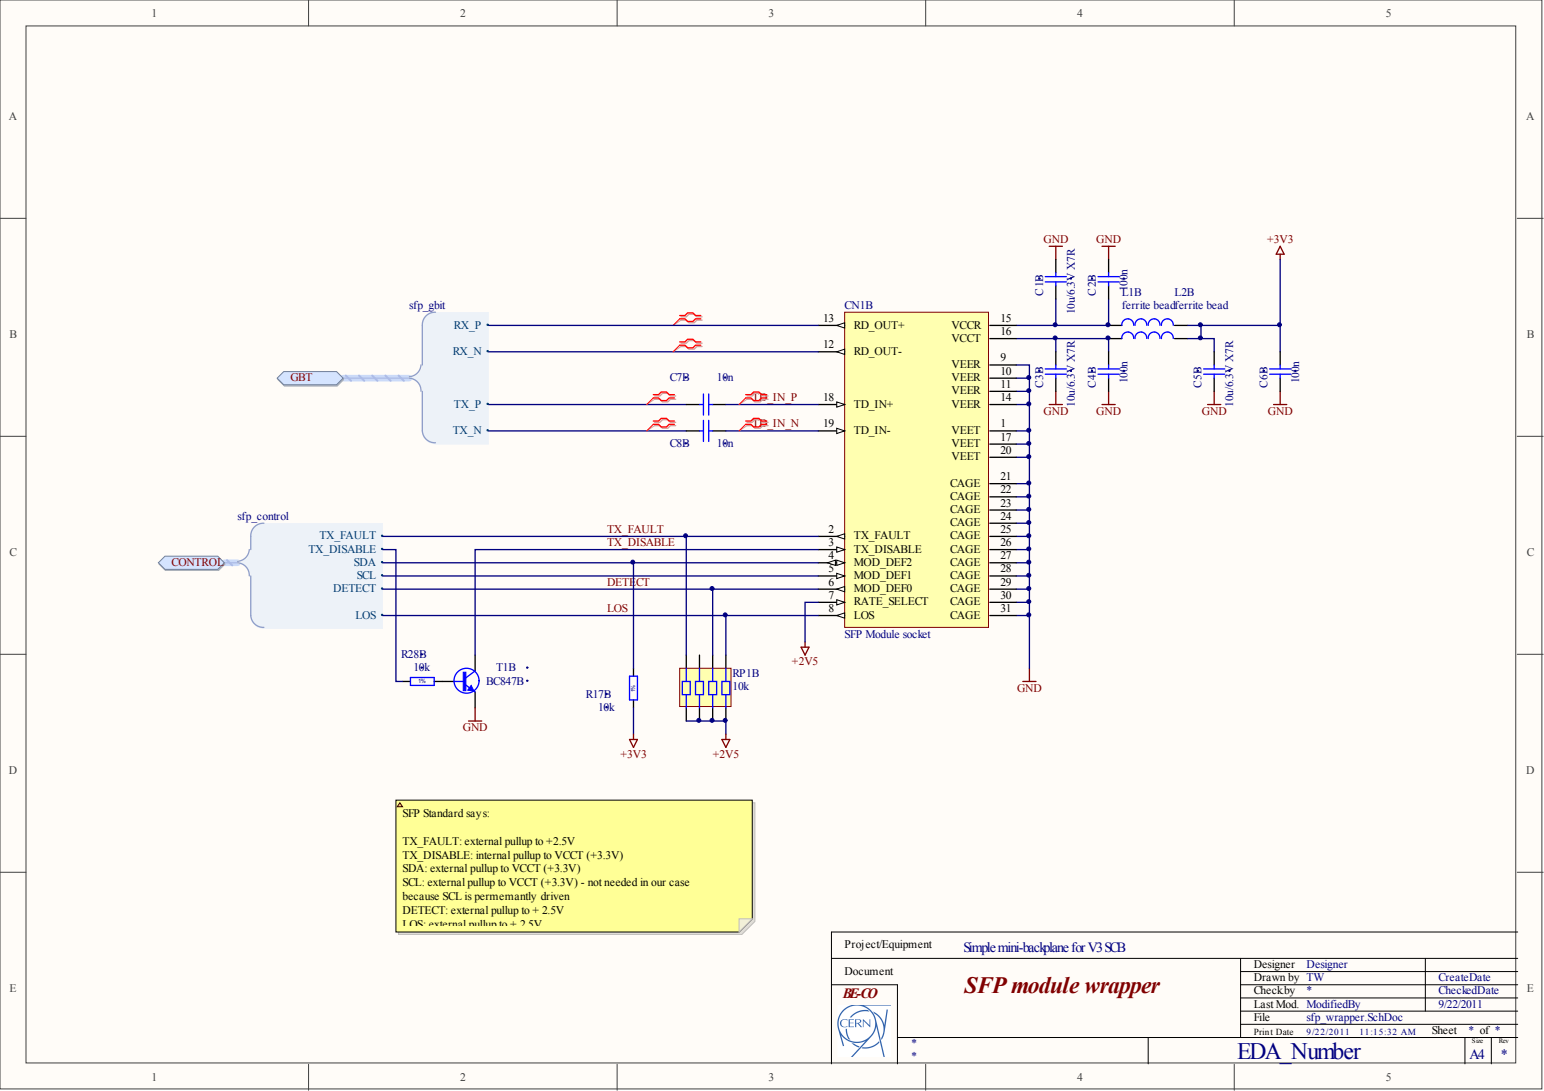
[picture p50: page 2]
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

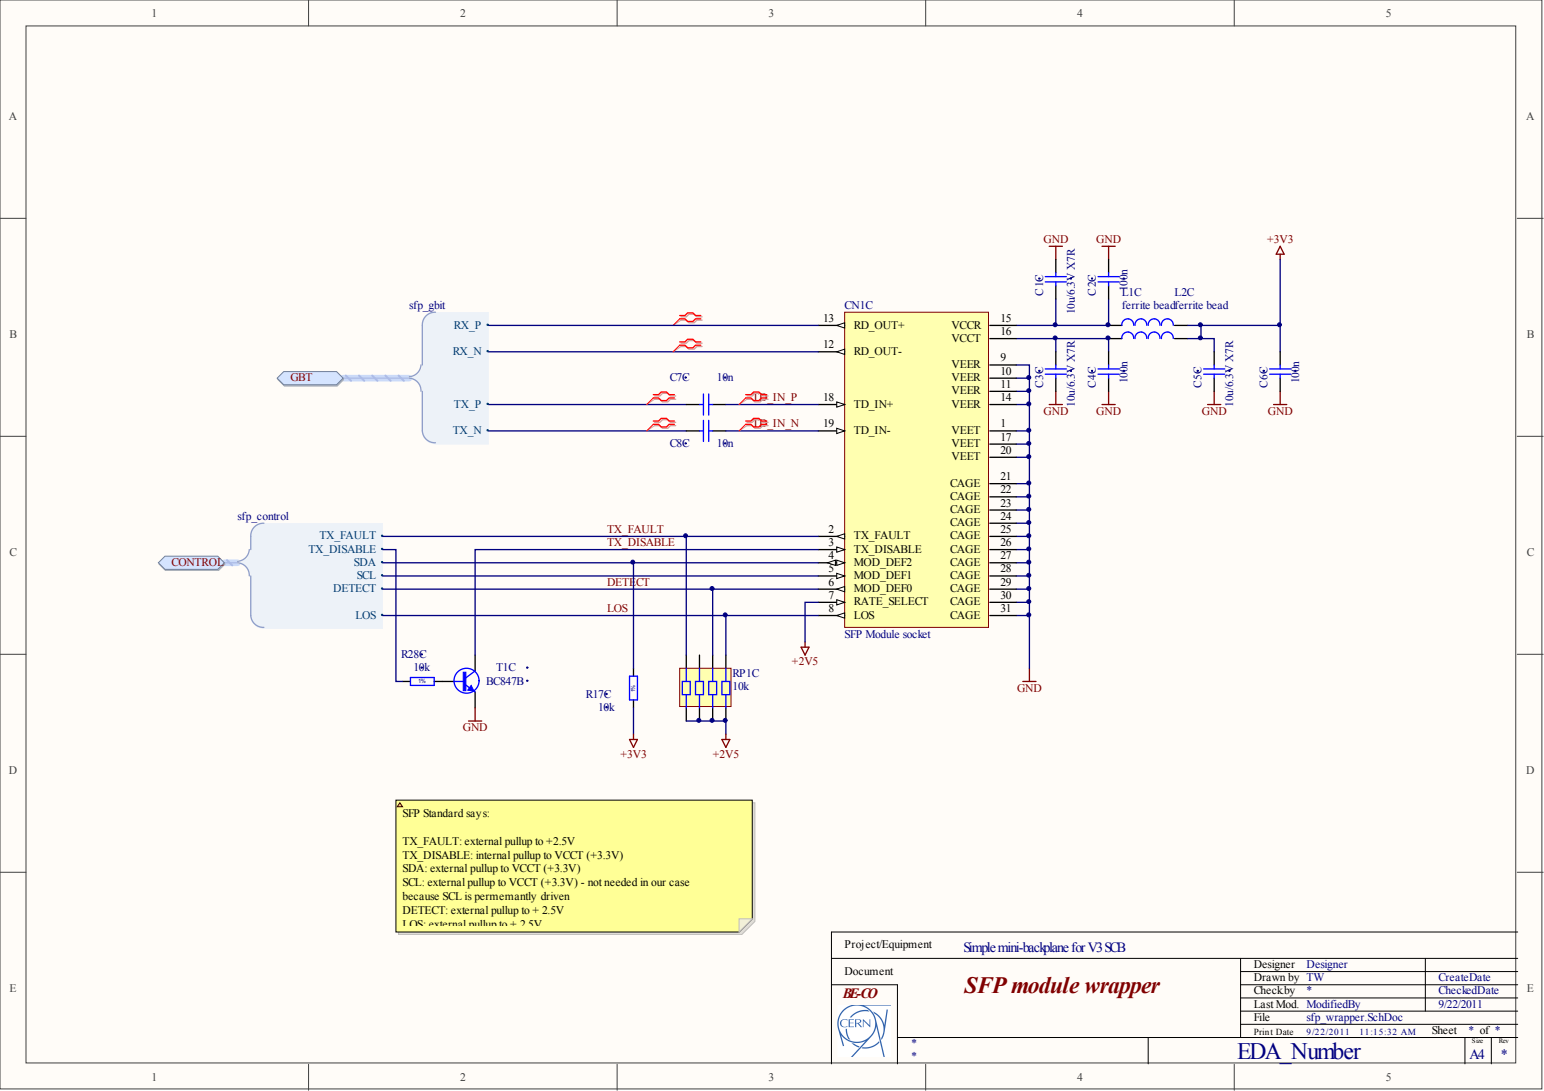
[picture p51: page 3]
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

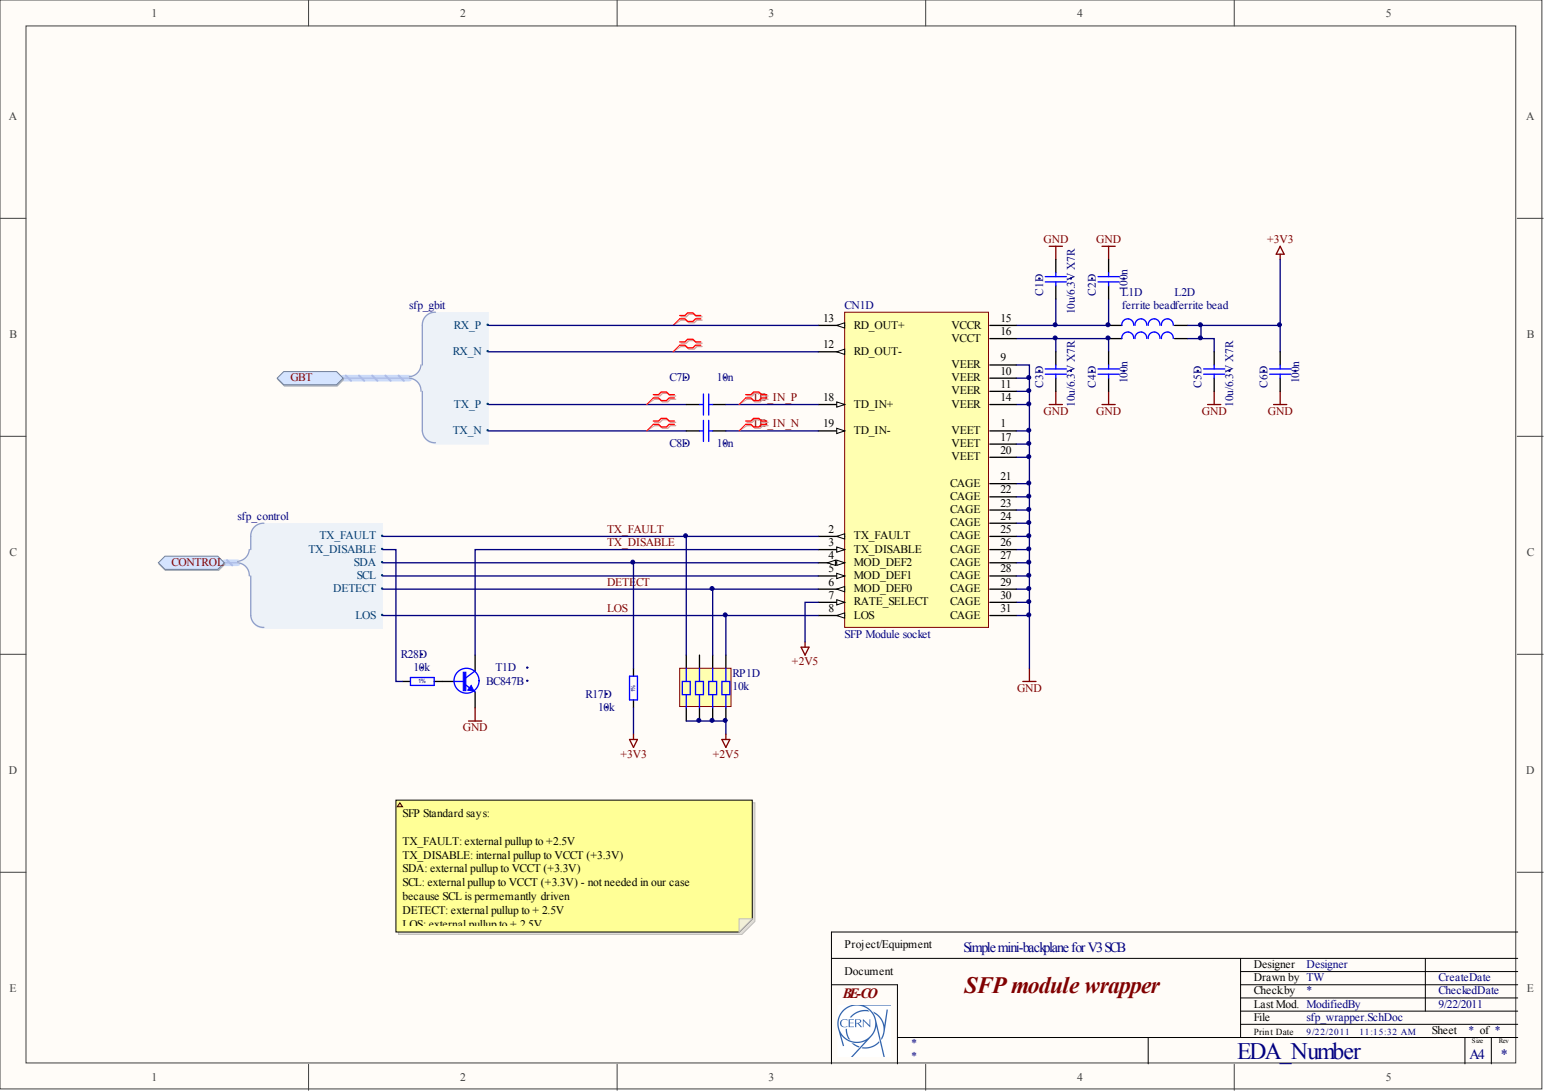
[picture p52: page 4]
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

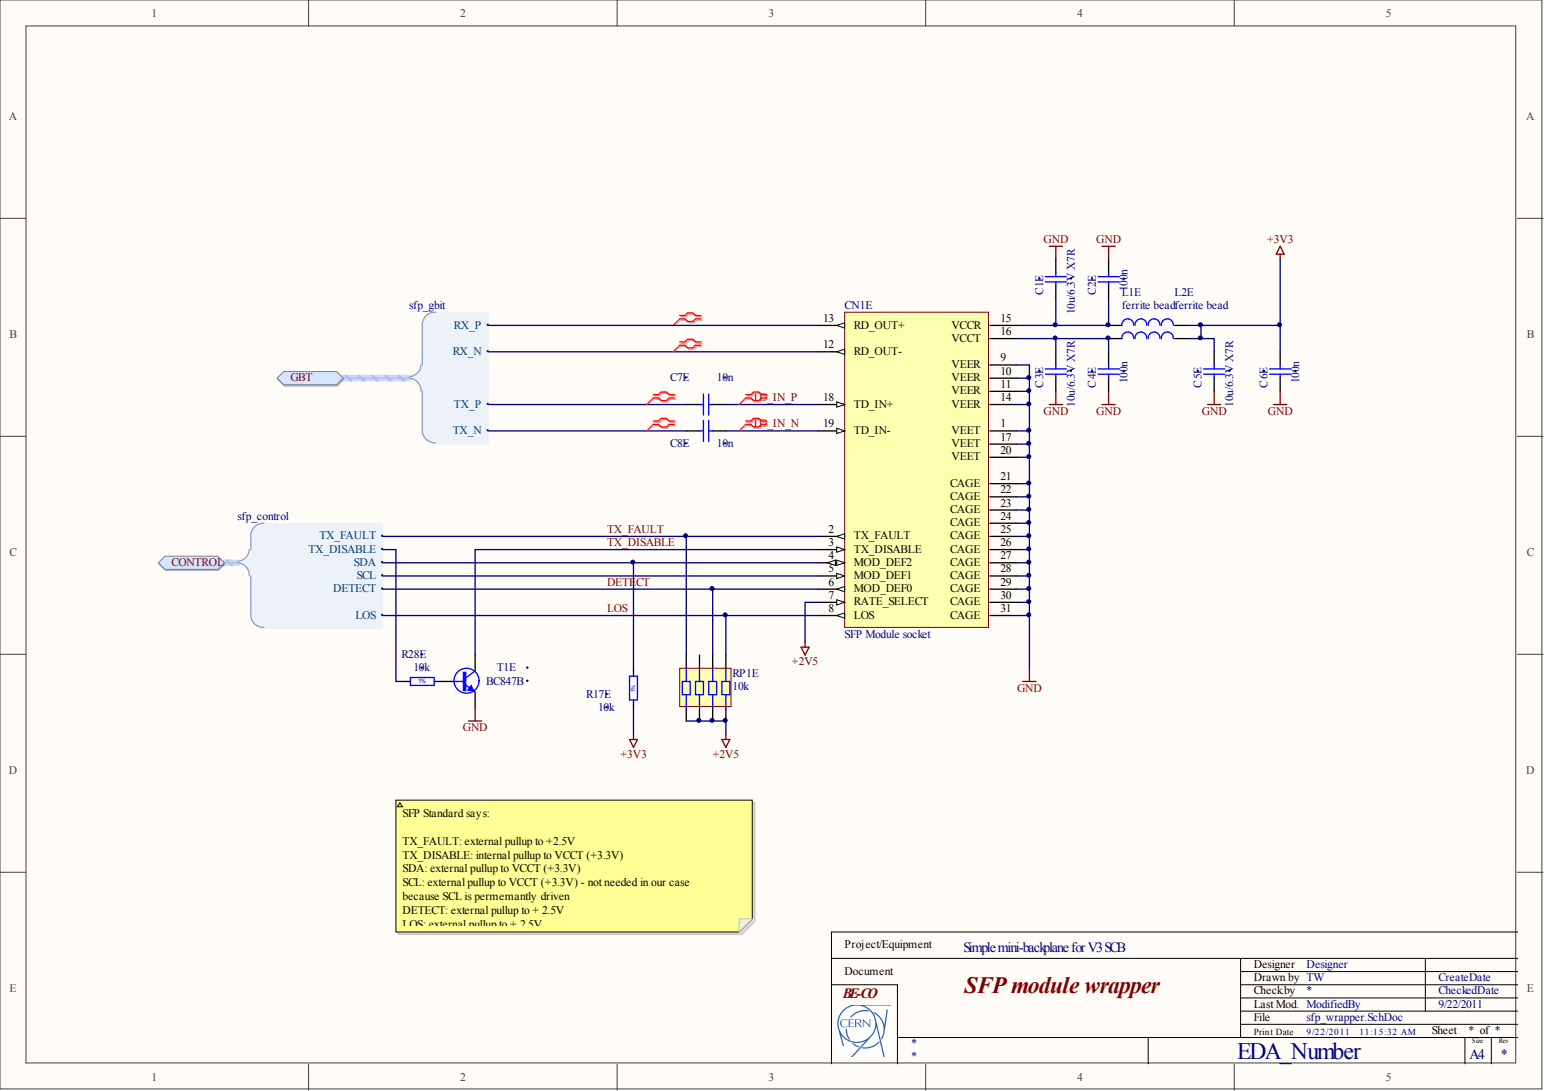
[picture p53: page 5]
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

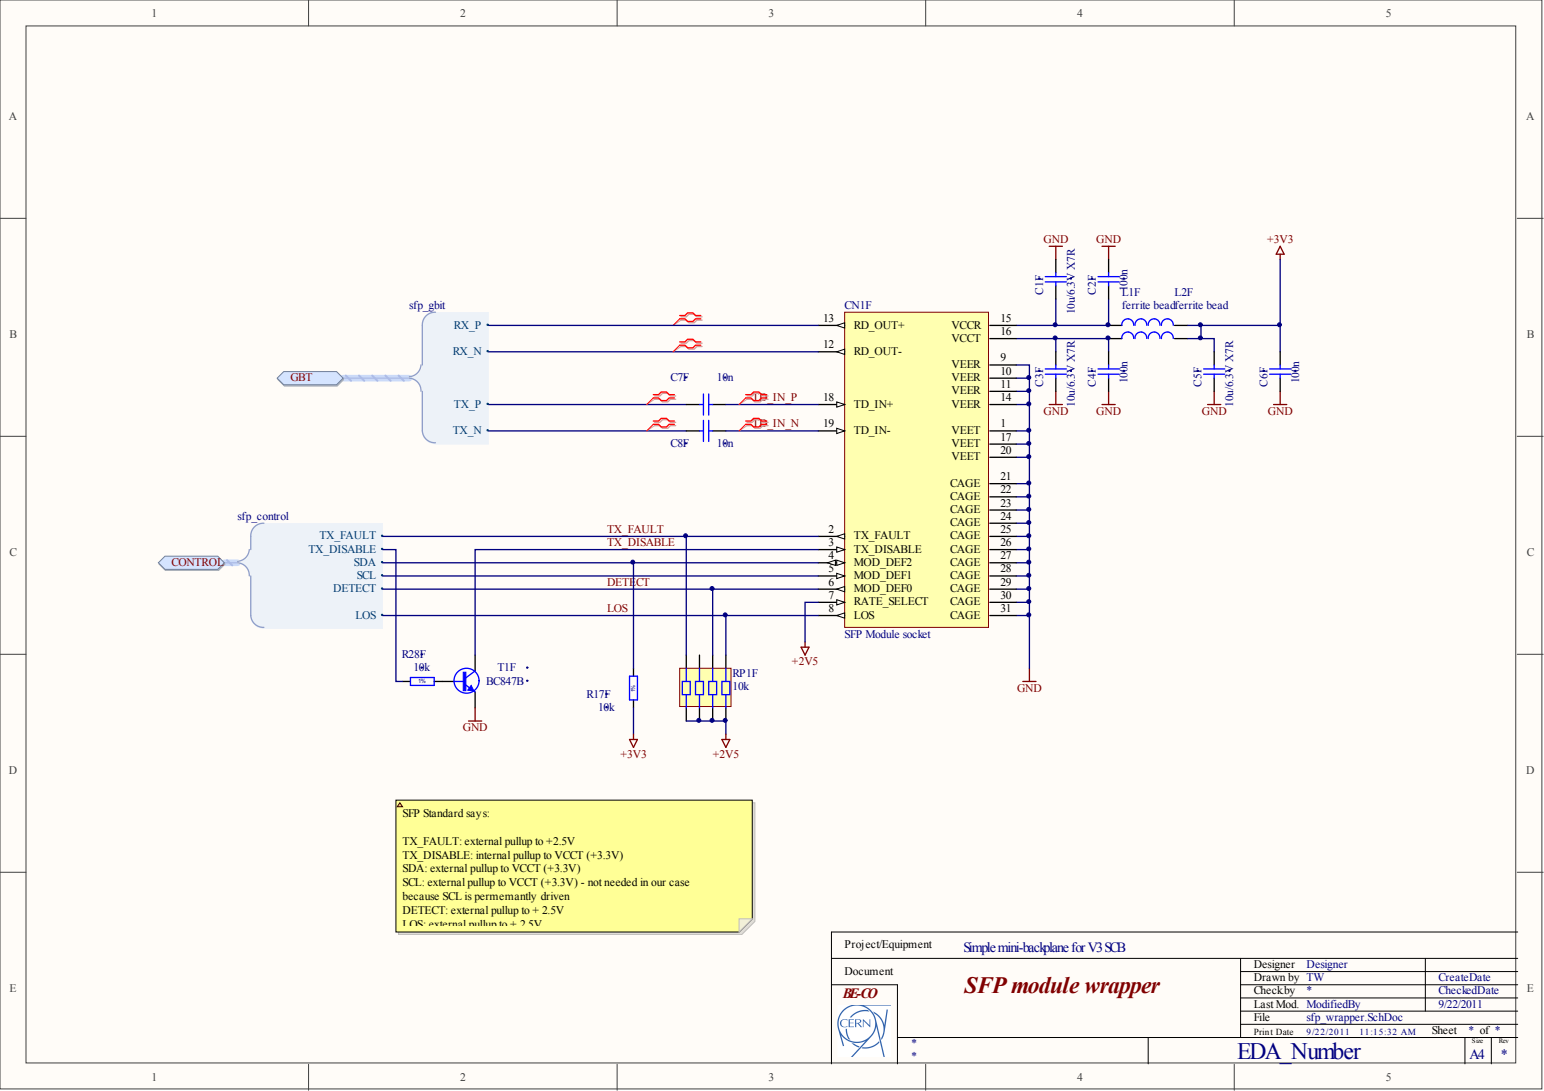
[picture p54: page 6]
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

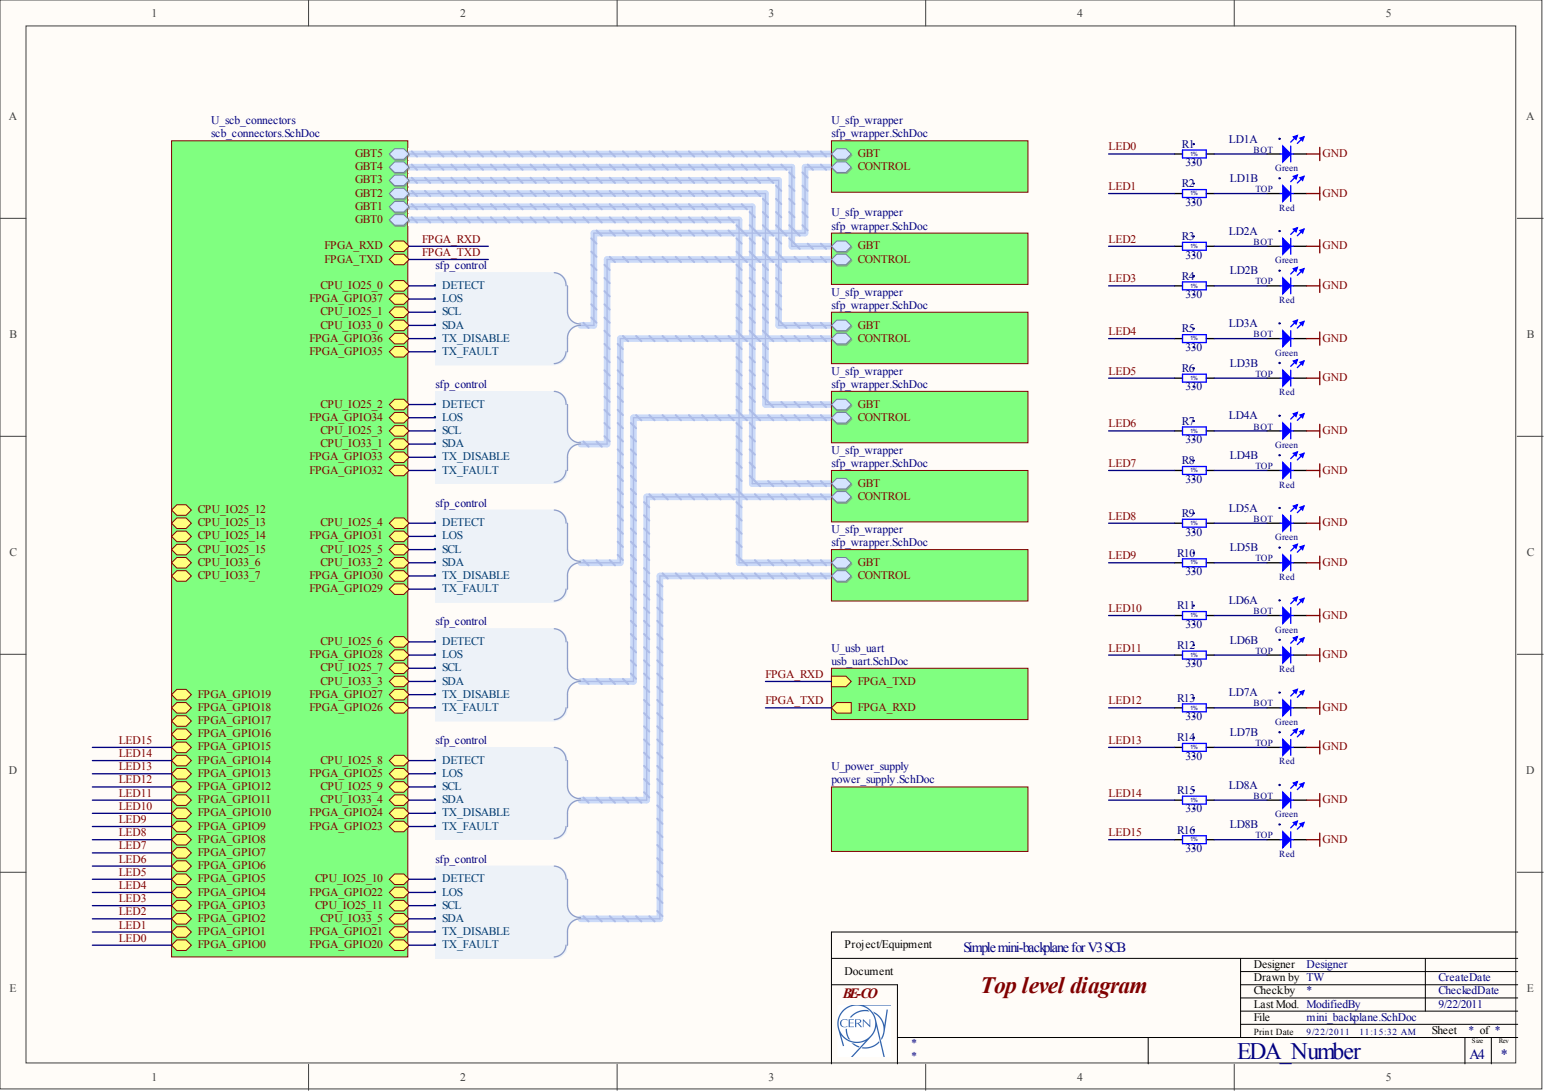
[picture p55: page 7]

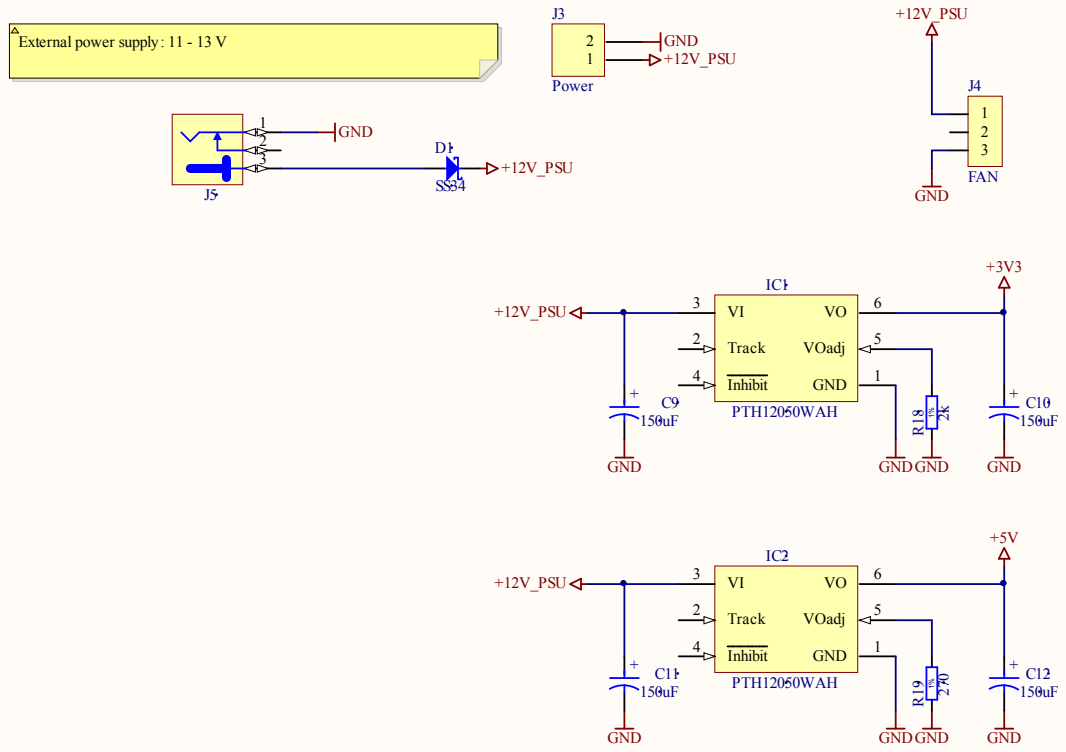
[picture p56: page 8]

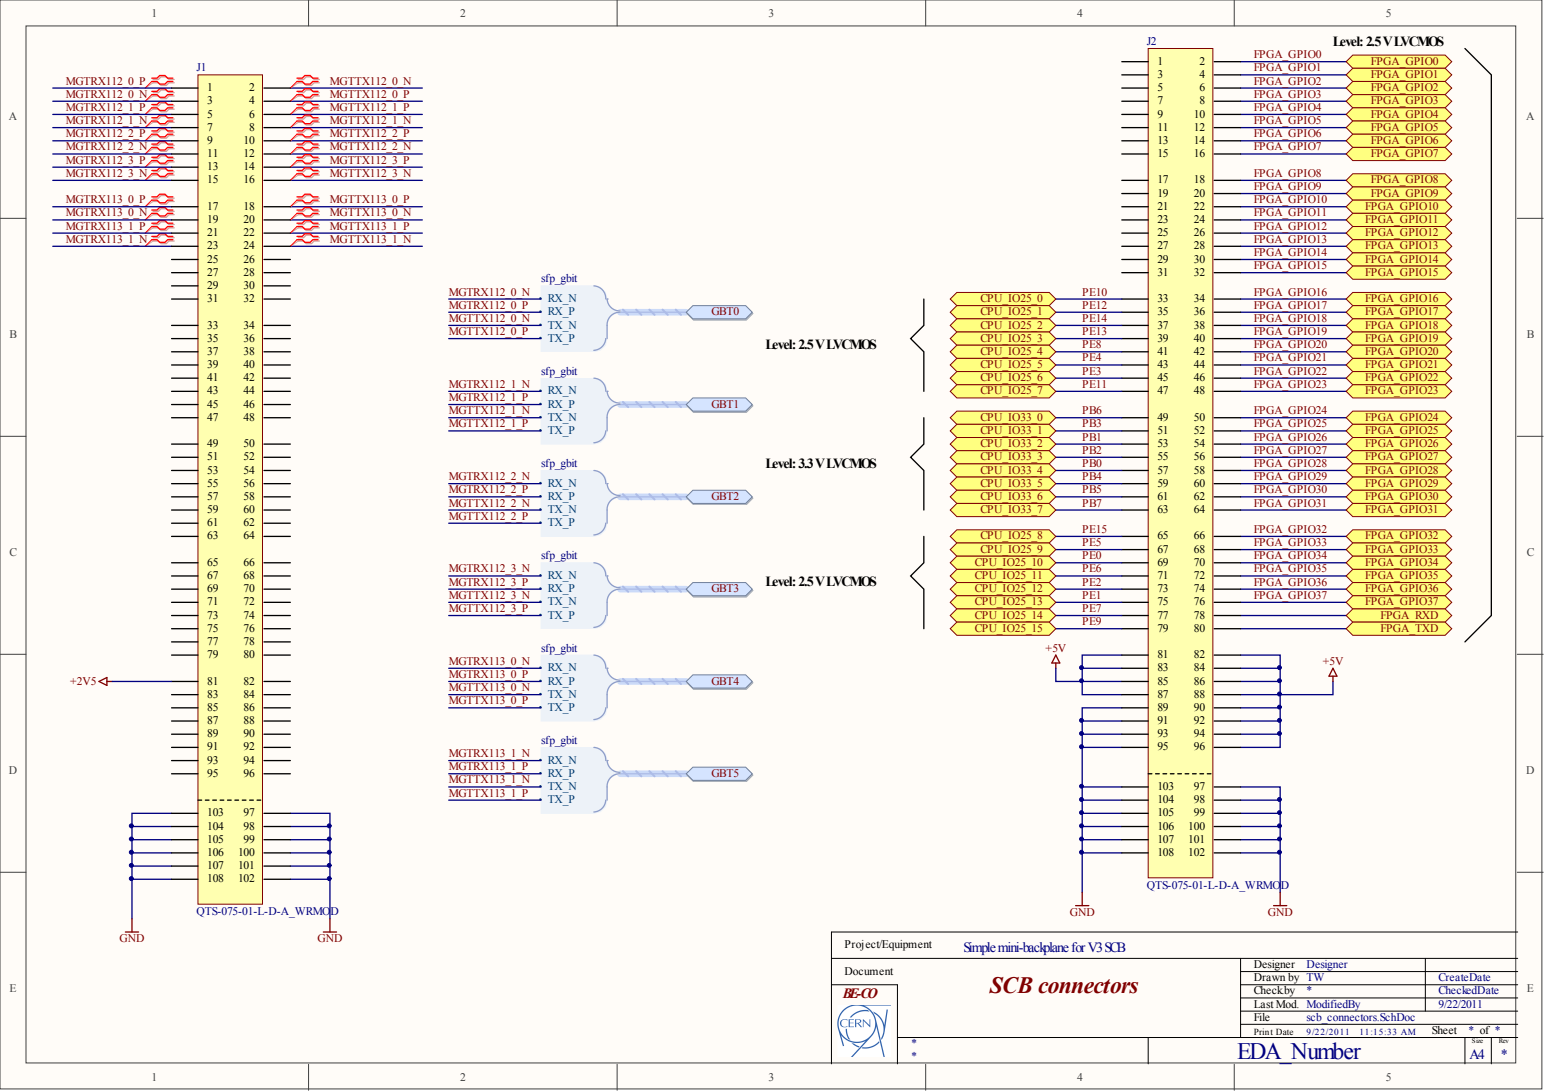
[picture p57: page 9]

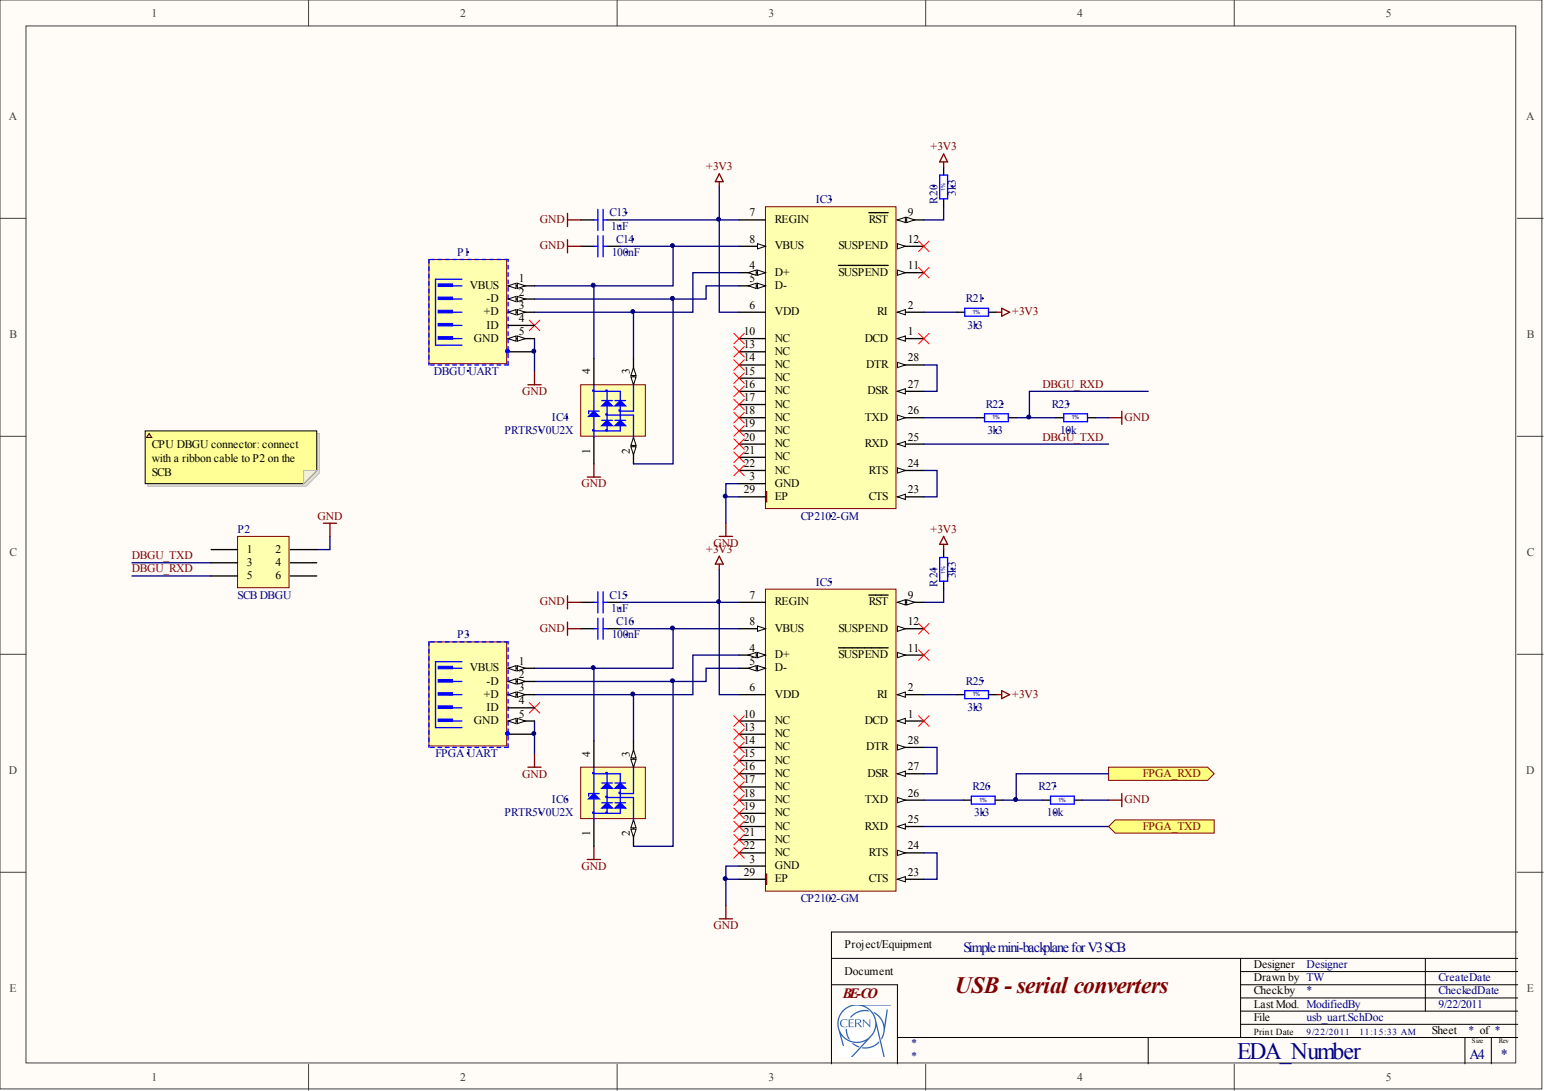
[picture p58: page 10]

C14 | VBUS 8

D+ 4
D- 5

VDD 6
NC 10 | 1%

CPU DBGU connector: connect
with a ribbon cable to P2 on the
SCB

C16 | VBUS 8

NC 10 | | 1%

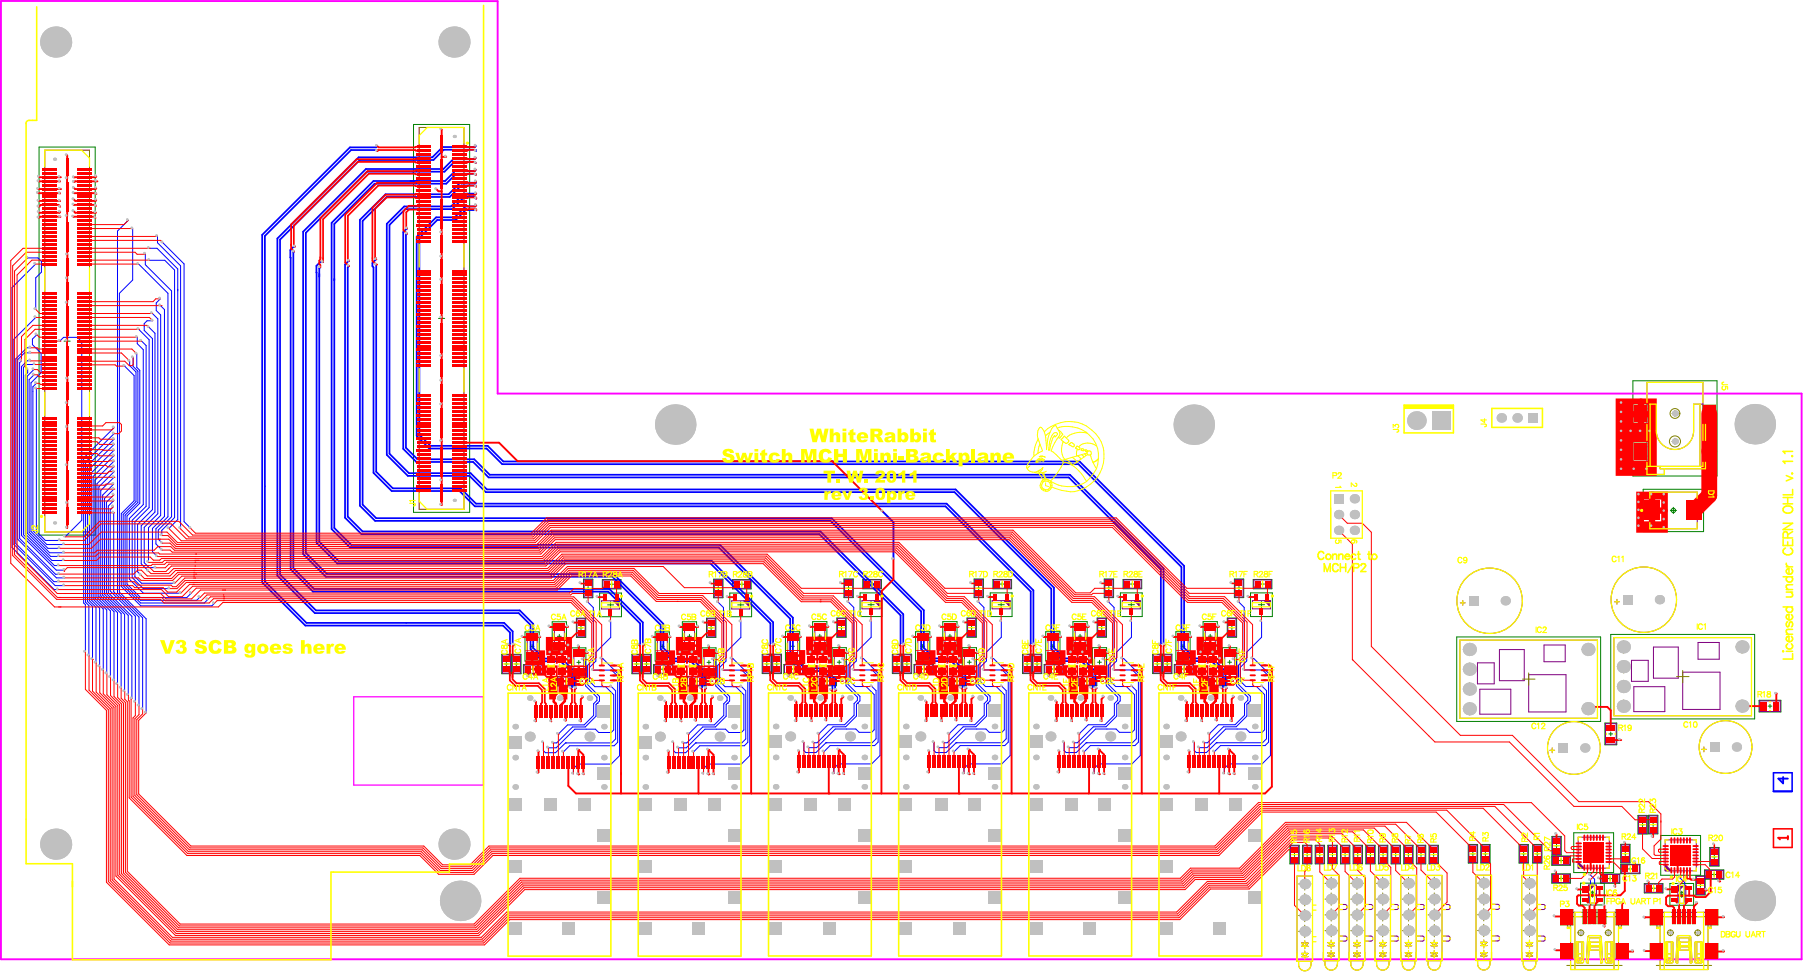
[picture p59: page 11]
