Reedgarden/WRS-HW/circuit_board/wrs_v3/Docs_PDF/miniBackplane_SFP_V3_3.pdf

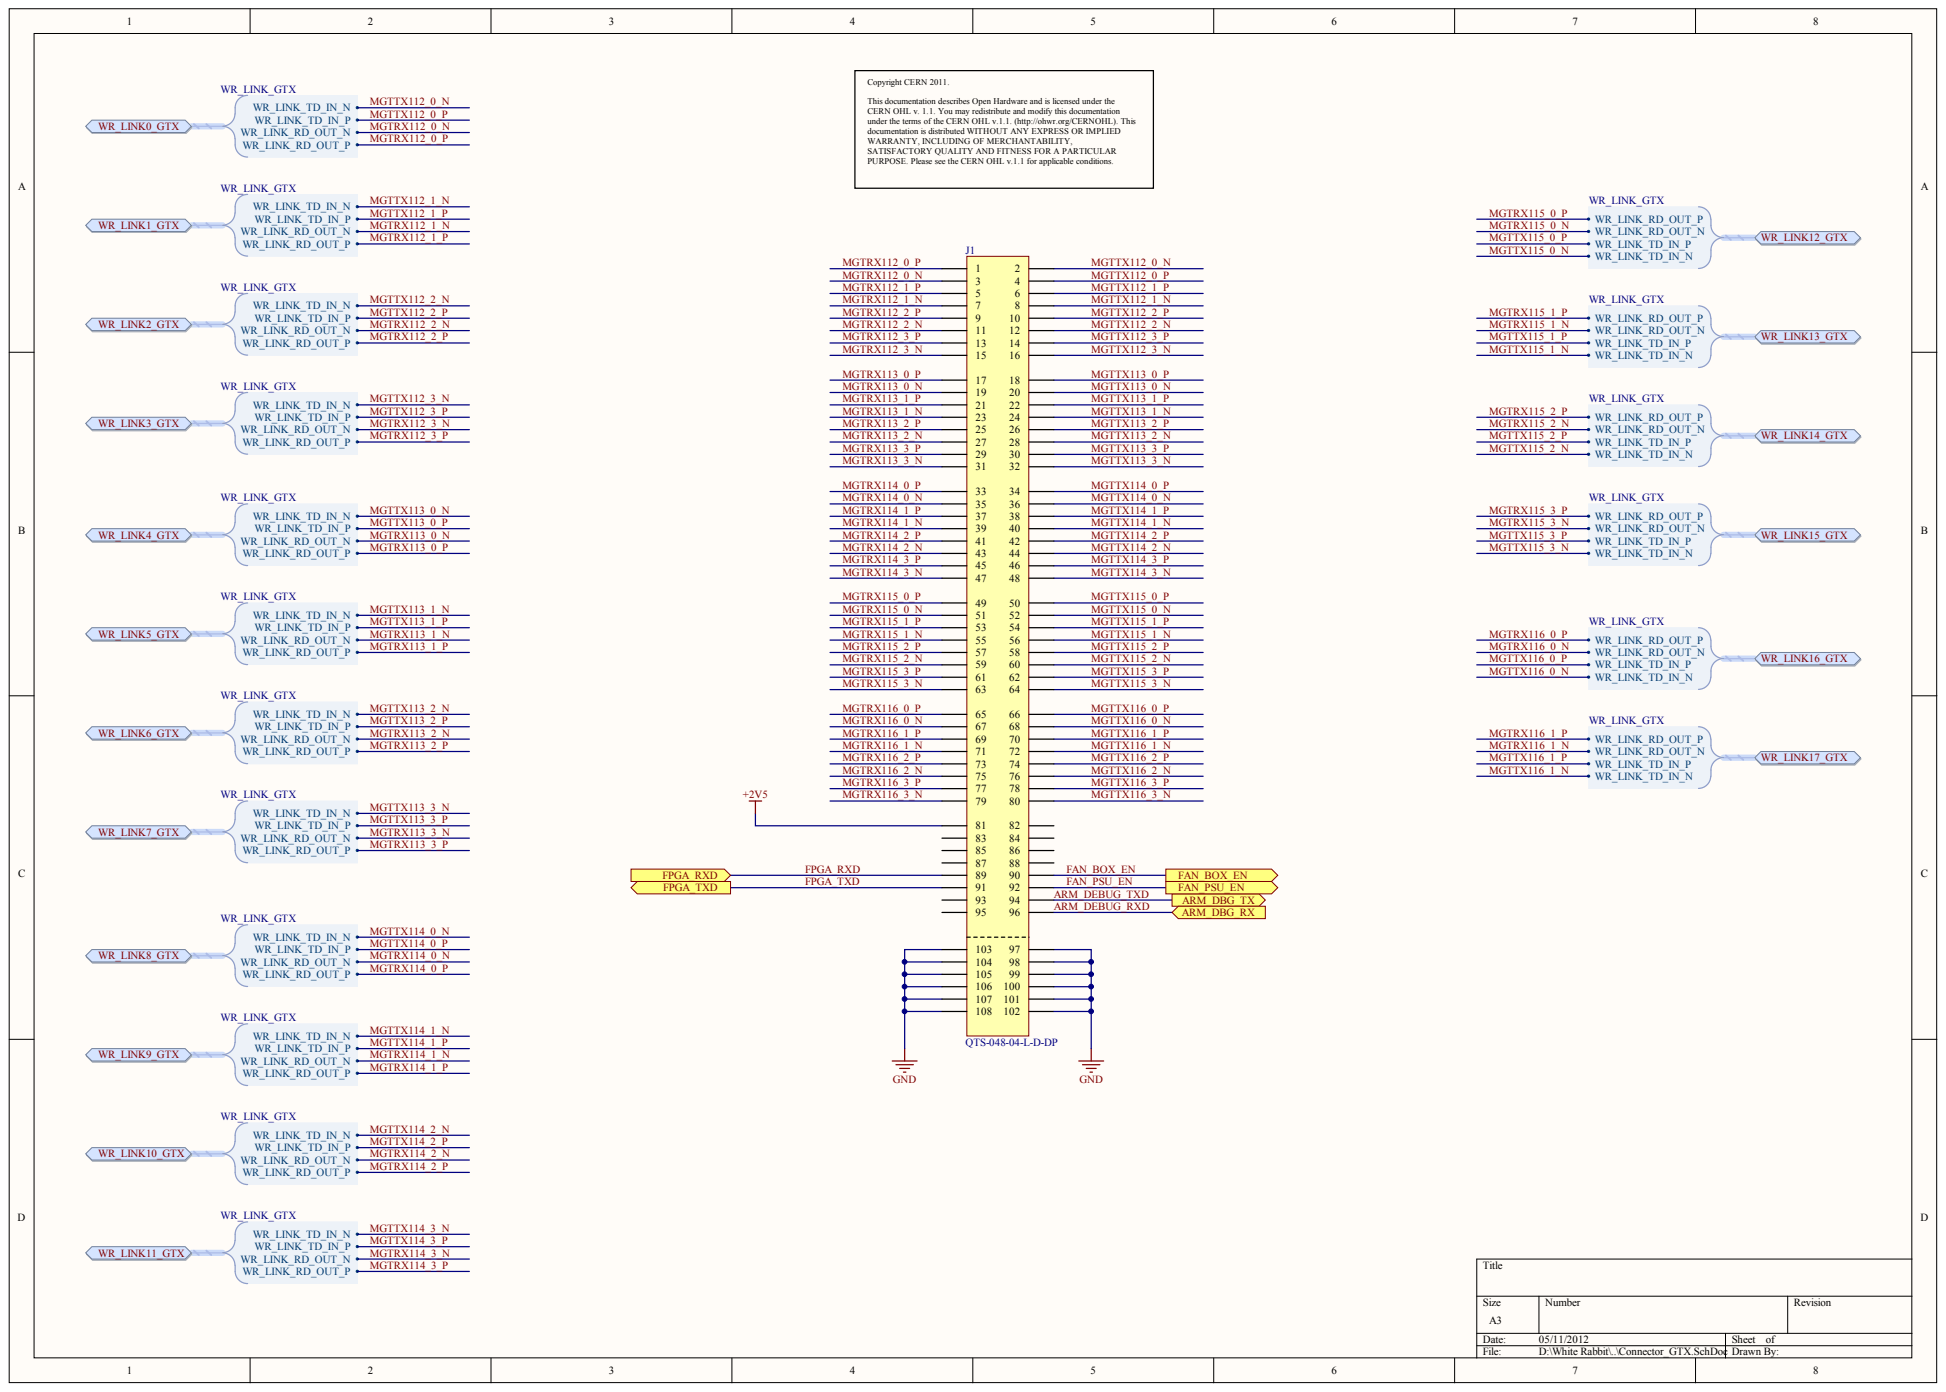
[picture p83: page 1]

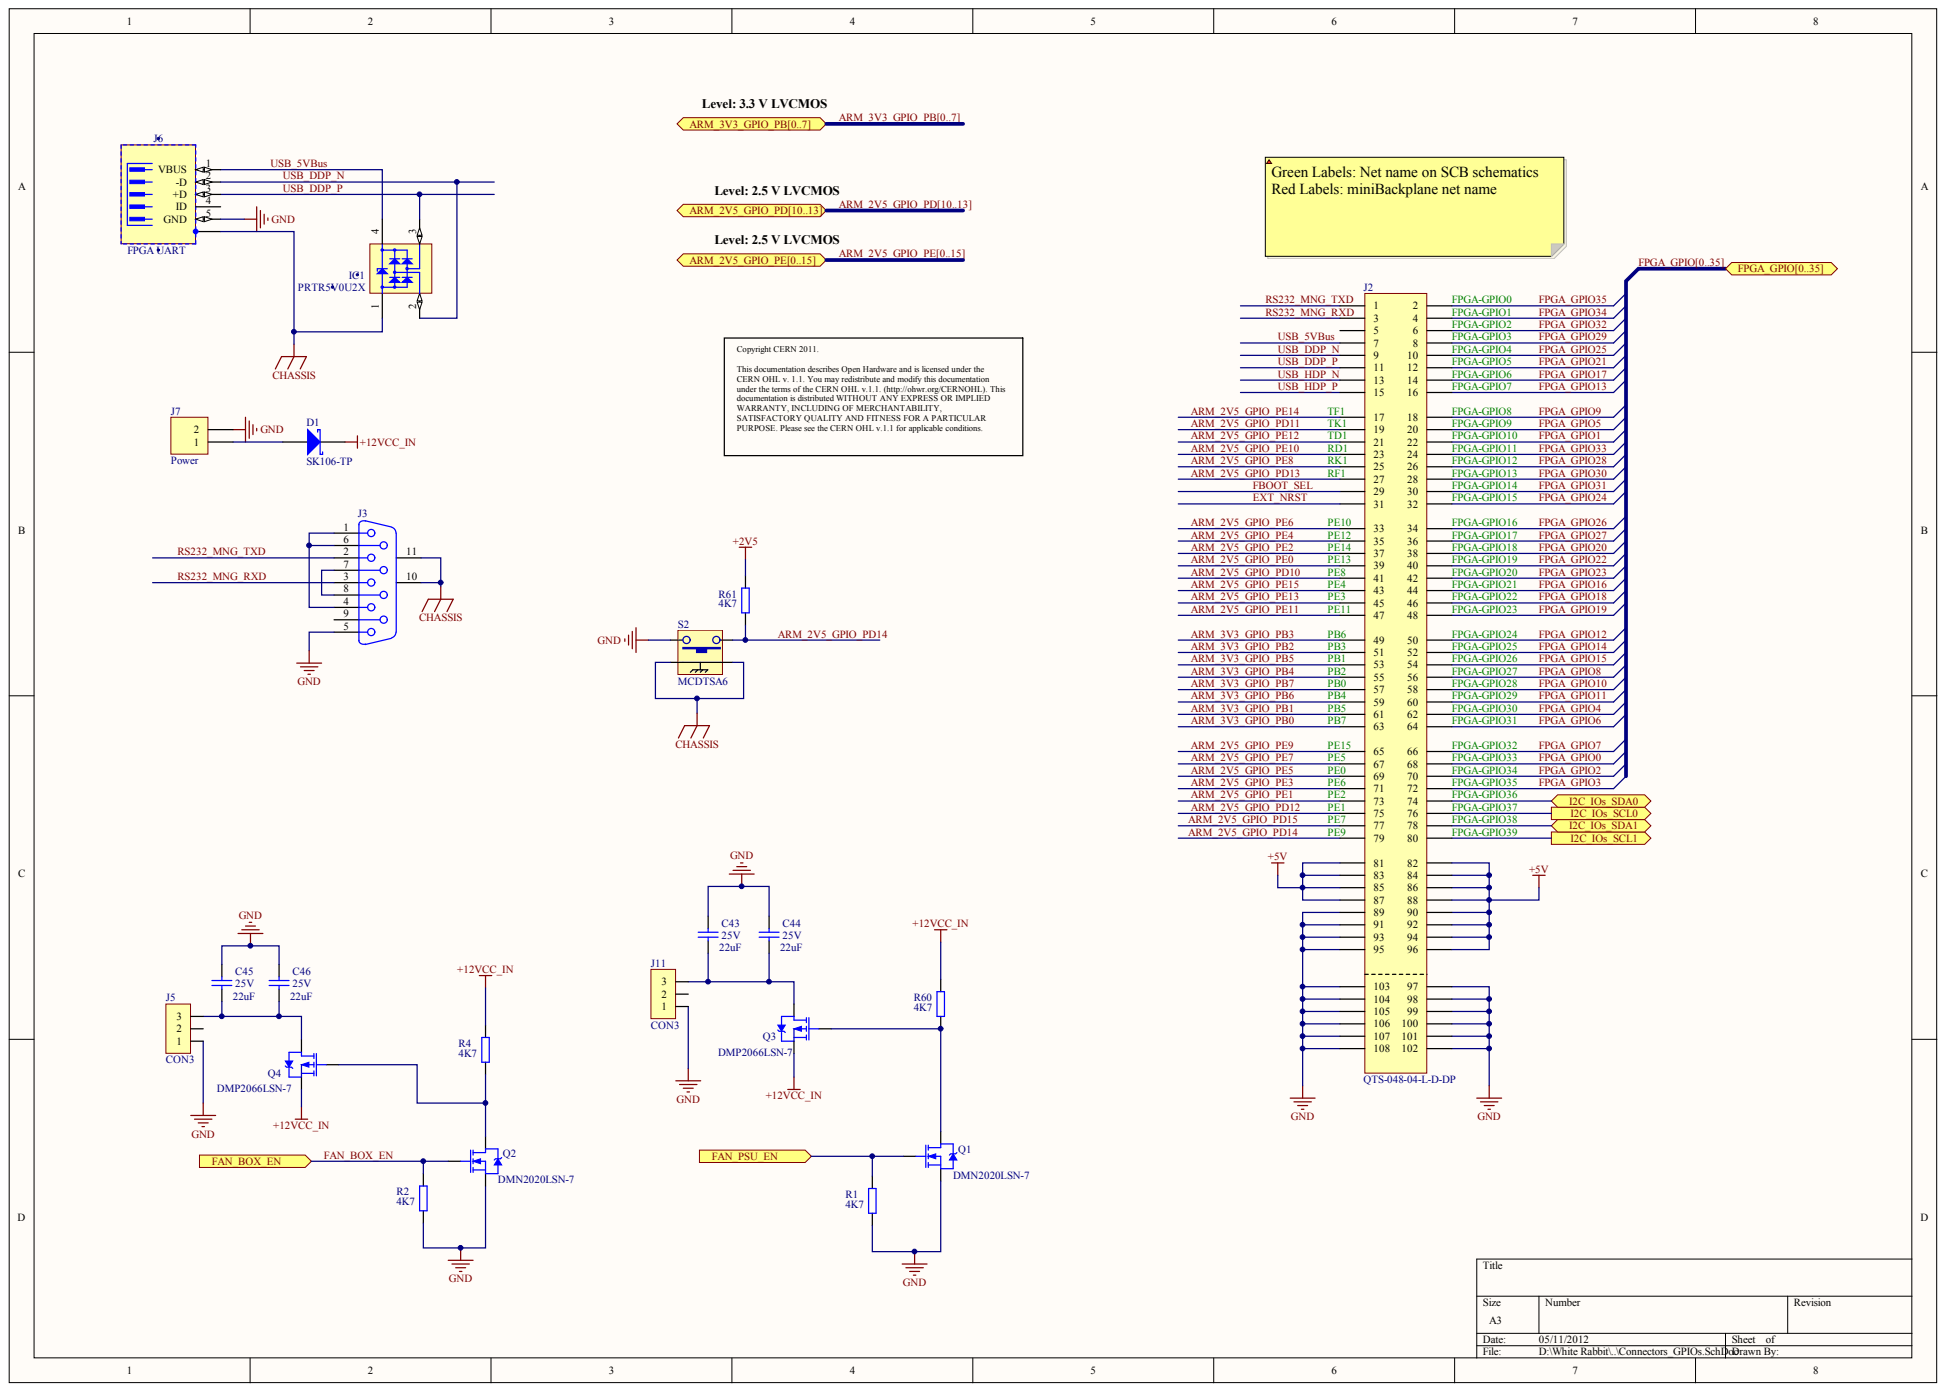
[picture p84: page 2]

2 | USB_DDP_N
3 | USB_DDP_ P

Green Labels: Net name on S
Red Labels: miniBackplane net nam

Thi
CERN O
under the terms of the CERN

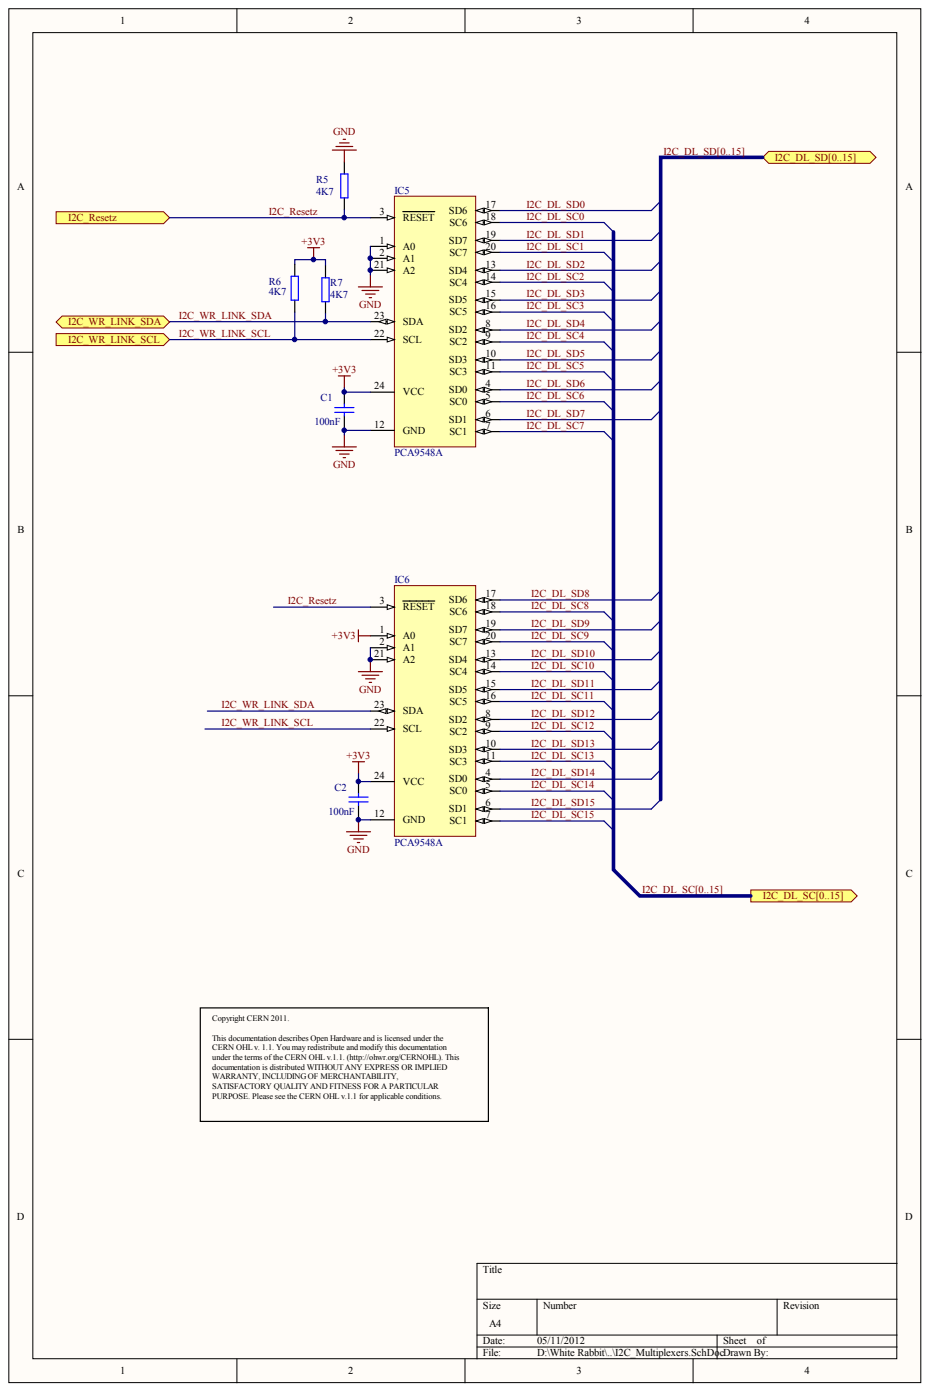
[picture p85: page 3]

This documentation describes Open Hardware and is licensed under the
CERN OHL v. 1.1. You may redistribute and modify this documentation
under the terms of the CERN OHL v.1.1. (http://ohwr.org/CERNOHL). This
documentation is distributed WITHOUT ANY EXPRESS OR IMPLIED
WARRANTY, INCLUDING OF MERCHANTABILITY,
SATISFACTORY QUALITY AND FITNESS FOR A PARTICULAR
PURPOSE. Please see the CERN OHL v.1.1 for applicable conditions.

Size A4 | Number | Revision

Date: 05/11/2012 | Sheet of
File: D:\White Rabbit\..\I2C_Multiplexers.SchDocDrawn By:

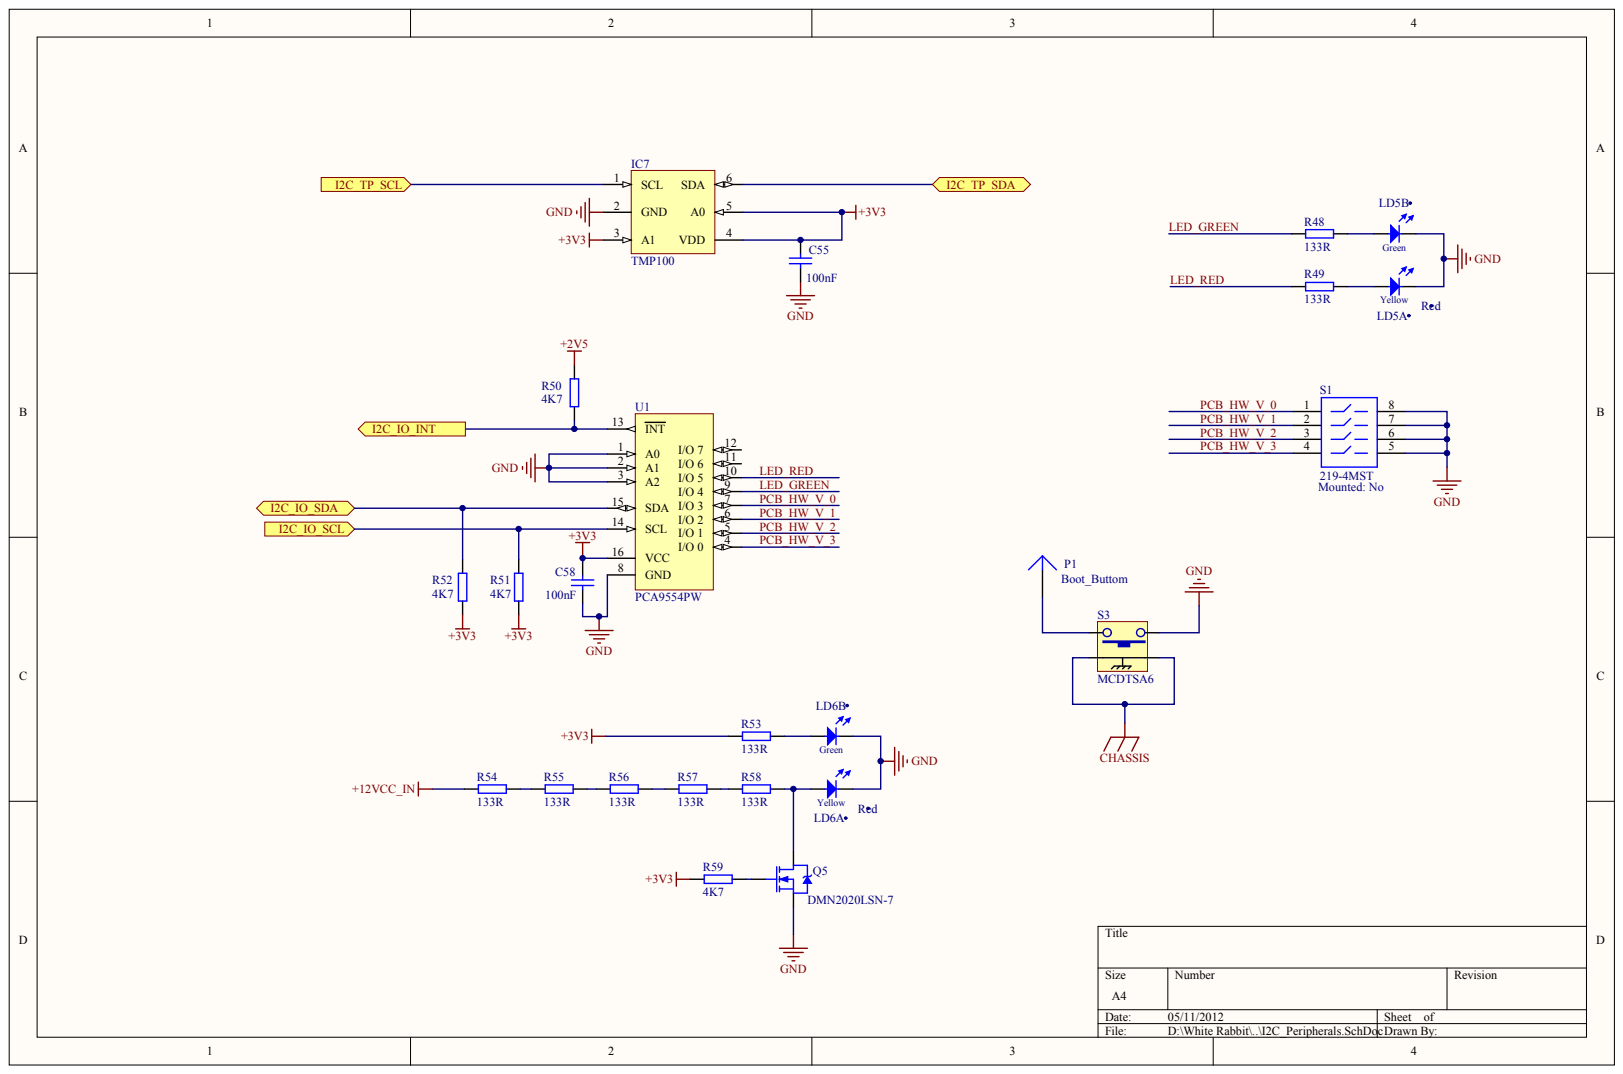
[picture p86: page 4]

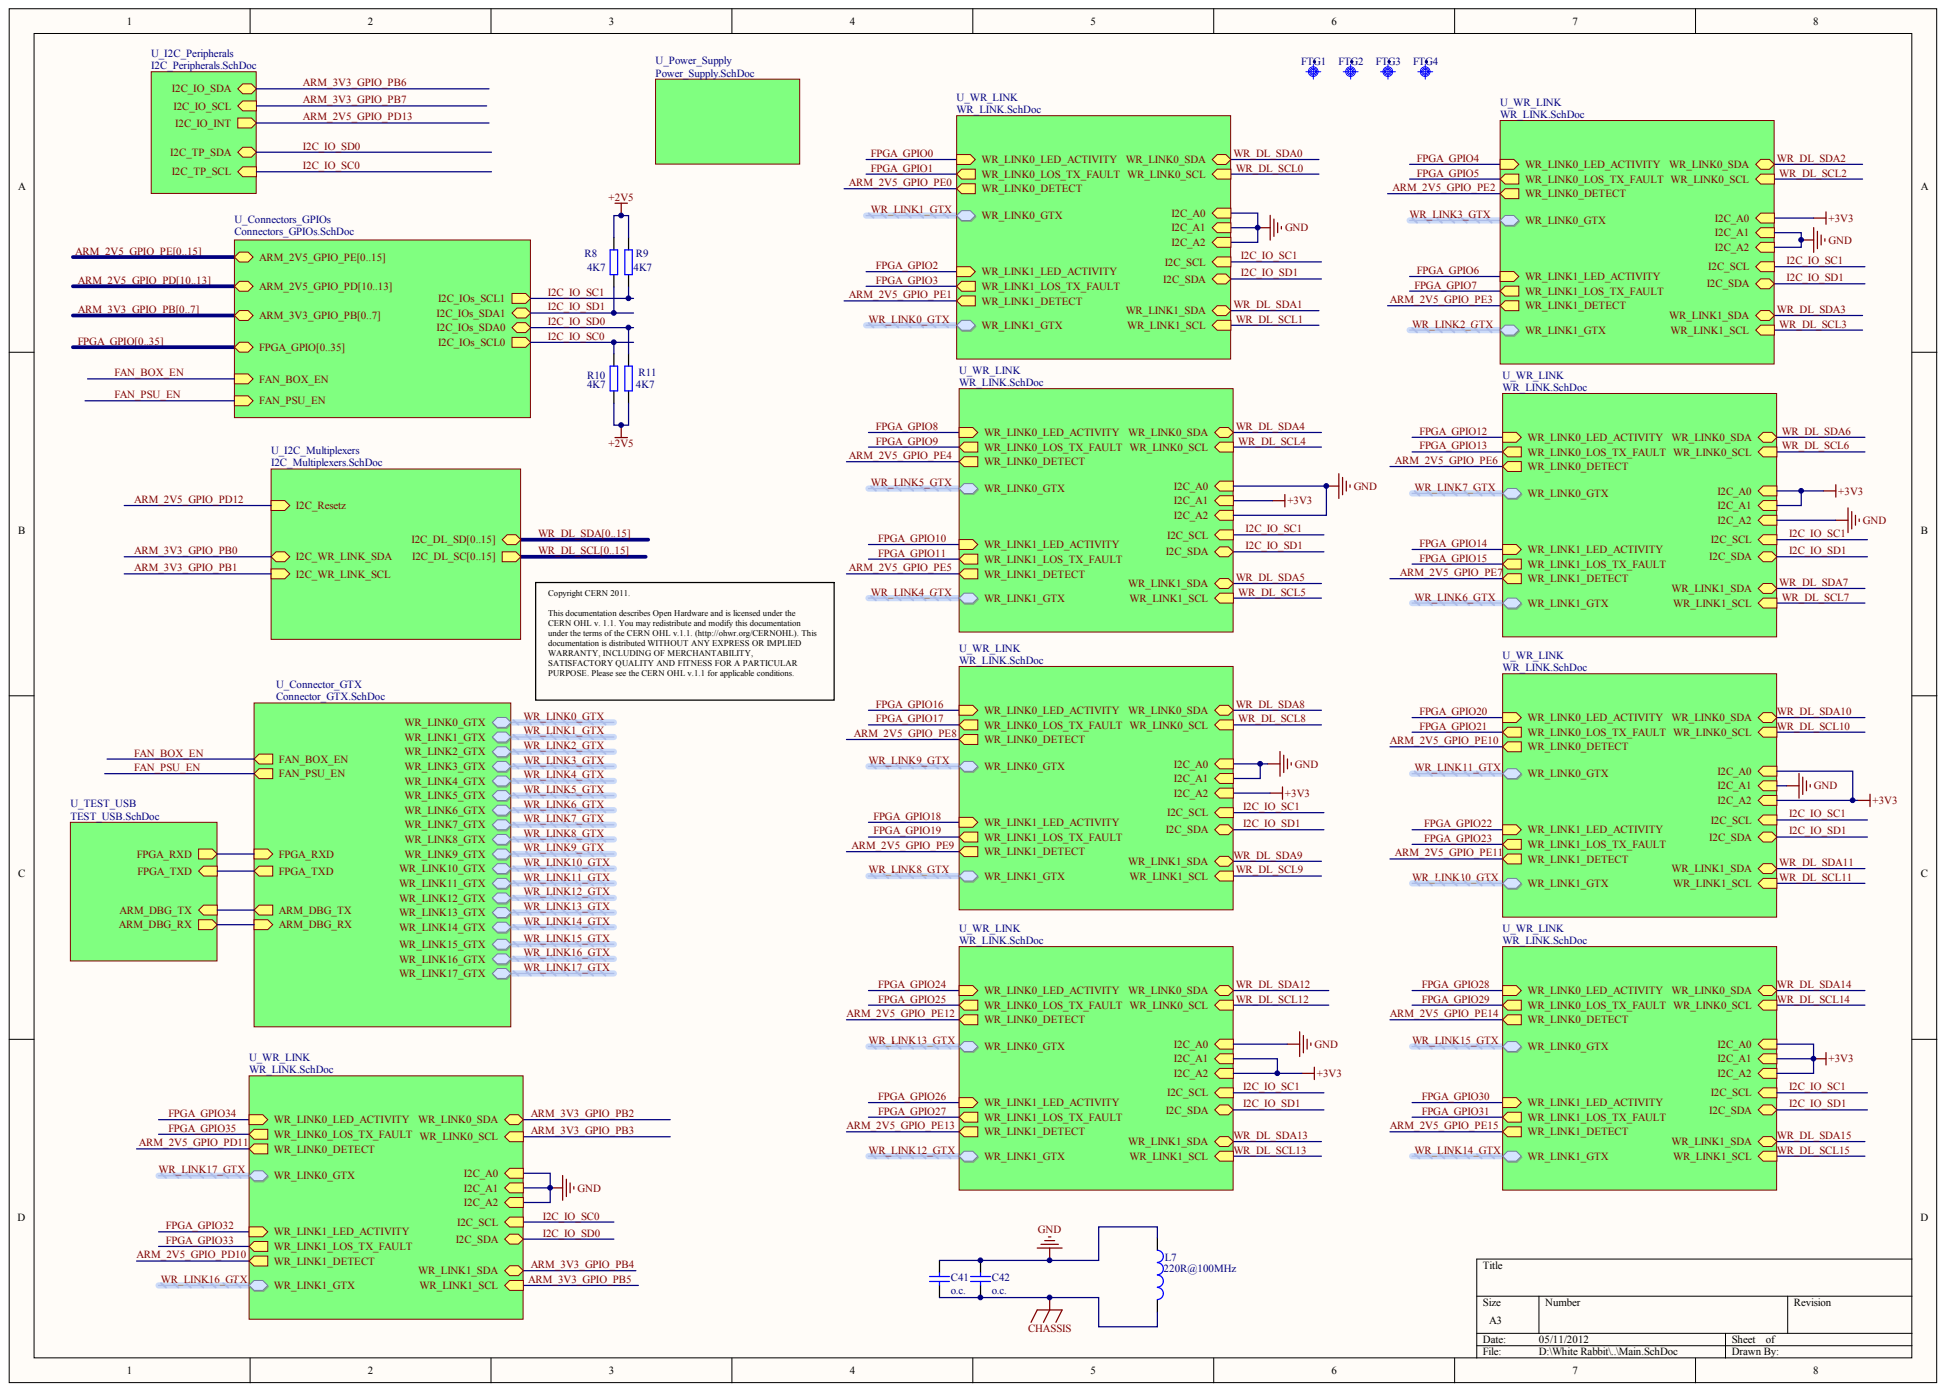
[picture p87: page 5]
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

WR_LINK6_GTX | I2C_IO_SC1
WR_LINK7_GTX | I2C_IO_SD1

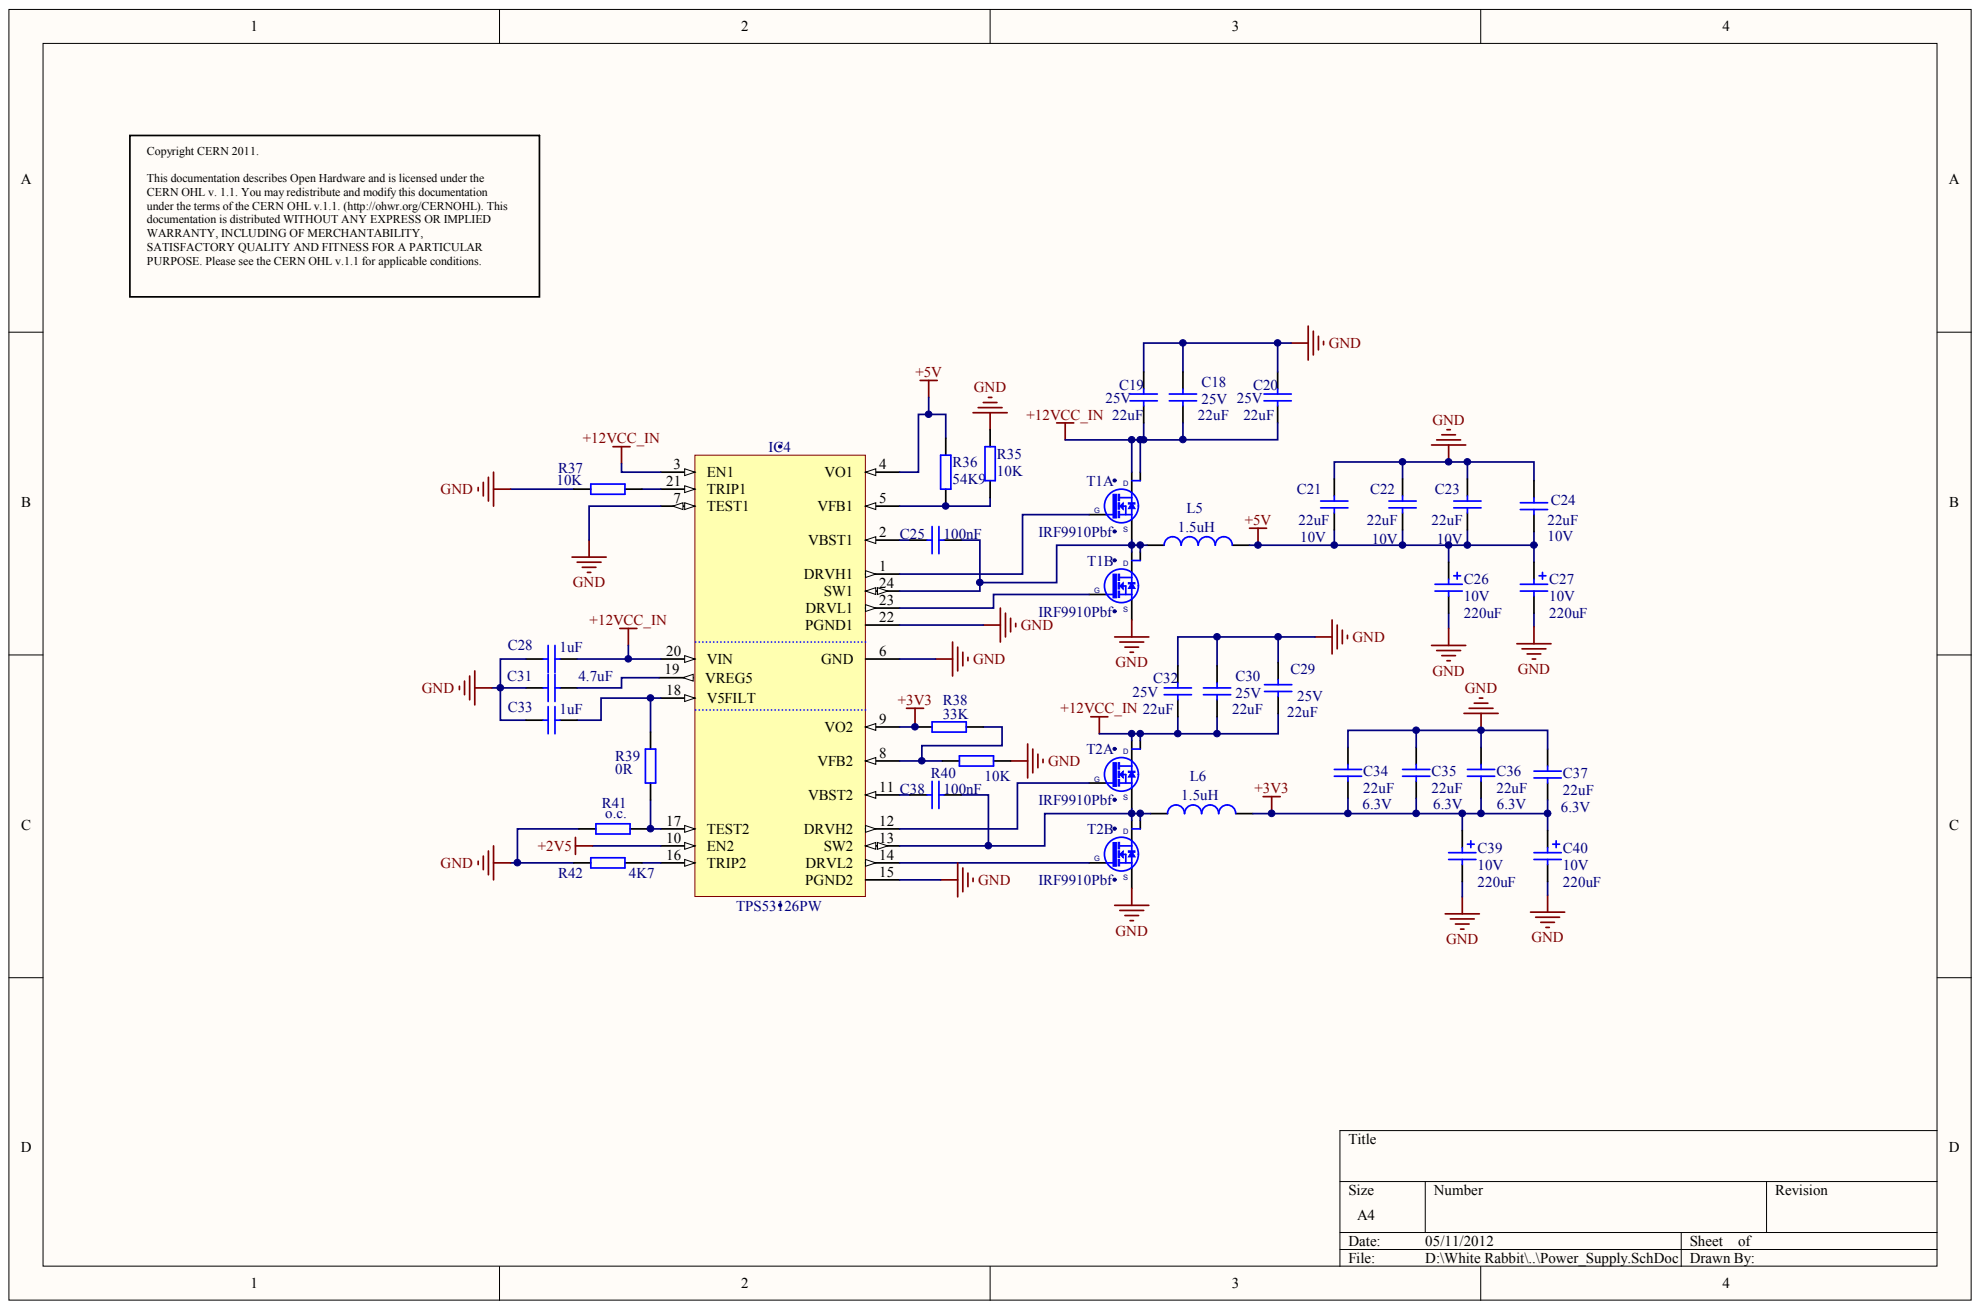
[picture p88: page 6]

This docu
CERN OHL v. 1.1. Y
under the terms o
documentation is di
WARRANTY, I
SATI
PURPOSE. Please see the CERN OHL v.1.1 for ap

T ANY EXPRESS OR IMPLIED

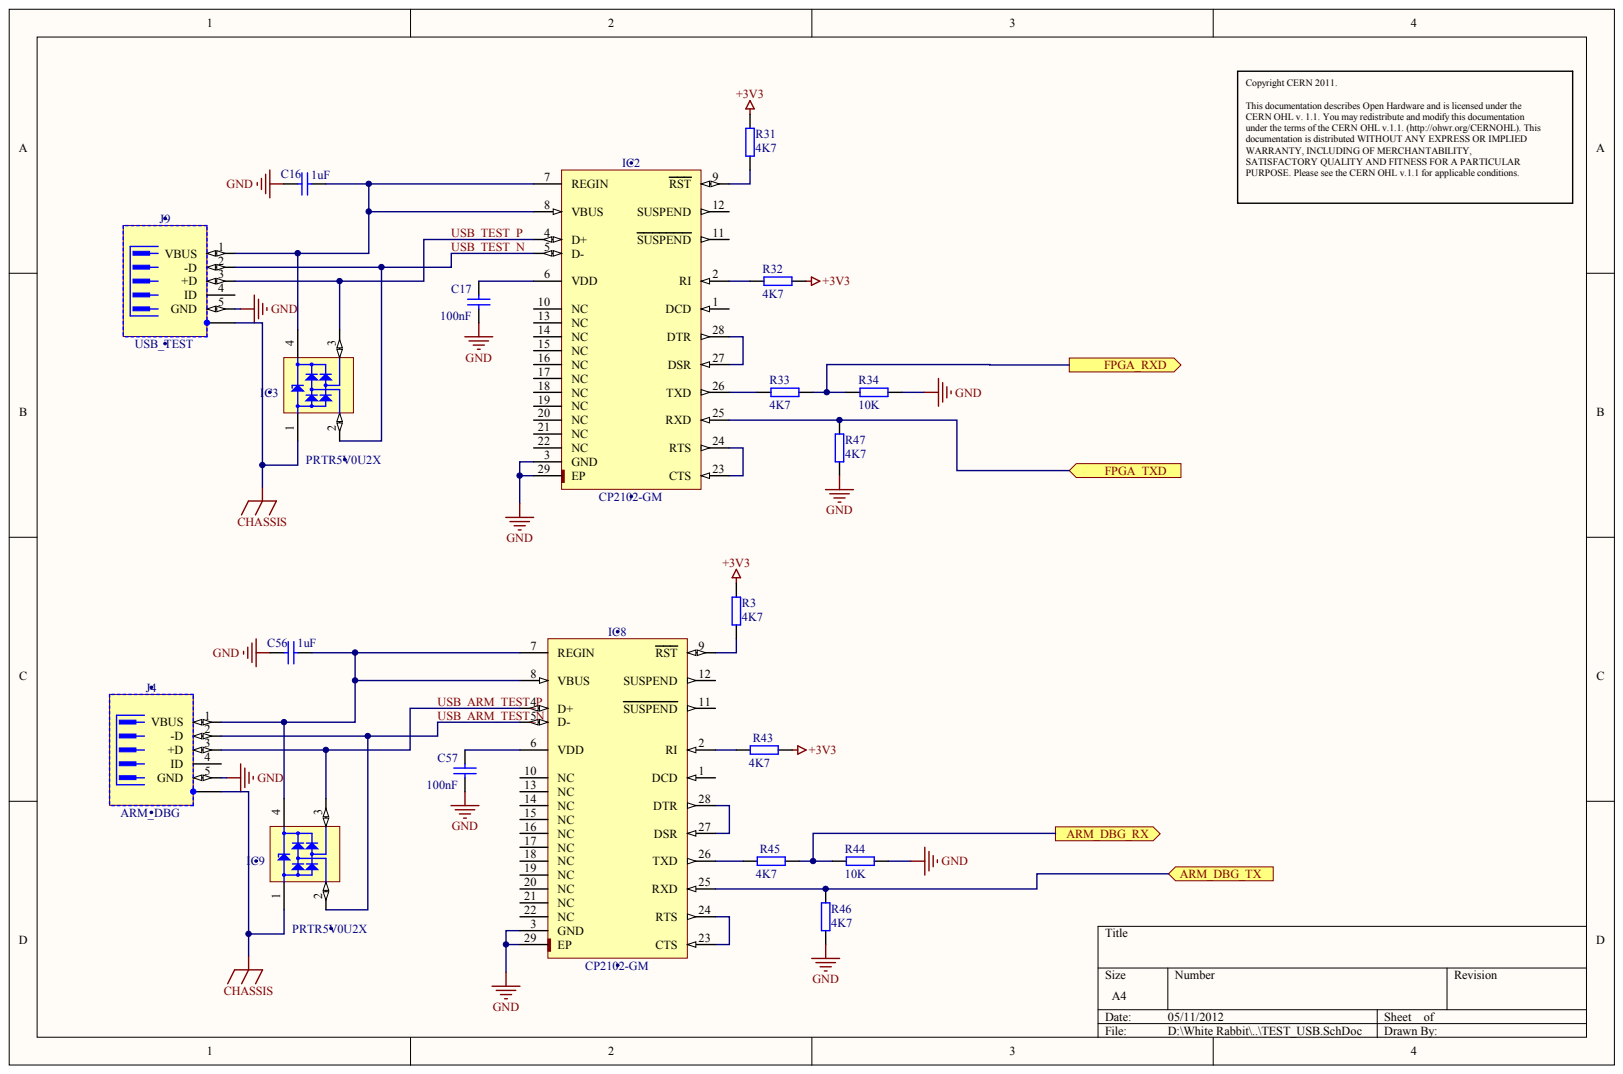
[picture p89: page 7]
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

VBUS 8

USB_TEST_N | | D- 5

VDD 6

USB_ARM_TEST_N | | D- 5

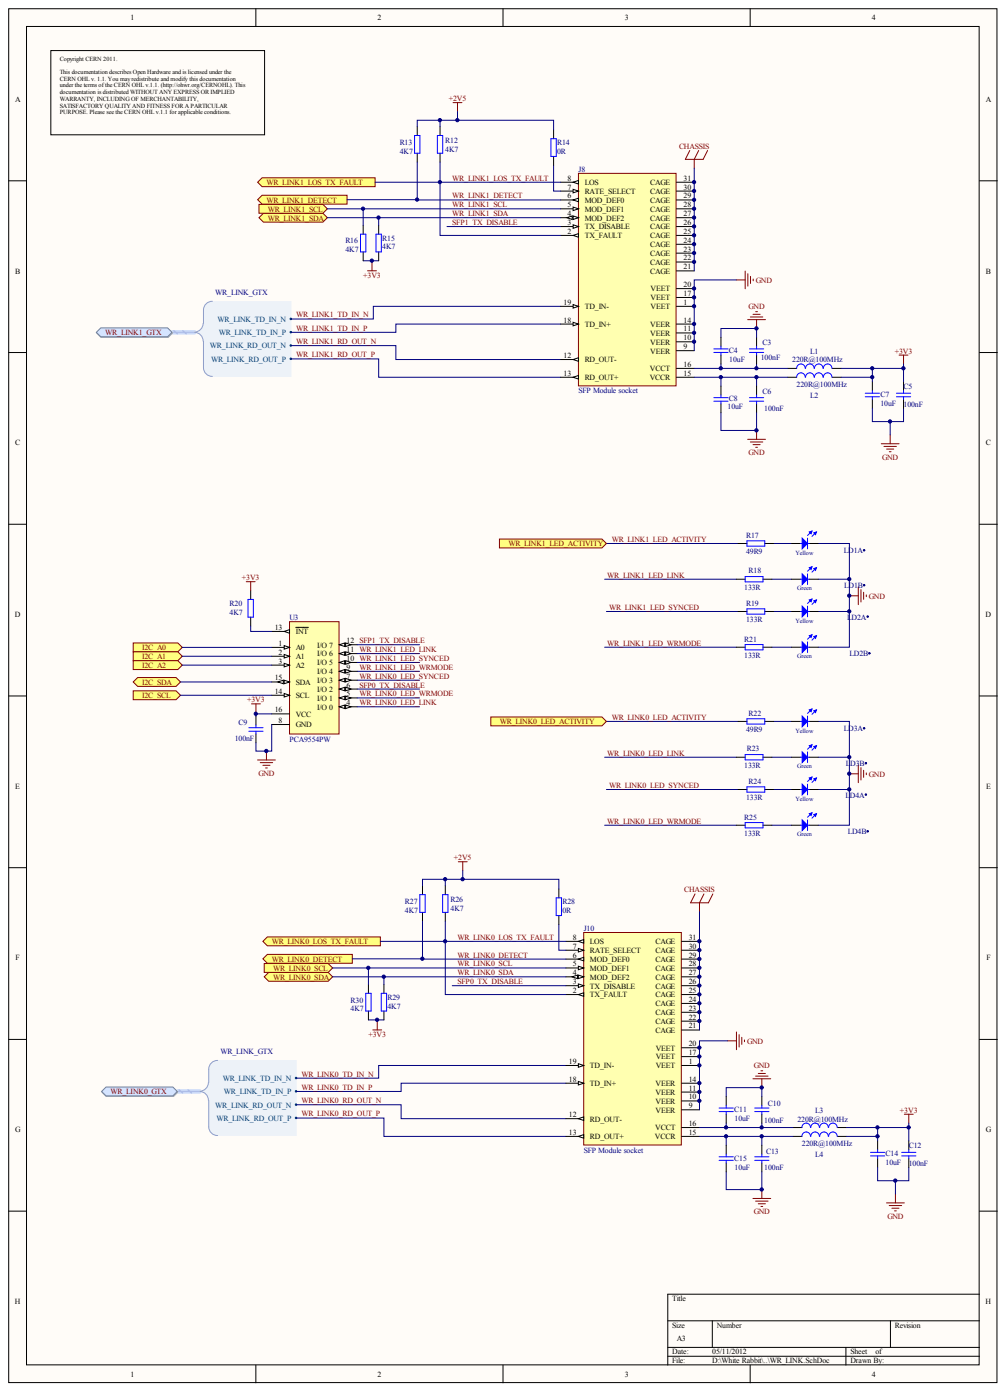
[picture p90: page 8]
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

WR_LINK0_LOS_TX_FAULT
WR_LINK0_DETECT WR_LINK0_SCL WR_LINK0_SDA SFP0_TX_DISABLE | | RATE_SELECT 7

File: D:\White Rabbit\..\WR_LINK.SchDoc | Drawn By:
