Reedgarden/WRS-HW/circuit_board/wrs_v3/Docs_PDF/SCB_Schematics_V3_3.pdf

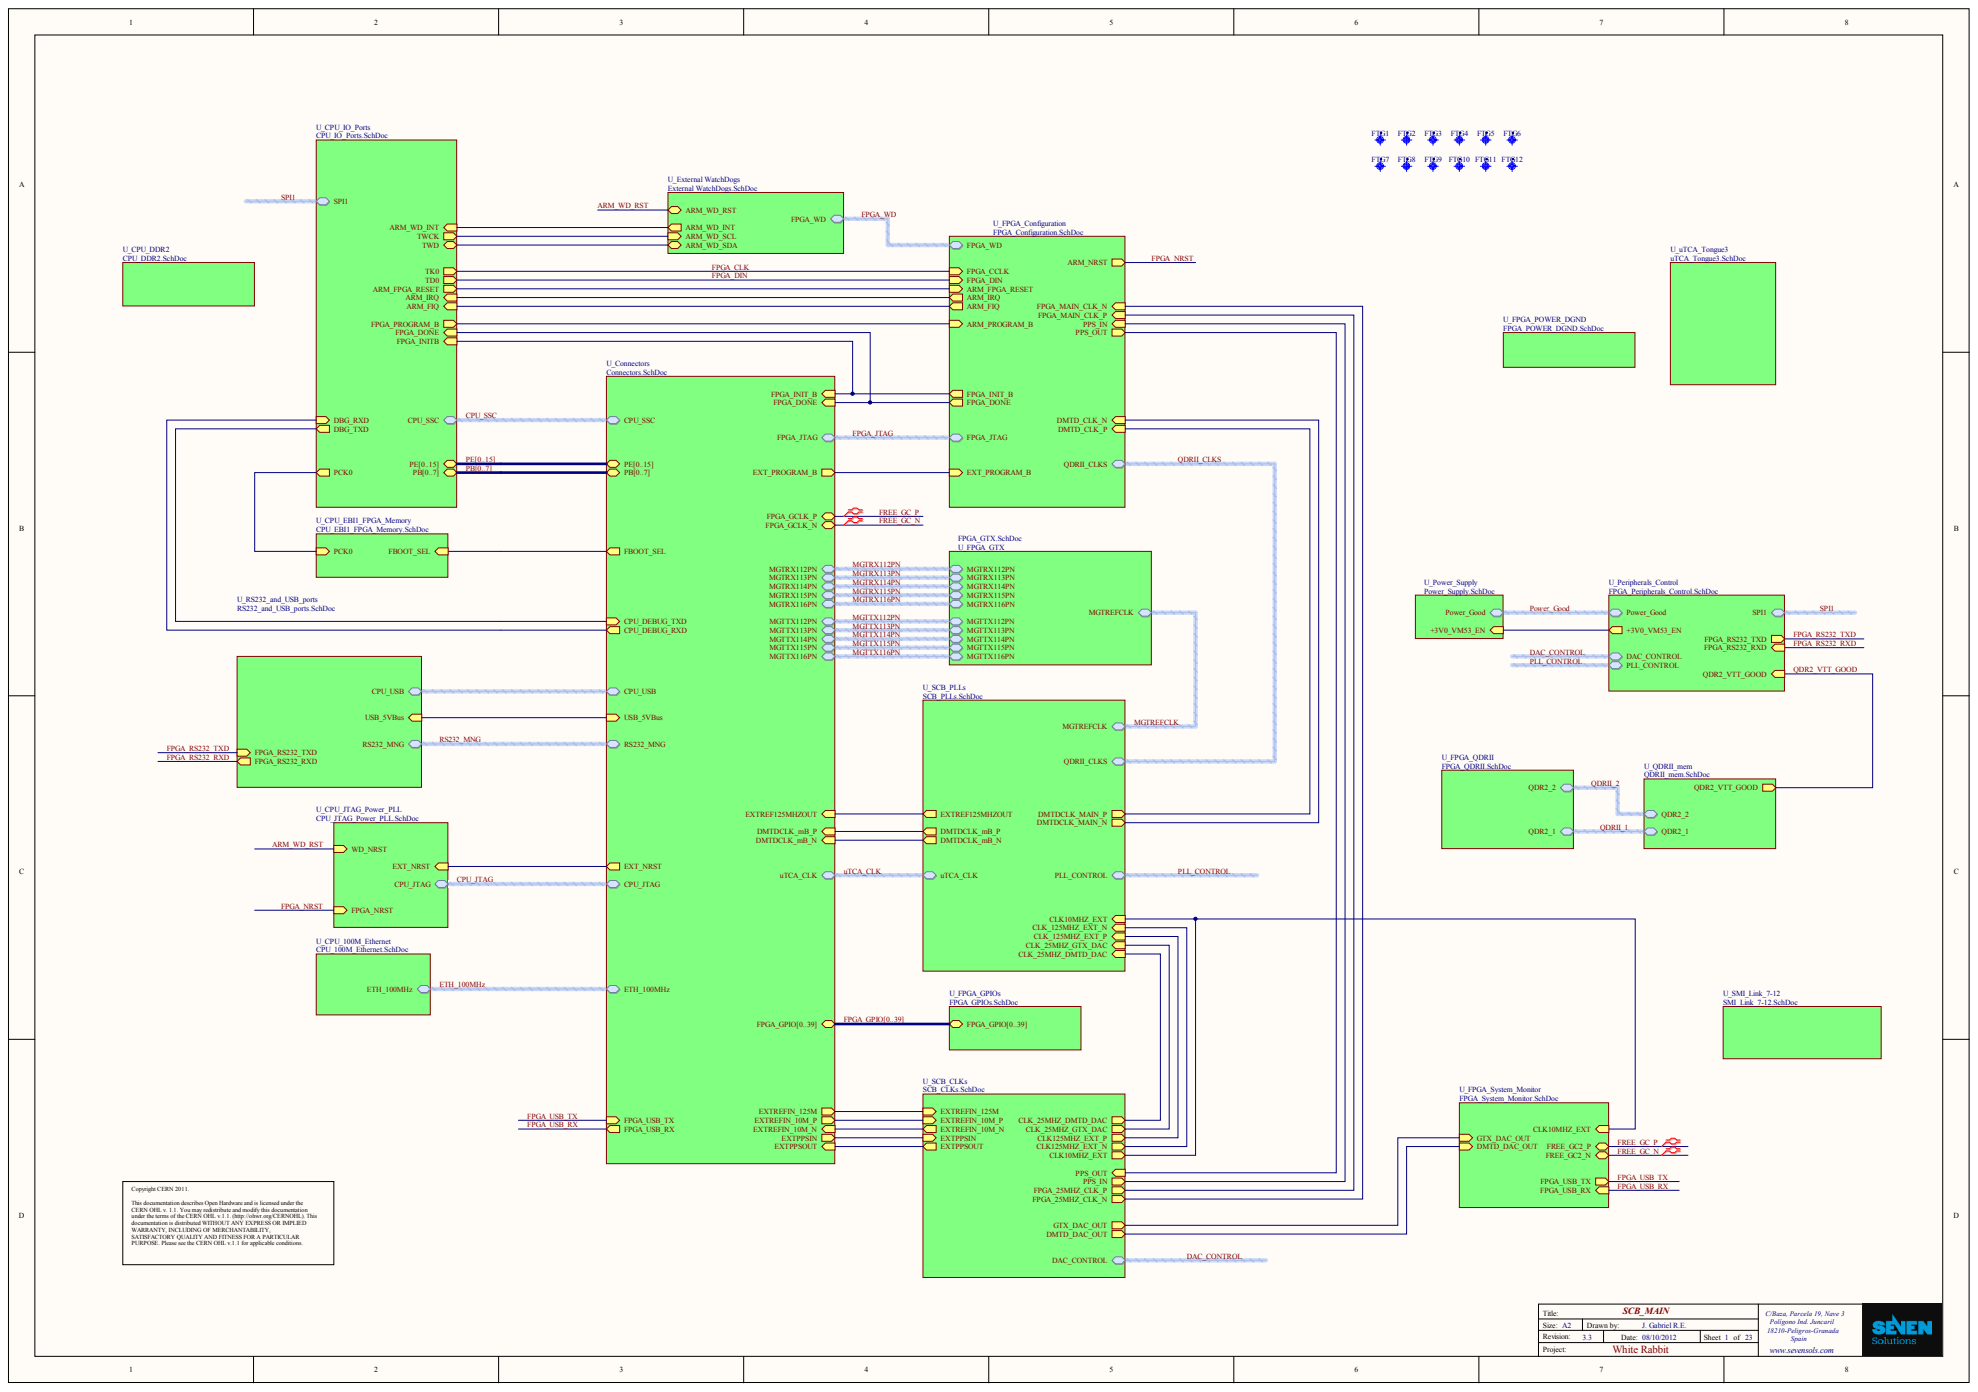
[picture p91: page 1]

FPGA_INIT_B

DBG_RXD CPU_SSC DBG_TXD

CPU_SSC | | FPGA_JTAG

This documentation describes Open Hardware and is licensed under the
CERN OHL v. 1.1. You may redistribute and modify this documentation
under the terms of the CERN OHL v.1.1. (http://ohwr.org/CERNOHL). This
documentation is distributed WITHOUT ANY EXPRESS OR IMPLIED
WARRANTY, INCLUDING OF MERCHANTABILITY,
SATISFACTORY QUALITY AND FITNESS FOR A PARTICULAR
PURPOSE. Please see the CERN OHL v.1.1 for applicable conditions.

Title: SCB_MAIN | C/Baza, Parcela 19, Nave 3 Polígono Ind. Juncaril 18210-Peligros-Granada Spain www.sevensols.com

Size: A2 | Drawn by: J. Gabriel R.E.
Revision: | Date: | Sheet of 23

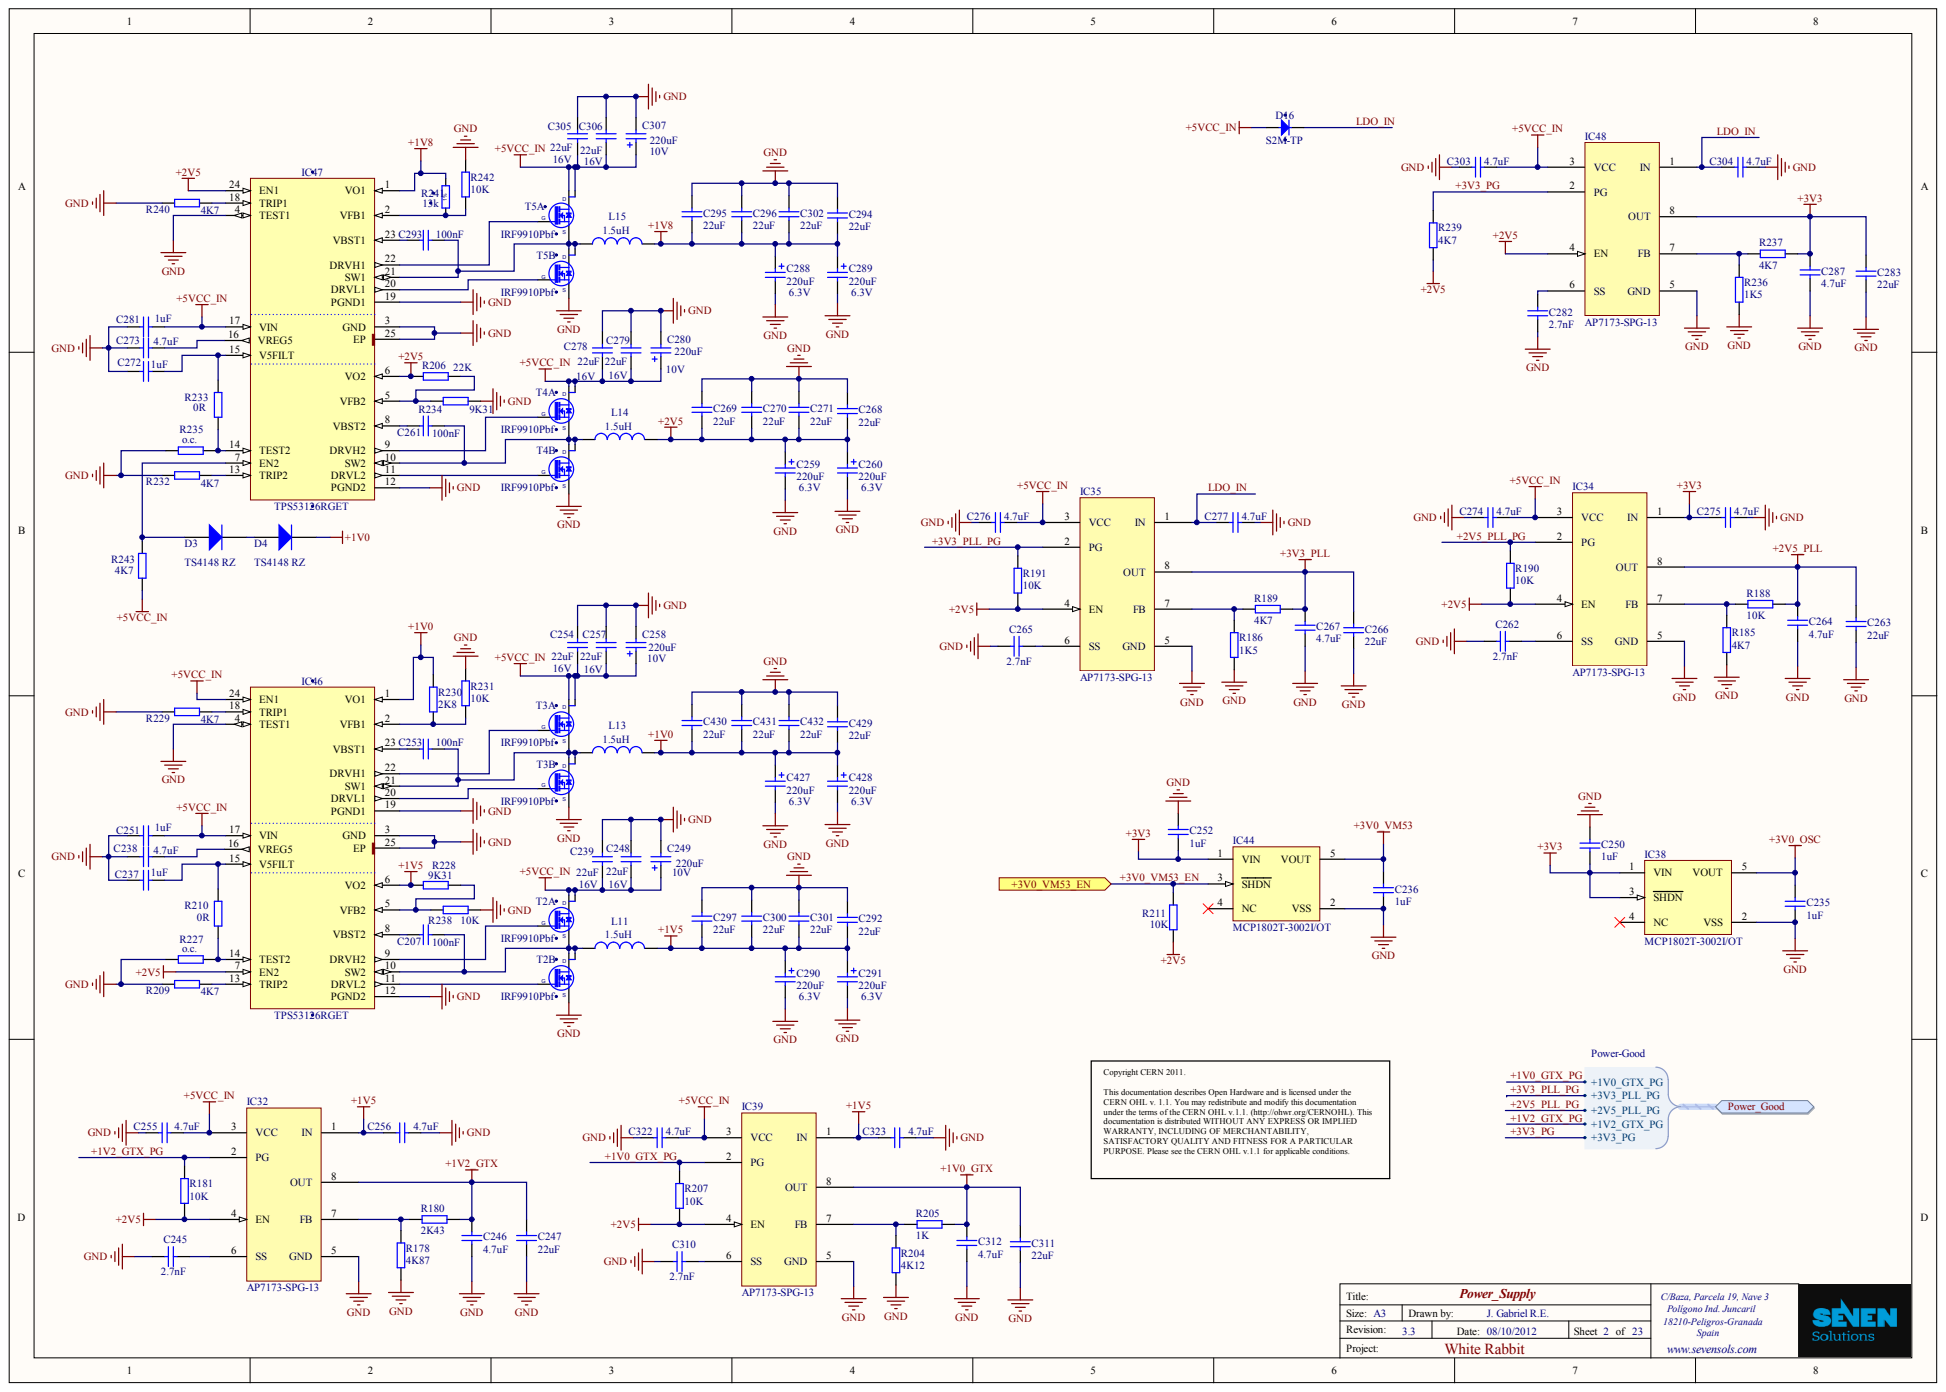
[picture p92: page 2]
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

Power_Supply | 18210-Peligros-Granada Spain

A3 | J. Gabriel R.E.

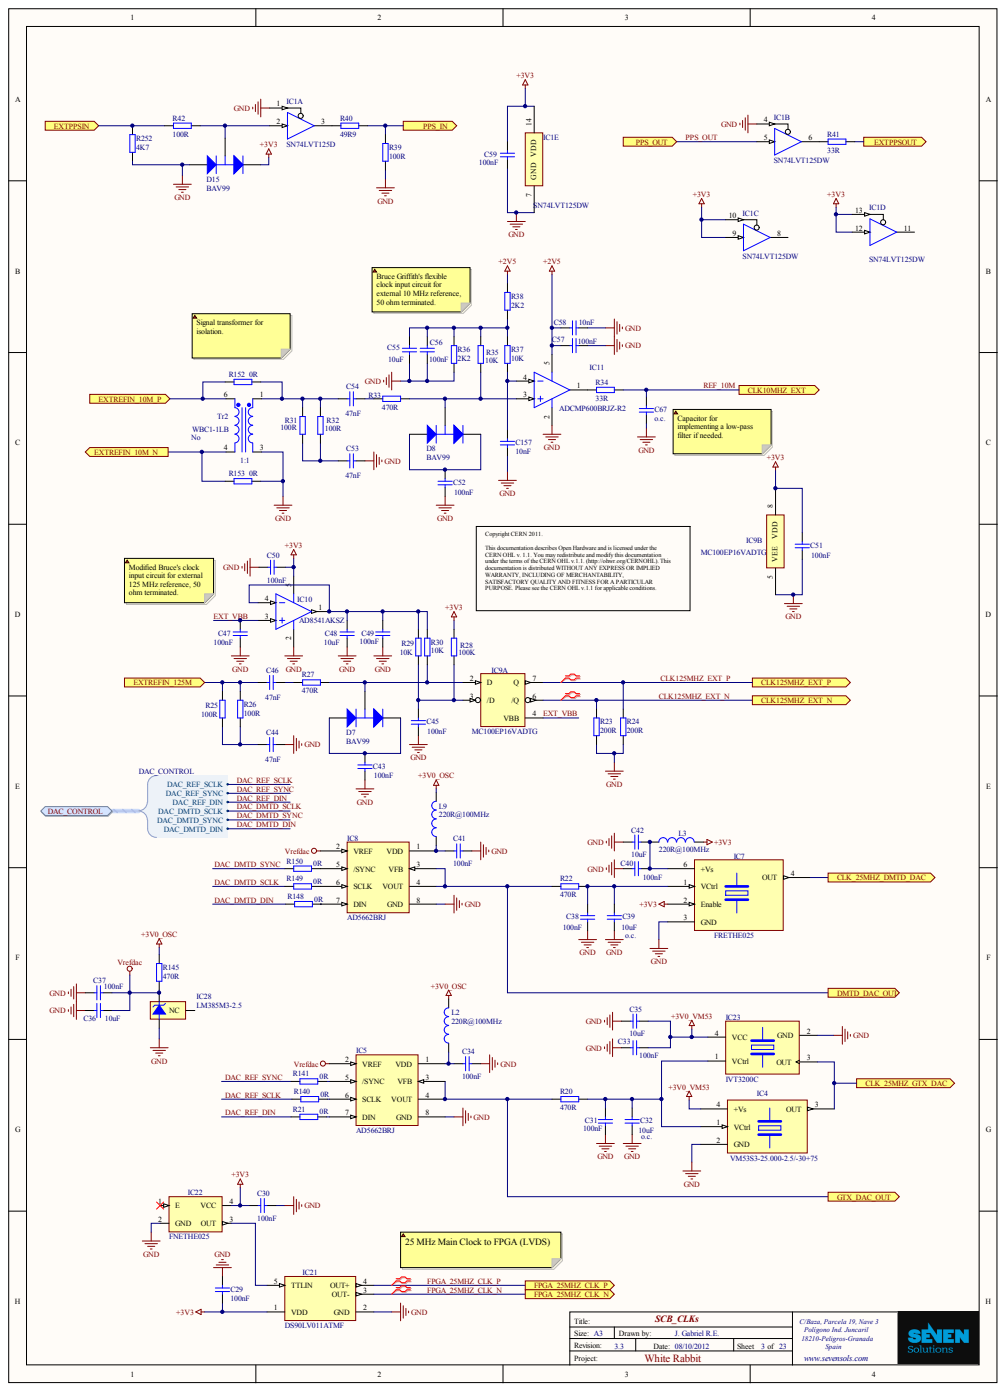
[picture p93: page 3]

Bruce Griffith's flexible
clock input circuit for
external 10 MHz reference,
50 ohm terminated.

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

Modified Bruce's clock
input circuit for external
125 MHz reference, 50
ohm terminated.

25 MHz Main Clock to FPGA (LVDS)

SCB_CLKs | 18210-Peligros-Granada Spain

A3 | J. Gabriel R.E.

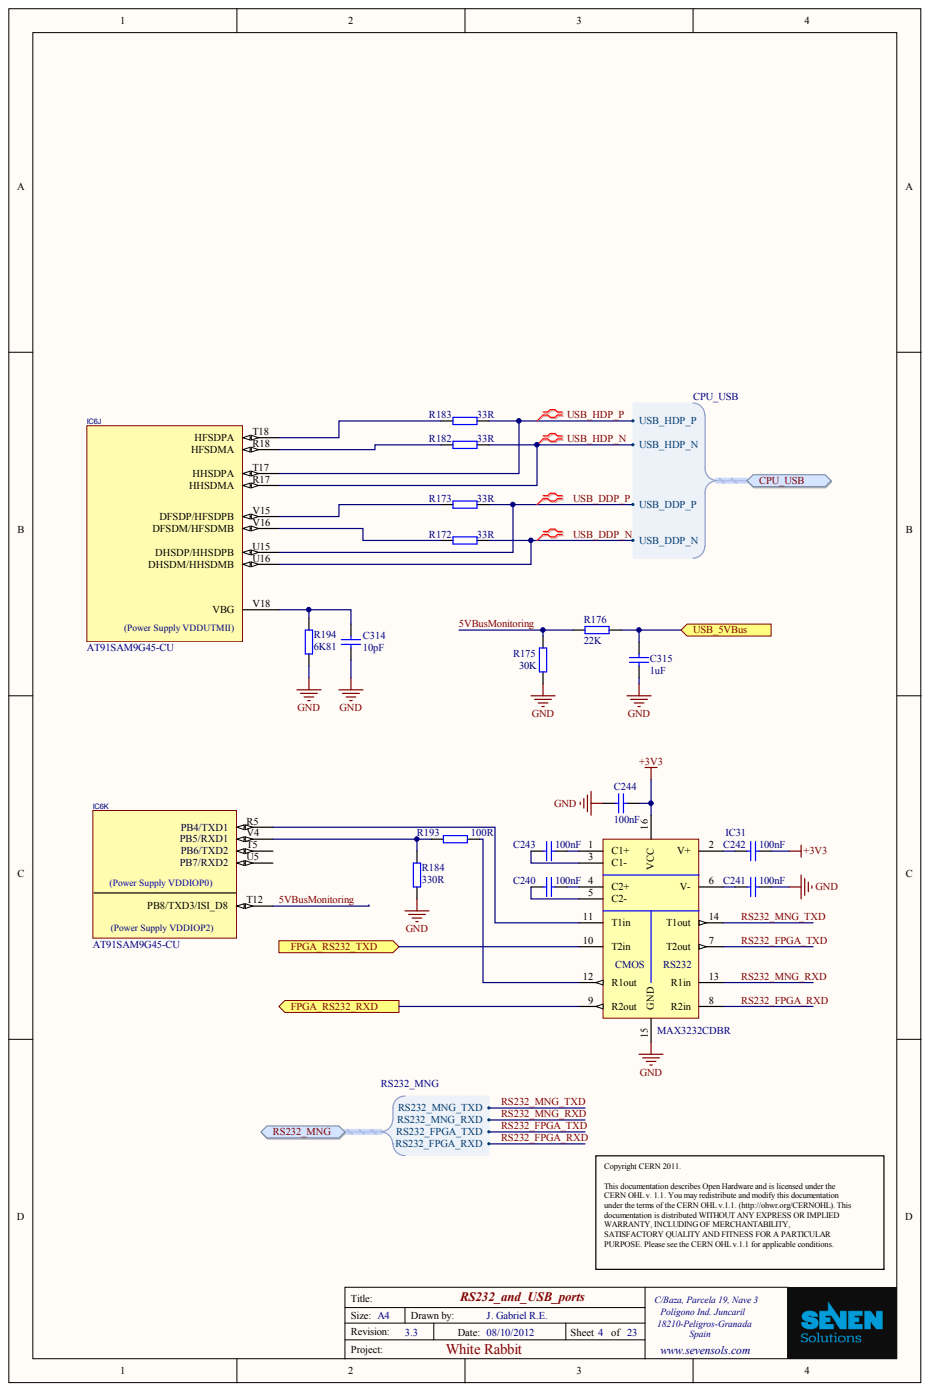
[picture p94: page 4]
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

RS232_and_USB_ports | Spain

A4 | J. Gabriel R.E.

18210-Peligros-Granada 23

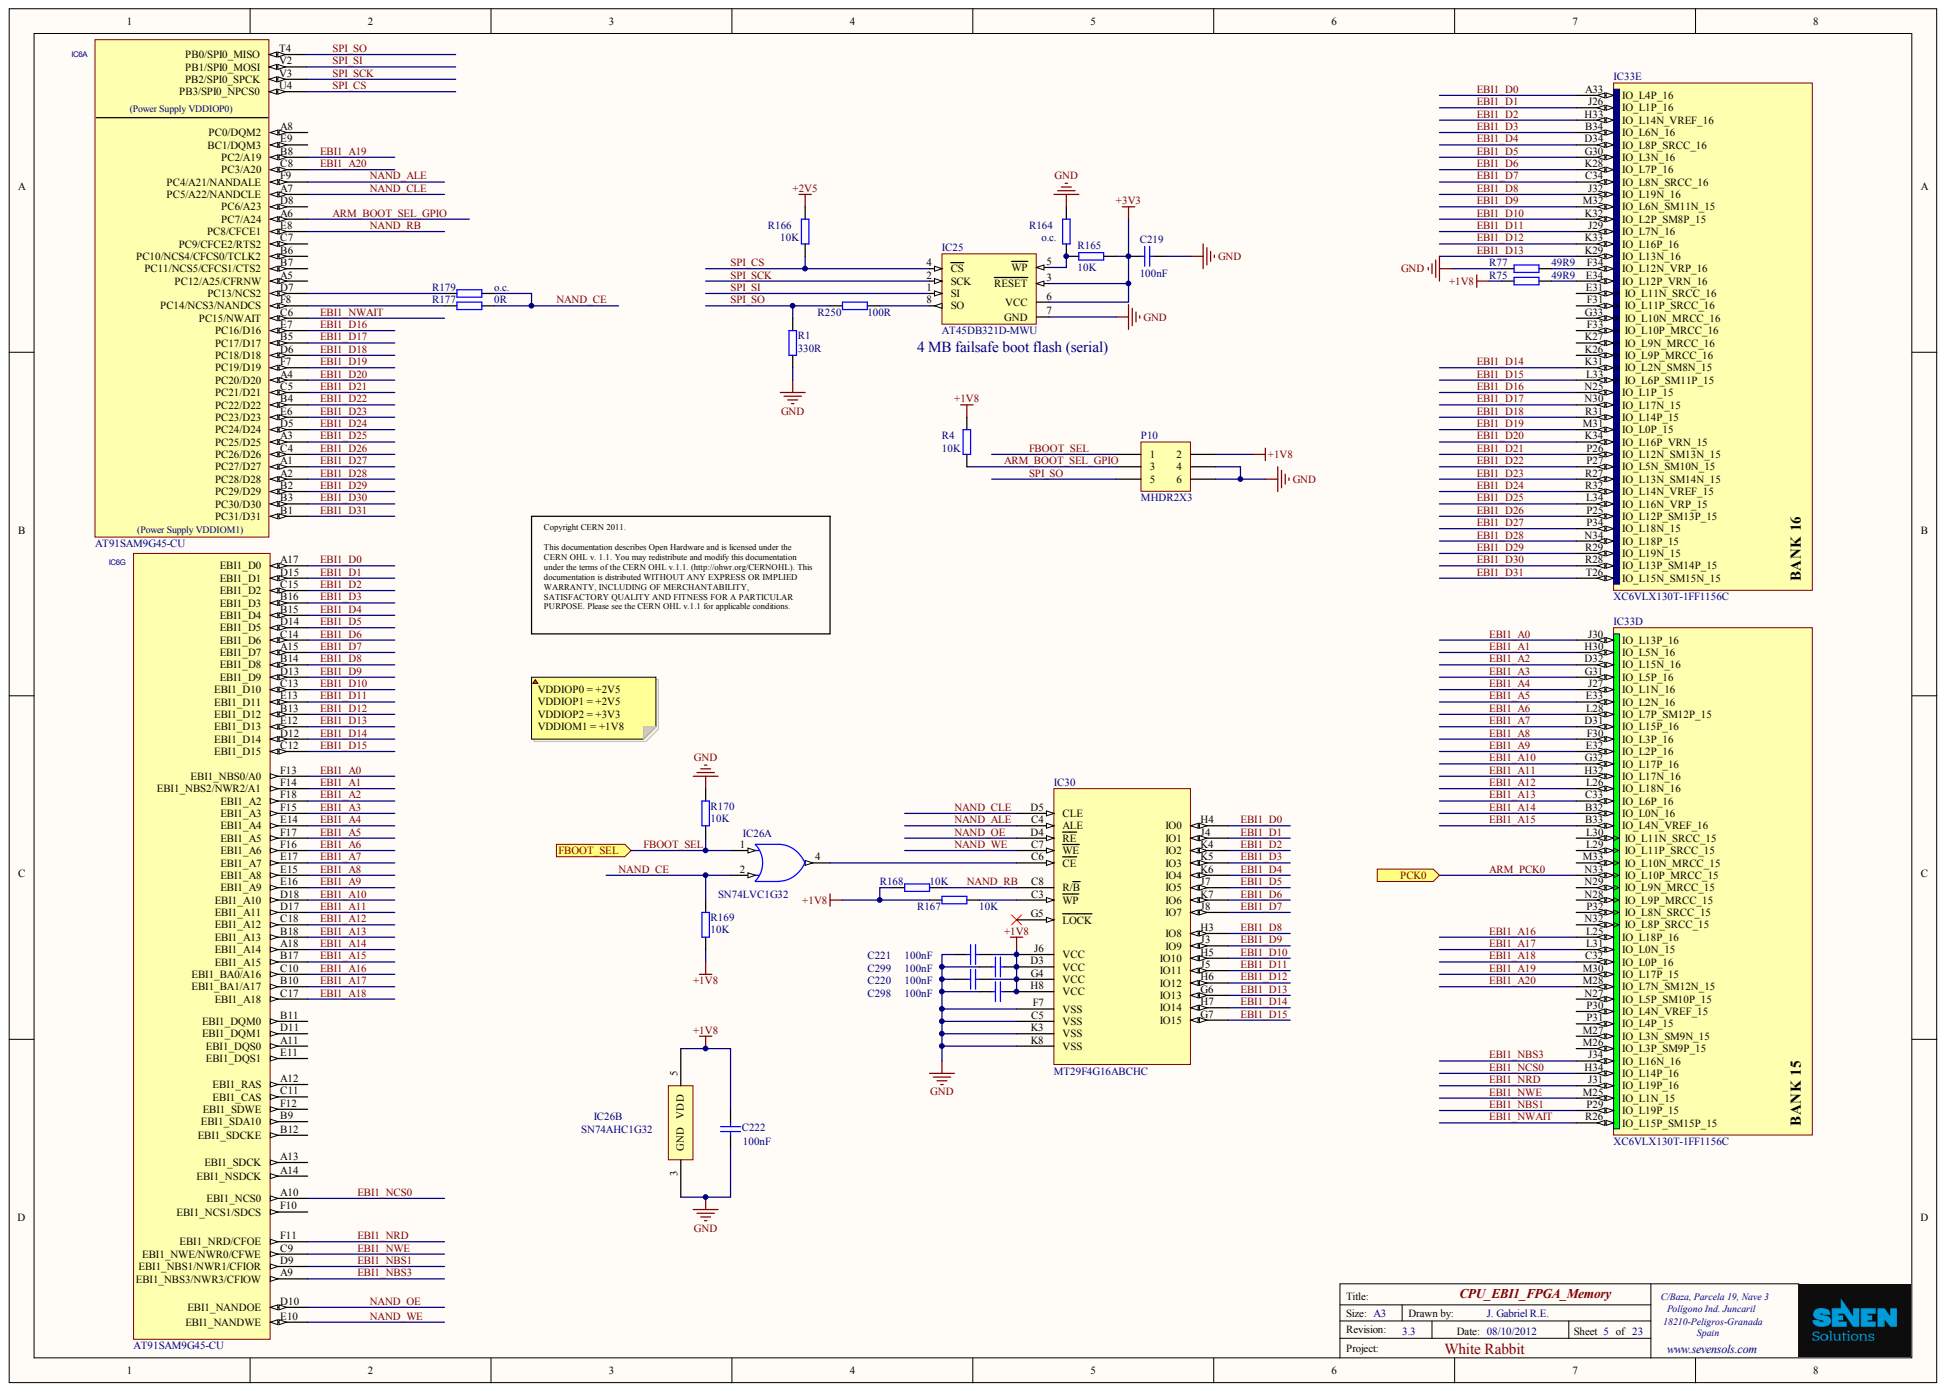
[picture p95: page 5]

Thi
CERN O
under the terms of the CERN

Titl e : CP U_ EBI1_ FP GA_ Mem o ry | C/Baza, Parcela 19, Nave 3 Polígono Ind. Juncaril 18210-P e l igros-Granada Spai n www. s e v e n s ols.c o m

S i z e : A 3 | Dr awn b y : J. G abri e l R.E.
Re v i s i o n : . | Date : / / | S h e e t o f 3

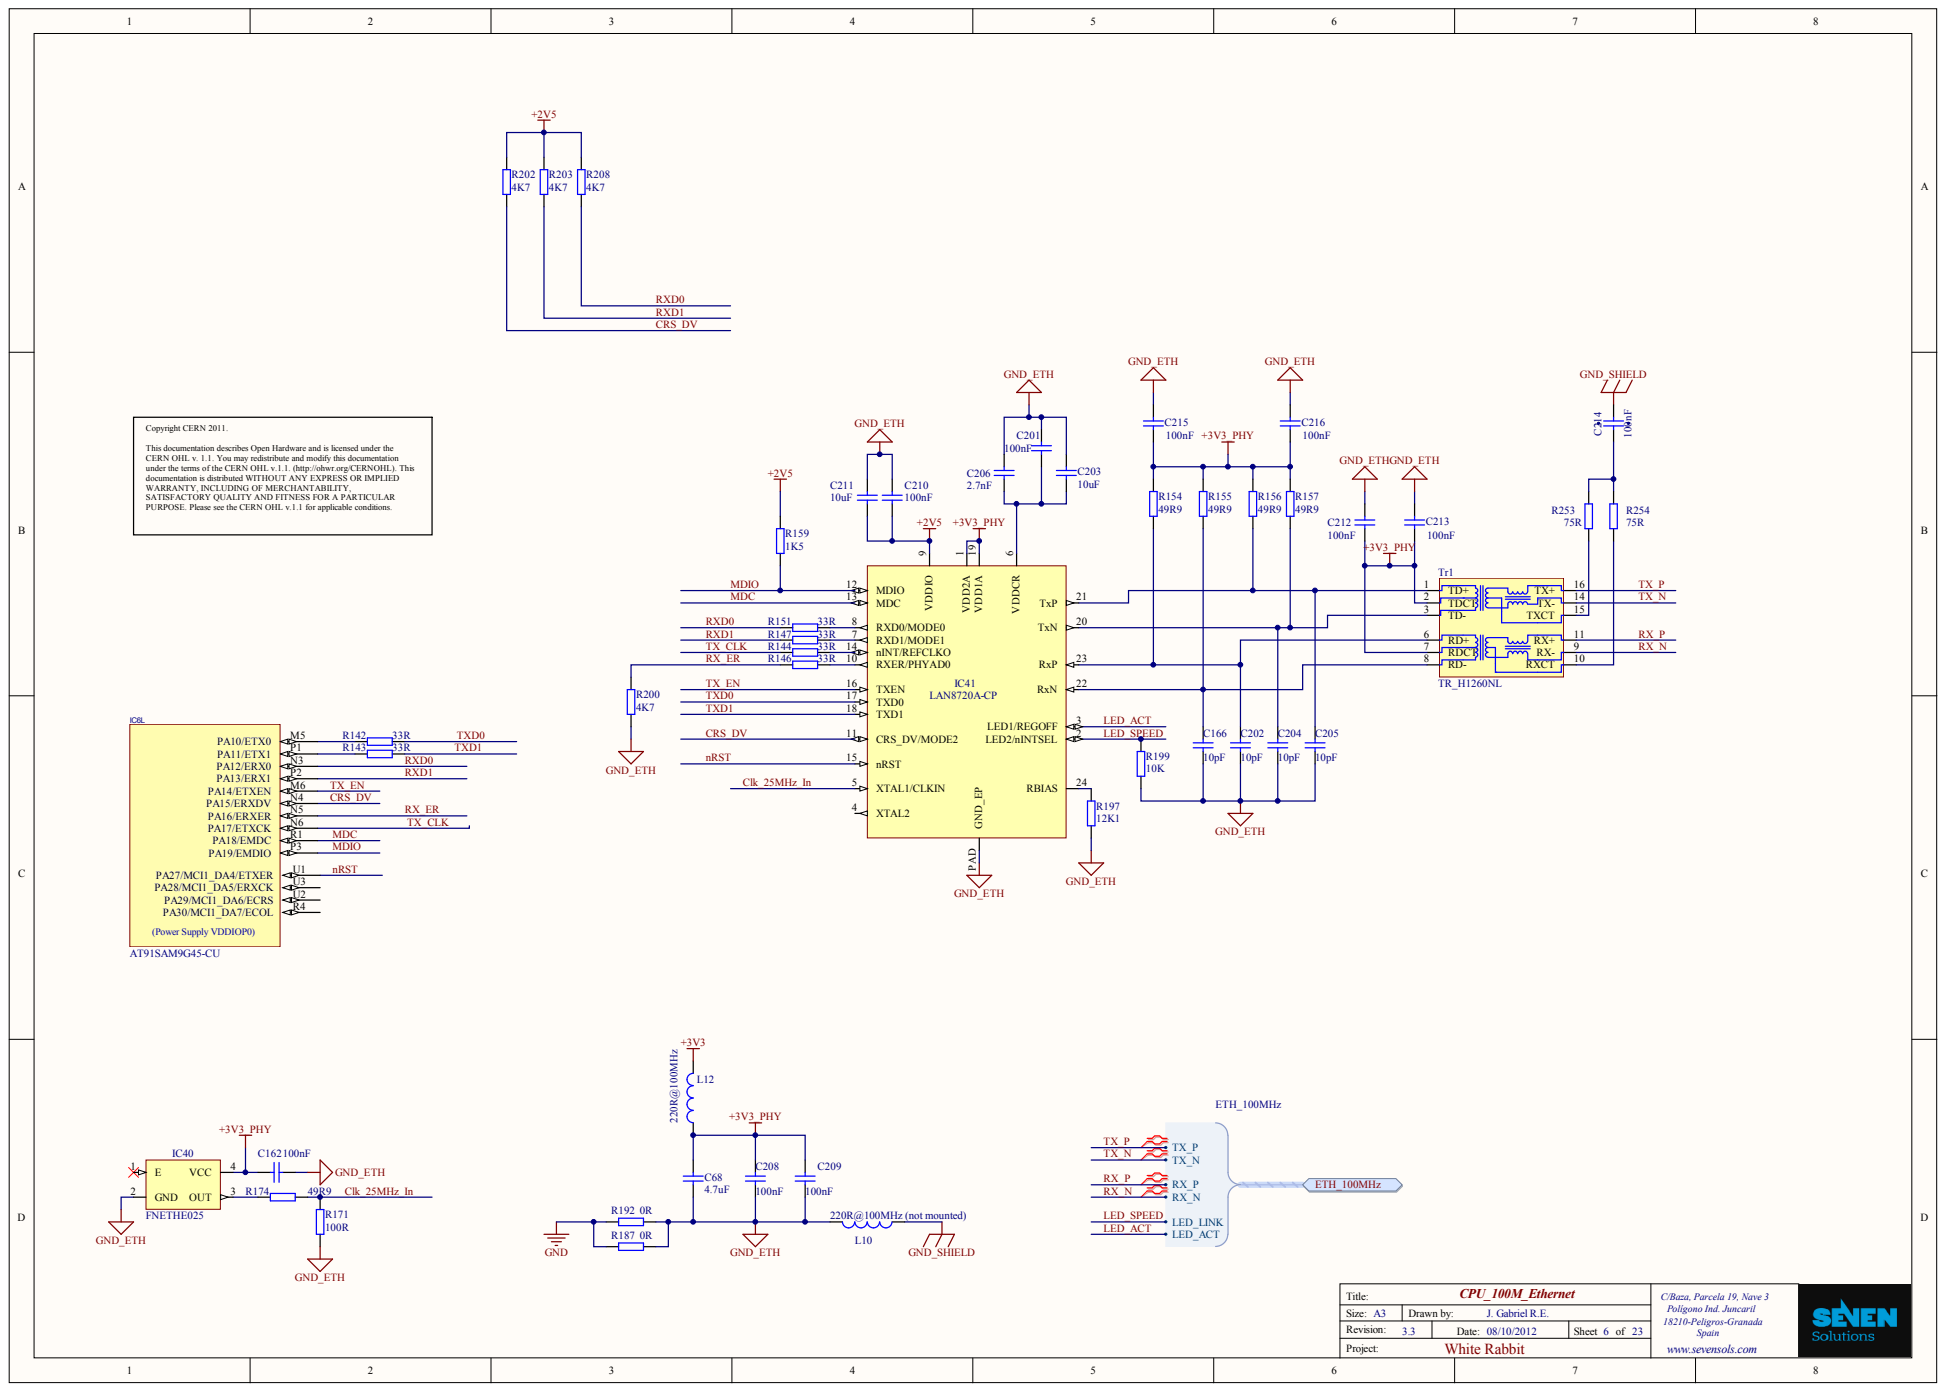
[picture p96: page 6]
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

CPU_100M_Ethernet | 18210-Peligros-Granada Spain

A3 | J. Gabriel R.E.

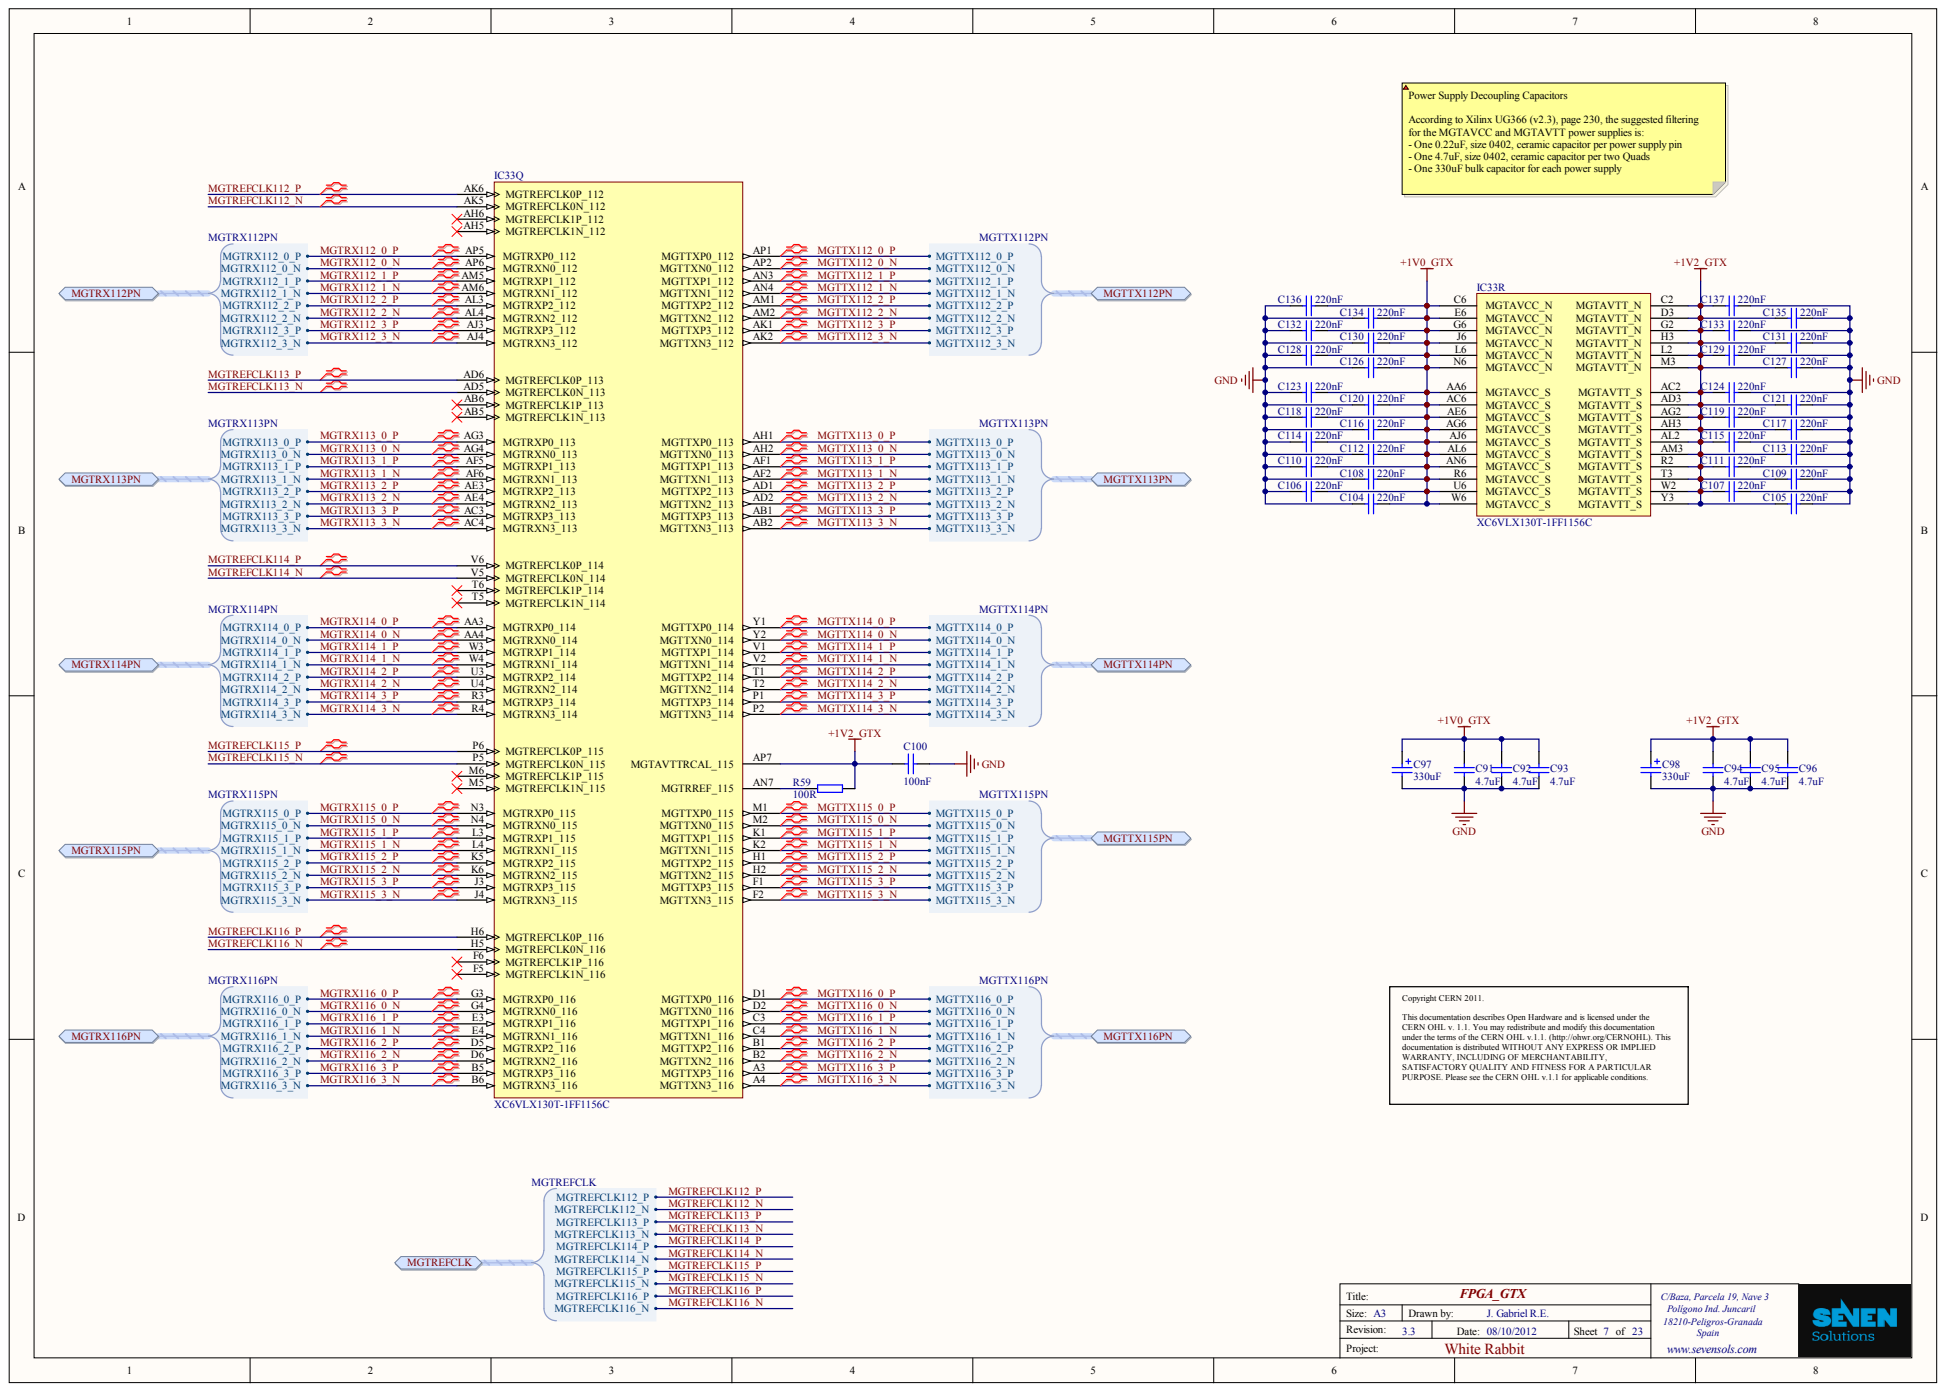
[picture p97: page 7]

Power Supply Decoupling Capacitors

According to Xilinx UG366 (v2.3), page 230, the suggested filtering
for the MGTAVCC and MGTAVTT power supplies is:
- One 0.22uF, size 0402, ceramic capacitor per power supply pin
- One 4.7uF, size 0402, ceramic capacitor per two Quads
- One 330uF bulk capacitor for each power supply

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

FPGA_GTX | 18210-Peligros-Granada Spain

A3 | J. Gabriel R.E.

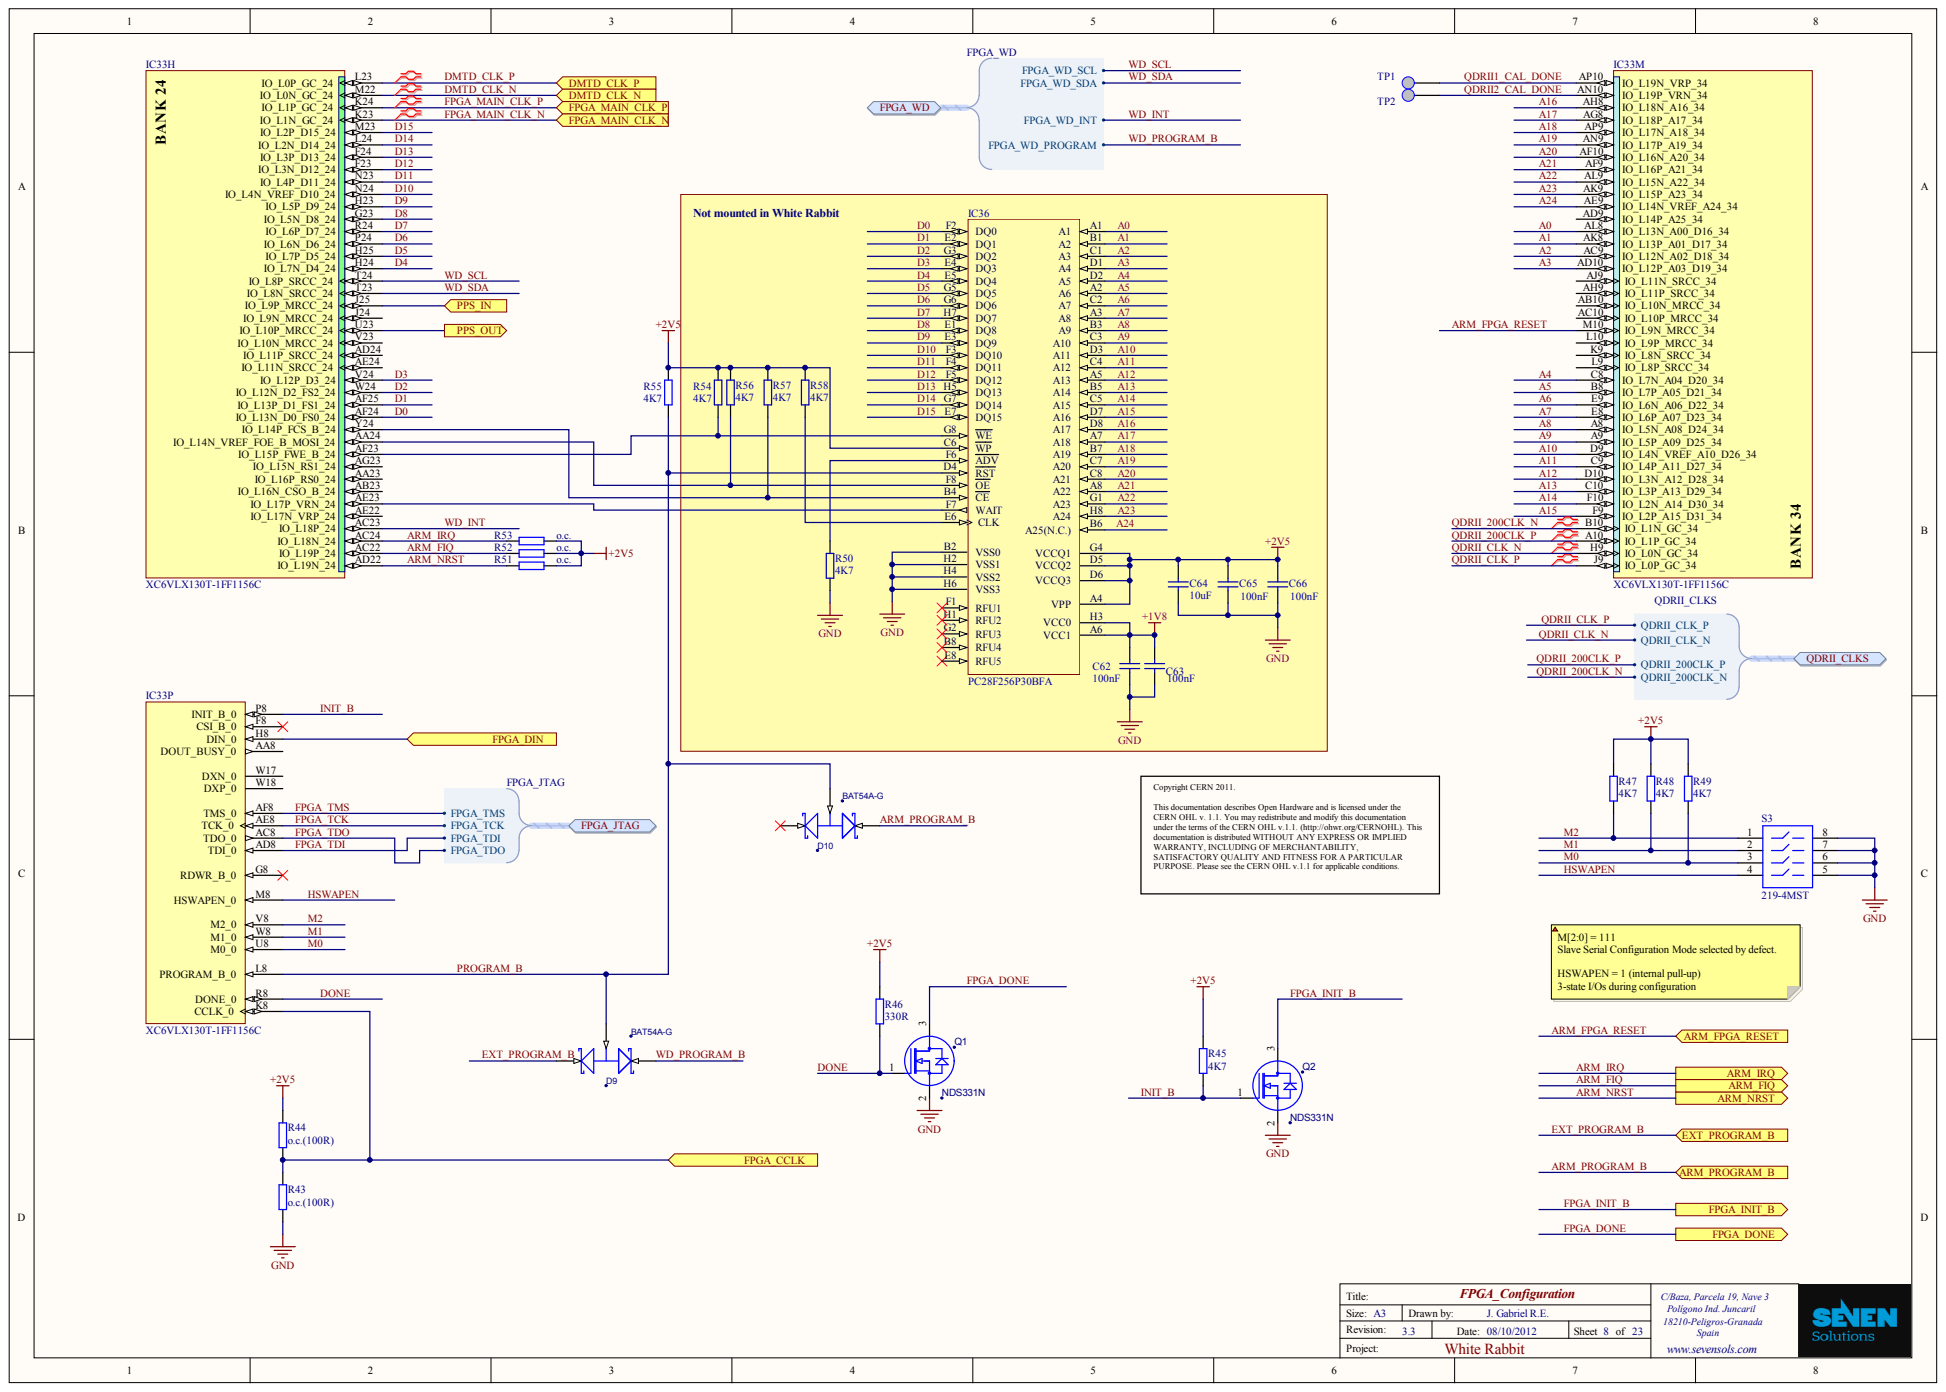
[picture p98: page 8]

Not mounted in White Rabbit

RST D4
OE F8

WAIT F7

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

Slave Serial Configuration Mode selected by defect.

HSWAPEN = 1 (internal pull-up)
3-state I/Os during configuration

FPGA_Configuration | 18210-Peligros-Granada Spain

A3 | J. Gabriel R.E.

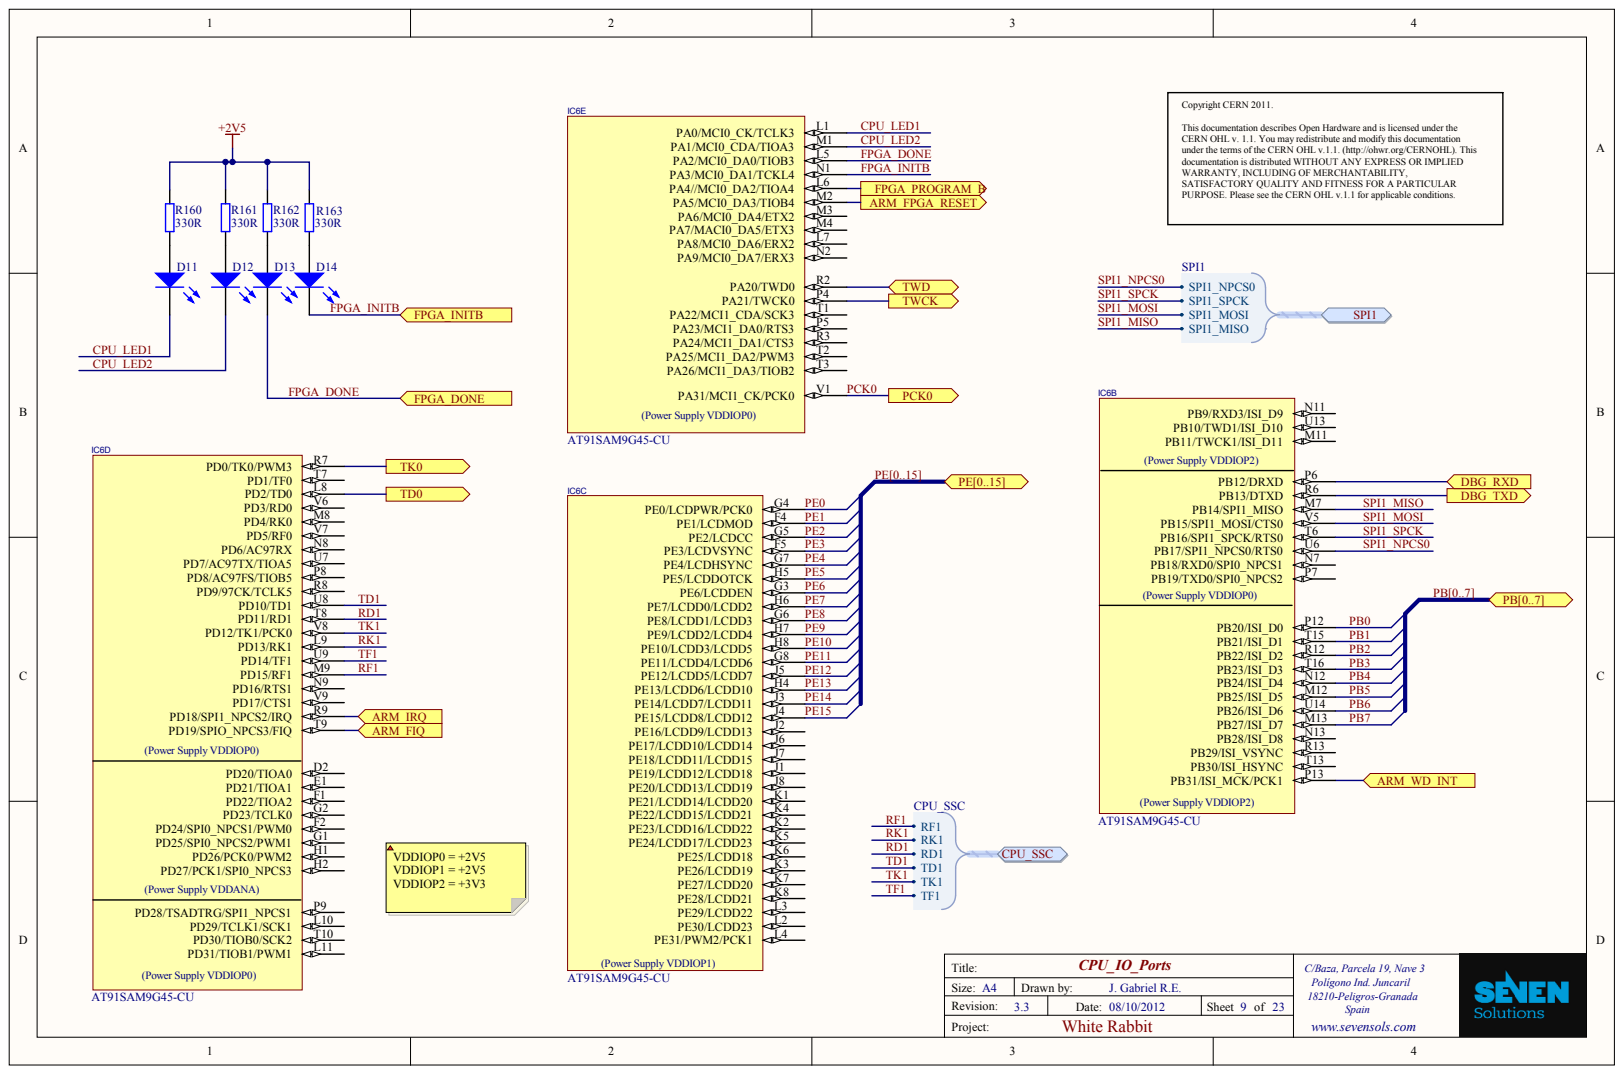
[picture p99: page 9]
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

CPU_IO_Ports Title: | C/Baza, Parcela 19, Nave 3 Polígono Ind. Juncaril 18210-Peligros-Granada Spain

Size: A4 | Drawn by: J. Gabriel R.E.
Revision: 3.3 | Date: 08/10/2012 | Sheet 9 of 23

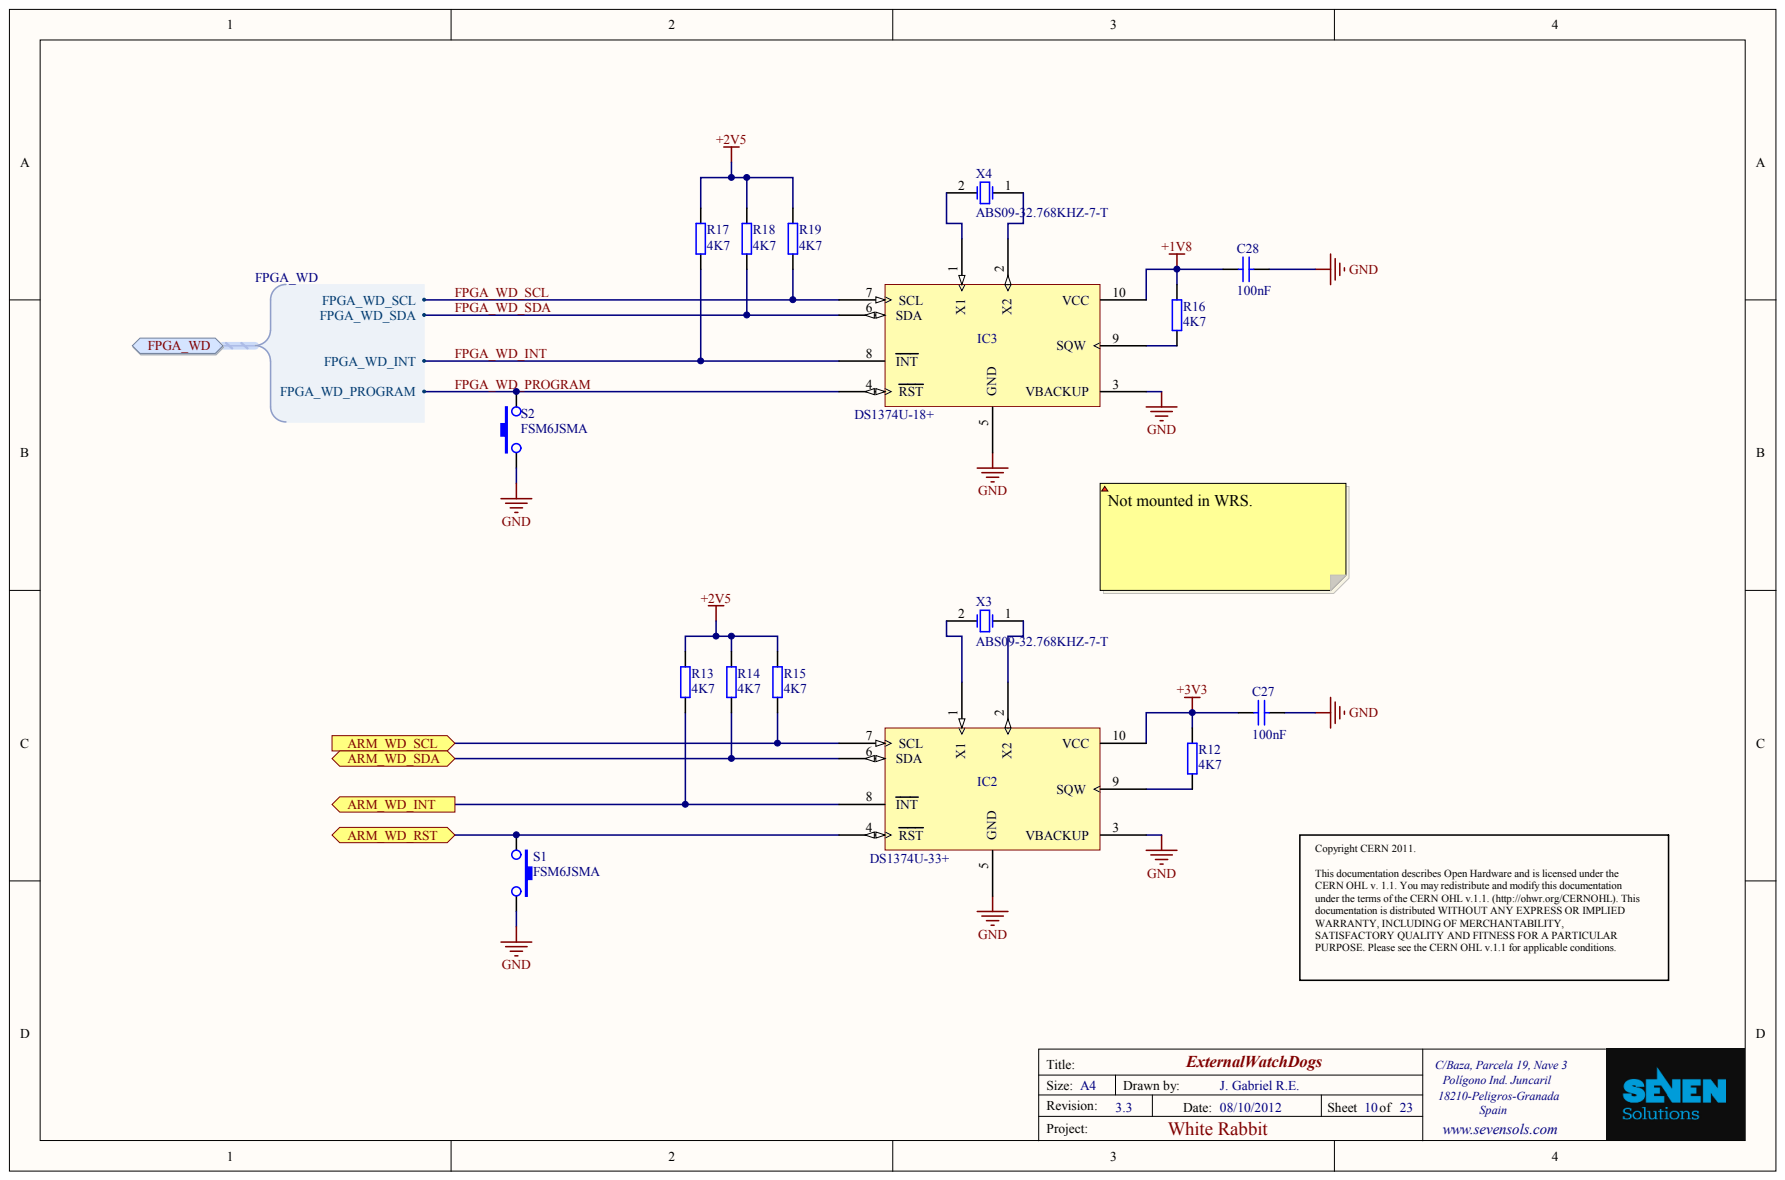
[picture p100: page 10]

Not mounted in WRS.

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

ExternalWatchDogs Title: | C/Baza, Parcela 19, Nave 3 Polígono Ind. Juncaril 18210-Peligros-Granada Spain

Size: A4 | Drawn by: J. Gabriel R.E.
Revision: 3.3 | Date: 08/10/2012 | Sheet 10 of 23

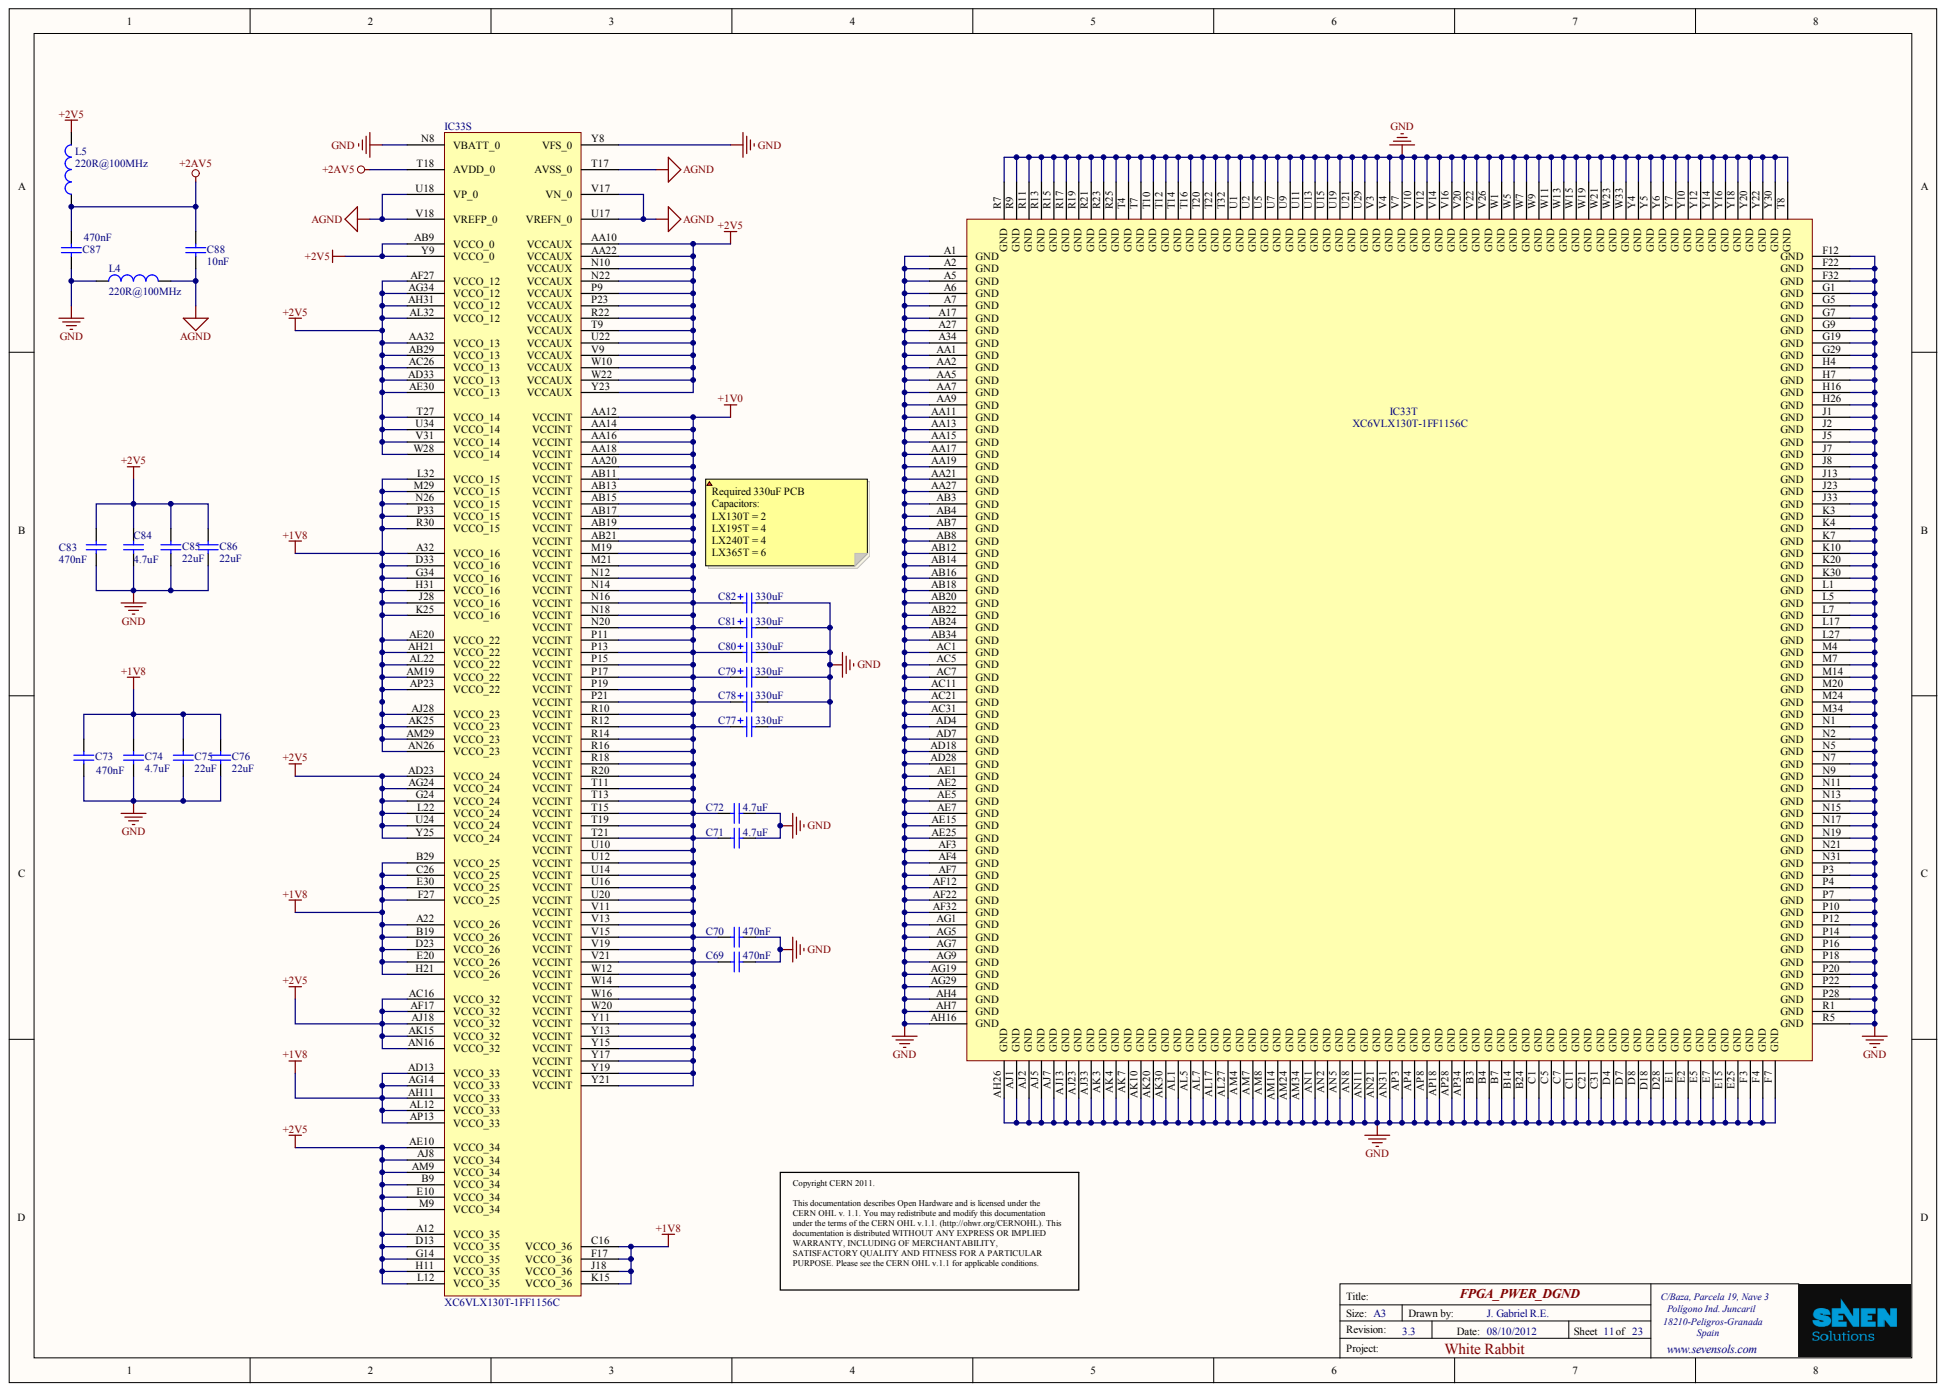
[picture p101: page 11]

AA9
AA 1 1

AB1 8
AB2 0

AF 3
AF 4
AF 7
AF 1 2

AG 1
AG 5

AL 1 2
AP1 3

AJ8
AM9

Titl e : FP GA_ P WER_ D GND | C/Baza, Parcela 19, Nave 3 Polígono Ind. Juncaril 18210-P e l igros-Granada Spai n www. s e v e n s ols.c o m

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

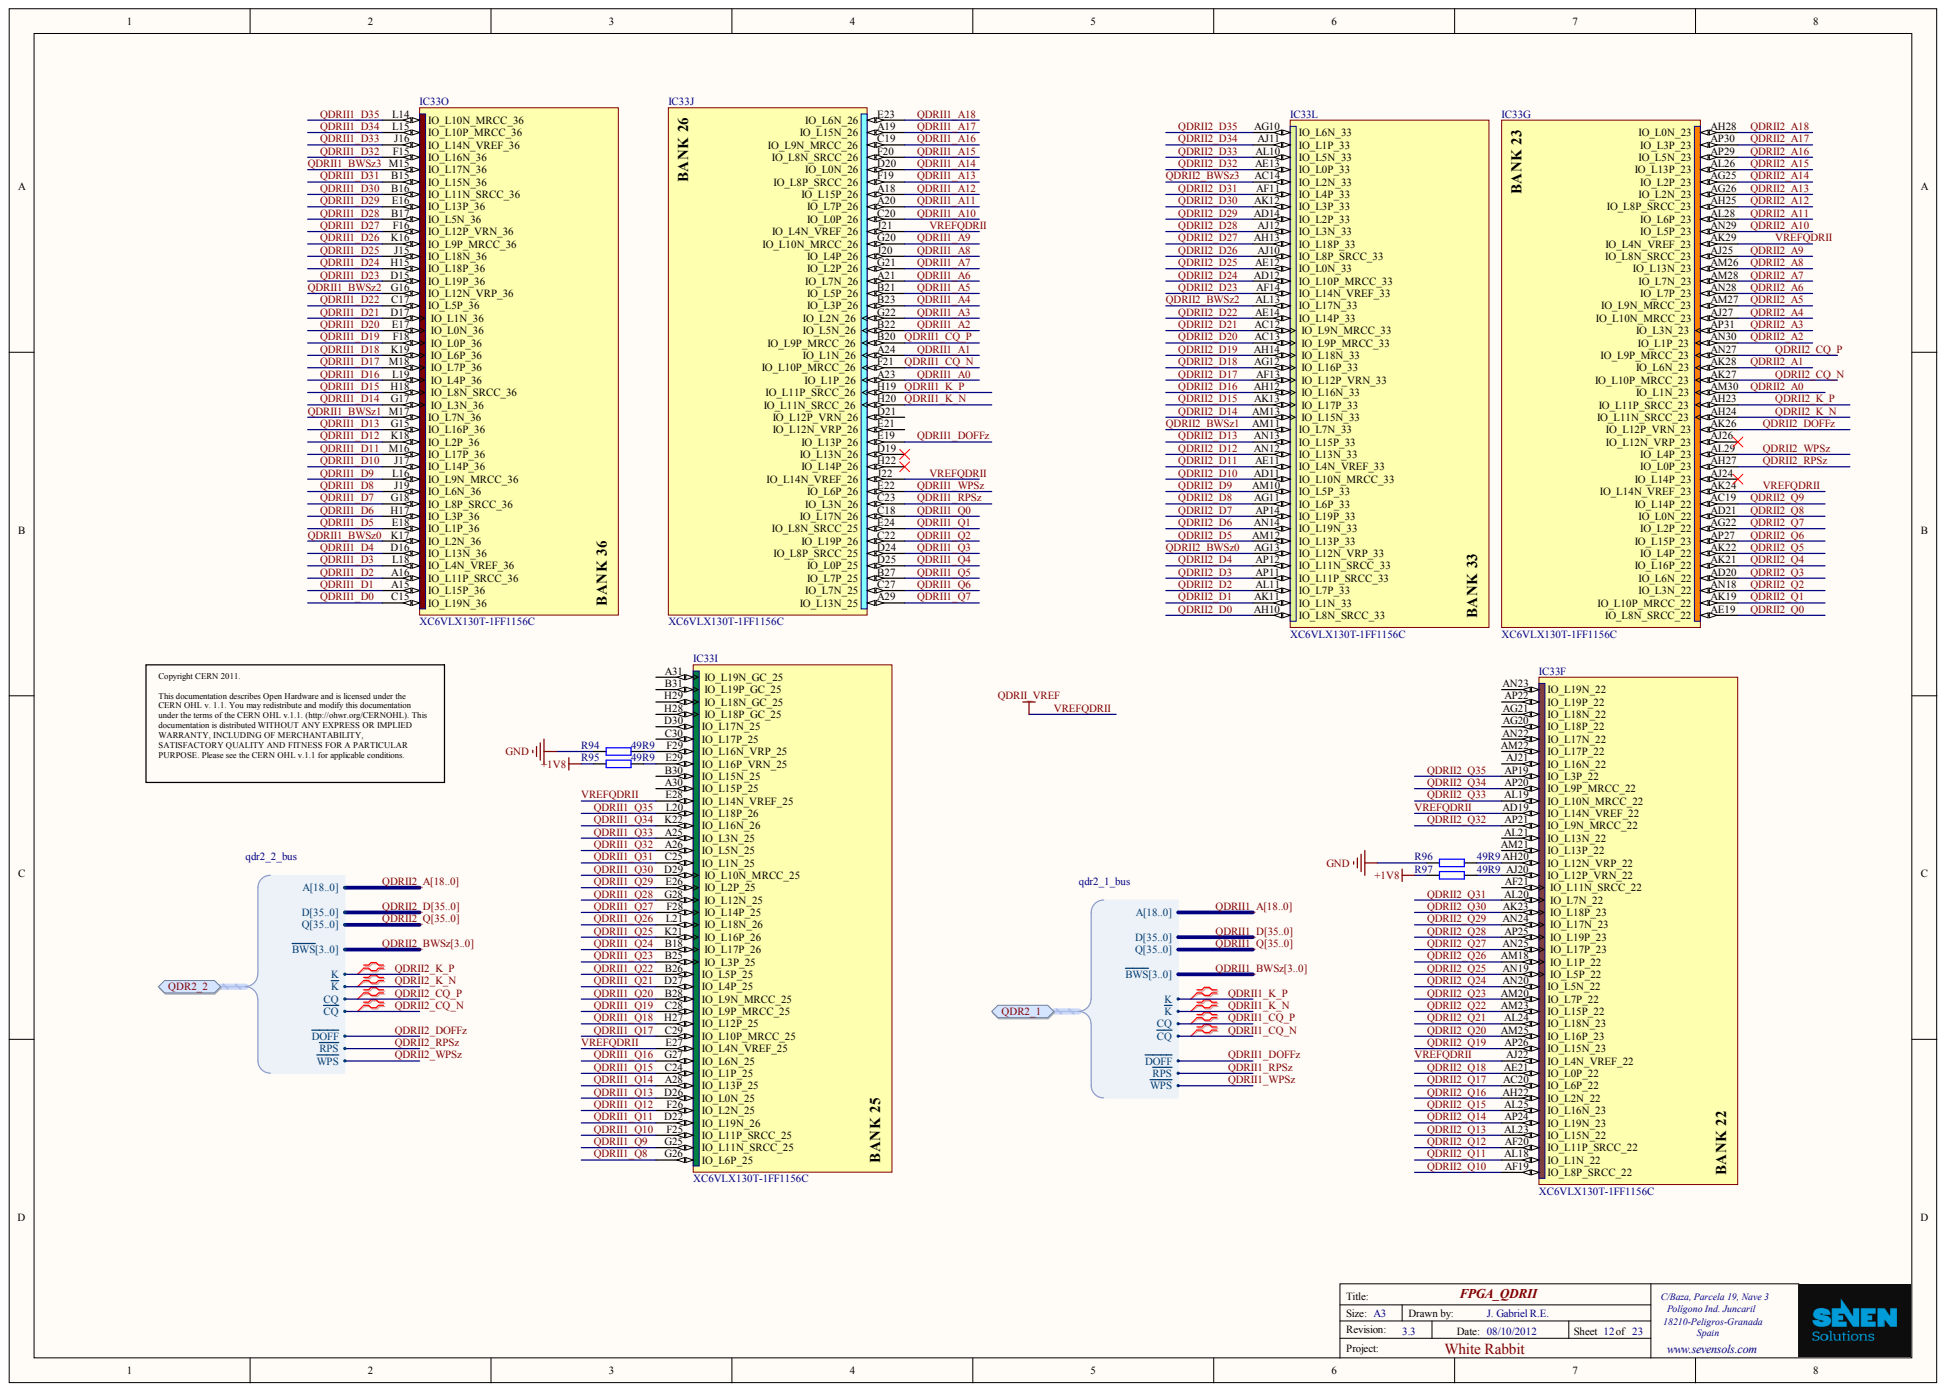
[picture p102: page 12]

Titl e : FP GA_ QDRII | C/Baza, Parcela 19, Nave 3 Polígono Ind. Juncaril 18210-P e l igros-Granada Spai n www. s e v e n s ols.c o m

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

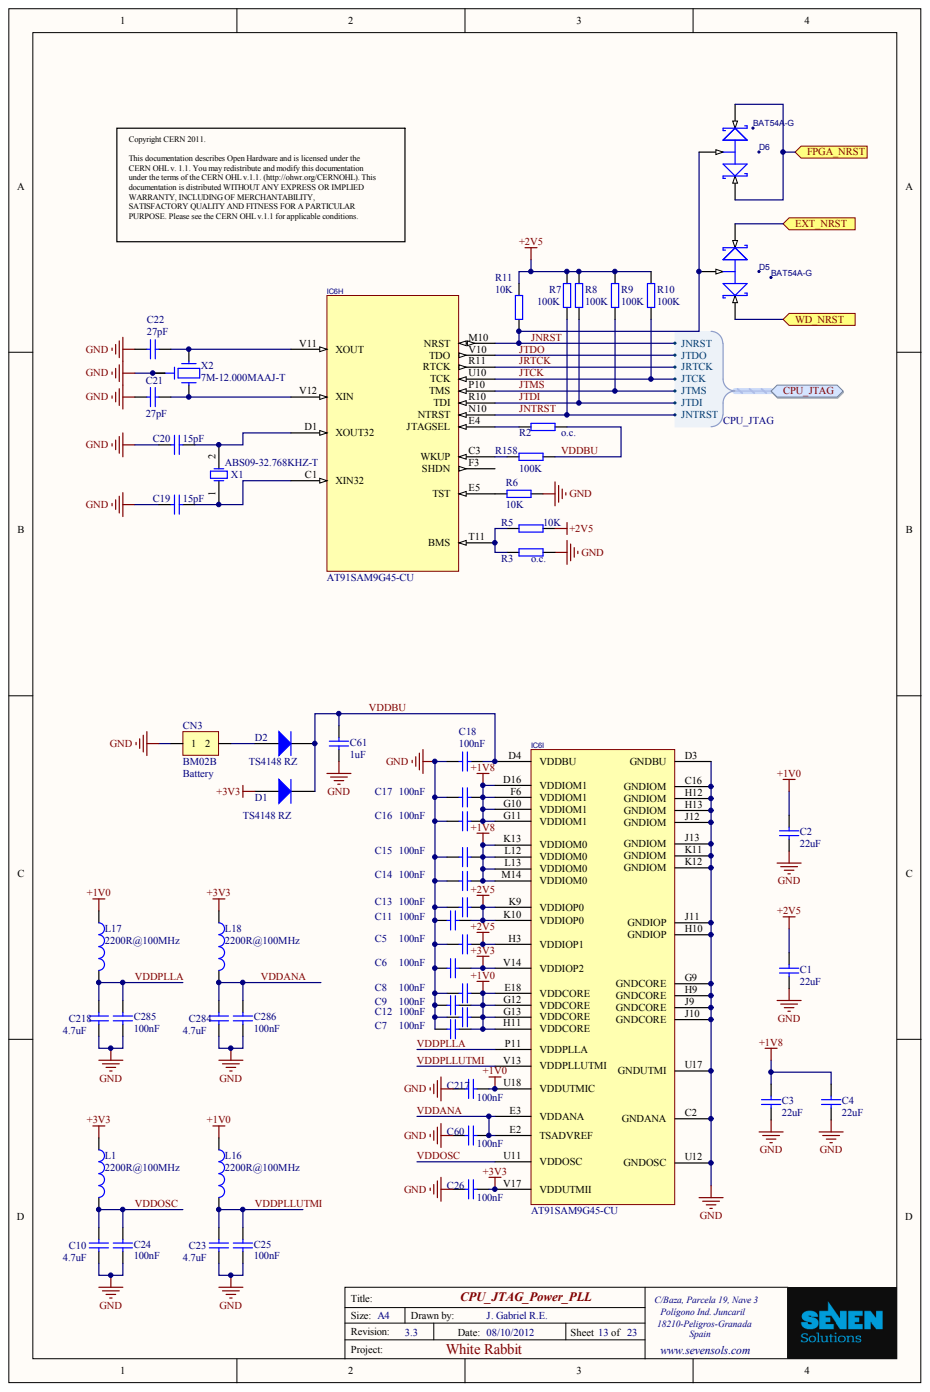
[picture p103: page 13]
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

JTMS
JTDI

XOUT32 D1 | JNTRST

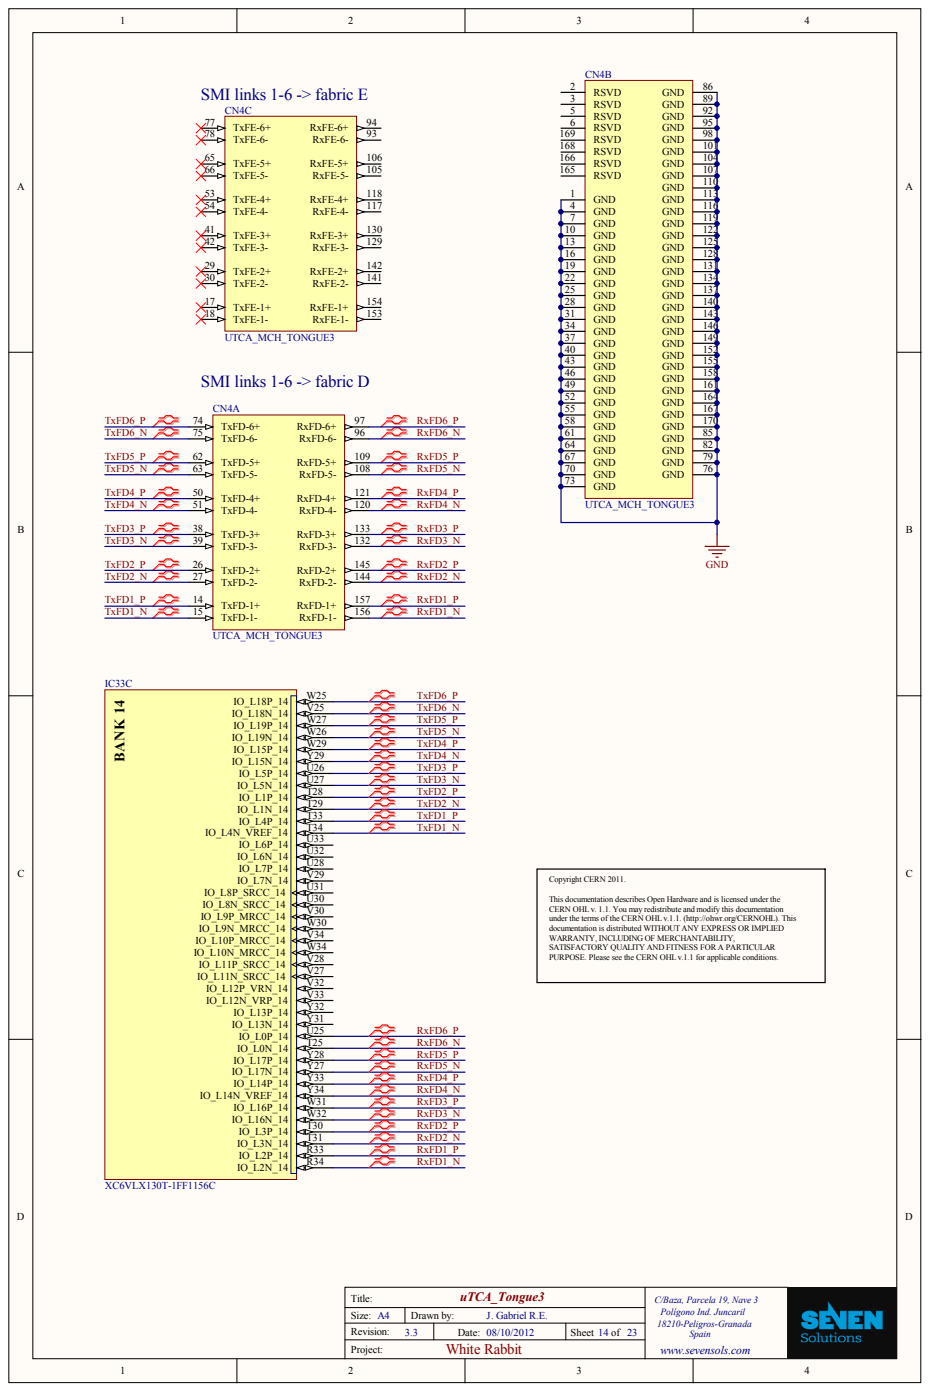
[picture p104: page 14]
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

uTCA_Tongue3 | Spain

A4 | J. Gabriel R.E.

18210-Peligros-Granada 23

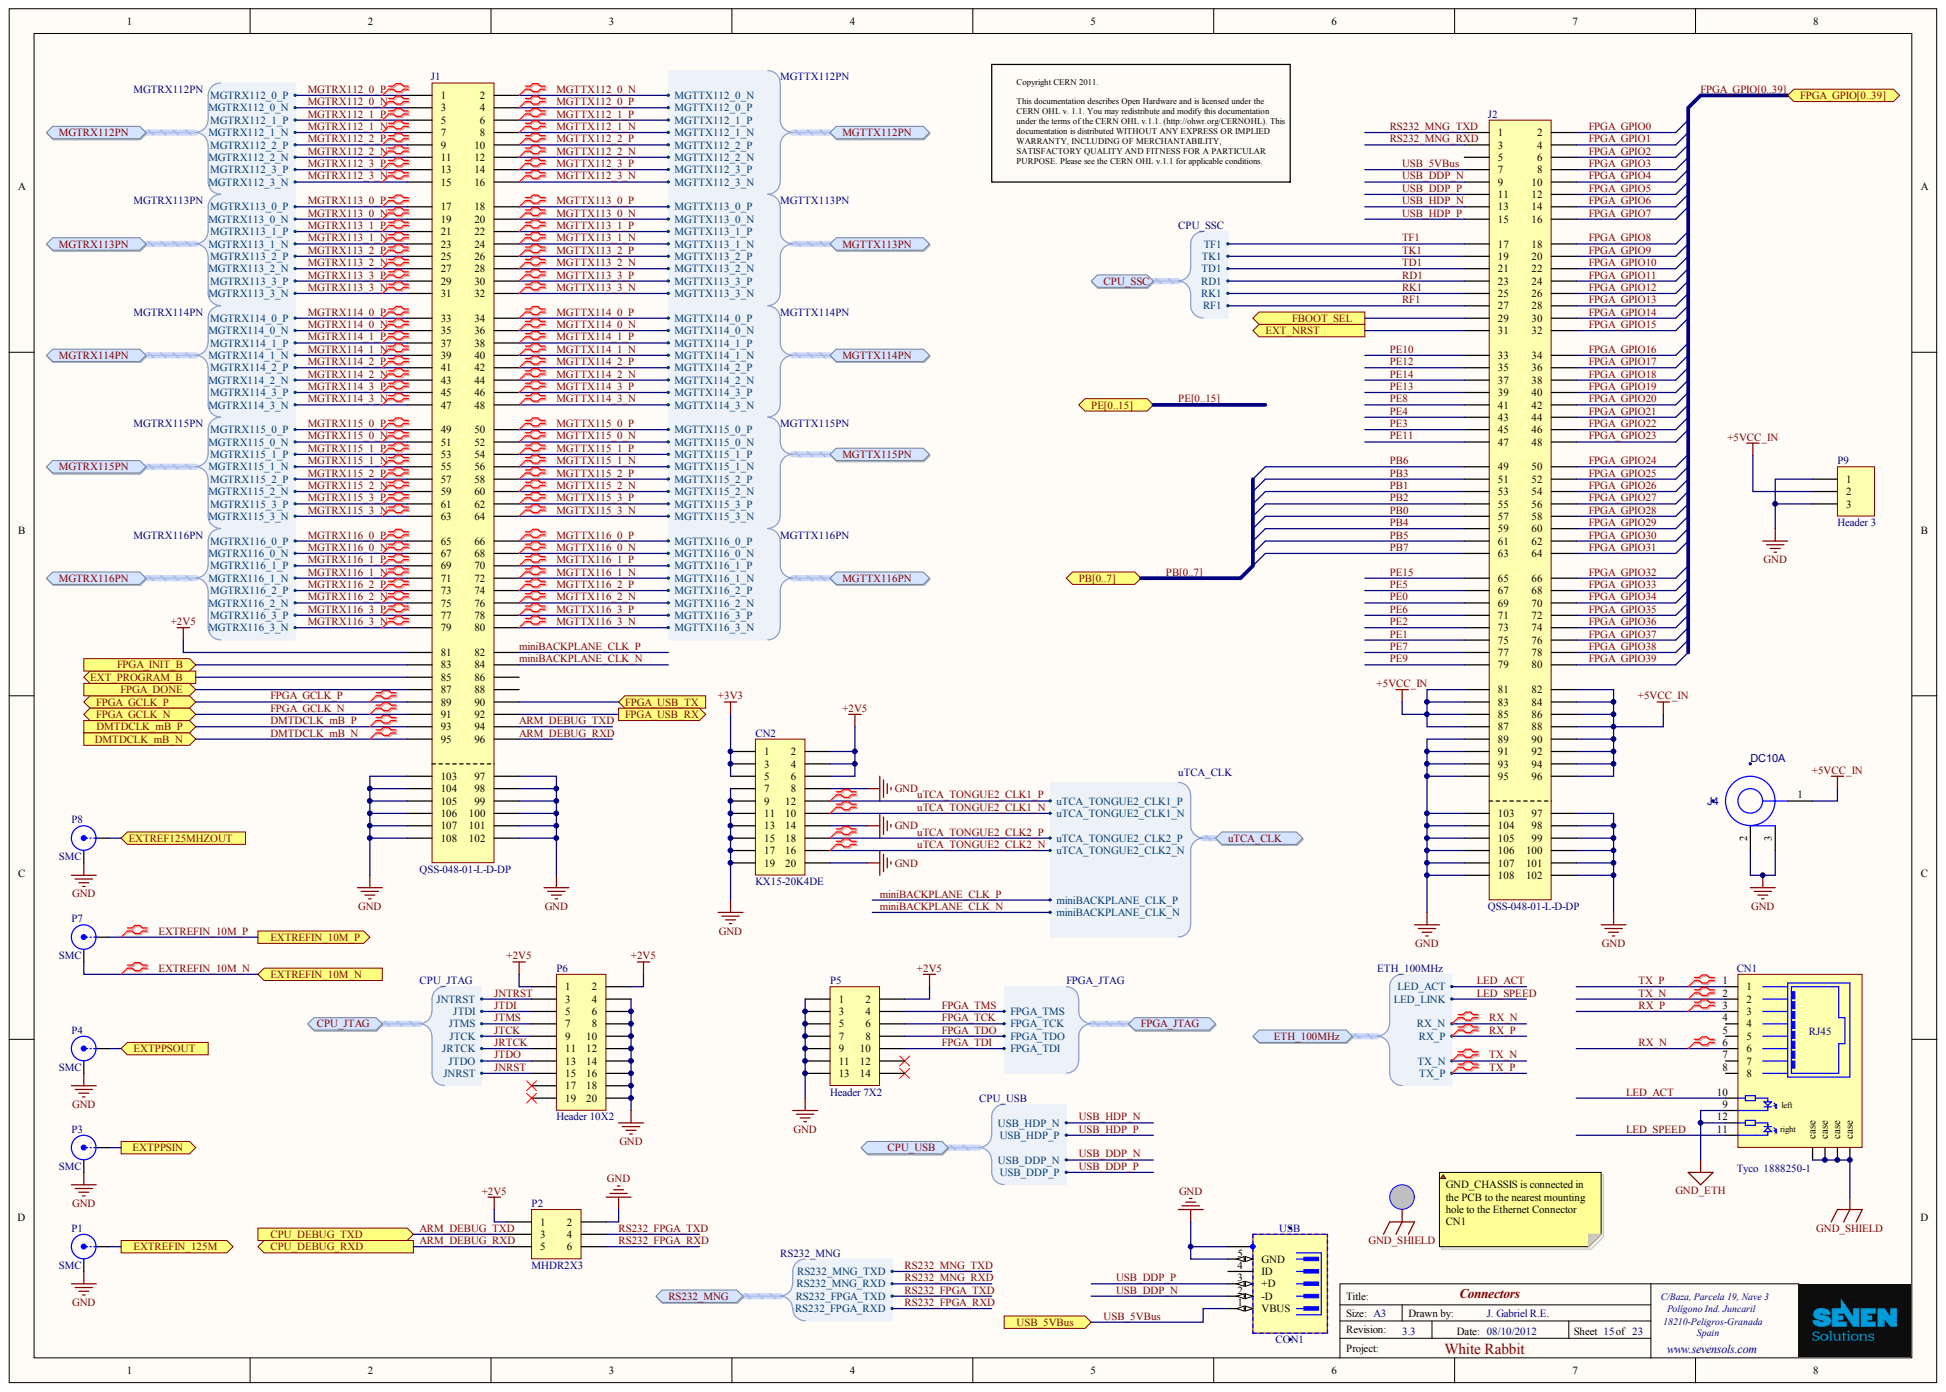
[picture p105: page 15]
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

12
11

GND_CHASSIS is connected in
the PCB to the nearest mounting
hole to the Ethernet Connector

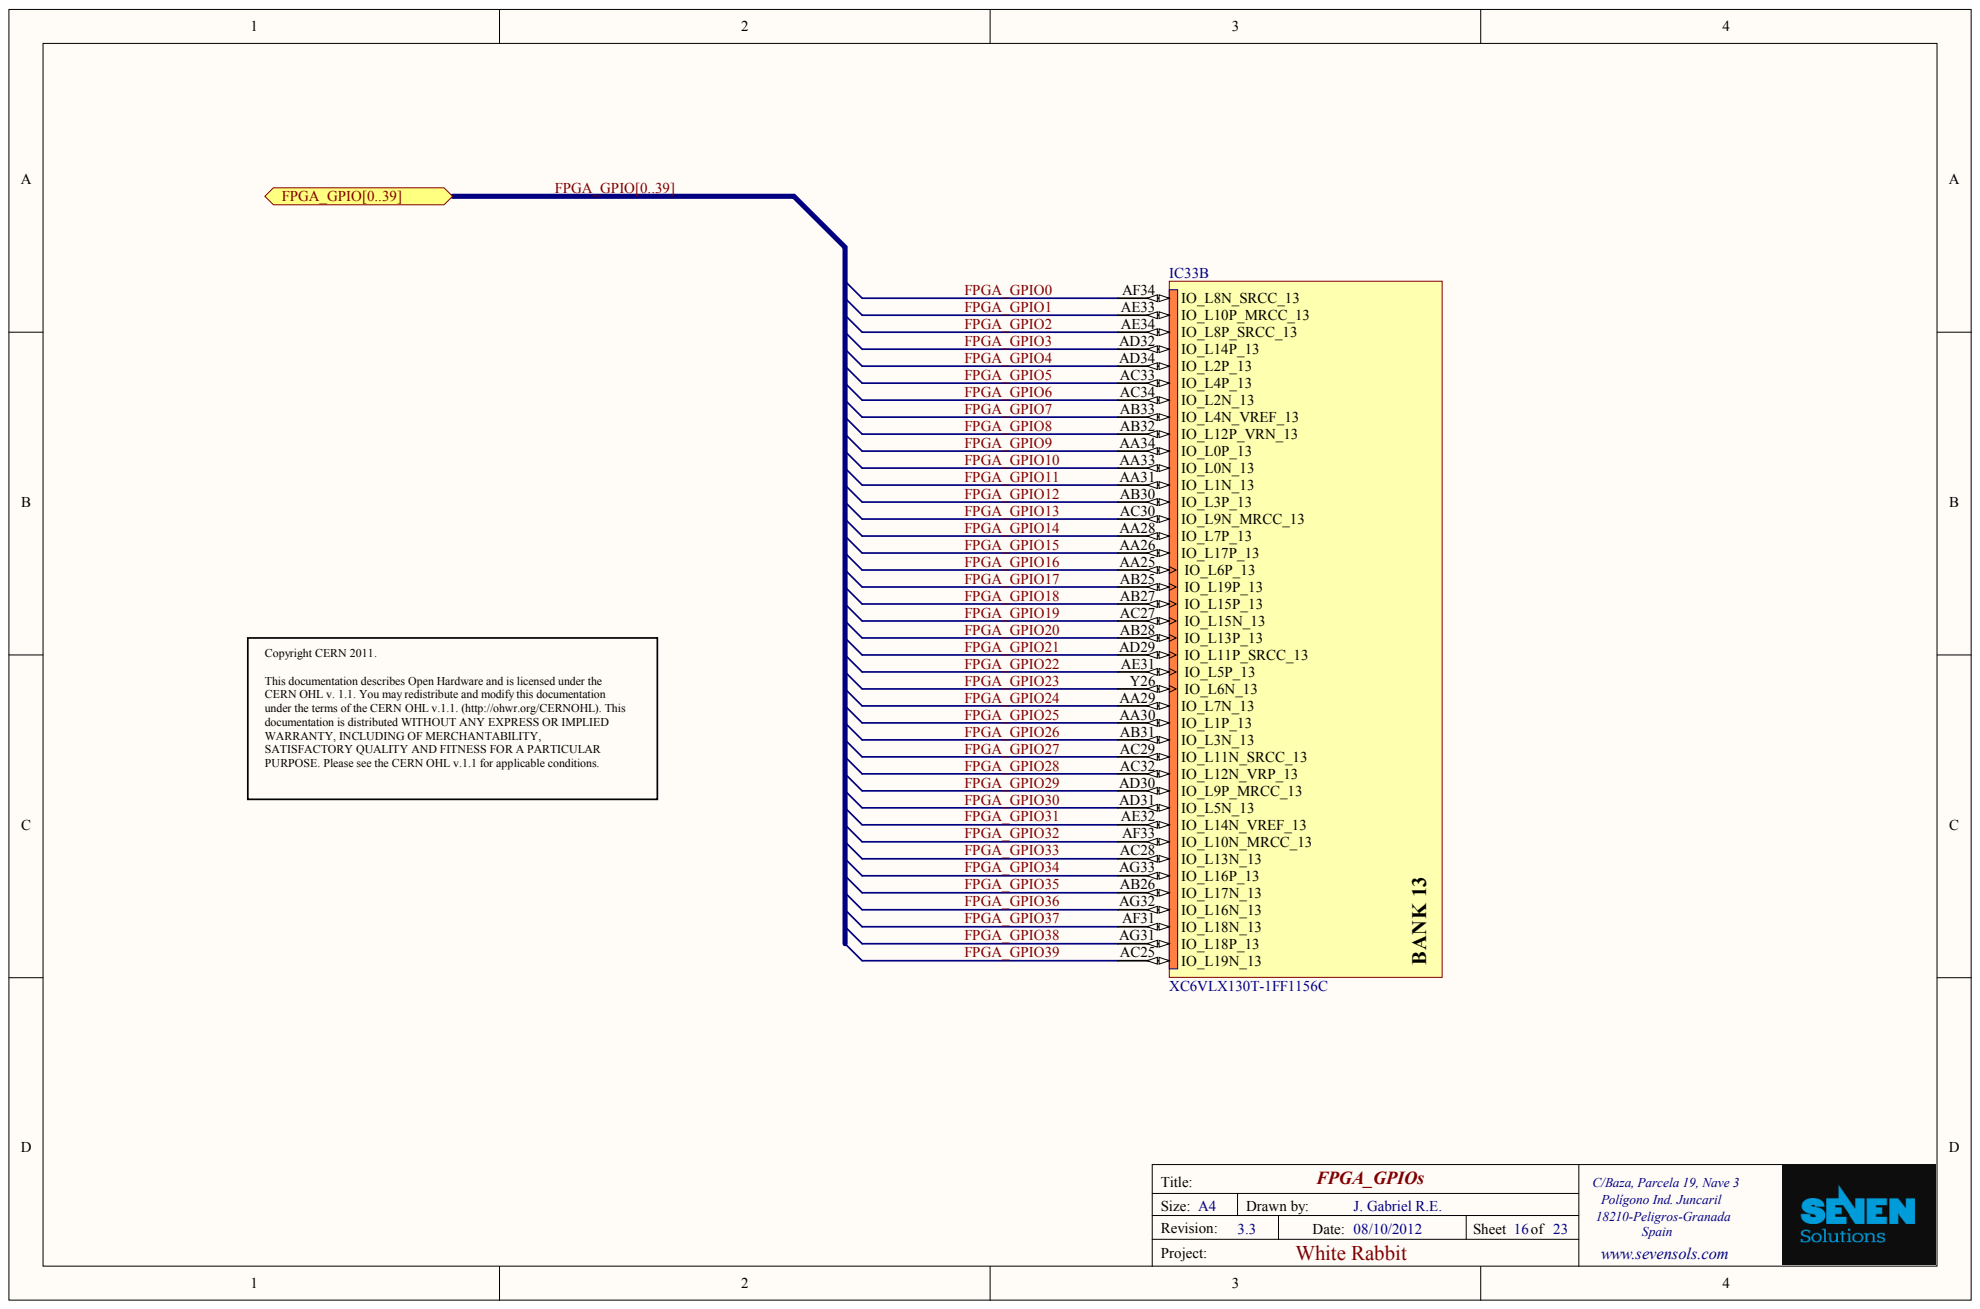
[picture p106: page 16]

This docu
CERN OHL v. 1.1. Y
under the terms o
documentation is di
WARRANTY, I
SATI
PURPOSE. Please see the CERN OHL v.1.1 for ap

T ANY EXPRESS OR IMPLIED

www.sevensols.com C/Baza, Parcela 19, Nave 3 Polígono Ind. Juncaril

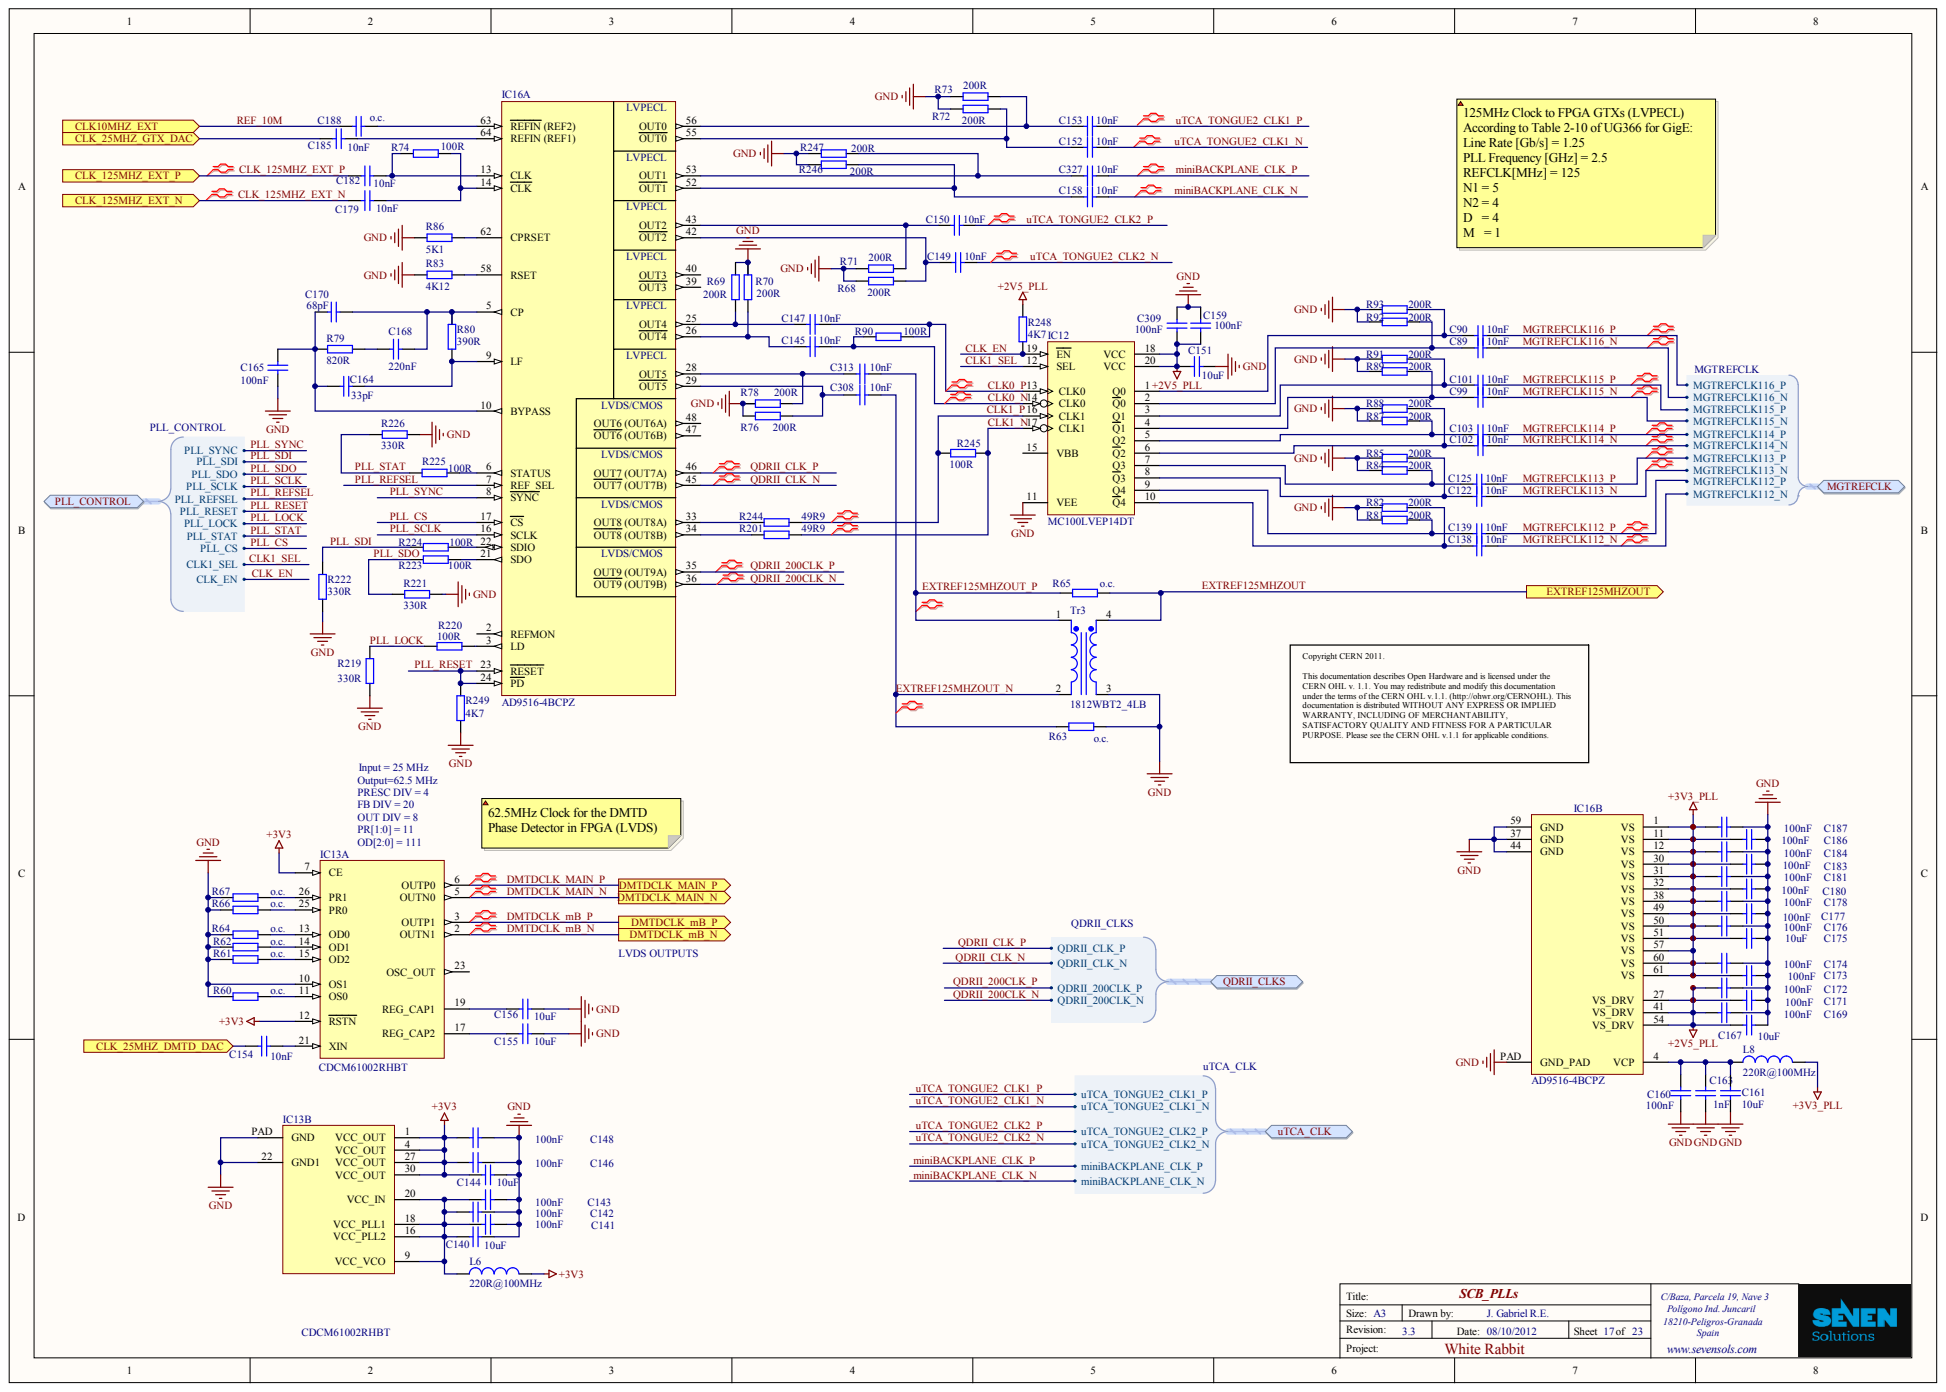
[picture p107: page 17]

REFIN (REF2) 63 | LVPECL OUT0
REFIN (REF1) 64 | 55 OUT0 56

125MHz Clock to FPGA GTXs (LVPECL)
According to Table 2-10 of UG366 for GigE:
Line Rate [Gb/s] = 1.25
PLL Frequency [GHz] = 2.5
REFCLK[MHz] = 125

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

62.5MHz Clock for the DMTD
Phase Detector in FPGA (LVDS)

SCB_PLLs | 18210-Peligros-Granada Spain

A3 | J. Gabriel R.E.

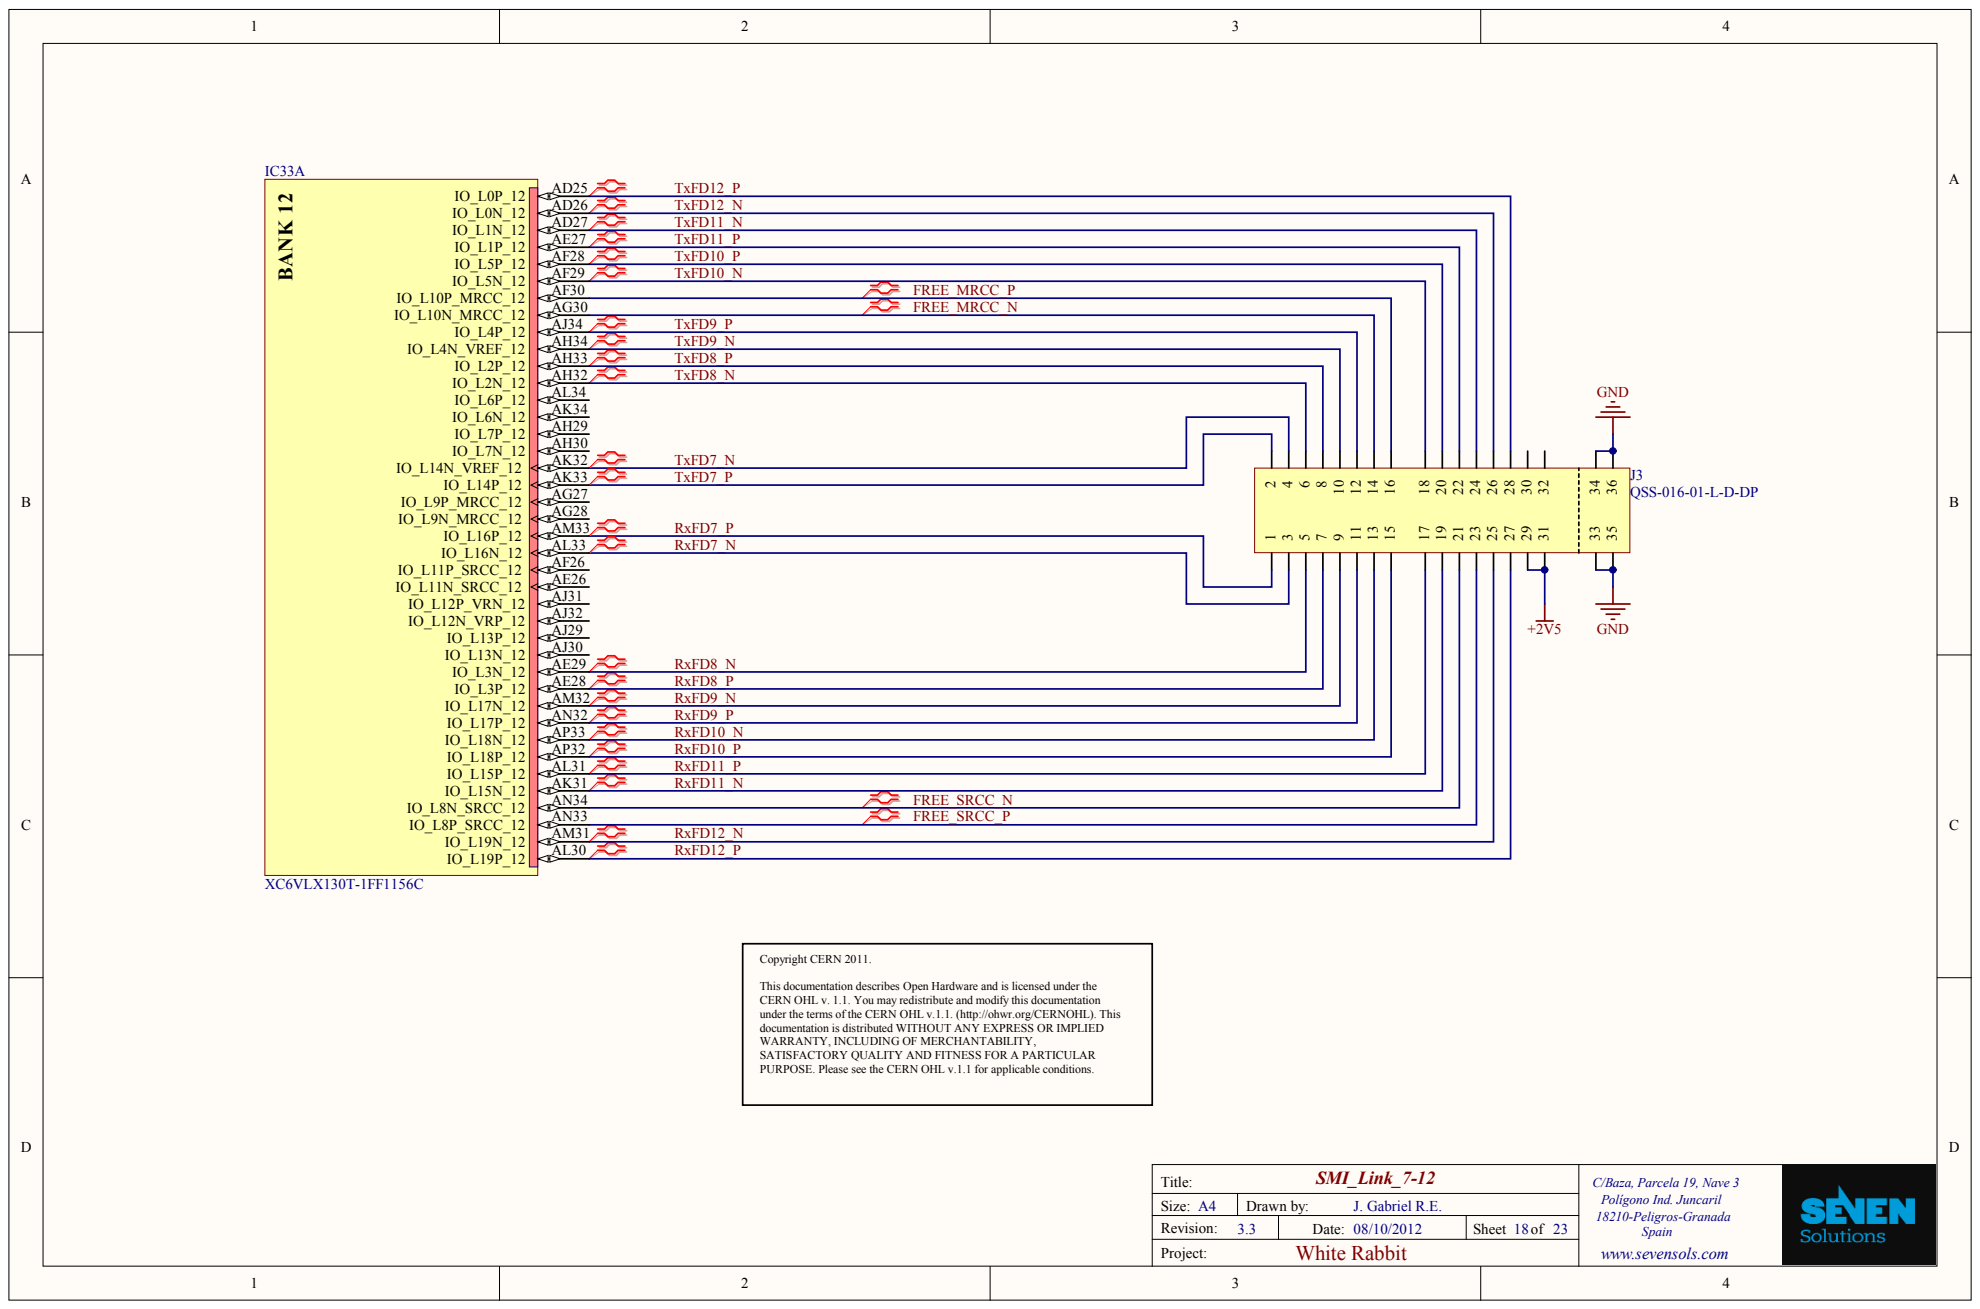
[picture p108: page 18]

AD2 6 | Tx FD12_N
AD2 7 | Tx FD11_N
AE27 | Tx FD11_P
A F28 | Tx FD10_P
A F29 | Tx FD10_N
A F30
AG3 0
AJ34 | Tx FD9_ P
AH3 4 | Tx FD9_N
AH3 3 | Tx FD8_ P
AH3 2 | Tx FD8_N
AL34

AH2 9
AH3 0
AK3 2 | Tx FD7_N
AK3 3 | Tx FD7_ P

AL33 | Rx FD7_N
A F26
AE26

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

T ANY EXPRESS OR IMPLIED

www.sevensols.com C/Baza, Parcela 19, Nave 3 Polígono Ind. Juncaril

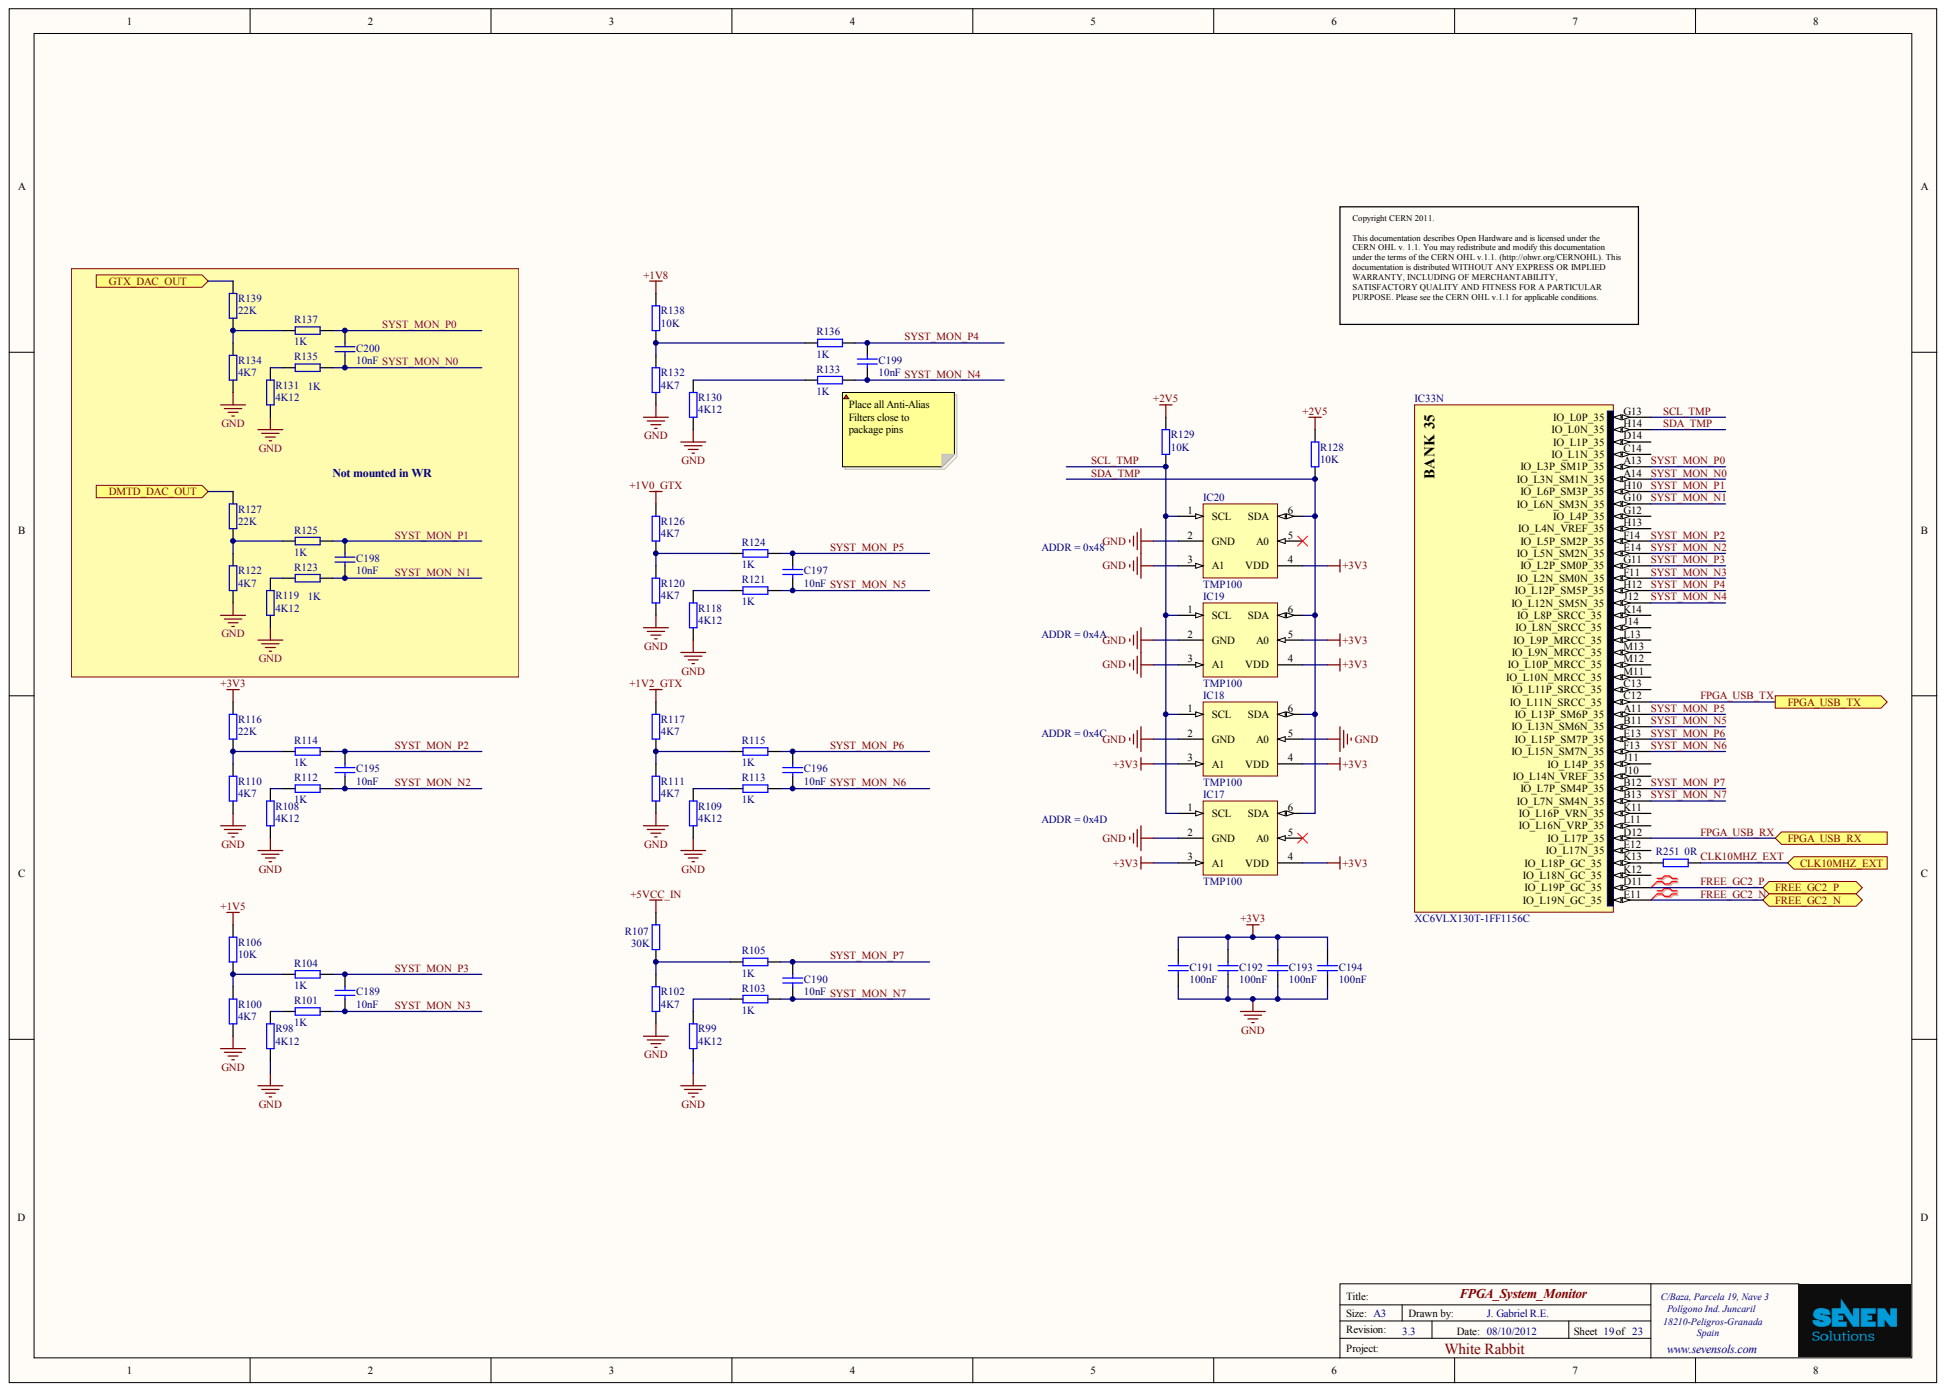
[picture p109: page 19]

2 | SCL SDA GND A0 A 1 VDD | 5

DGND GND GND GND GND GND

Titl e : FP GA_ Sys tem_ Mo n ito r | C/Baza, Parcela 19, Nave 3 Polígono Ind. Juncaril 18210-P e l igros-Granada Spai n www. s e v e n s ols.c o m

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

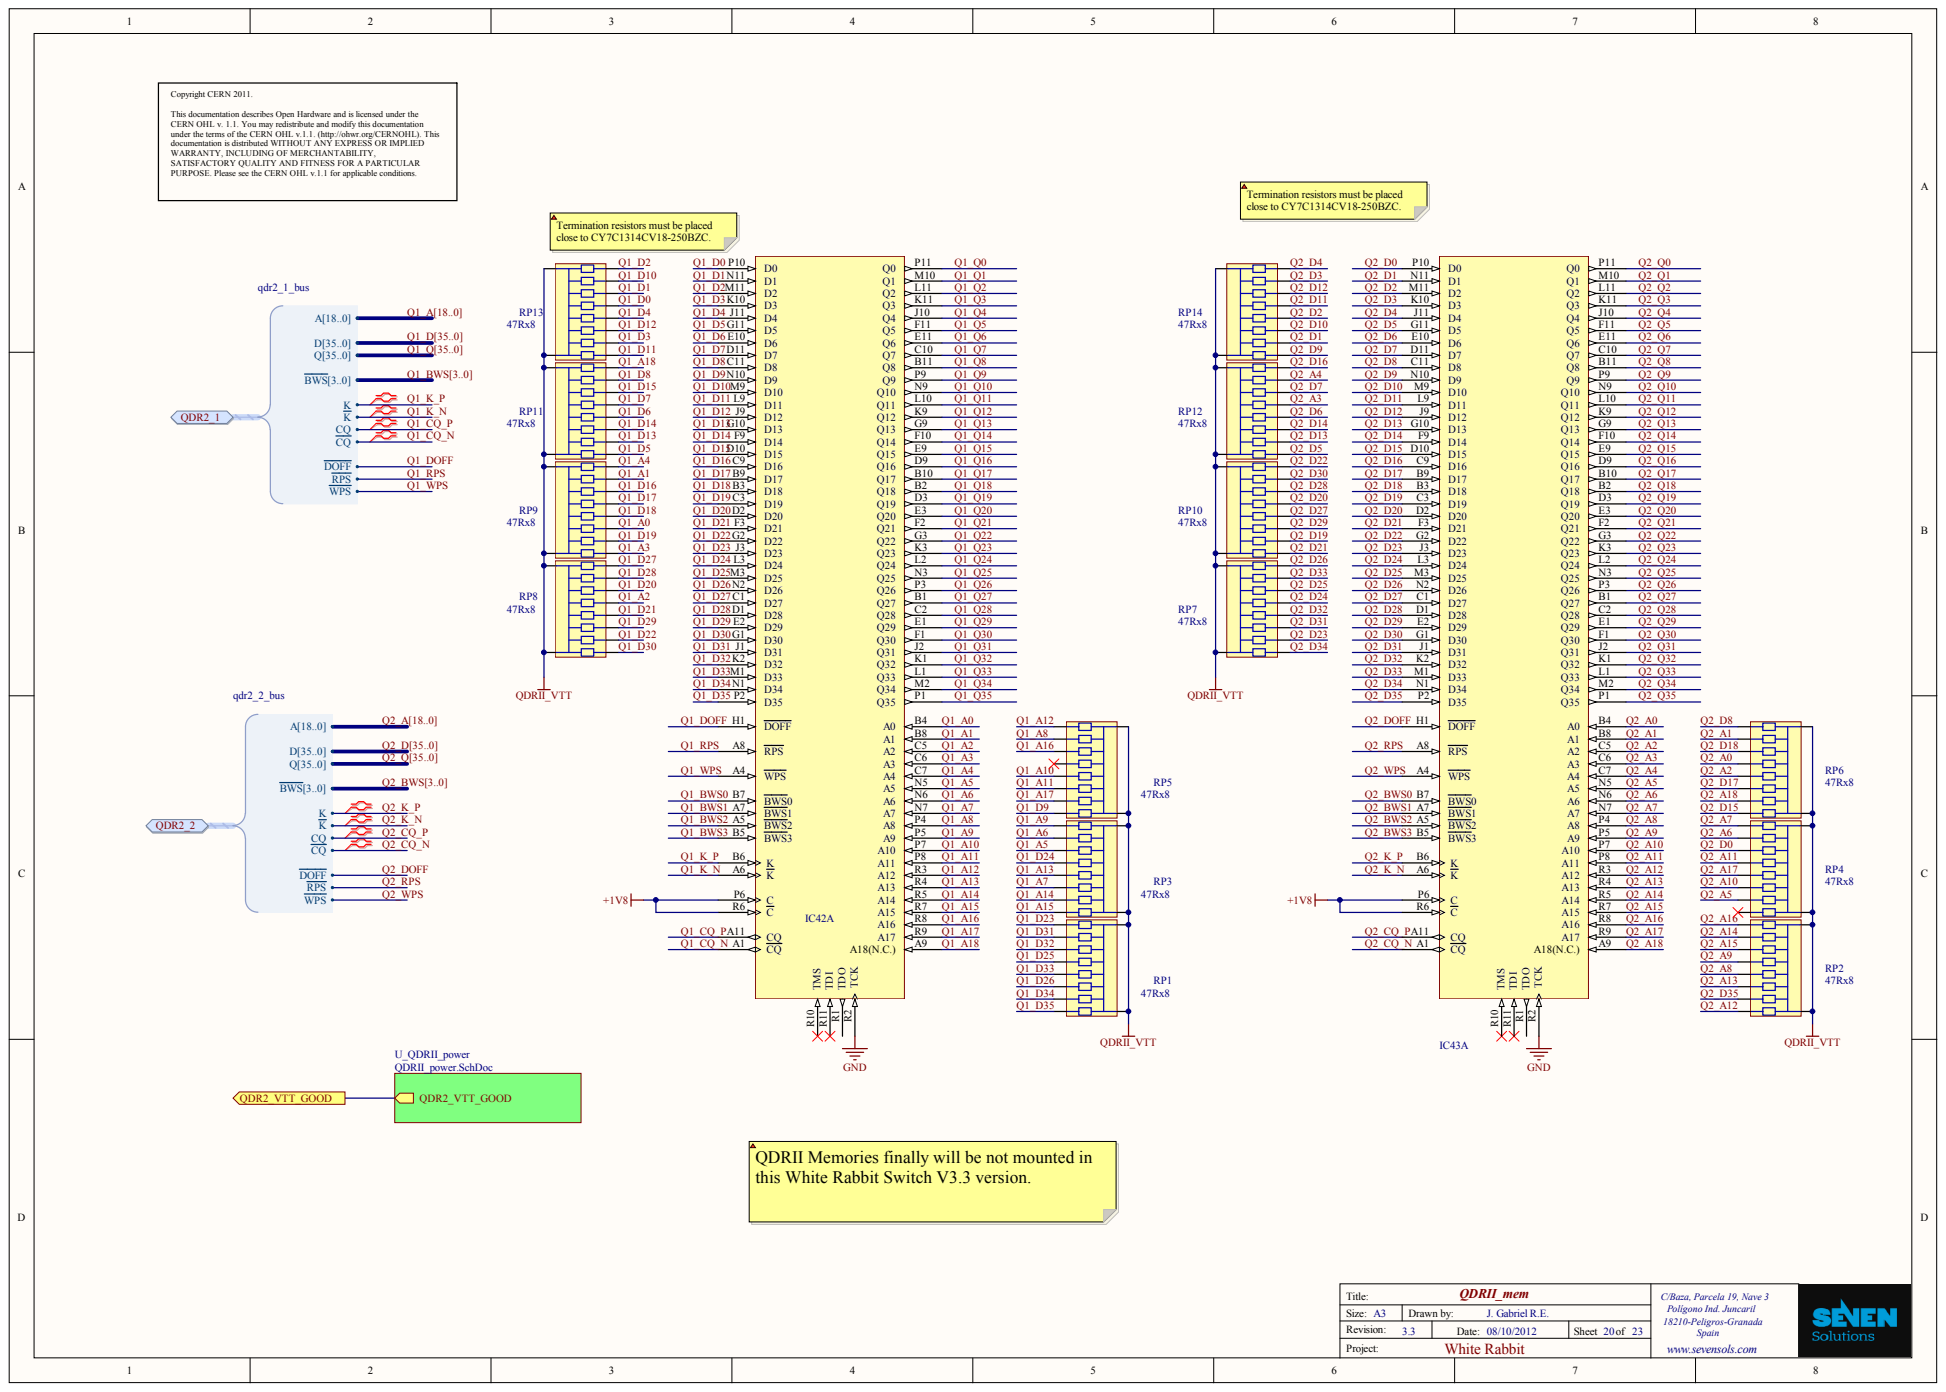
[picture p110: page 20]

I Memories finally will be not mounted in
QDRI
this White Rabbit Switch V3.3 version.

S i z e : A 3 | QDRII_mem 08/10/201 Dr awn b y : J. G abri e l R.E.
Titl e : | C/Baza, Parcela 19, Nave 3 Polígono Ind. Juncaril 18210-P e l igros-Granada Spai n www. s e v e n s ols.c o m

Re v i s i o n : . | Date : | S h e e t o f 3

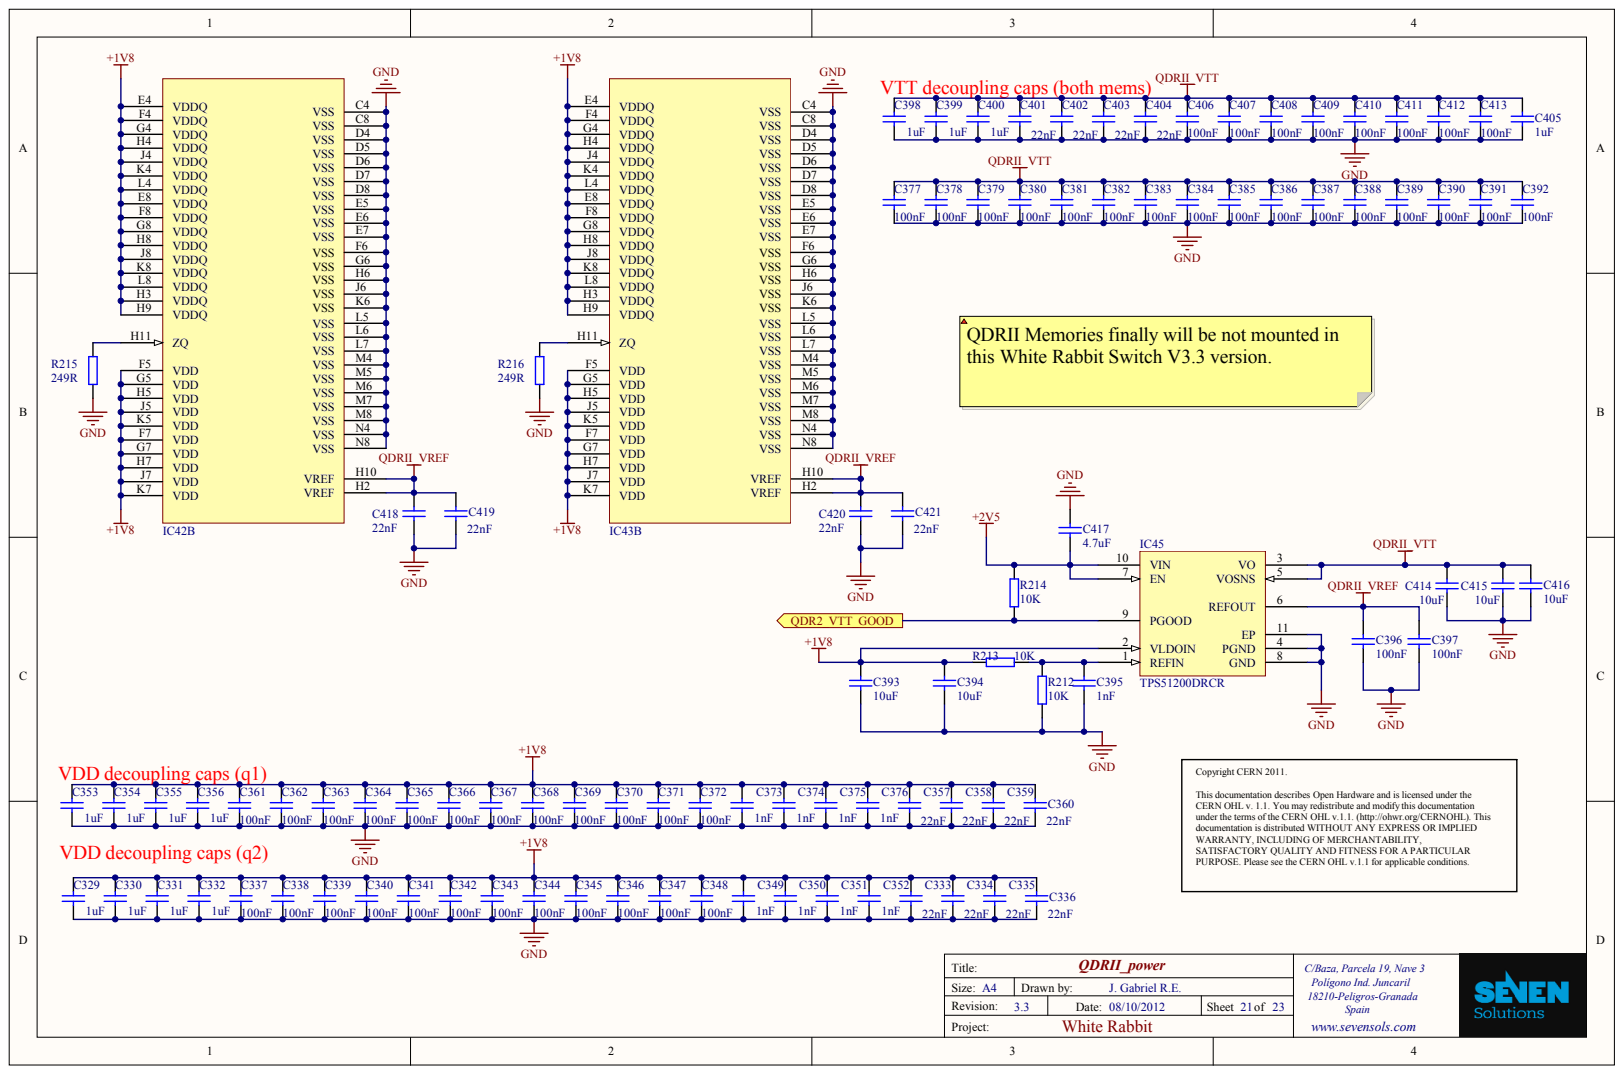
[picture p111: page 21]

VTT decoupling caps (both mems)

QDRII Memories finally will be not mounted in
this White Rabbit Switch V3.3 version.

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

QDRII_power Title: | C/Baza, Parcela 19, Nave 3 Polígono Ind. Juncaril 18210-Peligros-Granada Spain

Size: A4 | Drawn by: J. Gabriel R.E.
Revision: 3.3 | Date: 08/10/2012 | Sheet 21 of 23

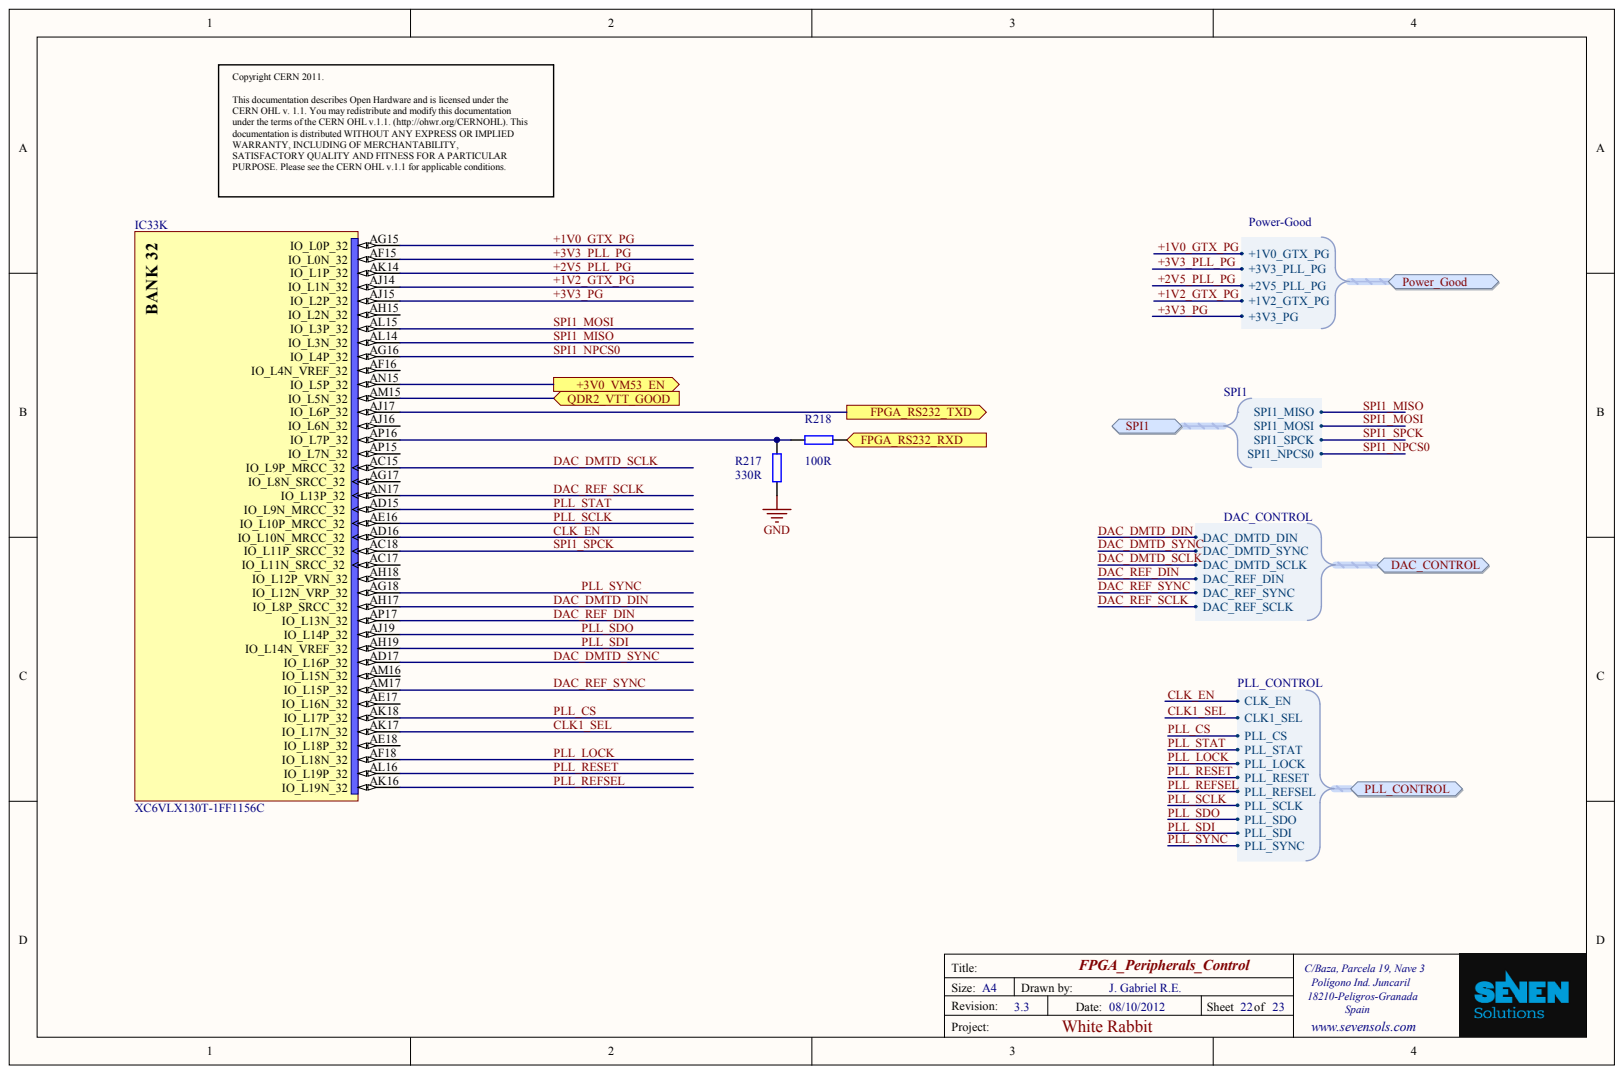
[picture p112: page 22]
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

FPGA_Peripherals_Control Title: | C/Baza, Parcela 19, Nave 3 Polígono Ind. Juncaril 18210-Peligros-Granada Spain

Size: A4 | Drawn by: J. Gabriel R.E.
Revision: 3.3 | Date: 08/10/2012 | Sheet 22 of 23

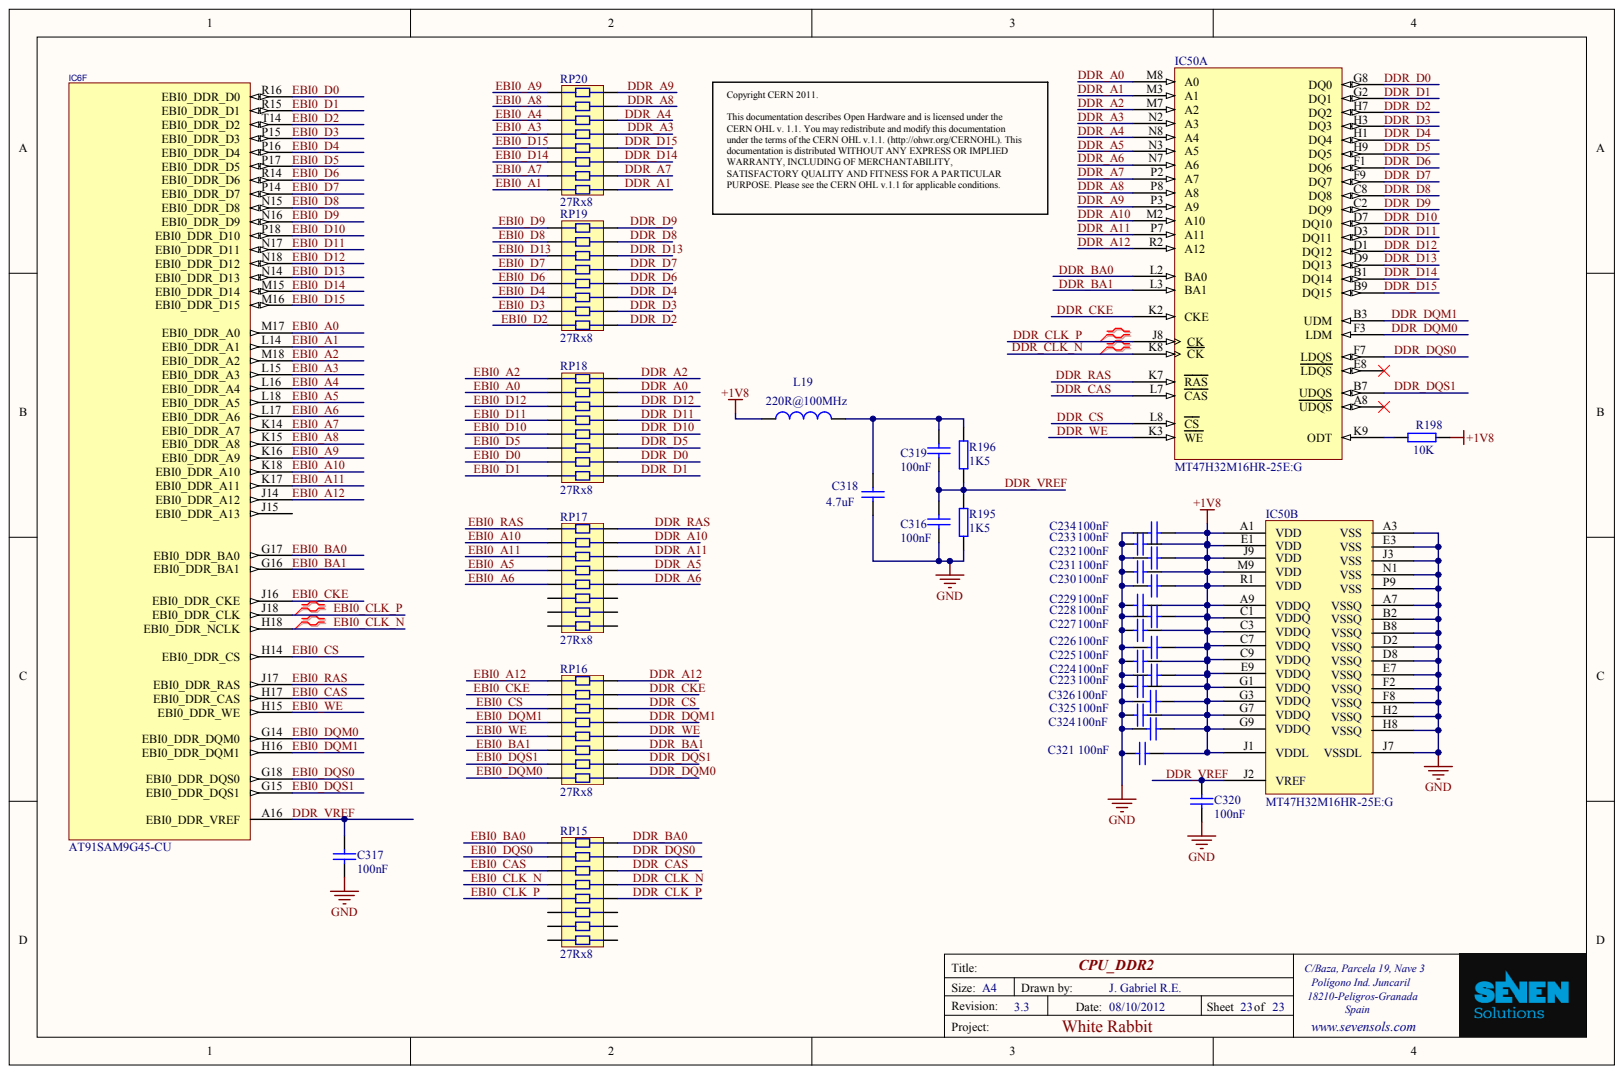
[picture p113: page 23]

T ANY EXPRESS OR IMPLIED

SATI
PURPOSE. Please see the CERN OHL v.1.1 for ap

F 2
F 8

CPU_DDR 2 | www.sevensols.com C/Baza, Parcela 19, Nave 3 Polígono Ind. Juncaril 18210-Peligros-Granada Spain

A | y :
Re vision : | Date: 08/10/201 2 | S heet 2 3 o f 2 3
