Reedgarden/WRS-HW/circuit_board/wrs_v2/mini_backplane/mini_backplane.pdf

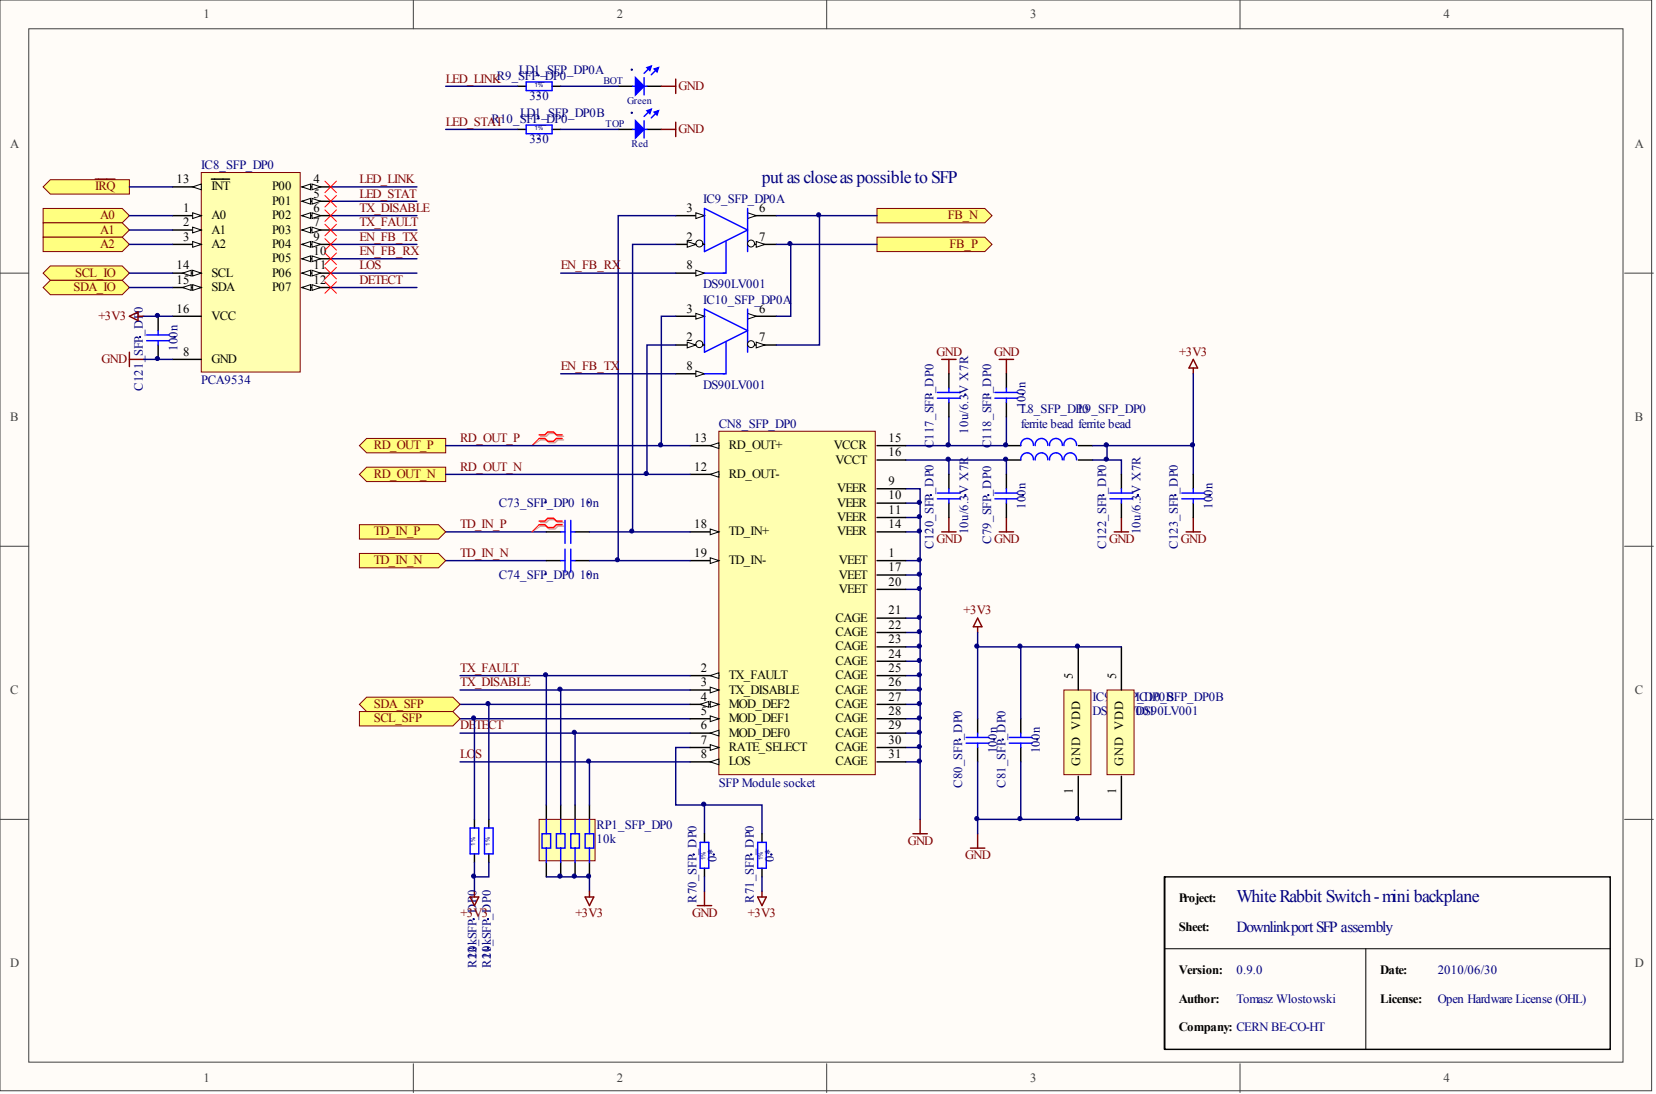
[picture p114: page 1]

put as close as possible to SFP

Open Hardware License (OHL)

Company: CERN BE-CO-HT

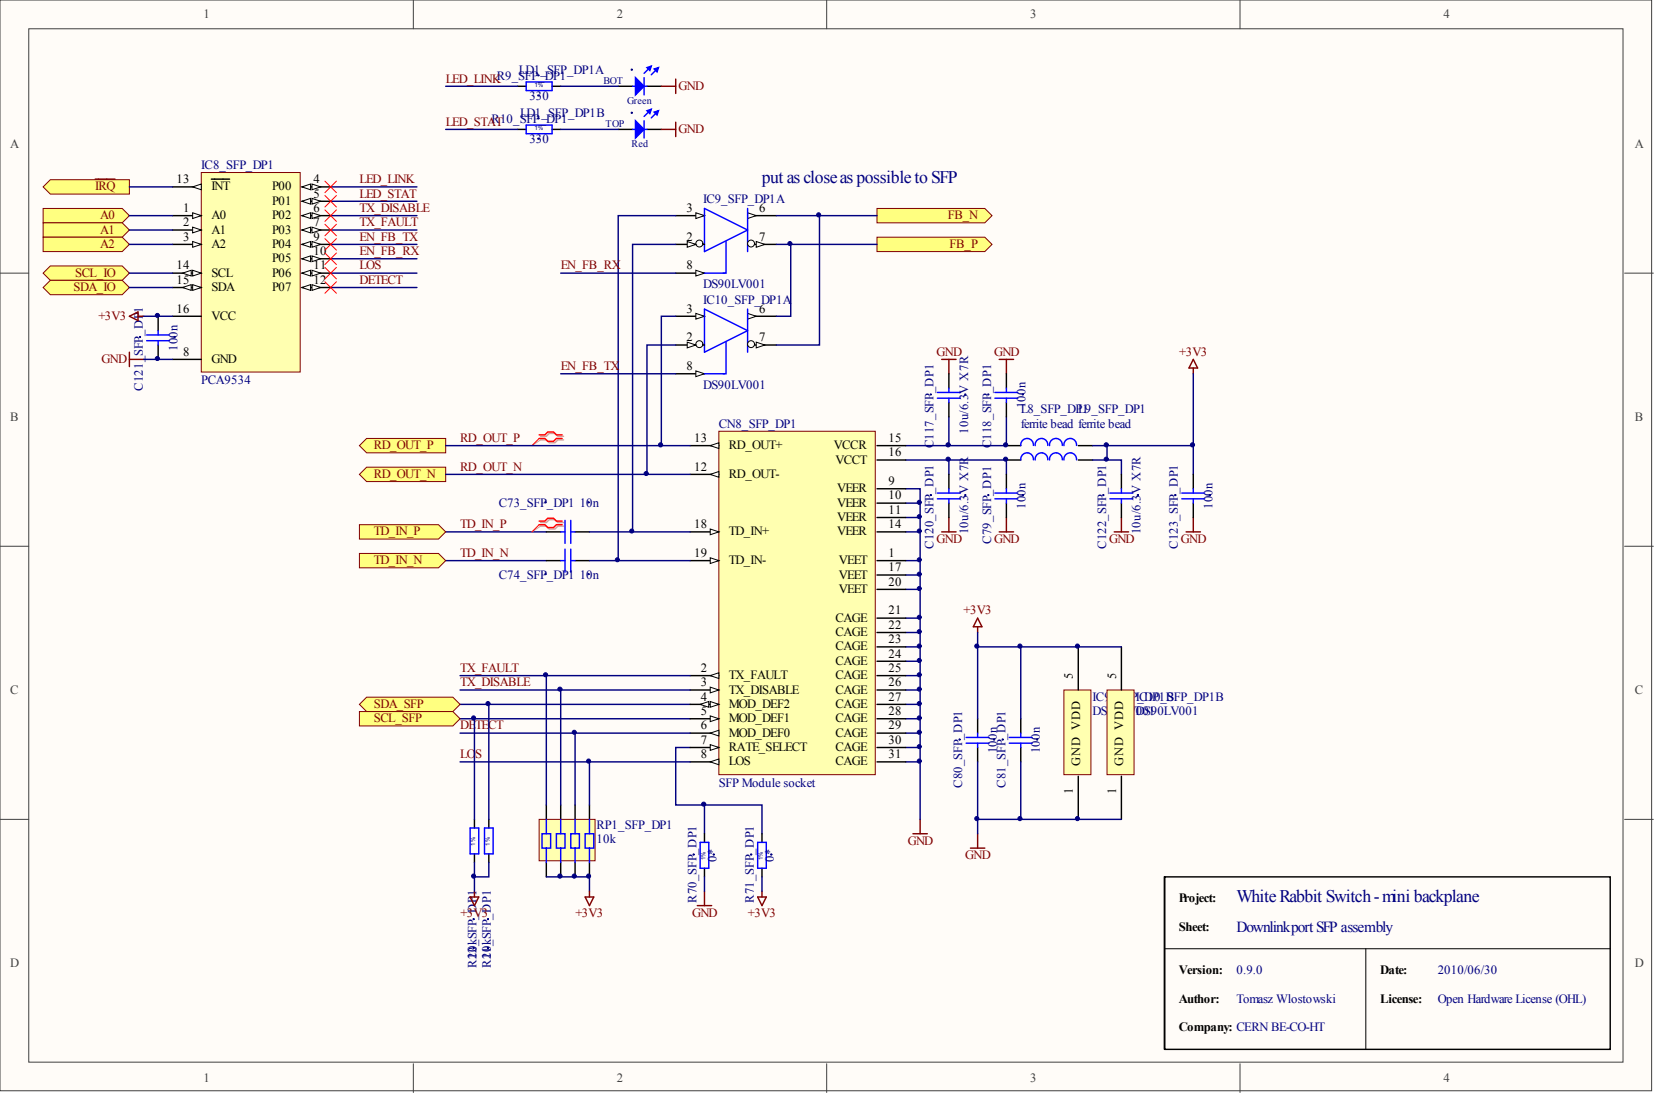
[picture p115: page 2]

put as close as possible to SFP

Open Hardware License (OHL)

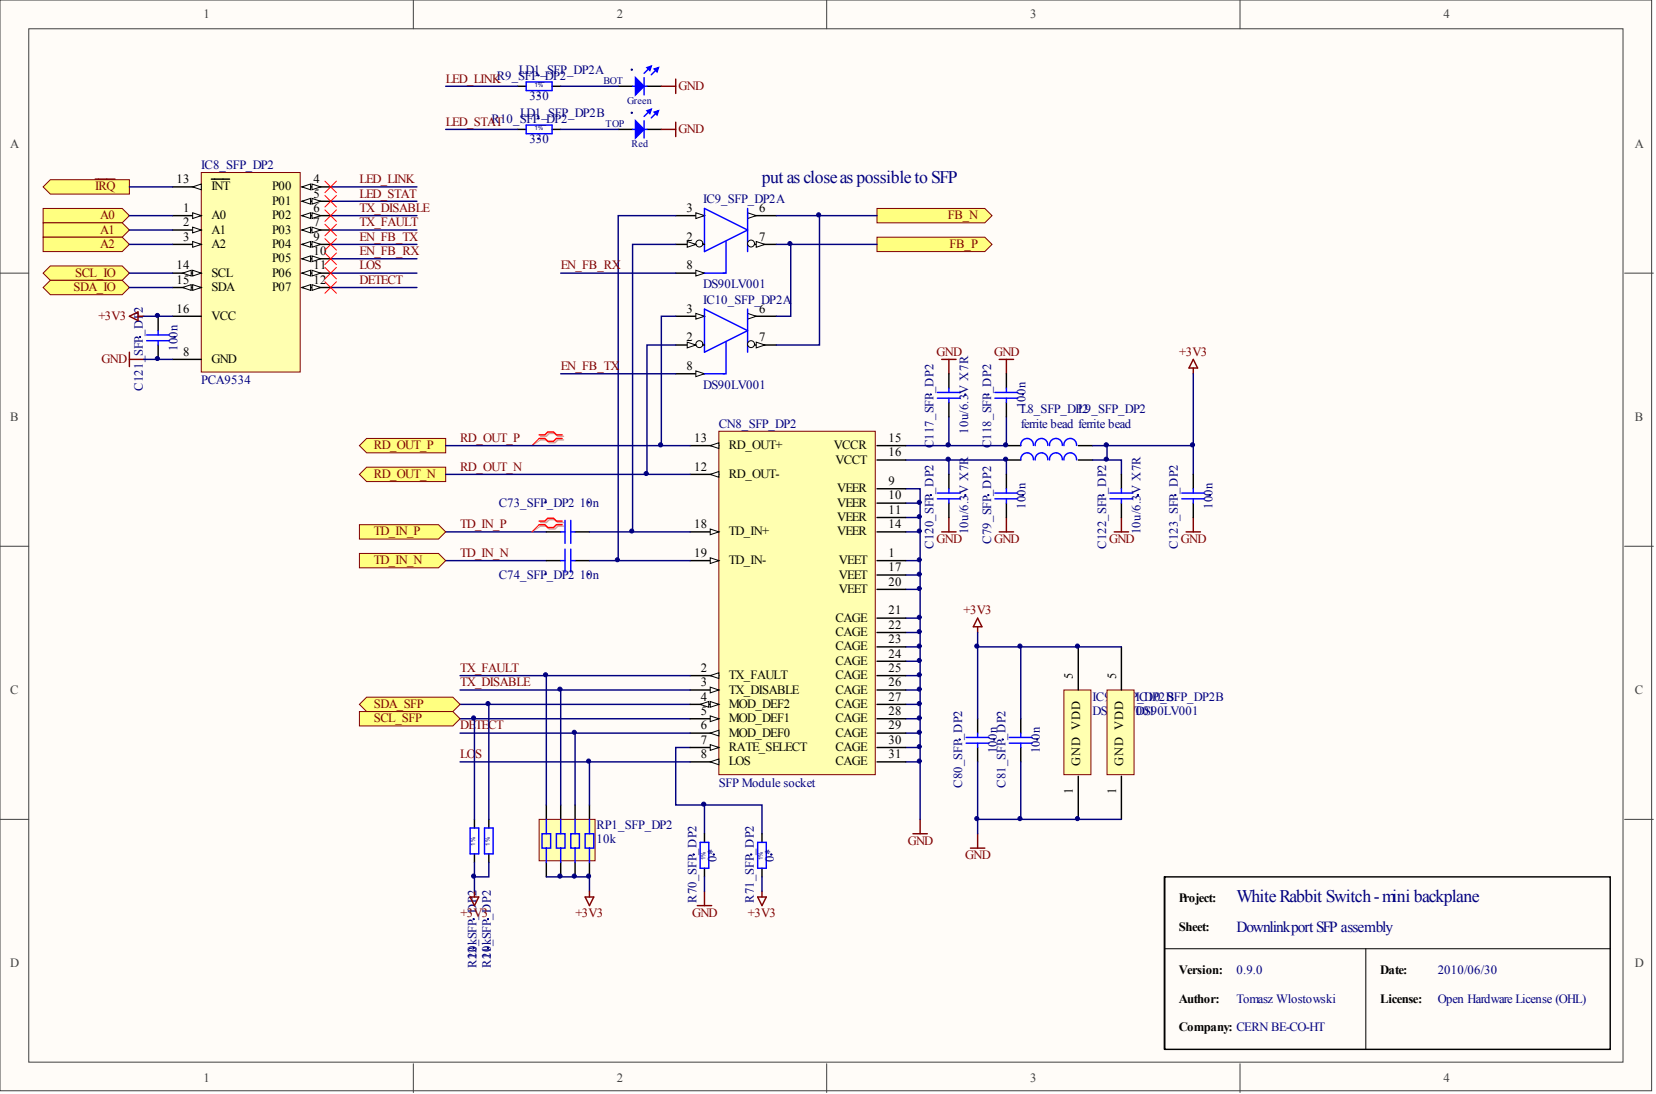
[picture p116: page 3]

put as close as possible to SFP

Open Hardware License (OHL)

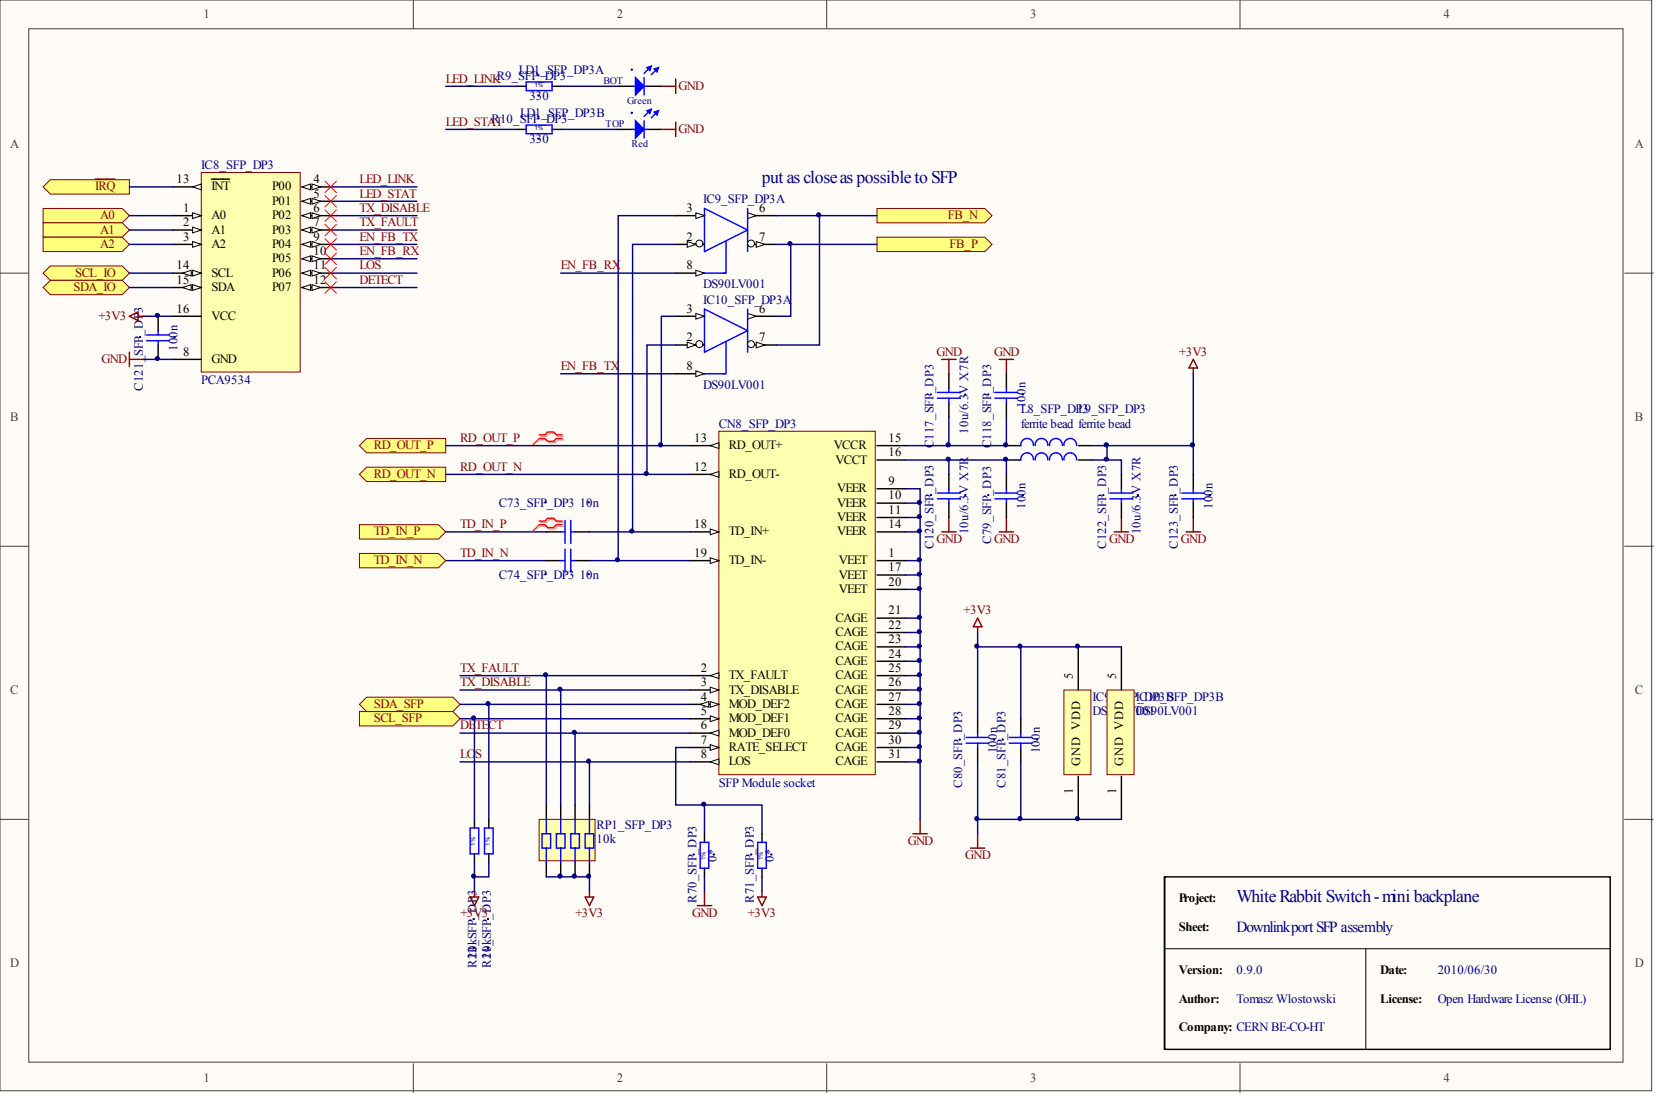
[picture p117: page 4]

put as close as possible to SFP

Open Hardware License (OHL)

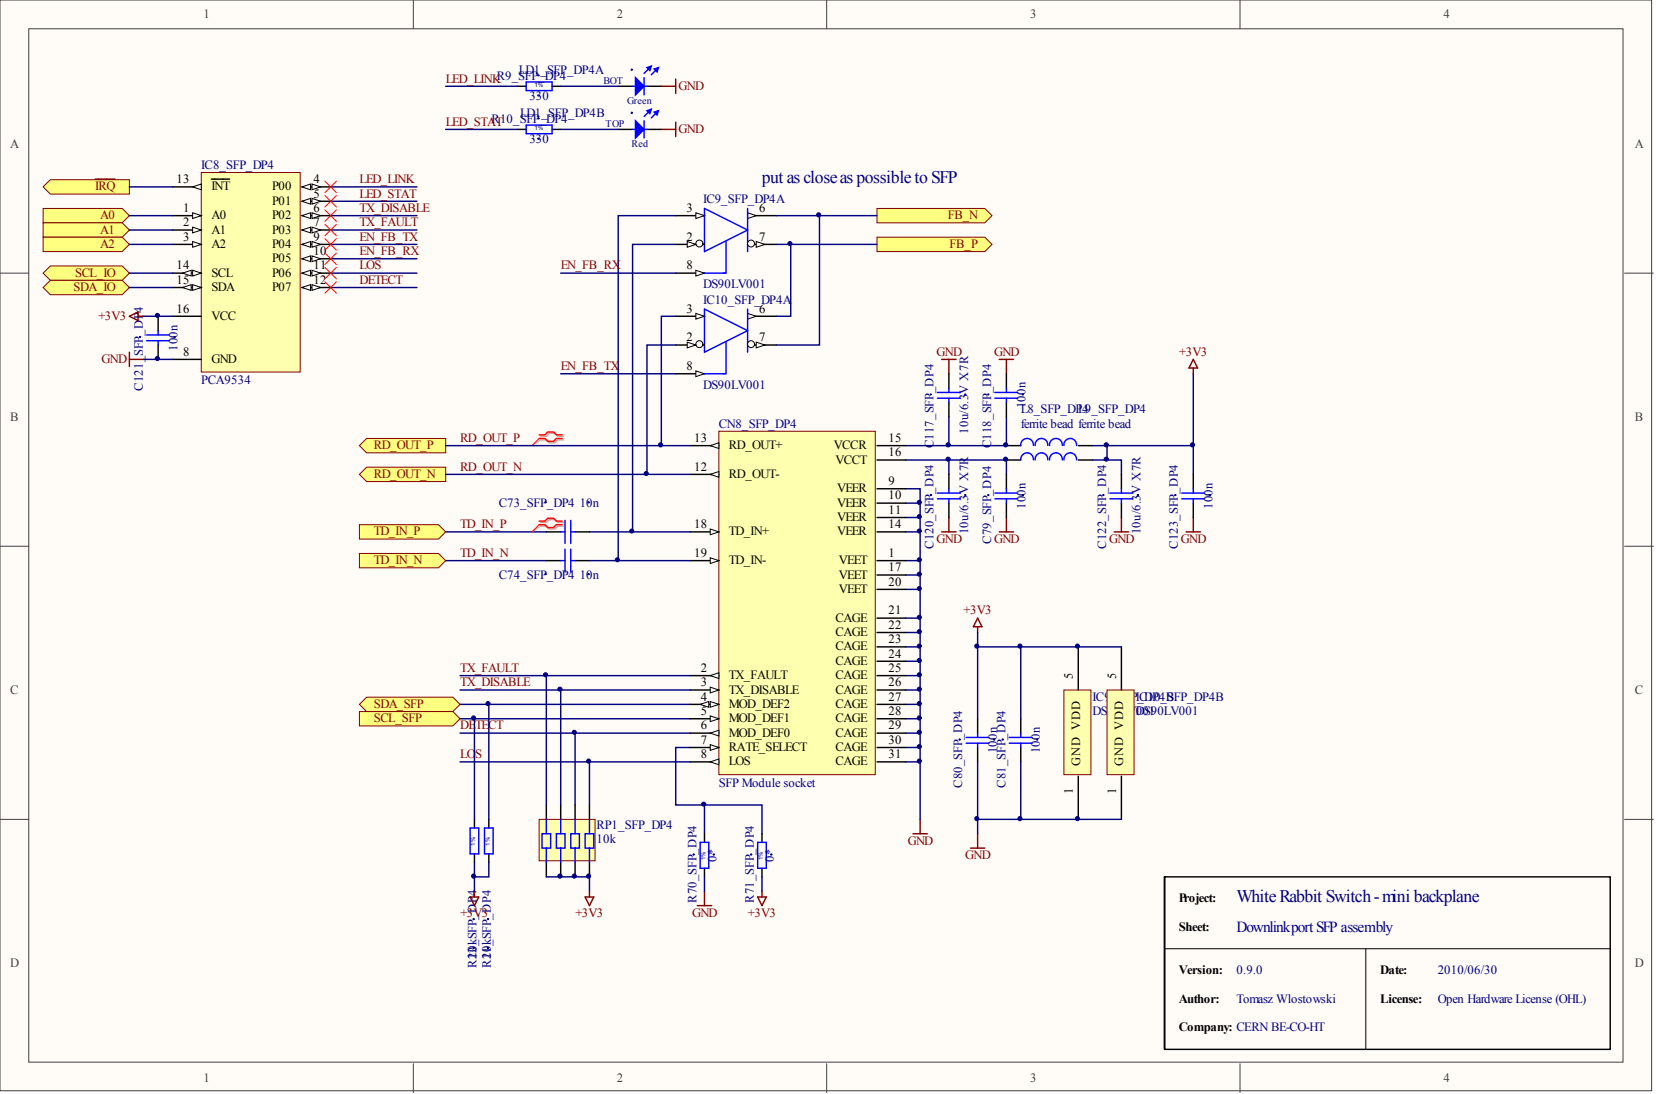
[picture p118: page 5]

put as close as possible to SFP

Open Hardware License (OHL)

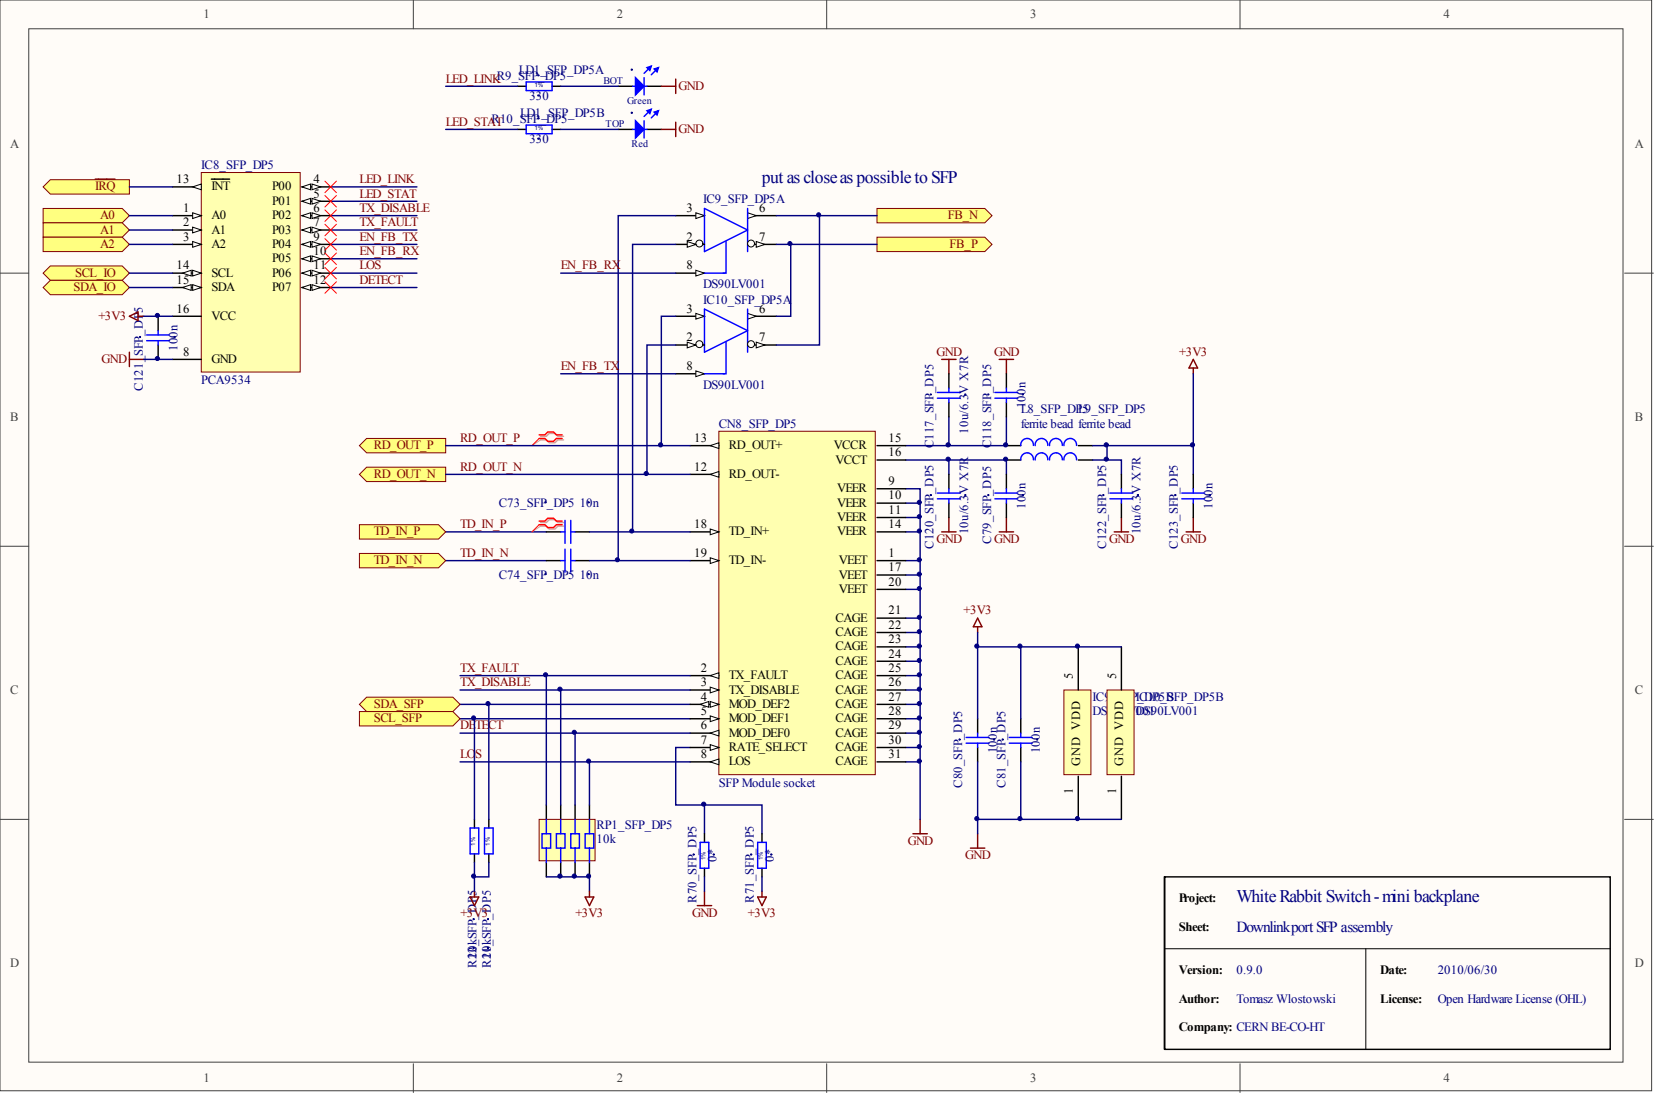
[picture p119: page 6]

put as close as possible to SFP

Open Hardware License (OHL)

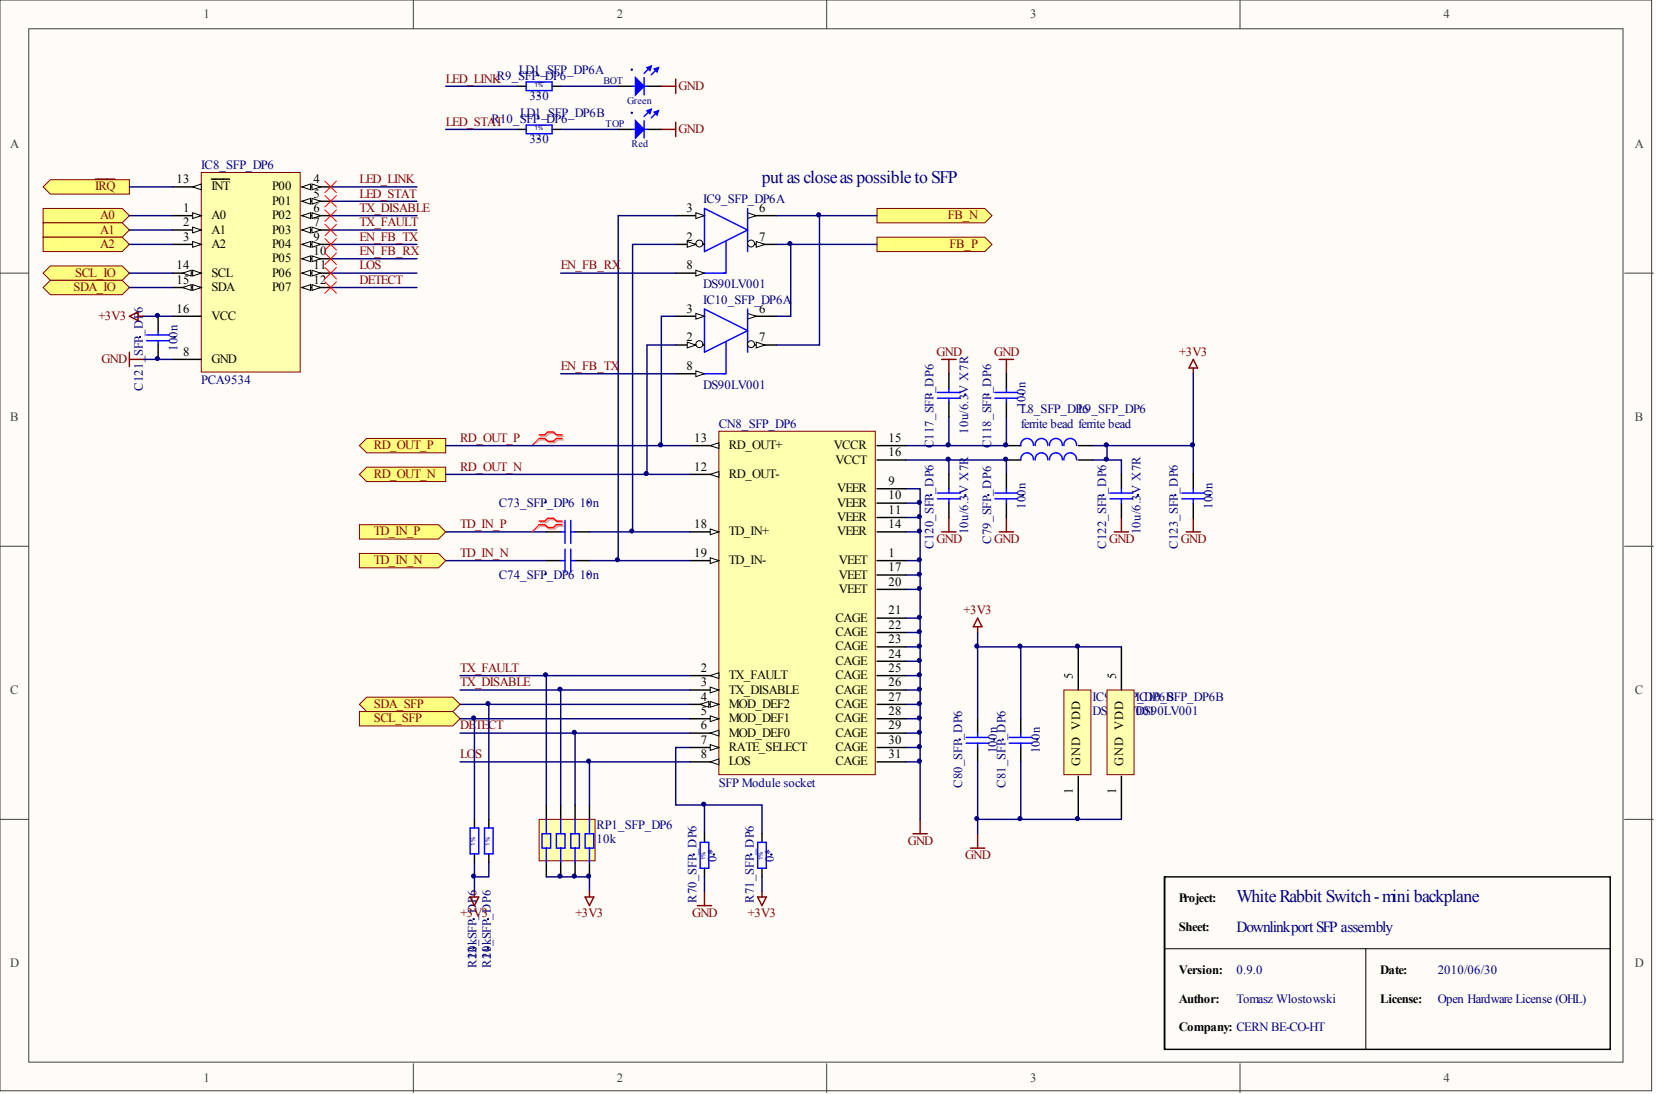
[picture p120: page 7]

put as close as possible to SFP

Open Hardware License (OHL)

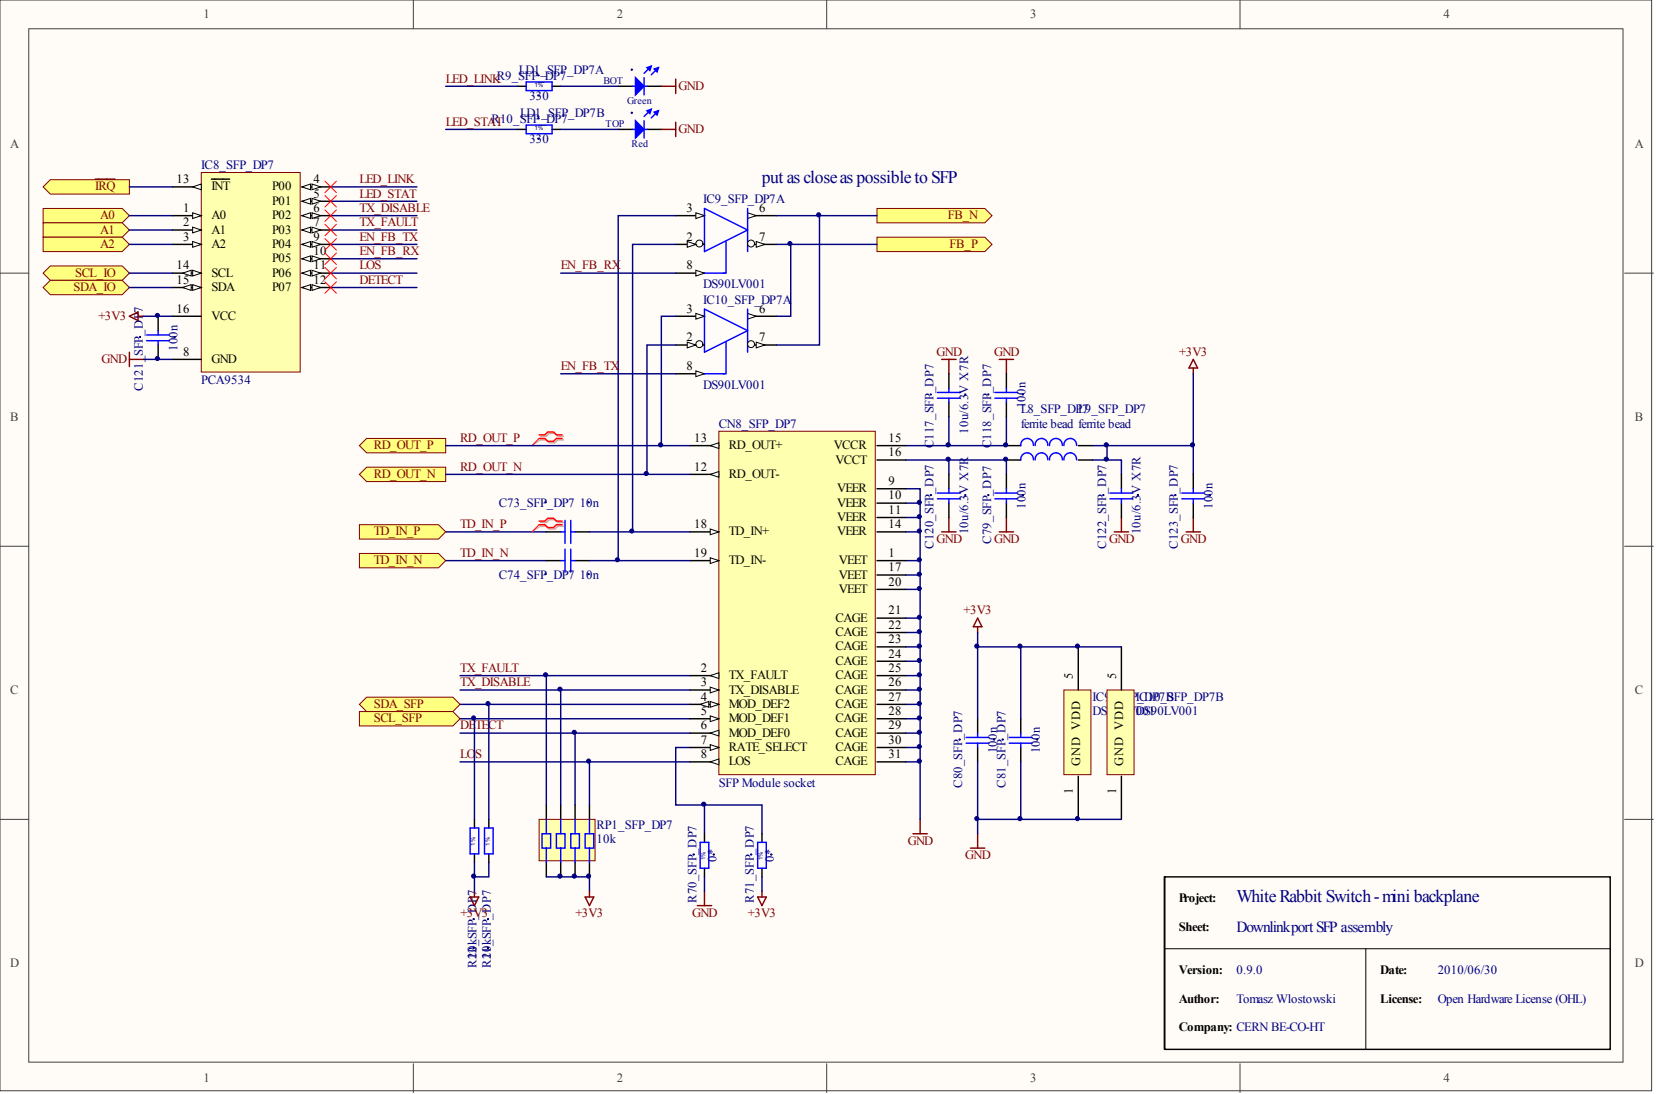
[picture p121: page 8]

put as close as possible to SFP

Open Hardware License (OHL)

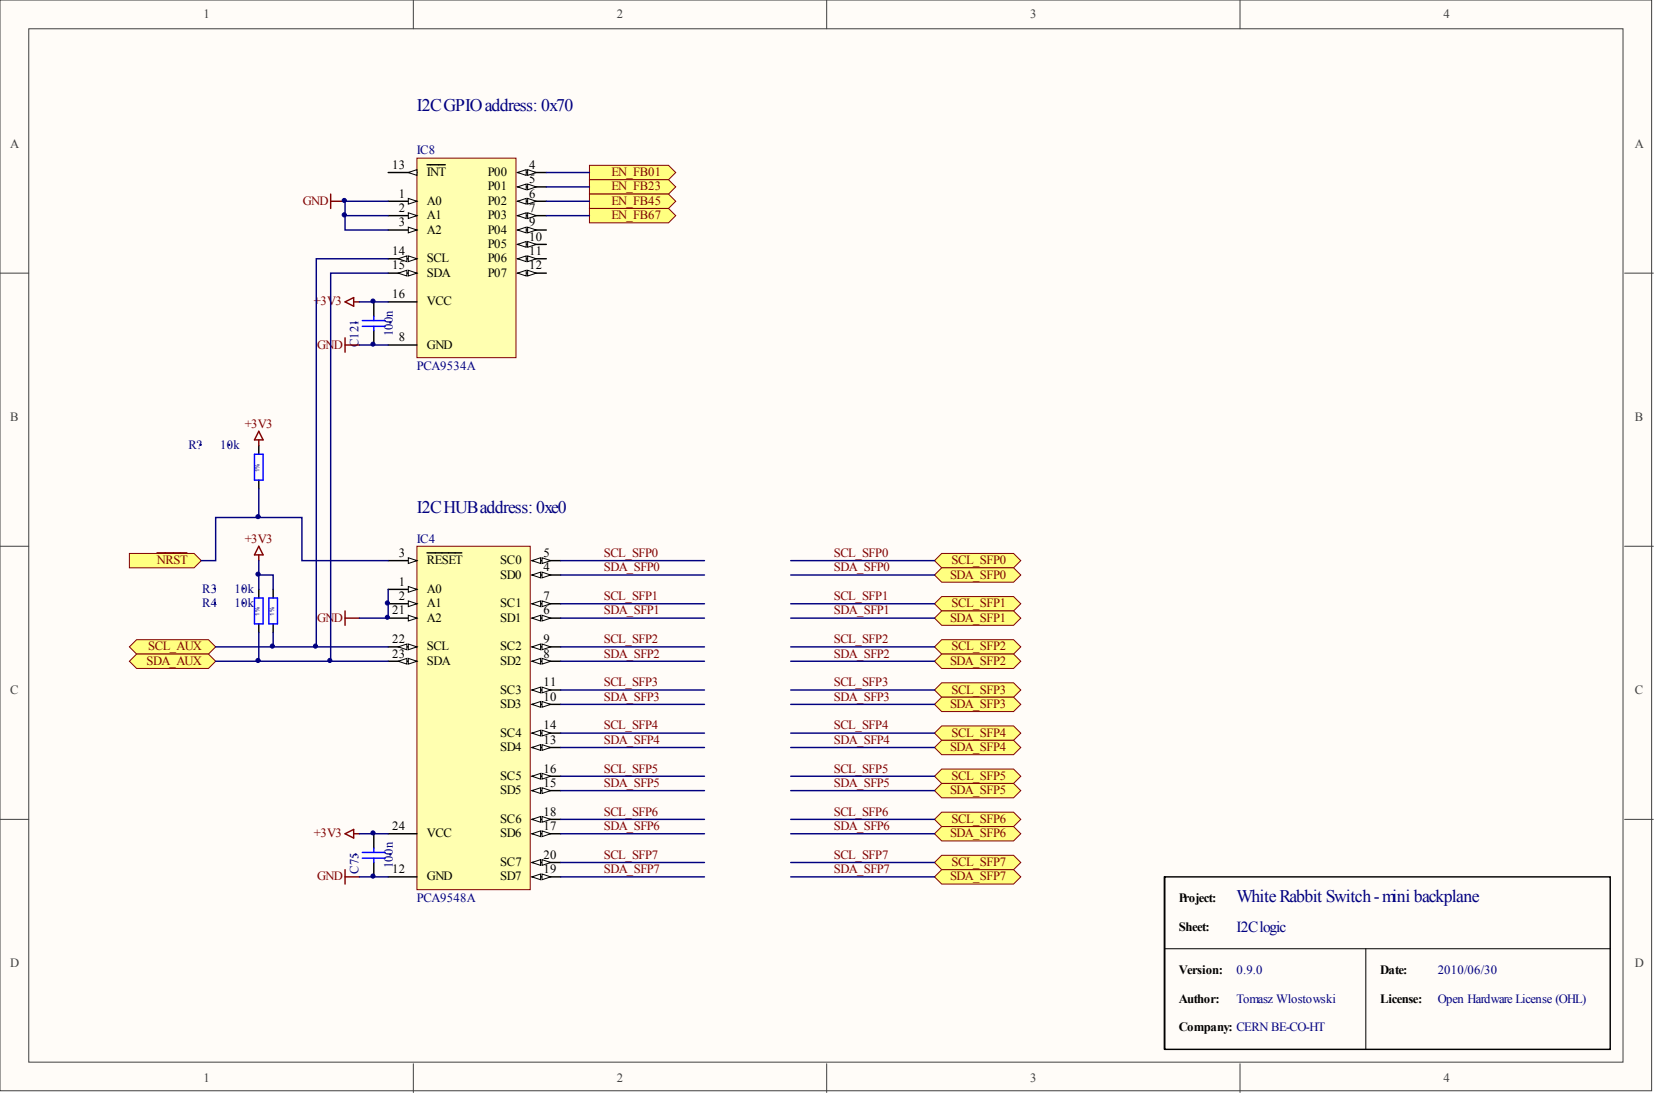
[picture p122: page 9]

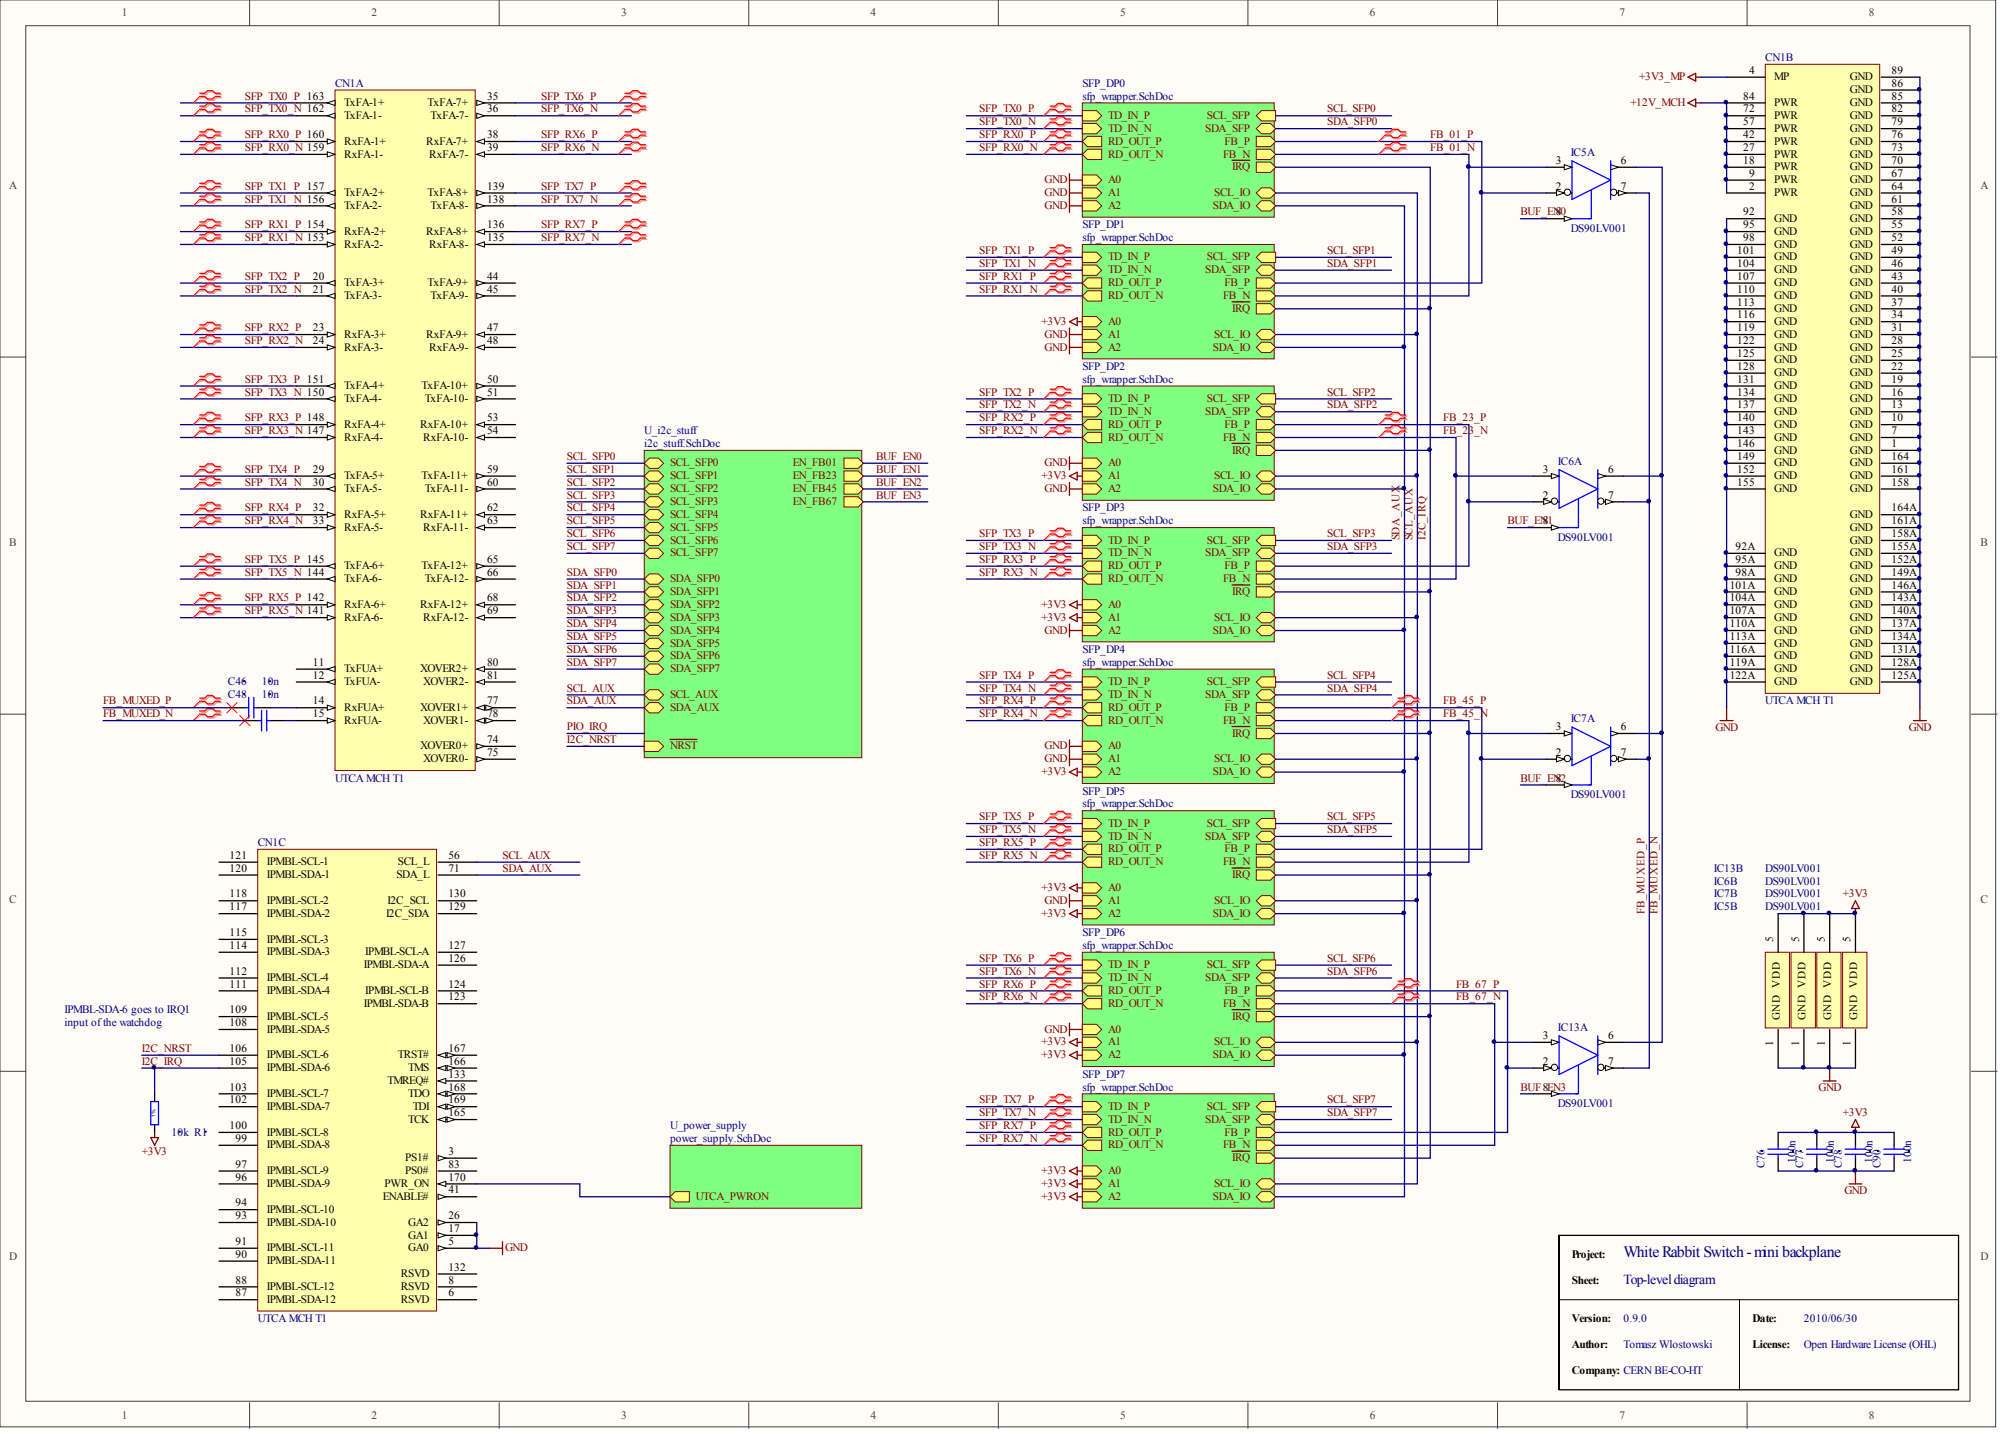
[picture p123: page 10]

GND GND GND GND GND GND GND GND GND GND GND GND +3V3 +3V3 +3V3 +3V3 +3V3 +3V3 +3V3 +3V3 +3V3 +3V3 +3V3

1 0 4 | 4 6
1 0 7 | 4 3

1 1 6 | 3 4
1 1 9 | 3 1
1 2 2 | 2 8

1 3 7 | 1 3
1 4 0 | 1 0

1 0 4 A | 1 4 3 A
1 0 7 A | 1 4 0 A

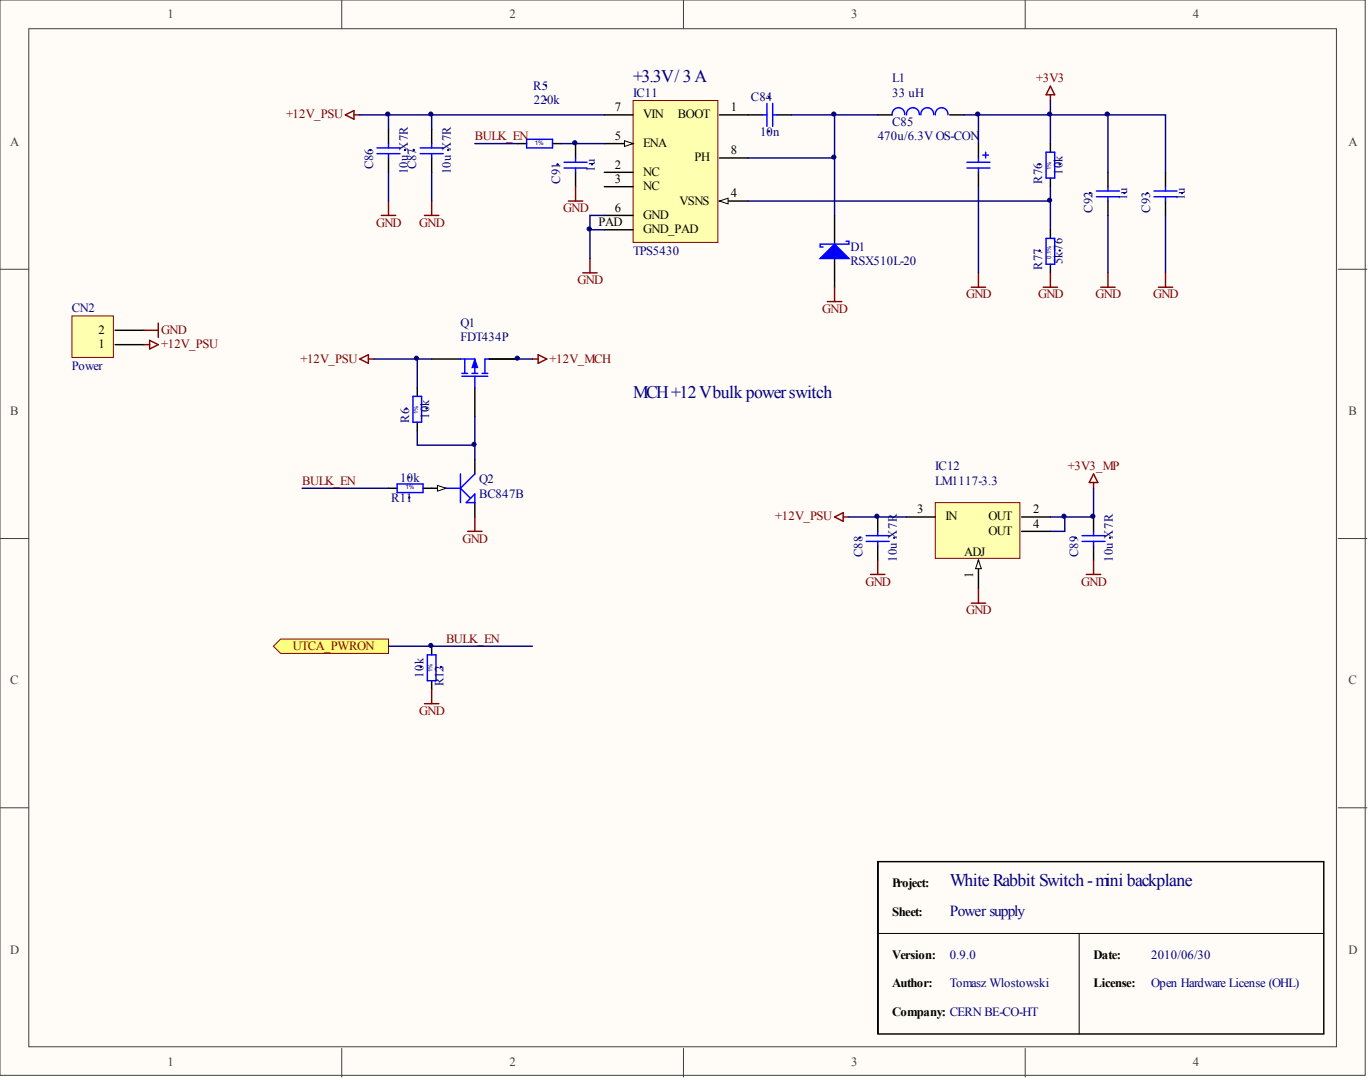
[picture p124: page 11]

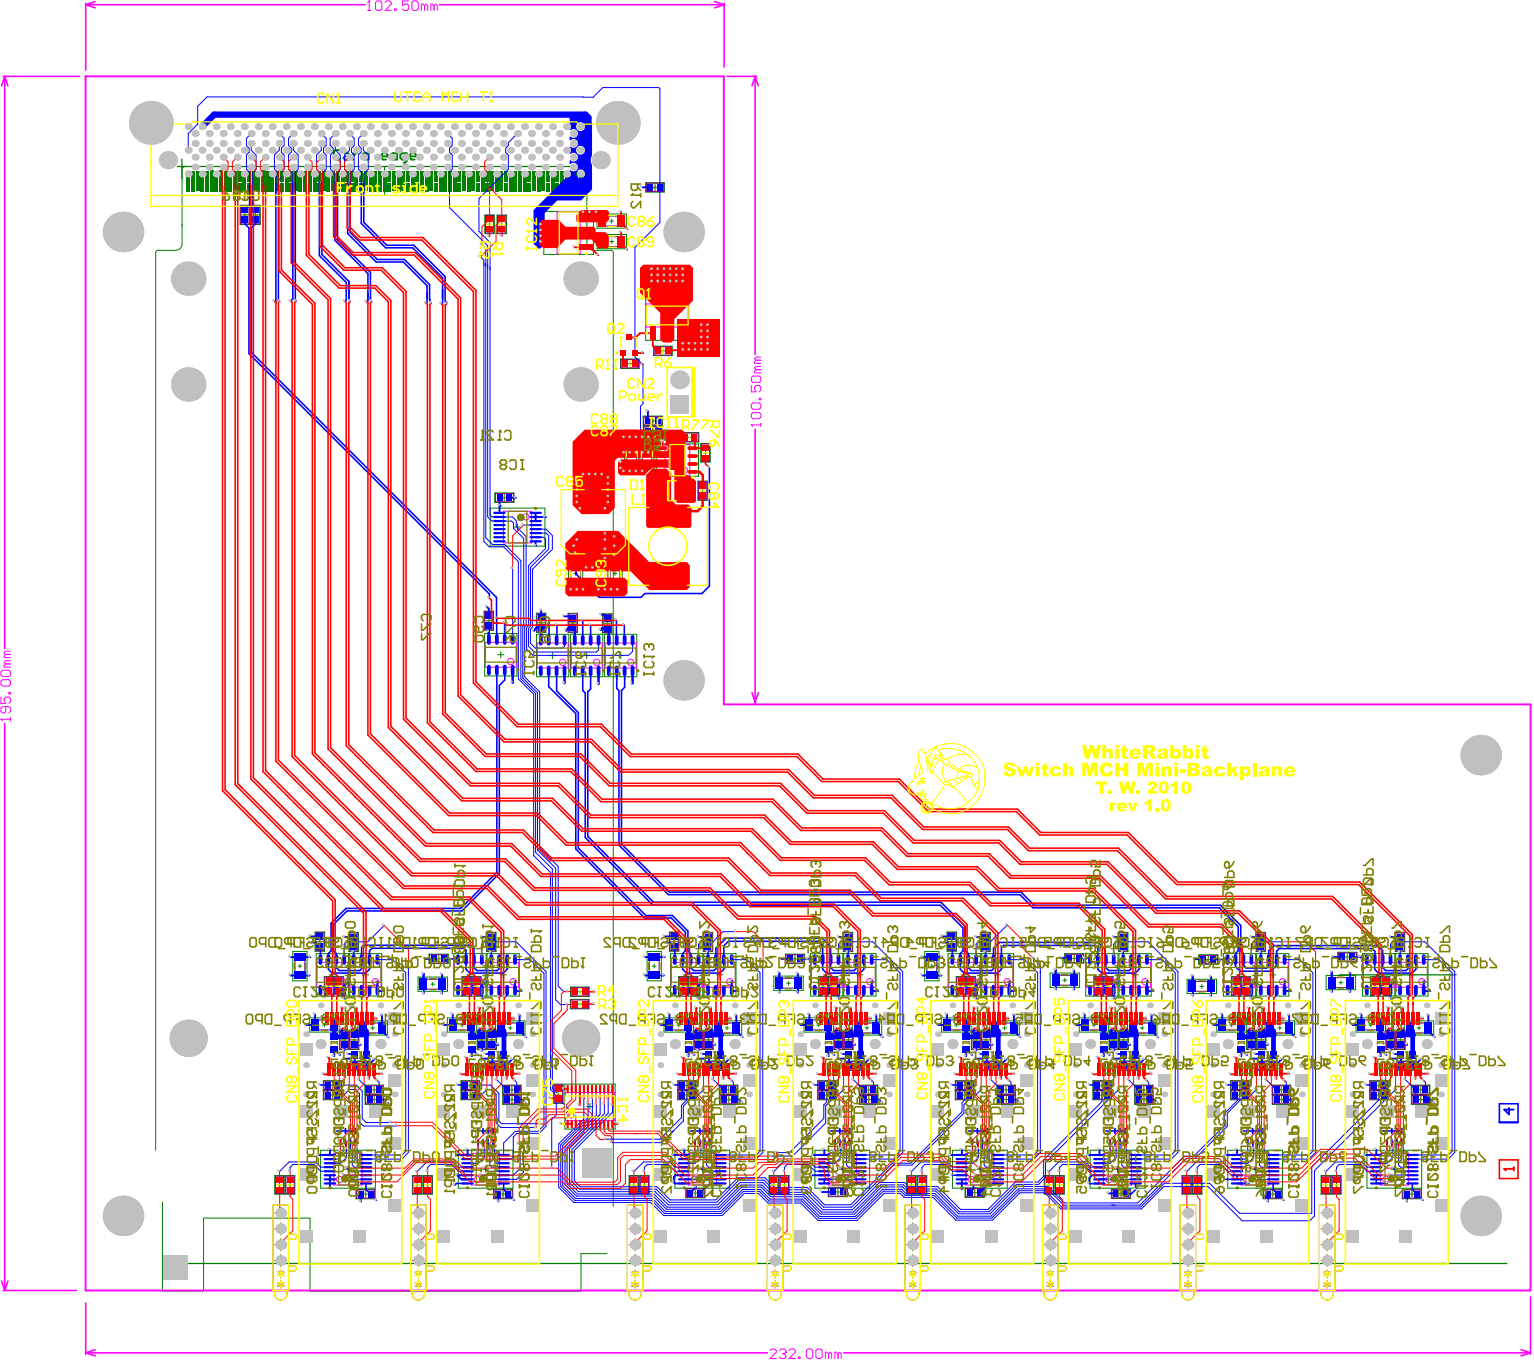
[picture p125: page 12]
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
