Reedgarden/WRS-HW/circuit_board/wrs_v2/MCH_MAIN/PDFs/MB_main_SchDoc.PDF

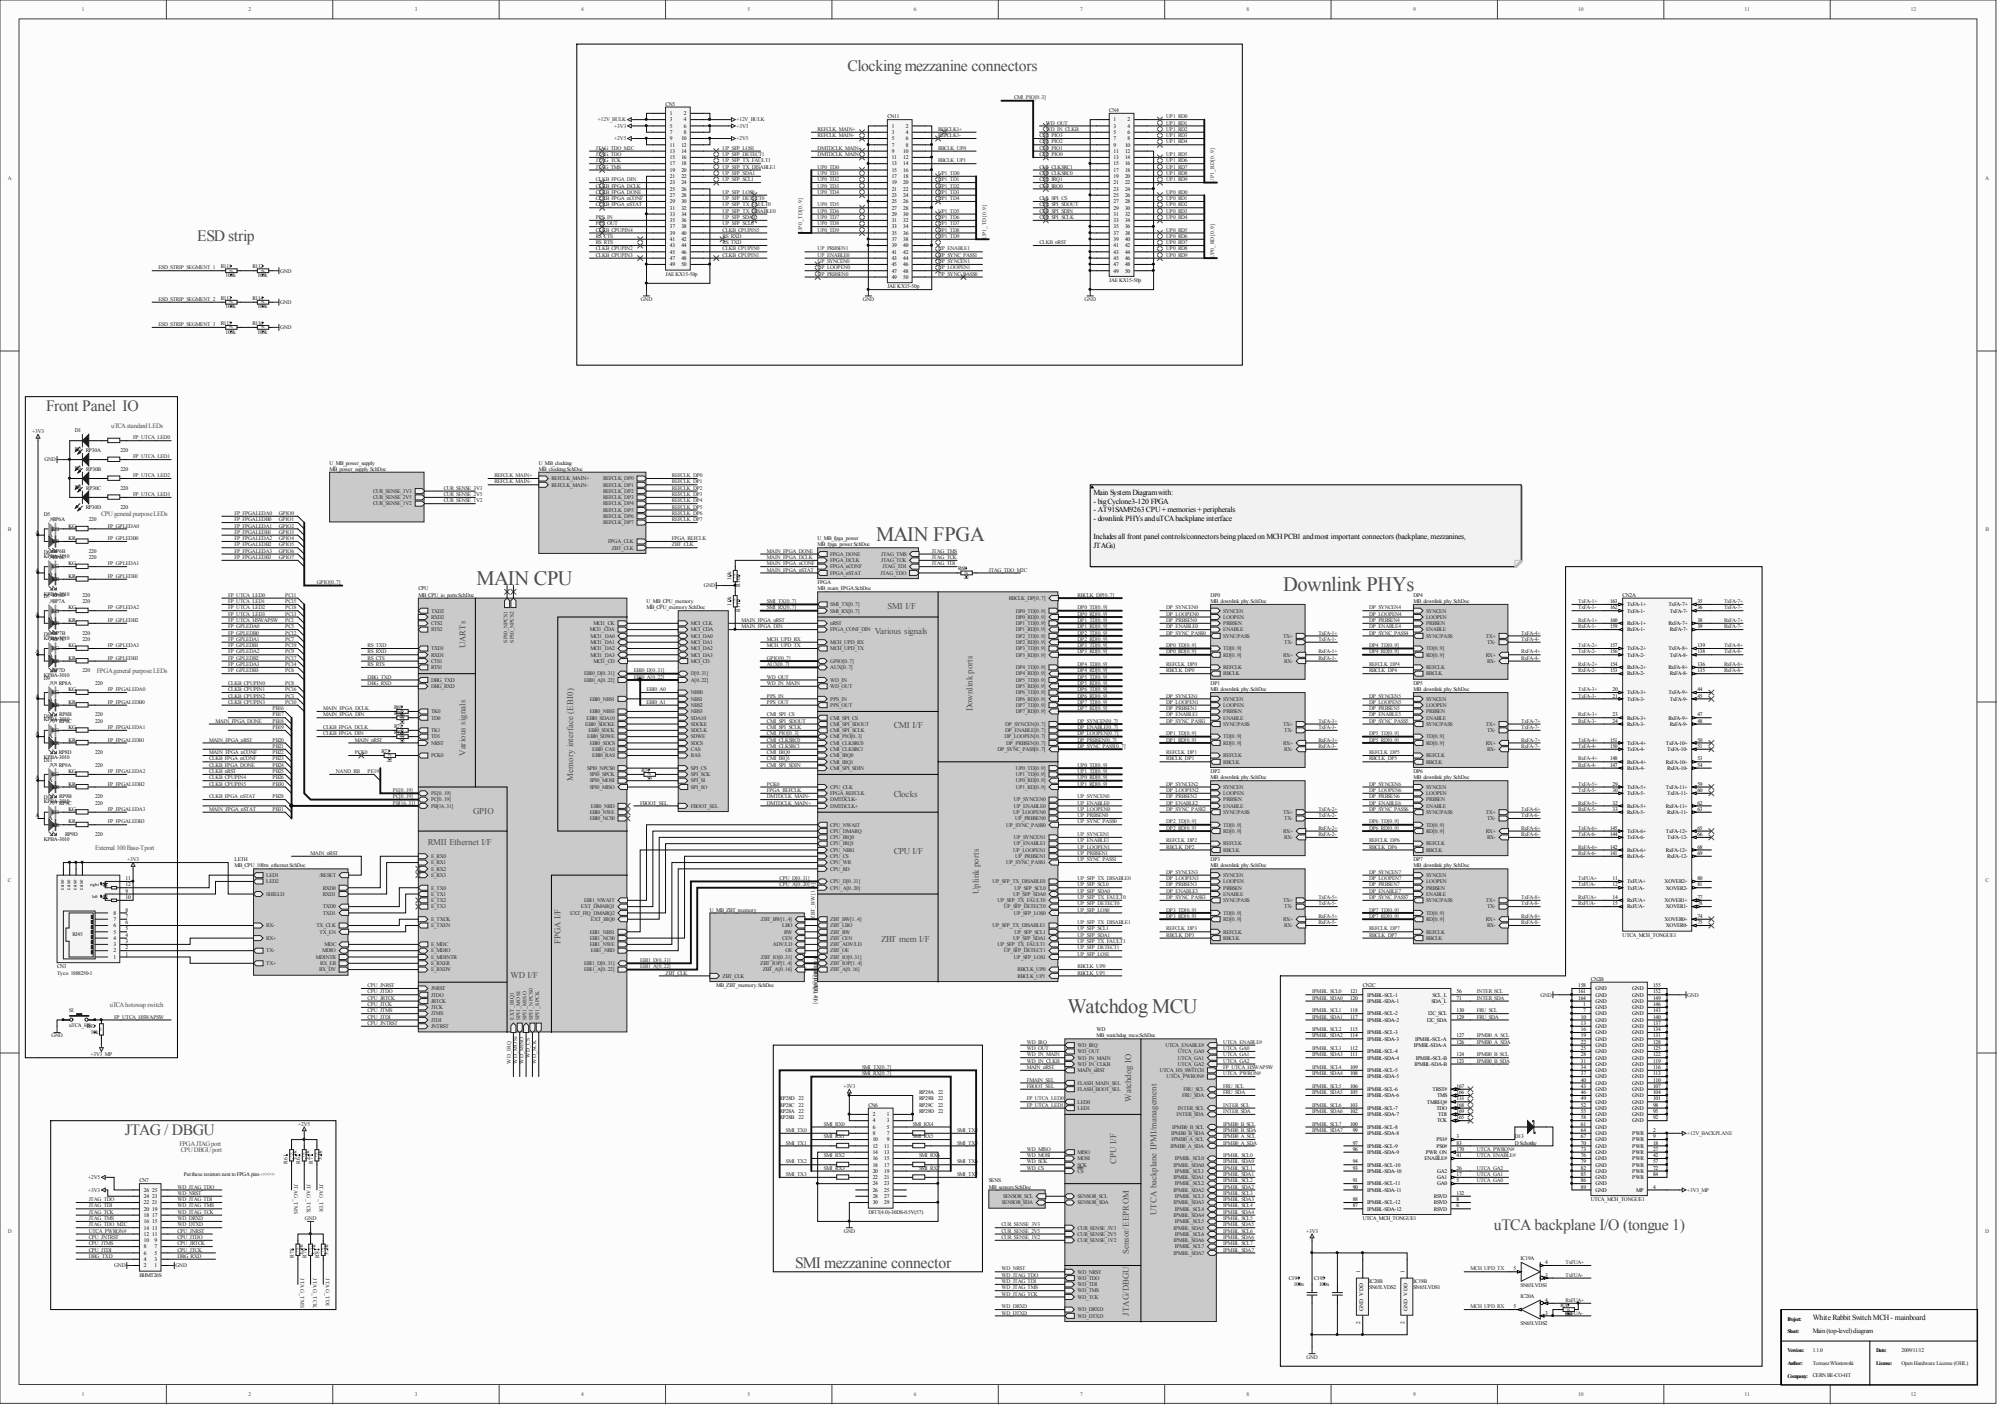
[picture p126: page 1]

UP0_TD2 | UP1_TD1 | CMI_IRQ1 | UP1_RD9
UP0_TD3 | UP1_TD2 | CMI_IRQ0 | UP0_RD0
UP0_TD4 | UP1_TD3 | CMI_SPI_CS
UP0_TD5 | UP1_TD4 | | UP0_RD1

UP1_TD5 | CMI_SPI_SDOUT | UP0_RD2

UP0_TD6 | | CMI_SPI_SDIN | UP0_RD3
UP0_TD7 | UP1_TD6 | CMI_SPI_SCLK | UP0_RD4
UP0_TD8 | UP1_TD7 | CLKB_nRST | UP0_RD5
UP0_TD9 | UP1_TD8

Main System Diagram with:
- big Cyclone3-120 FPGA
- AT91SAM9263 CPU + memories + peripherals
- downlink PHYs and uTCA backplane interface

Includes all front panel controls/connectors being placed on MCH PCB1 and most important connectors (backplane, mezzanines,
JTAGs)

Downlink ports Uplink ports

ADV/LD
OE

EBI1_D[0..31] | ZBT_IO[0..31] ZBT_IOP[1..4]

Put these resistors next to FPGA pins->>>>

White Rabbit Switch MCH - mainboard

Main (top-level) diagram

Open Hardware License (OHL)

Company: CERN BE-CO-HT
