Reedgarden/WRS-HW/mechanics/v3.3/pdf/01 - Front and top view.pdf

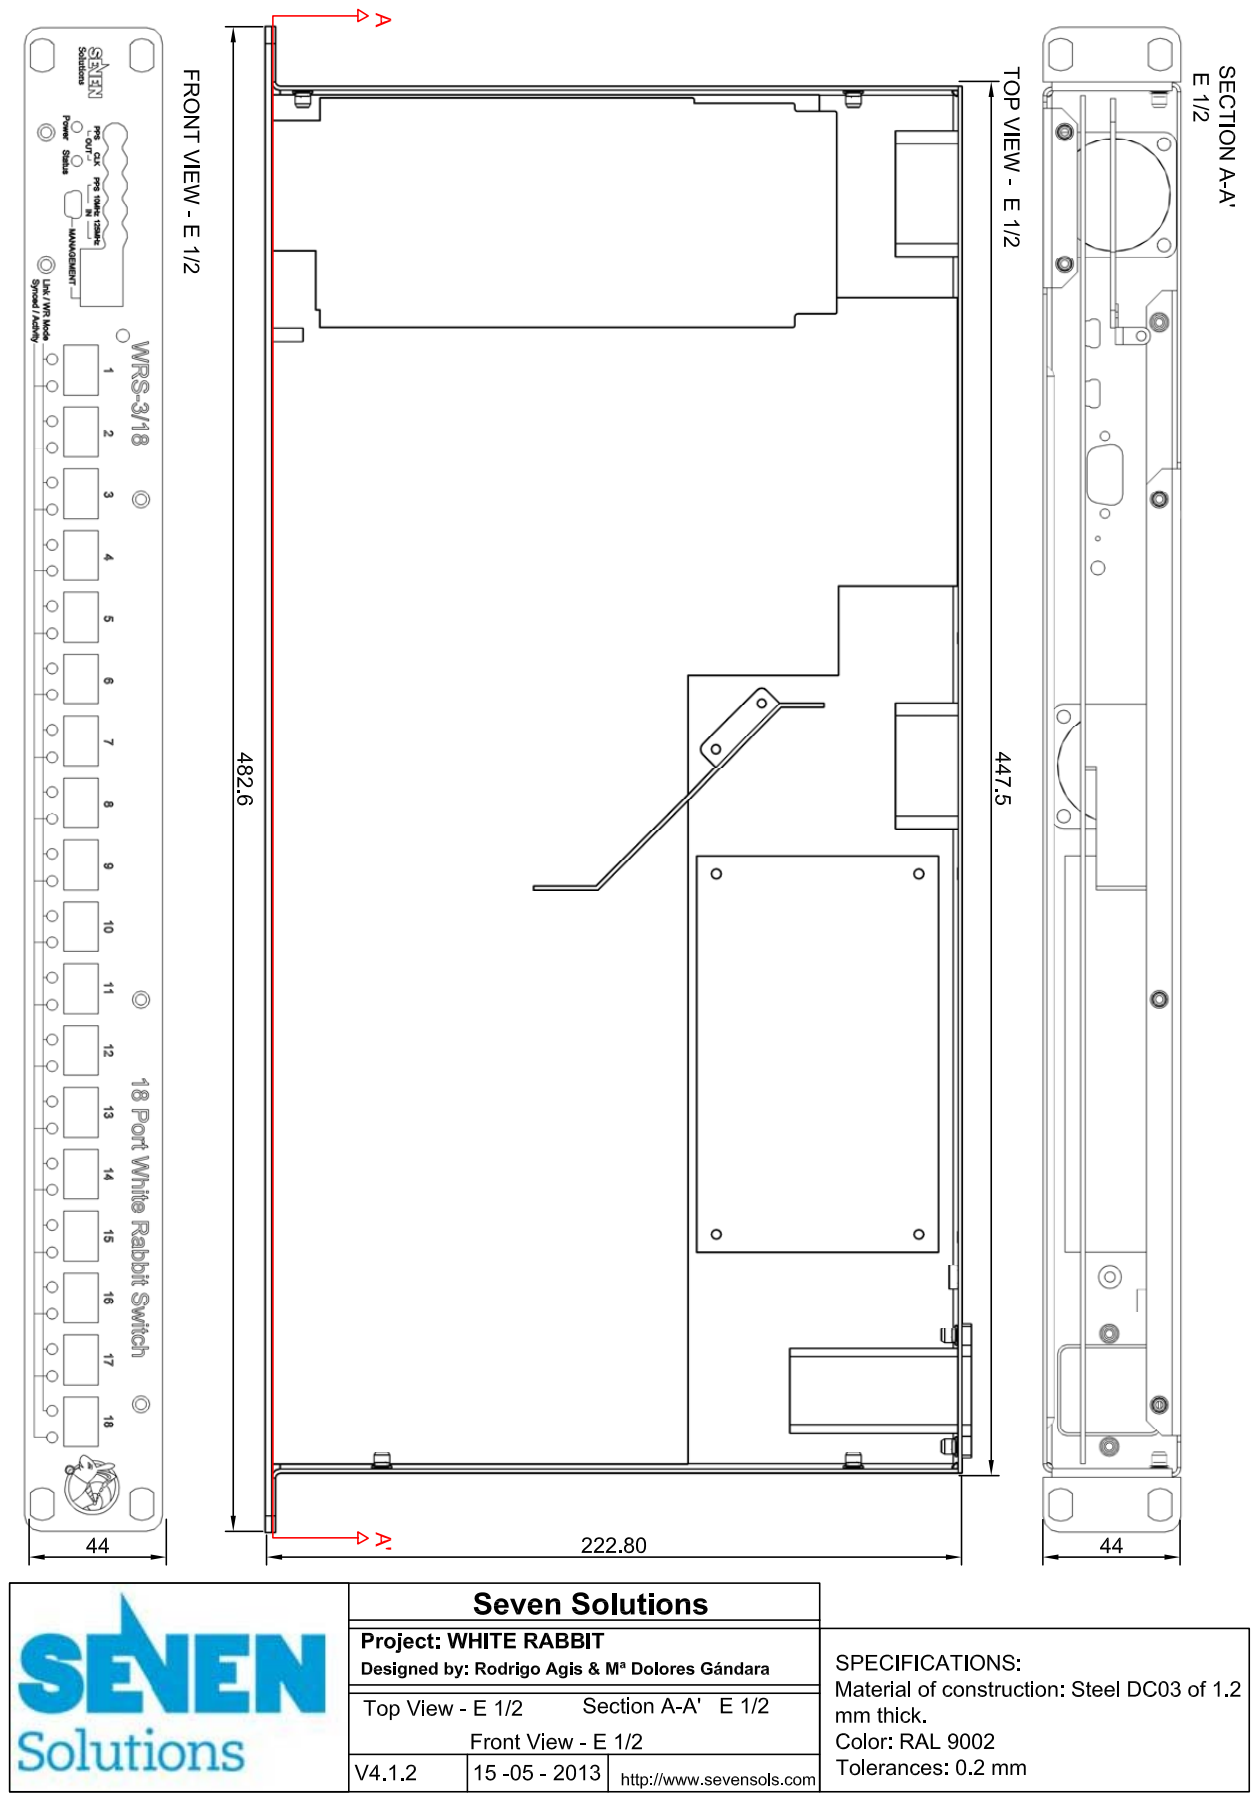
[picture p127: page 1]
