Reedgarden/WRS-HW/mechanics/v3.3/pdf/02 - Front View and Detail.pdf

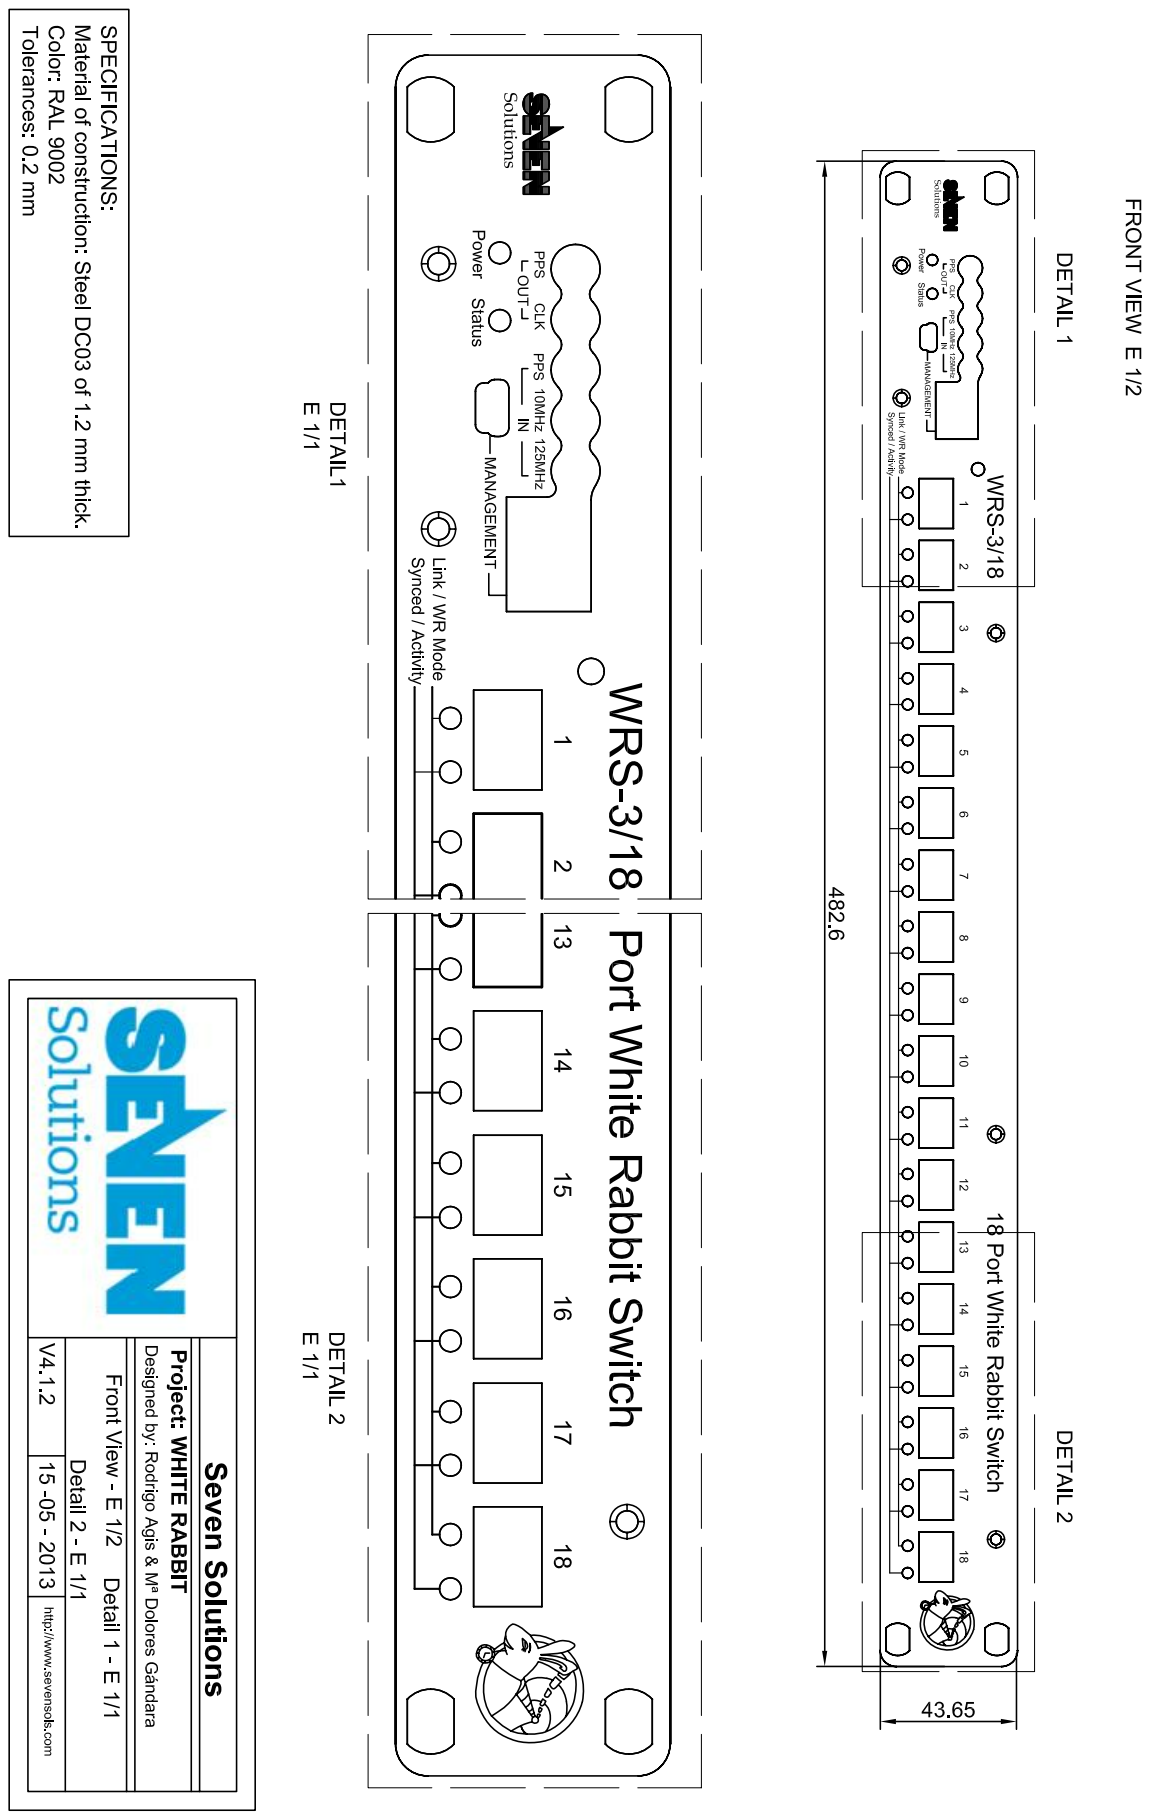
[picture p128: page 1]
