Reedgarden/WRS-HW/mechanics/v3.3/pdf/03 - Back Isometric Right view.pdf

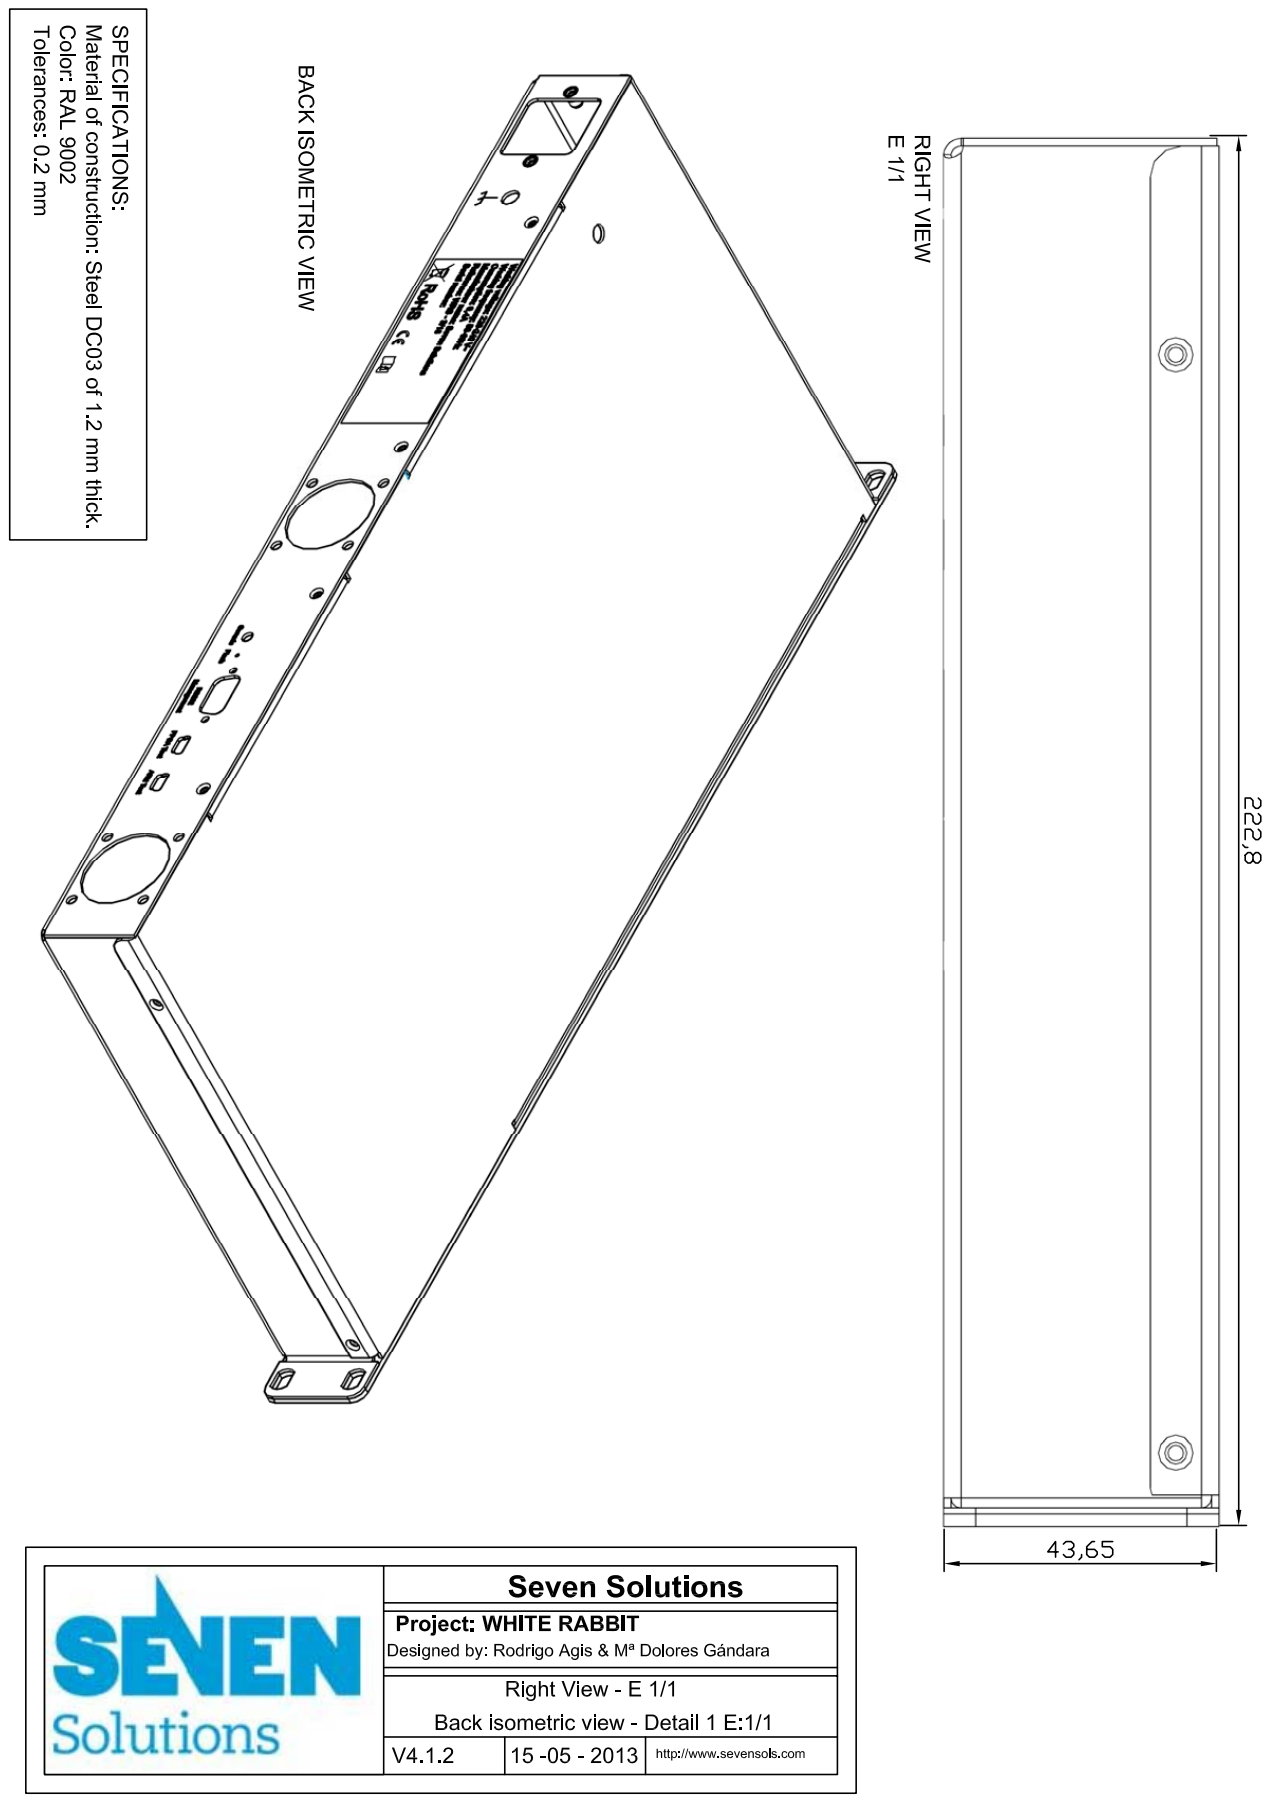
[picture p129: page 1]
