Reedgarden/WRS-HW/mechanics/v3.3/pdf/04 - Instruciones.pdf

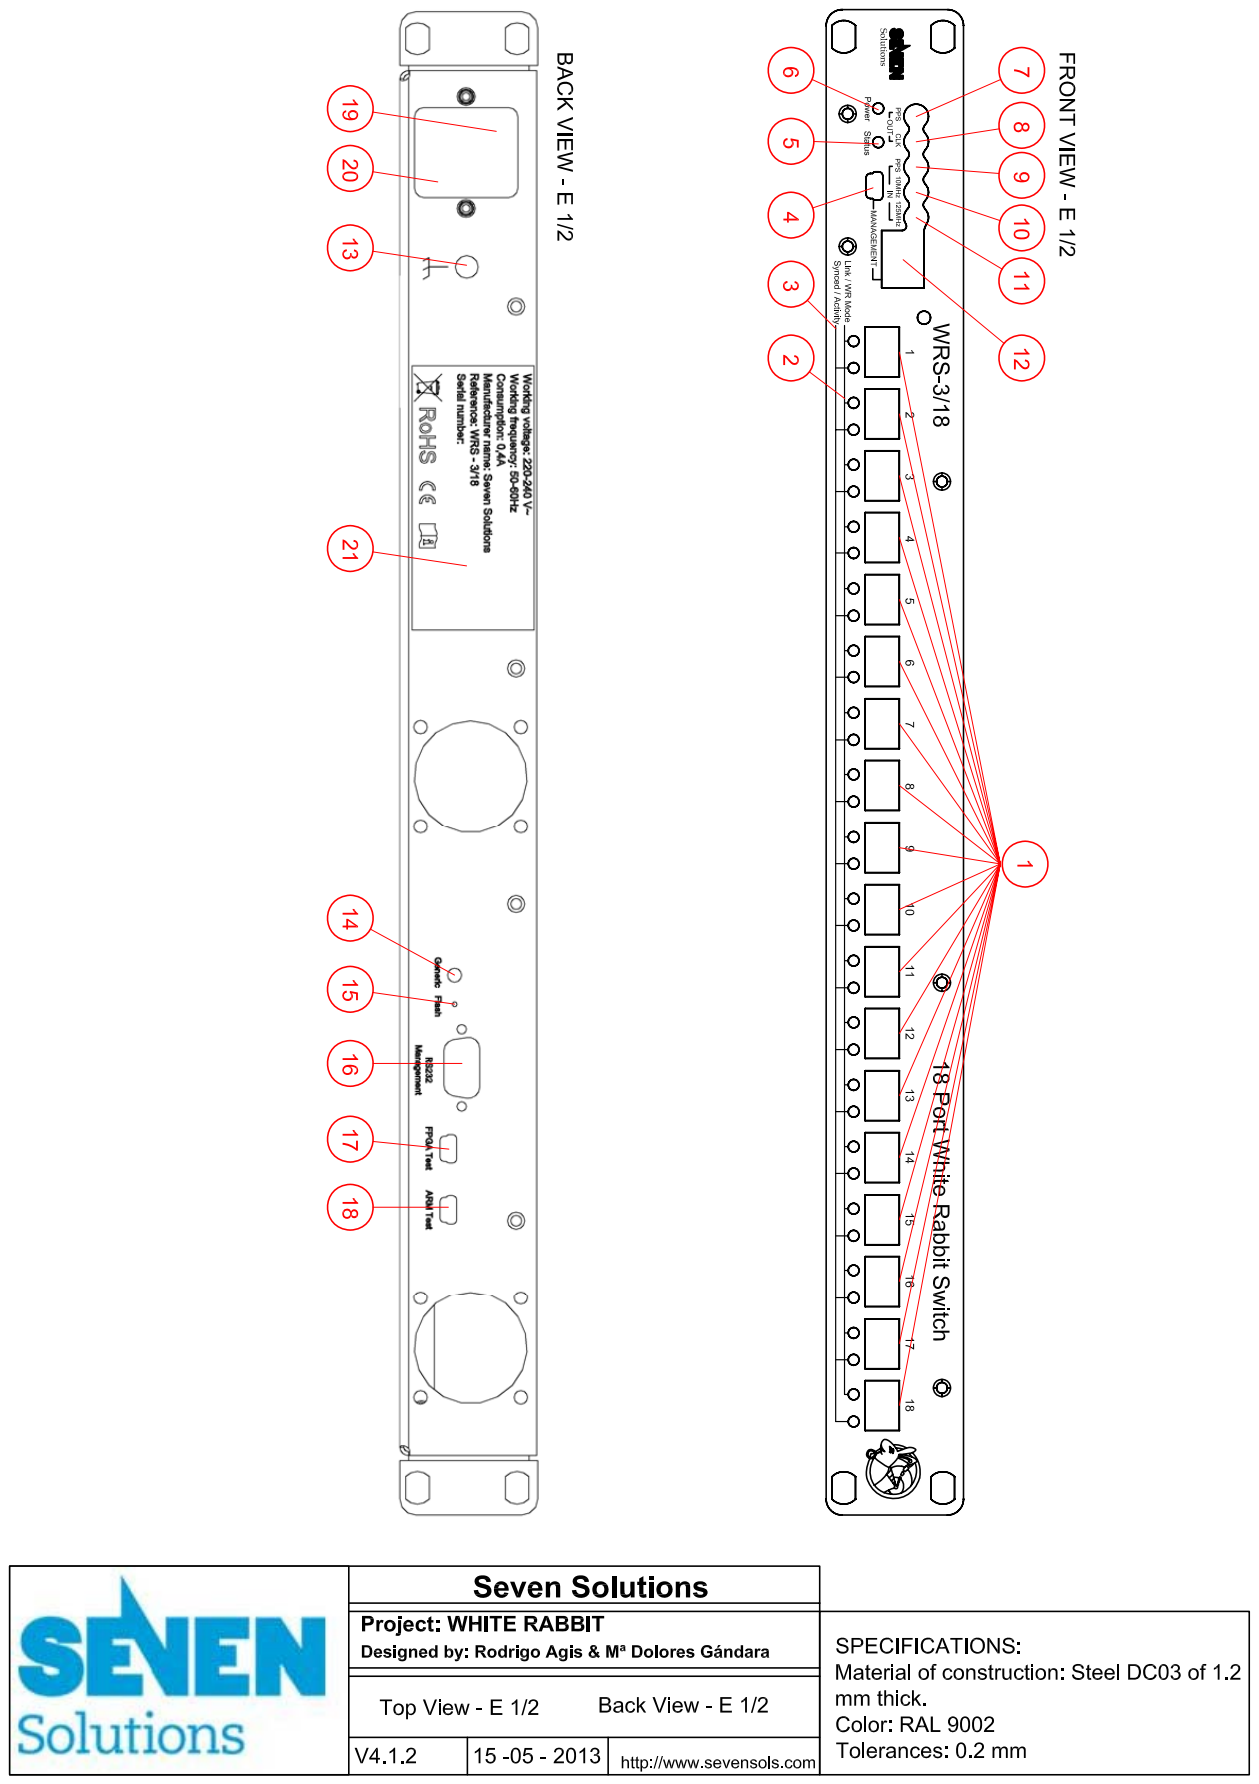
[picture p130: page 1]
