Reedgarden/WRS-HW/mechanics/v3.3/pdf/05 - Back View and details.pdf

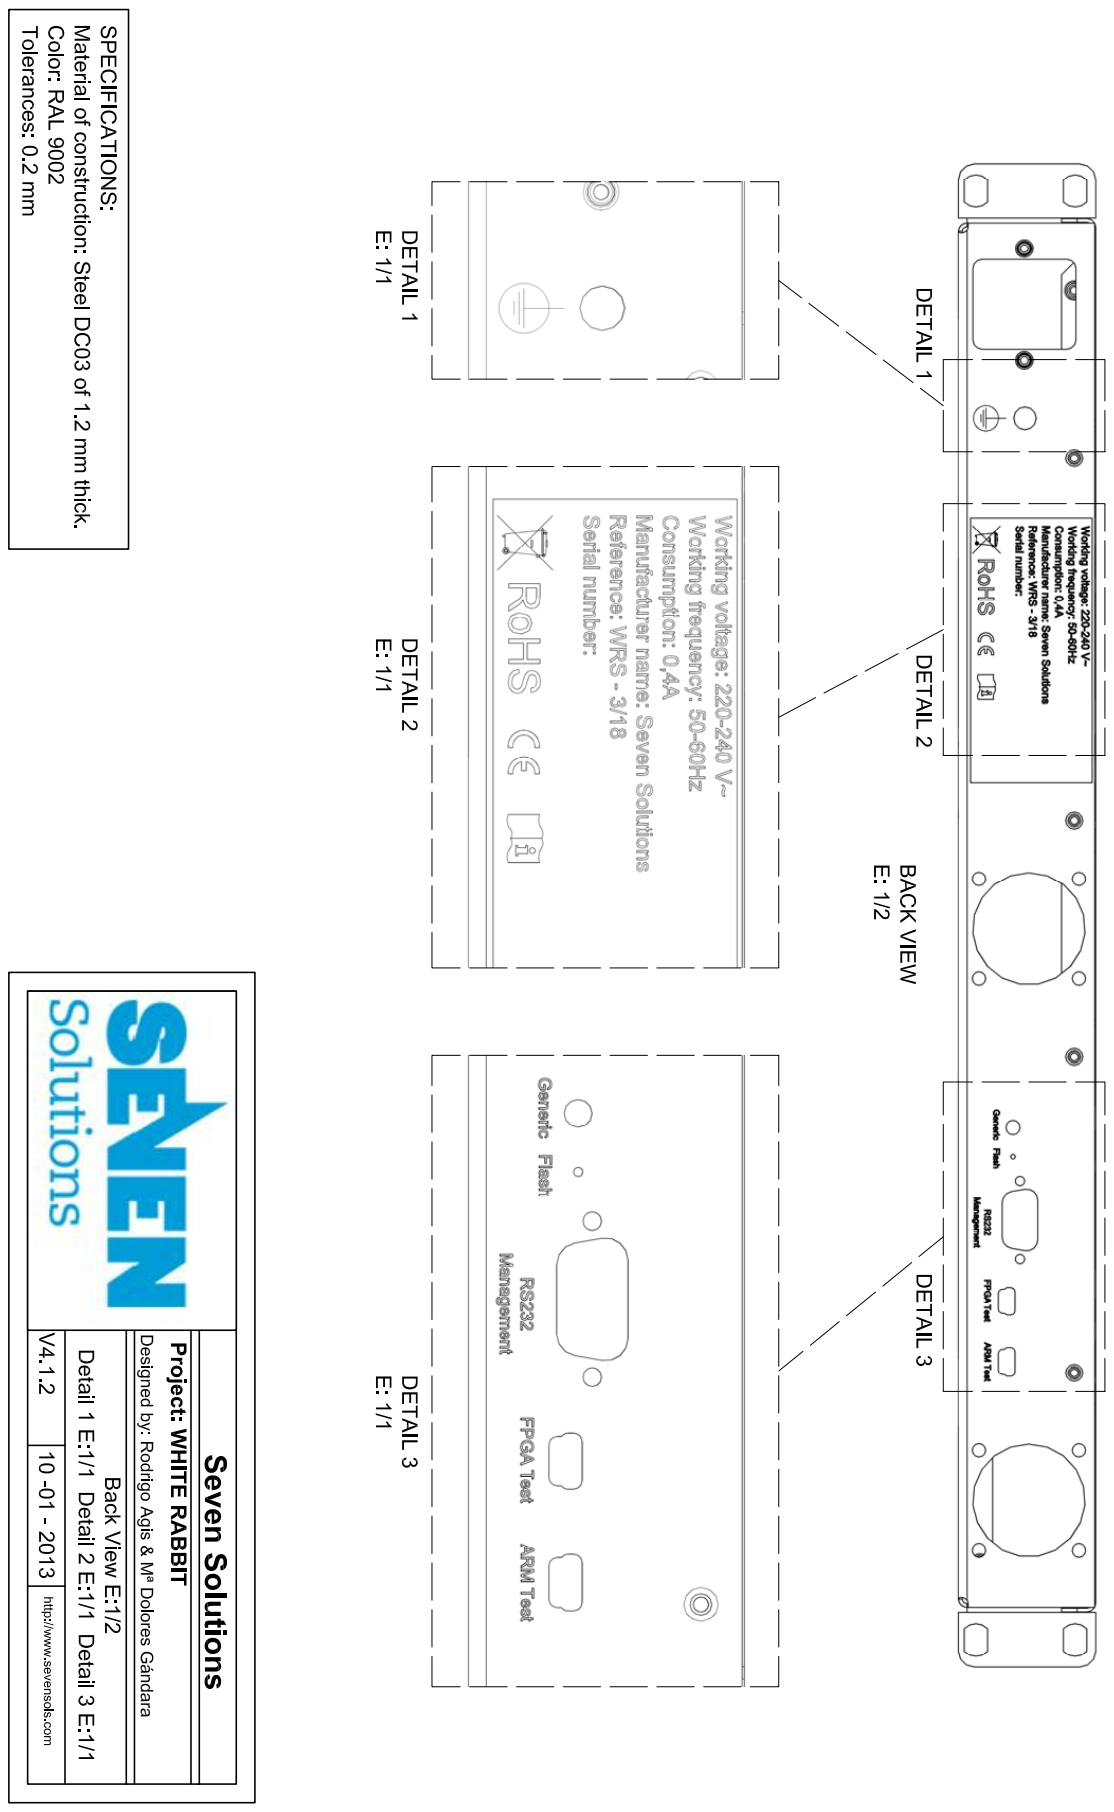
[picture p131: page 1]
