Reedgarden/WRS-HW/mechanics/v3.3/pdf/06 - Isometric view.pdf

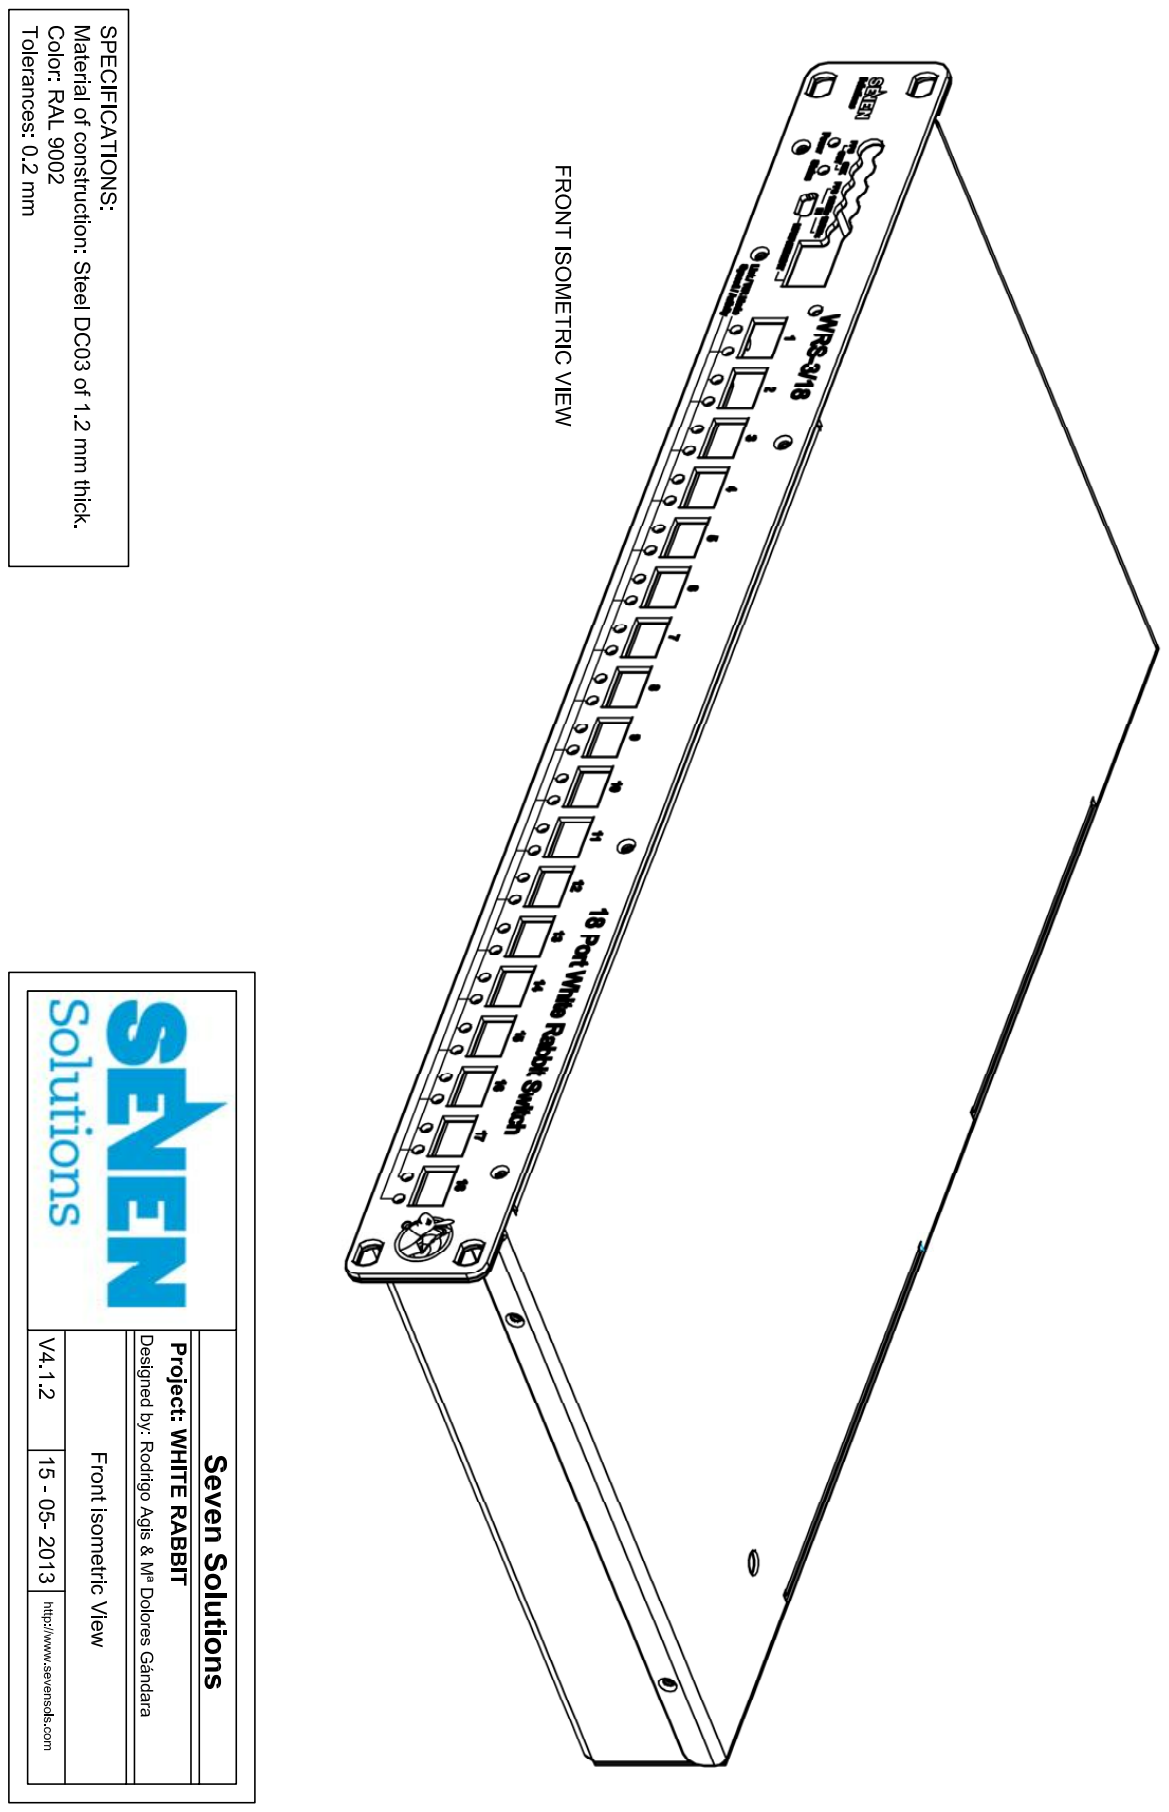
[picture p132: page 1]
