Reedgarden/WRS-HW/mechanics/v3.3/pdf/07 - Isometric view 2.pdf

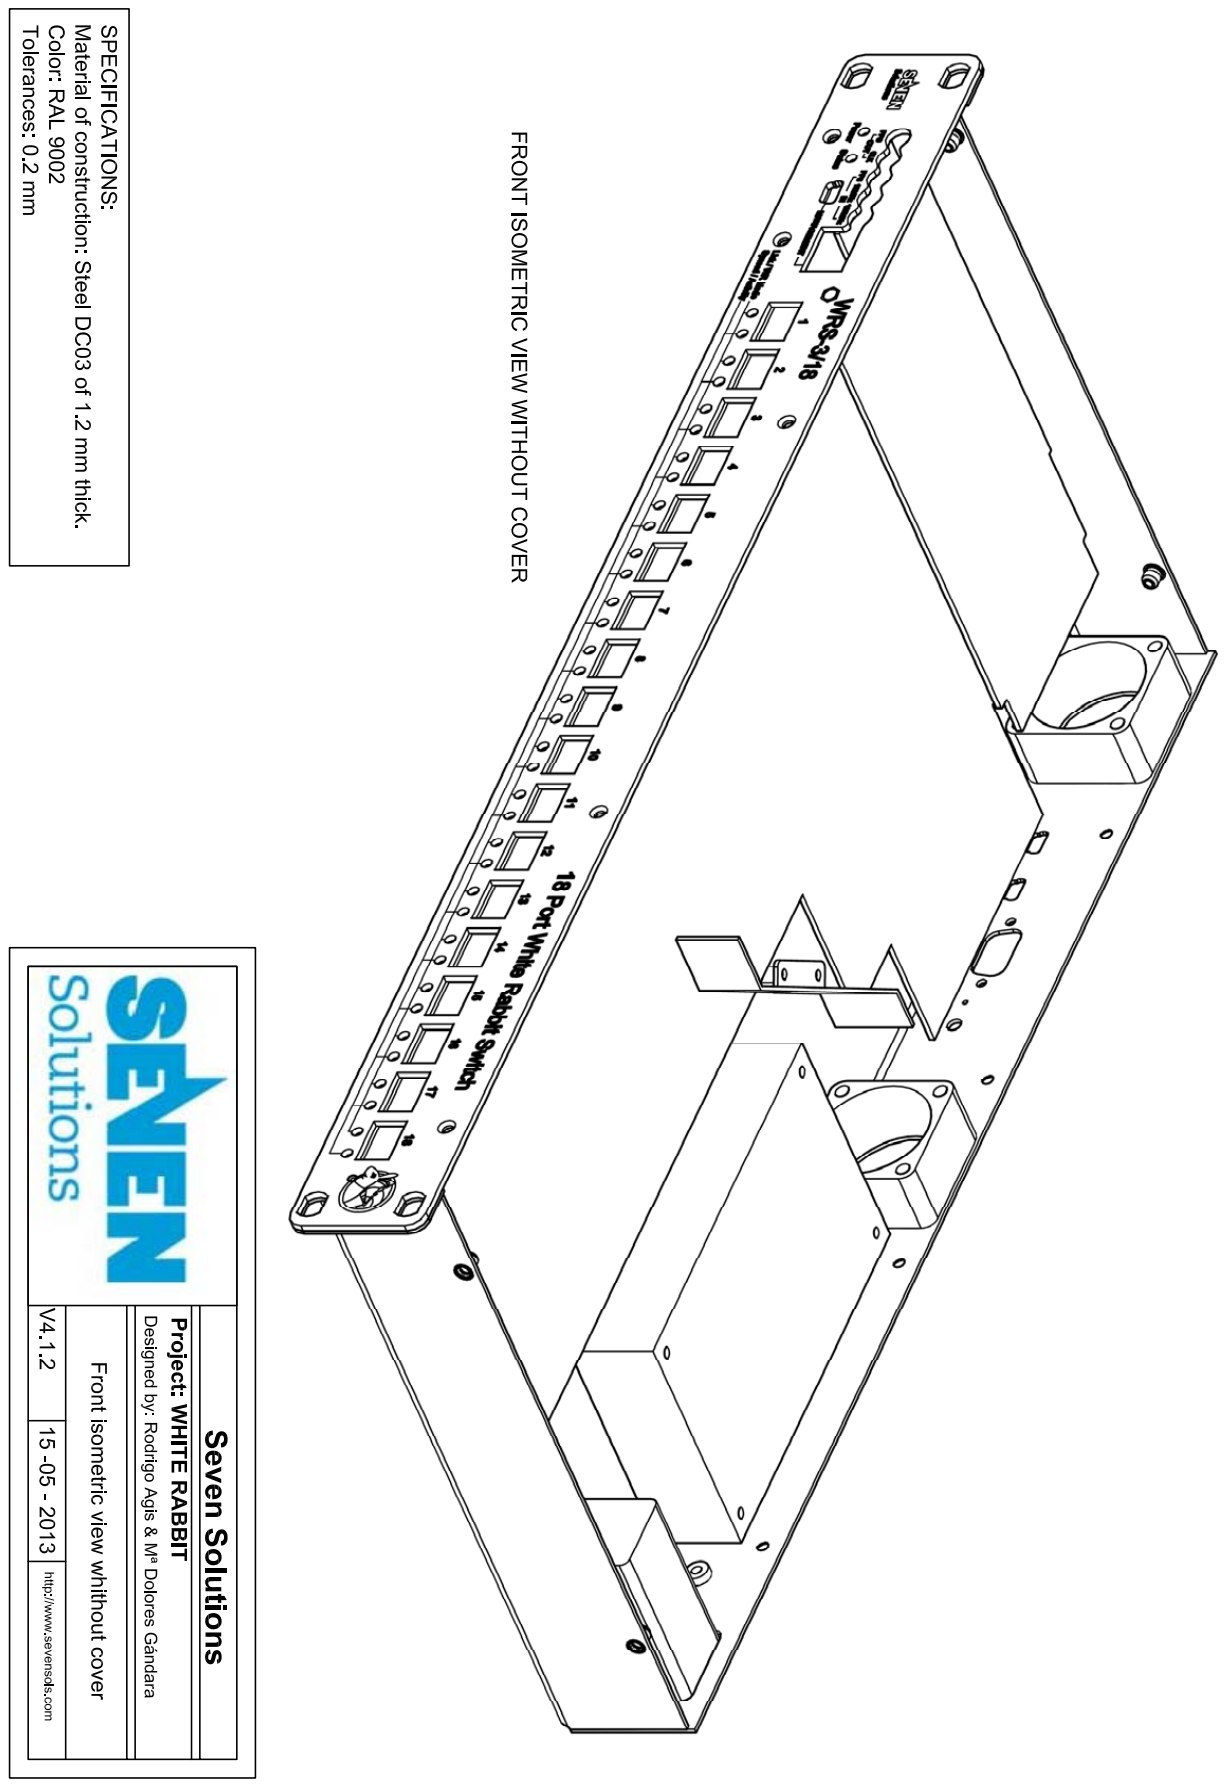
[picture p133: page 1]
