Reedgarden/WRS-HW/mechanics/v3.3/pdf/08 - Isometric view 3.pdf

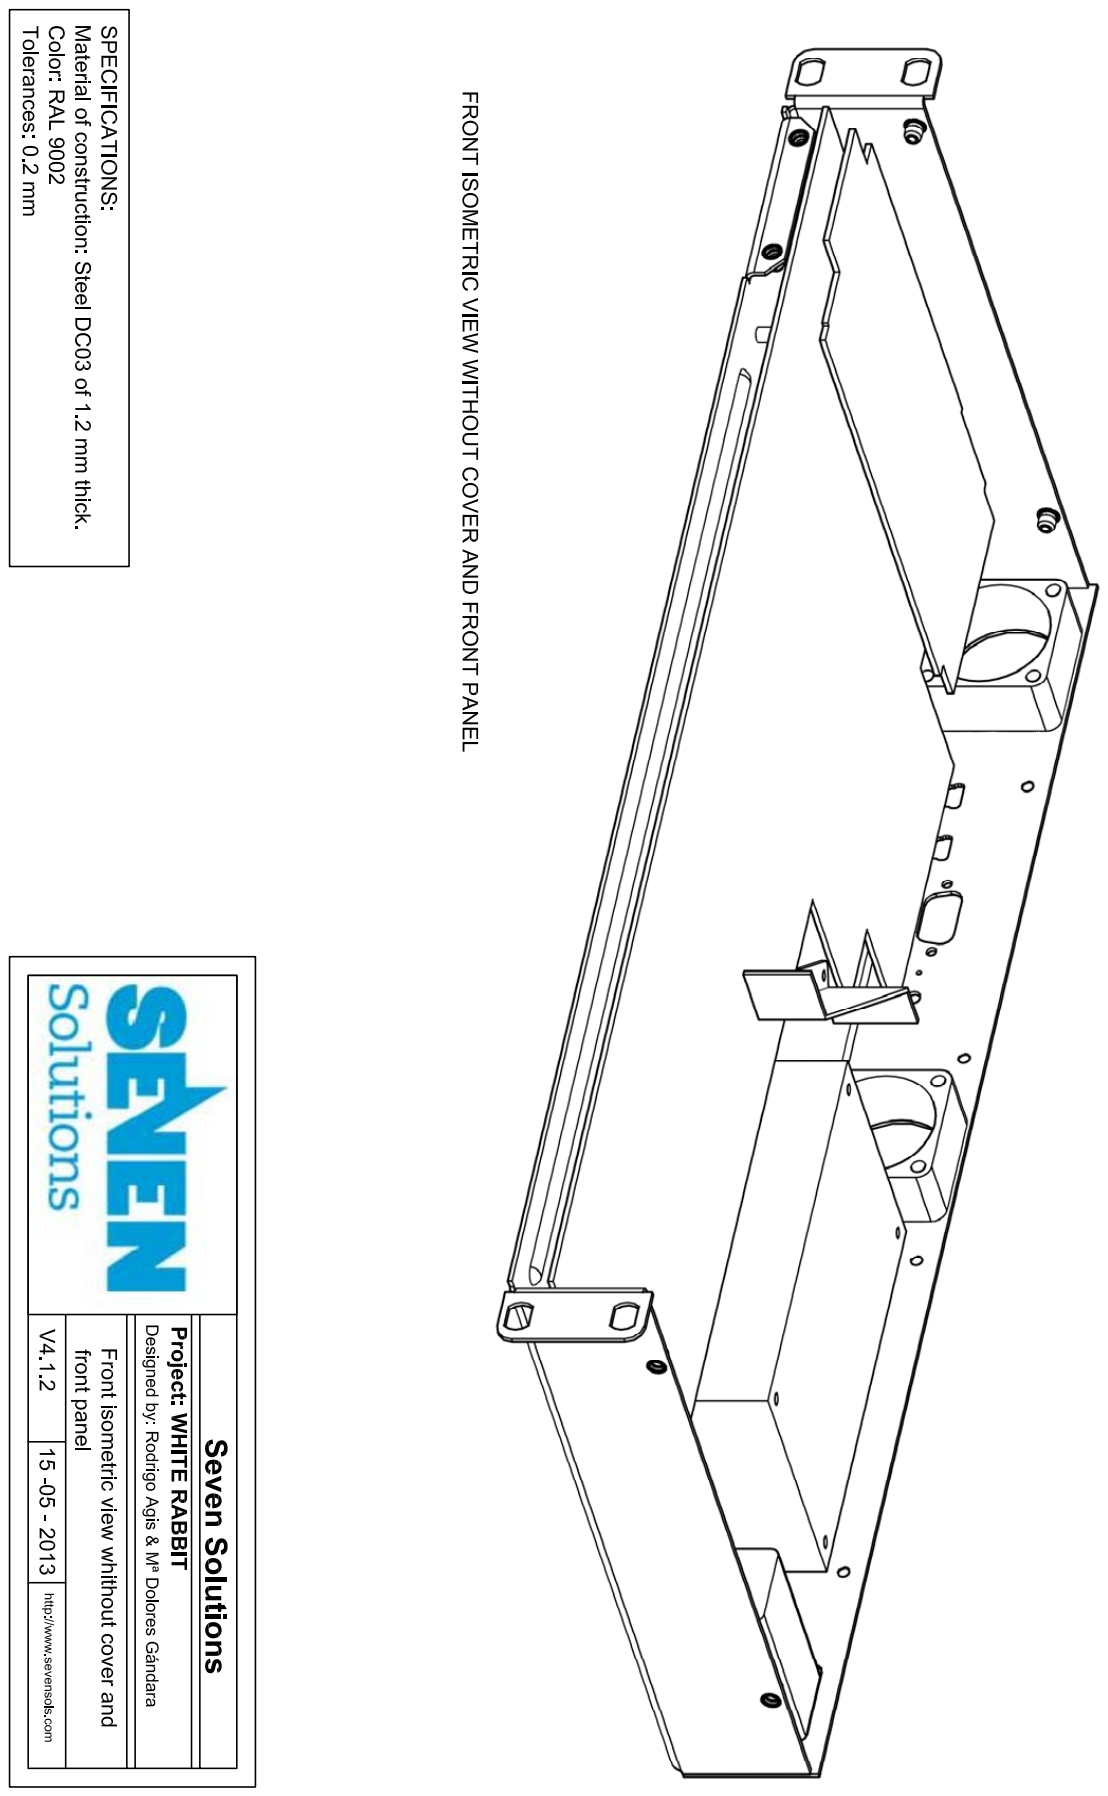
[picture p134: page 1]
