Reedgarden/WRS-HW/mechanics/v3.3/pdf/09 -  Isometric view 4.pdf

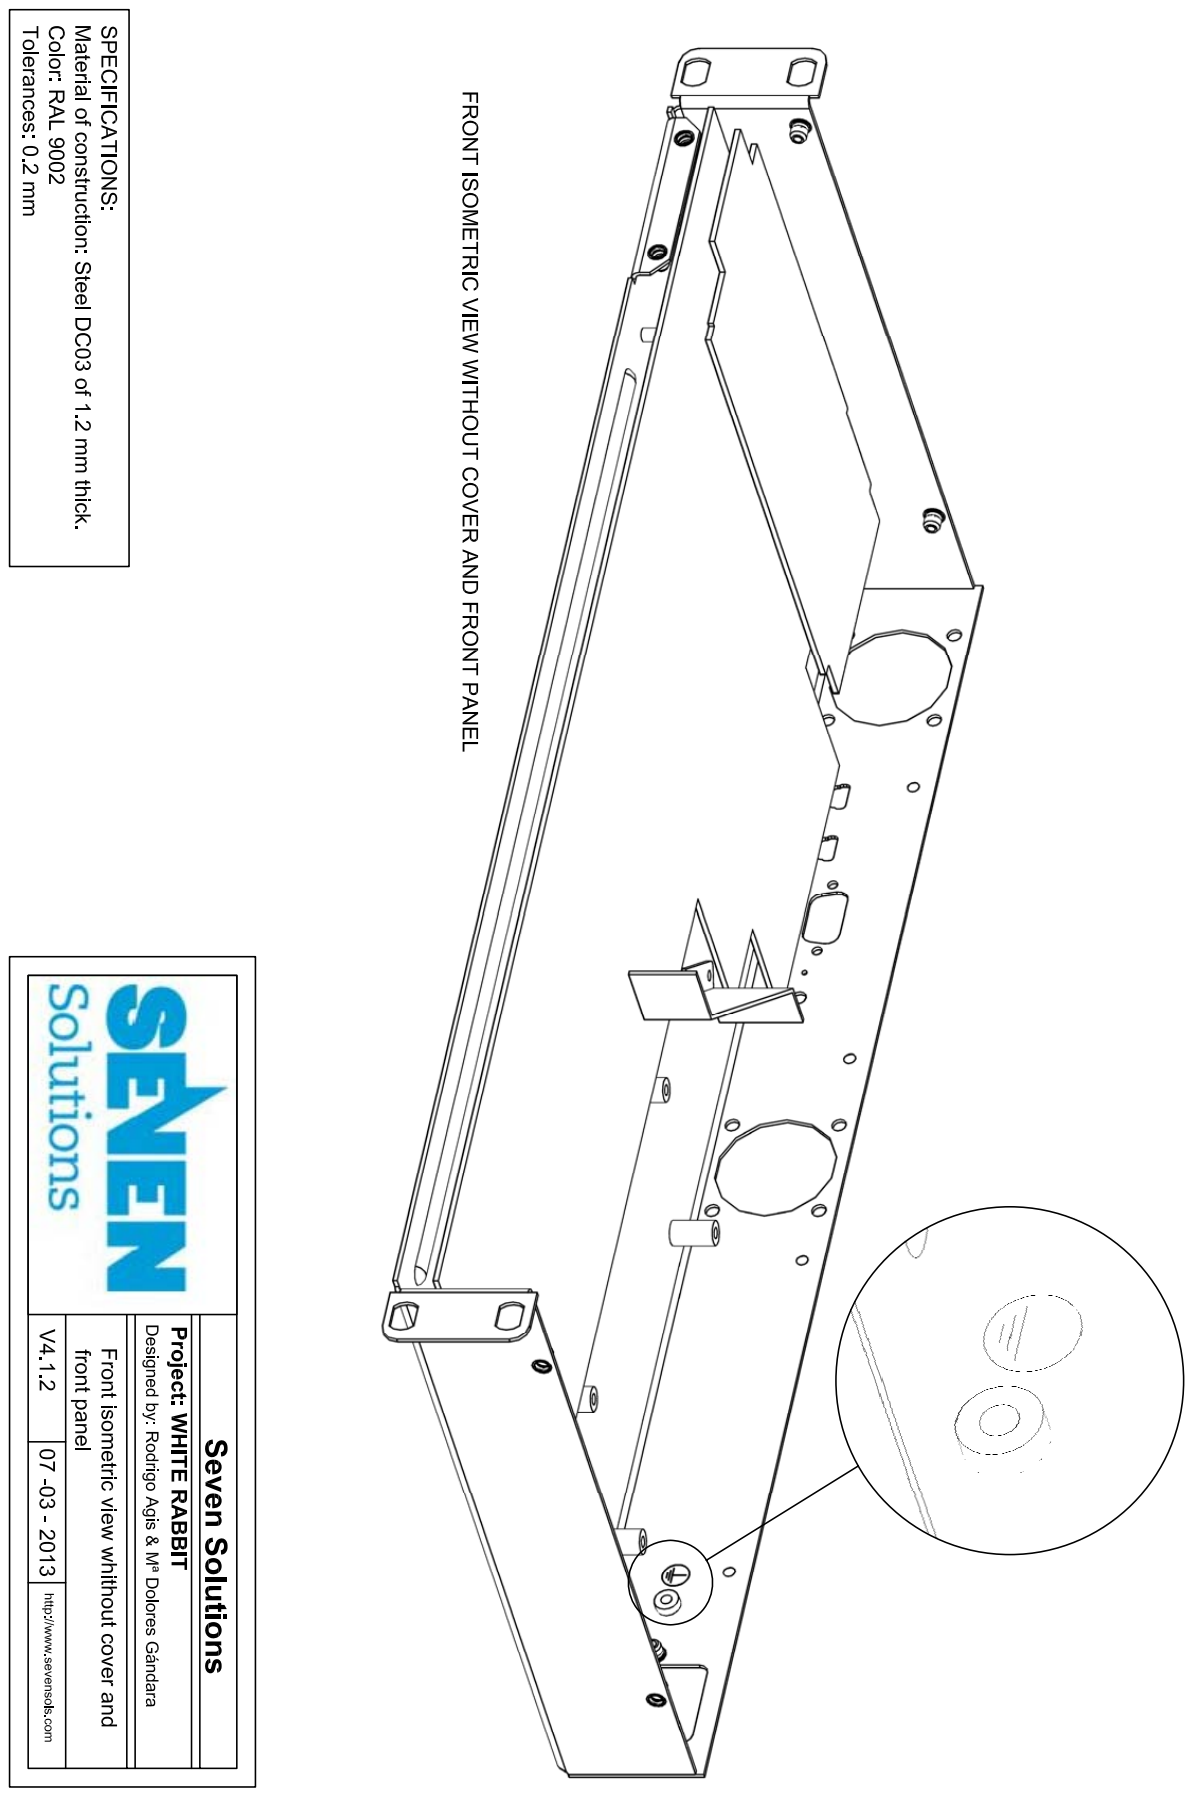
[picture p135: page 1]
