Reedgarden/WRS-HW/(list of files, drawings)

Other design files:
circuit_board/MCH_MAIN/MCH_MAIN.PCBDOC
circuit_board/wr_mch_clocking_module.PrjPcb
circuit_board/wrs_v2/AMC_SFP/AMC_SFP.PcbDoc
circuit_board/wrs_v2/AMC_SFP/AMC_SFP.PrjPcb
circuit_board/wrs_v2/AMC_SFP/AMC_SFP.SchDoc
circuit_board/wrs_v2/common/templates/uTCA_MCH_PCB1_template.PcbDoc
circuit_board/wrs_v2/common/templates/uTCA_MCH_PCB2_4_stub_template.PcbDoc
circuit_board/wrs_v2/common/templates/uTCA_MCH_PCB3_template.PcbDoc
circuit_board/wrs_v2/MCH_CLKB/CLKB_analog_phase_detector.SchDoc
circuit_board/wrs_v2/MCH_CLKB/CLKB_clocking_fpga.SchDoc
circuit_board/wrs_v2/MCH_CLKB/CLKB_clocking_system.SchDoc
circuit_board/wrs_v2/MCH_CLKB/CLKB_fabric_interface.SchDoc
circuit_board/wrs_v2/MCH_CLKB/CLKB_main.SchDoc
circuit_board/wrs_v2/MCH_CLKB/CLKB_power_regulators.SchDoc
circuit_board/wrs_v2/MCH_CLKB/CLKB_RS232_port.SchDoc
circuit_board/wrs_v2/MCH_CLKB/CLKB_SFP_wrapper.SchDoc
circuit_board/wrs_v2/MCH_CLKB/CLKB_temp_sensors.SchDoc
circuit_board/wrs_v2/MCH_CLKB/CLKB_uplink_phy.SchDoc
circuit_board/wrs_v2/MCH_CLKB/CLKB_uplinks.SchDoc
circuit_board/wrs_v2/MCH_CLKB/MCH_CLKB.PrjPcb
circuit_board/wrs_v2/MCH_CLKB/MCH_CLKB_PCB.PcbDoc
circuit_board/wrs_v2/MCH_MAIN/MB_clocking.SchDoc
circuit_board/wrs_v2/MCH_MAIN/MB_CPU_100m_ethernet.SchDoc
circuit_board/wrs_v2/MCH_MAIN/MB_CPU_io_ports.SchDoc
circuit_board/wrs_v2/MCH_MAIN/MB_CPU_memory.SchDoc
circuit_board/wrs_v2/MCH_MAIN/MB_downlink_phy.SchDoc
circuit_board/wrs_v2/MCH_MAIN/MB_fpga_power.SchDoc
circuit_board/wrs_v2/MCH_MAIN/MB_main.SchDoc
circuit_board/wrs_v2/MCH_MAIN/MB_main_FPGA.SchDoc
circuit_board/wrs_v2/MCH_MAIN/MB_power_supply.SchDoc
circuit_board/wrs_v2/MCH_MAIN/MB_sensors.SchDoc
circuit_board/wrs_v2/MCH_MAIN/MB_watchdog_mcu.SchDoc
circuit_board/wrs_v2/MCH_MAIN/MB_ZBT_memory.SchDoc
circuit_board/wrs_v2/MCH_MAIN/MCH_MAIN.PrjPcb
circuit_board/wrs_v2/mini_backplane/i2c_stuff.SchDoc
circuit_board/wrs_v2/mini_backplane/mini_backplane.PcbDoc
circuit_board/wrs_v2/mini_backplane/mini_backplane.PrjPcb
circuit_board/wrs_v2/mini_backplane/mini_backplane.SchDoc
circuit_board/wrs_v2/mini_backplane/power_supply.SchDoc
circuit_board/wrs_v2/mini_backplane/sfp_wrapper.SchDoc
circuit_board/wrs_v3/mini_backplane_18SFP/Connector_GTX.SchDoc
circuit_board/wrs_v3/mini_backplane_18SFP/Connectors_GPIOs.SchDoc
circuit_board/wrs_v3/mini_backplane_18SFP/Connectors_GPIOs_old.SchDoc
circuit_board/wrs_v3/mini_backplane_18SFP/FPGA_USB.SchDoc
circuit_board/wrs_v3/mini_backplane_18SFP/I2C_Multiplexers.SchDoc
circuit_board/wrs_v3/mini_backplane_18SFP/I2C_Peripherals.SchDoc
circuit_board/wrs_v3/mini_backplane_18SFP/Main.SchDoc
circuit_board/wrs_v3/mini_backplane_18SFP/miniBackplane_SFP.PrjPCB
circuit_board/wrs_v3/mini_backplane_18SFP/Power_Supply.SchDoc
circuit_board/wrs_v3/mini_backplane_18SFP/SFP.SchDoc
circuit_board/wrs_v3/mini_backplane_18SFP/TEST_USB.SchDoc
circuit_board/wrs_v3/mini_backplane_18SFP/WR_LINK.SchDoc
circuit_board/wrs_v3/mini_backplane_simple/mini_backplane.PcbDoc
circuit_board/wrs_v3/mini_backplane_simple/mini_backplane.SchDoc
circuit_board/wrs_v3/mini_backplane_simple/mini_backplane_simple.PrjPcb
circuit_board/wrs_v3/mini_backplane_simple/power_supply.SchDoc
circuit_board/wrs_v3/mini_backplane_simple/scb_connectors.SchDoc
circuit_board/wrs_v3/mini_backplane_simple/sfp_wrapper.SchDoc
circuit_board/wrs_v3/mini_backplane_simple/usb_uart.SchDoc
circuit_board/wrs_v3/mini_backplane_test/Clock_Buffers.SchDoc
circuit_board/wrs_v3/mini_backplane_test/FPGA_USB.SchDoc
circuit_board/wrs_v3/mini_backplane_test/Main.SchDoc
circuit_board/wrs_v3/mini_backplane_test/miniBackplane_test.PrjPCB
circuit_board/wrs_v3/mini_backplane_test/Power_Supply.SchDoc
circuit_board/wrs_v3/mini_backplane_test/SCB_Connectors.SchDoc
circuit_board/wrs_v3/mini_backplane_test/WR_MEZZANINE.SchDoc
circuit_board/wrs_v3/SCB/uTCA_MCH_PCB3.pcbdoc
circuit_board/wrs_v3/SCB_SAM9G45/Connectors.SchDoc
circuit_board/wrs_v3/SCB_SAM9G45/CPU_100M_Ethernet.SchDoc
circuit_board/wrs_v3/SCB_SAM9G45/CPU_DDR2.SchDoc
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
