Reedgarden/WRS-HW/(commit log)

2009-02-17 Uploaded clocking mezzanine. Incomplete version, don't review!
    [CLKB_analog_phase_detector.SchDoc, CLKB_clocking_fpga.SchDoc, CLKB_clocking_system.SchDoc, CLKB_main.SchDoc, CLKB_mainboard_connector.SchDoc, CLKB_power_regulators.SchDoc, CLKB_uplink_phy_and_sfp_1221.SchDoc, MCH_CLKB.PrjPcb]
2009-03-01 Schematics ready for 1st review
    [CLKB_clocking_fpga.SchDoc, CLKB_temp_sensors.SchDoc, MB_CPU_100m_ethernet.SchDoc, MB_CPU_io_ports.SchDoc, MB_CPU_memory.SchDoc, MB_ZBT_memory.SchDoc, MB_fpga_power.SchDoc, MB_main.SchDoc]
2009-04-29 uploaded MCH PCB photos
2009-06-04 Uploaded PDFs
    [AMC_SFP.PcbDoc, AMC_SFP.PrjPcb, CLKB_power_regulators.SchDoc, MCH_CLKB.PrjPcb, MCH_CLKB_PCB.PcbDoc, MCH_MAIN.PrjPcb]
2009-11-22 Updated symbol/footprint libraries with new components
2009-11-22 MCH_CLKB repo cleanup
    [CLKB_SMI_if_1_6.SchDoc, CLKB_mainboard_connector.SchDoc, CLKB_uplink_phy_and_sfp_1221.SchDoc]
2009-11-22 Rev 1.1 of MCH_CLKB uploaded
    [CLKB_RS232_port.SchDoc, CLKB_SFP_wrapper.SchDoc, CLKB_analog_phase_detector.SchDoc, CLKB_clocking_fpga.SchDoc, CLKB_clocking_system.SchDoc, CLKB_fabric_interface.SchDoc, CLKB_main.SchDoc, CLKB_power_regulators.SchDoc]
2009-11-22 Rev 1.1 of MCH_MAIN uploaded
    [MB_CPU_100m_ethernet.SchDoc, MB_CPU_io_ports.SchDoc, MB_CPU_memory.SchDoc, MB_ZBT_memory.SchDoc, MB_clocking.SchDoc, MB_downlink_phy.SchDoc, MB_fpga_power.SchDoc, MB_main.SchDoc]
2009-11-22 fiducials updated, unplated pads fixed
    [MCH_CLKB.PrjPcb, MCH_CLKB_PCB.PcbDoc, MCH_MAIN.PrjPcb]
2009-12-05 PDFs of MCH_MAIN schematics uploaded
    [MB_watchdog_mcu.SchDoc, MCH_MAIN.PrjPcb]
2010-04-01 CLKB PDF uploaded
    [MCH_CLKB_PCB.PcbDoc]
2010-06-23 updated PCB library
2010-06-24 PCB library update
2010-06-24 mini-backplane PCB for rev 1.1 MCH (initial commit)
    [MCH_MAIN_outline.PcbDoc, i2c_stuff.SchDoc, mini_backplane.PcbDoc, mini_backplane.PrjPcb, mini_backplane.SchDoc, sfp_wrapper.SchDoc, xpoint.SchDoc]
2010-09-22 HW: updated SCH/PCB libraries
2010-09-22 HW: updated mini-backplane (front panel added)
    [mini_backplane.PcbDoc, mini_backplane.PrjPcb]
2011-03-16 Preliminary SCB Schematic and PCB version.
    [CPU_100M_Ethernet.SchDoc, CPU_IO_Ports.SchDoc, CPU_JTAG_Power_PLL.SchDoc, CPU_Memory.SchDoc, Connectors.SchDoc, External WatchDogs.SchDoc, FPGA_CLKs.SchDoc, FPGA_CPU_EBI1.SchDoc]
2011-03-16 Preliminary SCB Schematic and PCB version. (Deleted not used sch libs).
    [External WatchDogs.SchDoc, SCB.PrjPCB]
2011-03-16 Preliminary SCB Schematic and PCB version. Added SCB.pdf schematics in pdf format.
2011-03-16 updated pcb libs
2011-03-16 Bug in BOOT pin of TPS54917 of Power_Supply.SchDoc corrected.
    [Power_Supply.SchDoc]
2011-03-17 Bug in BOOT pin of TPS54917 of Power_Supply.SchDoc corrected on PDF version.
2011-03-17 Uploaded a different PCB components placement.
    [uTCA_MCH_PCB3.pcbdoc]
2011-03-17 Uploaded a different PCB components placement. Added more components.
    [uTCA_MCH_PCB3.pcbdoc]
2011-03-22 Added preliminary stack-up for PCB.
2011-03-24 Modified some of the CERN comments.
    [CPU_100M_Ethernet.SchDoc, CPU_IO_Ports.SchDoc, CPU_JTAG_Power_PLL.SchDoc, Connectors.SchDoc, External WatchDogs.SchDoc, FPGA_CLKs.SchDoc, FPGA_CPU_EBI1.SchDoc, FPGA_Configuration.SchDoc]
2011-03-25 Changed Ethernet PHY.
    [CPU_100M_Ethernet.SchDoc, Connectors.SchDoc, FPGA_CLKs.SchDoc]
2011-03-28 Changed Power_Supply.SchDoc. (Used TPS53126) Annotated Design.
    [CPU_100M_Ethernet.SchDoc, CPU_IO_Ports.SchDoc, CPU_JTAG_Power_PLL.SchDoc, Connectors.SchDoc, FPGA_CLKs.SchDoc, FPGA_CPU_EBI1.SchDoc, FPGA_Configuration.SchDoc, FPGA_GPIOs.SchDoc]
2011-03-29 Version with CERN comments implemented.
    [CPU_Memory.SchDoc, Connectors.SchDoc, FPGA_CLKs.SchDoc, FPGA_PLLs.SchDoc, Power_Supply.SchDoc]
2011-03-29 Design rules and PCB stack-up added. Updated according to the last schematics version (933).
    [uTCA_MCH_PCB3.pcbdoc]
2011-03-29 Added Power Jack to Connectors.SchDoc (not used in WR, for production testing) IVT3200 footprint corrected.
    [Connectors.SchDoc, FPGA_CLKs.SchDoc]
2011-03-30 Swapping of QDR terminating resistors pins.
    [uTCA_MCH_PCB3.pcbdoc]
2011-03-30 Power jack connector J4 added IC23 footprint added
    [uTCA_MCH_PCB3.pcbdoc]
2011-03-30 SCB.PrjPCBstructure added
    [SCB.PrjPCB]
2011-03-30 Changed pin 25 of Ethernet PHY by PAD. Changed package of AD8541 to SC-70. Changed parameters of some components in order to clarify the part-list.
    [CPU_100M_Ethernet.SchDoc, CPU_Memory.SchDoc, FPGA_CLKs.SchDoc, FPGA_PLLs.SchDoc, Power_Supply.SchDoc, SCB.PrjPCB]
2011-03-31 Updated according to the last schematics version.
    [uTCA_MCH_PCB3.pcbdoc]
2011-03-31 Generated BGA-90 footprint for IS42S32160B. Changed SDRAM memory to BGA-90 case.
    [CPU_Memory.SchDoc]
2011-03-31 Updated last changes of schematics in SCB.pdf
2011-03-31 The footprint of the component IS42S32160B-75EBLI(IC29) has been modified.
2011-03-31 The footprint of the component T1 has been added.
2011-03-31 Selected isolation transformer Tr2. Updated WBC1-1LB symbol and footprint. Updated not mounted components for White Rabbit V3.
    [CPU_IO_Ports.SchDoc, FPGA_CLKs.SchDoc, FPGA_Configuration.SchDoc, FPGA_System_Monitor.SchDoc]
2011-04-01 Changed pinout FPGA_QDRII.SchDoc Added FPGA_Peripheral_Control.SchDoc sheet.
    [CPU_IO_Ports.SchDoc, FPGA_Configuration.SchDoc, FPGA_POWER_DGND.SchDoc, FPGA_Peripherals_Control.SchDoc, FPGA_QDRII.SchDoc, FPGA_System_Monitor.SchDoc, SCB.PrjPCB, SCB_MAIN.SchDoc]
2011-04-04 Updated PCB according to last schematics version
    [SCB.PrjPCB, uTCA_MCH_PCB3.pcbdoc]
2011-04-05 Changed some component cases from 0402 to 0603.
    [FPGA_CLKs.SchDoc, SCB_PLLs.SchDoc, uTCA_MCH_PCB3.pcbdoc]
2011-04-06 Updated footprint headers.
    [CPU_IO_Ports.SchDoc, Connectors.SchDoc, SCB_MAIN.SchDoc]
2011-04-06 Updated SCB.pdf with last schematics version.
2011-04-07 pin swapping QDRII.
    [FPGA_CPU_EBI1.SchDoc, FPGA_Configuration.SchDoc, FPGA_GPIOs.SchDoc, FPGA_GTX.SchDoc, FPGA_POWER_DGND.SchDoc, FPGA_Peripherals_Control.SchDoc, FPGA_QDRII.SchDoc, FPGA_System_Monitor.SchDoc]
2011-04-07 MC100EPT21DG case changed to SOIC-8
    [SCB_PLLs.SchDoc]
2011-04-08 Footprints (silkscreen) of SMD Capacitors and Resistors updated .
    [Power_Supply.SchDoc]
2011-04-08 Added pull-down in FBOOT_SEL FPGA_CLKs.SchDoc renamed SCB_CLKs.SchDoc (SCB_MAIN.SchDoc updated)
    [CPU_Memory.SchDoc, SCB.PrjPCB, SCB_CLKs.SchDoc, SCB_MAIN.SchDoc]
2011-04-11 CPU VDDIOP1 power supply changed to +3V3 VIN and EN of TPS51200 connected to +2V5
    [CPU_JTAG_Power_PLL.SchDoc, QDRII_power.SchDoc]
2011-04-26 QDR1 routed.
    [uTCA_MCH_PCB3.pcbdoc]
2011-04-27 Changes of some component references.
    [Connectors.SchDoc, FPGA_Configuration.SchDoc, SCB.PrjPCB, SCB_MAIN.SchDoc, SCB_PLLs.SchDoc]
2011-04-27 Added preliminary SCB version with the new SAM9G45 ARM.
    [CPU_100M_Ethernet.SchDoc, CPU_DDR2.SchDoc, CPU_EBI1_FPGA_Memory.SchDoc, CPU_IO_Ports.SchDoc, CPU_JTAG_Power_PLL.SchDoc, Connectors.SchDoc, External WatchDogs.SchDoc, FPGA_Configuration.SchDoc]
2011-04-27 Added pdf preliminary SCB version with the new SAM9G45 ARM.
2011-04-28 PCB updated with schematic changes.
    [SCB.PrjPCB]
2011-04-28 Added Tomasz comments: -Free pins on J2 left -EBI1_NBS3 connected to FPGA -PCB updated
    [CPU_EBI1_FPGA_Memory.SchDoc, Connectors.SchDoc]
2011-04-29 Added a different SCB_PLL option.
    [SCB.PrjPCB]
2011-05-03 Balun added on EXTREF signal.
    [SCB_PLLs_Option2.SchDoc]
2011-05-03 Balun added on EXTREF signal. References updated. Added RT and RN for FPGA DCI.
    [CPU_EBI1_FPGA_Memory.SchDoc, FPGA_Configuration.SchDoc, SCB.PrjPCB]
2011-05-05 FPGA pin swapping
    [SMI_Link_7-12.SchDoc]
2011-05-05 Final SCB version with the new SAM9G45 ARM. SCB_PLLs.SchDoc changed. Added 1x5 LVPECL driver for GTXs. Removed IC14 CDCM61002. Added Balun on EXTREF125 output signal.
    [CPU_100M_Ethernet.SchDoc, CPU_DDR2.SchDoc, Connectors.SchDoc, FPGA_Peripherals_Control.SchDoc, SCB_CLKs.SchDoc, SCB_MAIN.SchDoc, SCB_PLLs.SchDoc]
2011-05-05 Updated PCB with the last changes.
2011-05-05 Add PDF SCB schematics with the SAM9G45
2011-05-05 PCB modified.
    [SCB_PLLs.SchDoc]
2011-05-06 Added capacitor on ADCMP600 input (-) PCB updated. Libraries updated.
    [SCB.PrjPCB, SCB_CLKs.SchDoc]
2011-05-10 PCB Ethernet routing updated.
2011-05-11 Added 125MHz clock to J2 (for the miniBackplane). Added diode and resistor protection on EXTPPSIN imput from GPS.
    [Connectors.SchDoc, SCB.PrjPCB, SCB_CLKs.SchDoc, SCB_MAIN.SchDoc, SCB_PLLs.SchDoc]
2011-05-11 PCB updated. Added new 125MHz clock on PLL.
2011-05-12 DDR routed.
    [CPU_DDR2.SchDoc, CPU_EBI1_FPGA_Memory.SchDoc, FPGA_Configuration.SchDoc, FPGA_GPIOs.SchDoc, FPGA_GTX.SchDoc, FPGA_POWER_DGND.SchDoc, FPGA_Peripherals_Control.SchDoc, FPGA_QDRII.SchDoc]
2011-05-12 Changed all GPIOs of ARM from J1 to J2 in order to facilitate the PCB routing.
    [Connectors.SchDoc]
2011-05-13 Not used files removed.
    [SCB_PLLs_Option2.SchDoc]
2011-05-13 PCB updated. DCDCs power supply routing enhanced.
2011-05-16 Updated pcb routing (SCB_CLKs)
2011-05-17 GPIOs routed.
    [CPU_EBI1_FPGA_Memory.SchDoc, Connectors.SchDoc, FPGA_Configuration.SchDoc, FPGA_GPIOs.SchDoc, FPGA_GTX.SchDoc, FPGA_POWER_DGND.SchDoc, FPGA_Peripherals_Control.SchDoc, FPGA_QDRII.SchDoc]
2011-05-17 QDR termination resistors routed.
2011-05-18 QDRII symbol updated (VSS lost pins added)
    [QDRII_power.SchDoc]
2011-05-20 Added USB signals as differential pairs. PCB routing updated.
    [CPU_EBI1_FPGA_Memory.SchDoc, Connectors.SchDoc, RS232_and_USB_ports.SchDoc, SCB.PrjPCB, SCB_MAIN.SchDoc]
2011-05-23 PCB routing updated.
2011-05-25 ARM routed.
2011-06-02 Flash_FPGA routed.
    [CPU_EBI1_FPGA_Memory.SchDoc, Connectors.SchDoc, FPGA_Configuration.SchDoc, FPGA_GPIOs.SchDoc, FPGA_GTX.SchDoc, FPGA_POWER_DGND.SchDoc, FPGA_Peripherals_Control.SchDoc, FPGA_QDRII.SchDoc]
2011-06-02 Bugs in D12 and D13 removed.
    [QDRII_mem.SchDoc]
2011-06-02 Added EXTREFIN_10M as differential pair
    [CPU_DDR2.SchDoc, Connectors.SchDoc, FPGA_Peripherals_Control.SchDoc, Power_Supply.SchDoc, SCB_CLKs.SchDoc, SCB_MAIN.SchDoc]
2011-06-08 New 12 layers PCB routing.
    [SCB.PrjPCB]
2011-06-08 New 12 layers PCB routing updated (QDR coupling added)
2011-06-13 PCB routing updated (FPGA vias added).
2011-06-13 pin swapping (rafa)
    [FPGA_QDRII.SchDoc, SMI_Link_7-12.SchDoc]
2011-06-18 QDRII pin swapping updated to schematic sheet. PCB routing updated (cut-out of ethernet connector added)
    [QDRII_mem.SchDoc]
2011-06-21 PCB routing updated. FPGA decoupling capacitors added.
2011-06-21 PCB routing updated (power planes defined).
2011-06-23 Almost finished PCB routing version, except comments from CERN.
2011-06-29 Thermal pads enabled in power supply routing. Little faults on tracks removed.
2011-07-05 Added more Tomasz's comments: -Main clock oscillators moved close to PLL -Distance between differential pairs and signals increased -Thermal pad enabled
    [CPU_JTAG_Power_PLL.SchDoc, Connectors.SchDoc, Power_Supply.SchDoc, SCB_PLLs.SchDoc]
2011-07-06 Silkscreen updated
2011-07-07 Silkscreen updated DACs and LDOs moved close to main oscillators To merge with Tomasz's version
2011-07-10 PCB libraries updated
2011-07-11 temporary commit of the PCB
    [CPU_100M_Ethernet.SchDoc, SCB.PrjPCB, SCB_CLKs.SchDoc]
2011-07-11 temporary commit of PCB
    [SCB_MAIN.SchDoc]
2011-07-11 Tom's fixed release
    [SCB_MAIN.SchDoc]
2011-07-12 Added Farnell reference of xtals. Version send to manufacturer.
    [CPU_JTAG_Power_PLL.SchDoc, External WatchDogs.SchDoc, SCB_CLKs.SchDoc]
2011-07-14 Fixed net connection of Ground layer to Gnd and Gnd_Phy
2011-08-01 Changes not for White Rabbit: Added somes new symbols. Footprints modified
2011-08-02 Uploaded the SCB Manufacturing PCB Specification.pdf version 0.0
2011-08-02 Uploaded the Manufacturing PCB Documents: -Gerbers -Drills -Pick-and-place -PCB specifications
2011-08-26 First miniBackplane V3 PCB Altium project version.
    [Clock_1to20_Buffer.SchDoc, Connector_GTX.SchDoc, Connectors.SchDoc, Connectors_GPIOs.SchDoc, I2C_GPIO_Expansion.SchDoc, I2C_Multiplexers.SchDoc, Main.SchDoc, PHY.SchDoc]
2011-08-26 First version sent to CERN to preliminary review.
    [Clock_1to20_Buffer.SchDoc, Connector_GTX.SchDoc, Connectors_GPIOs.SchDoc, I2C_GPIO_Expansion.SchDoc, I2C_Multiplexers.SchDoc, Main.SchDoc, PHY.SchDoc, Power_Supply.SchDoc]
2011-08-30 Added 3.3V DCDC converter to the Power Supply.
    [Power_Supply.SchDoc, miniBackplane.PrjPCB]
2011-08-30 Added multiplexers in order to allow control to I2Cs by FPGA or ARM.
    [Connector_GTX.SchDoc, Connectors_GPIOs.SchDoc, I2C_GPIO_Expansion.SchDoc, I2C_Multiplexers.SchDoc, Main.SchDoc, PHY.SchDoc, Power_Supply.SchDoc, SFP.SchDoc]
2011-09-14 Added pdf schematic file
    [miniBackplane.PrjPCB]
2011-09-21 PCB: uploaded V3 simple mini-backplane (wip)
    [mini_backplane.PcbDoc, mini_backplane.SchDoc, mini_backplane_simple.PrjPcb, power_supply.SchDoc, scb_connectors.SchDoc, sfp_wrapper.SchDoc, usb_uart.SchDoc]
2011-09-21 PCB: "simple" V3 minibackplane uploaded
    [mini_backplane.PcbDoc, mini_backplane_simple.PrjPcb, power_supply.SchDoc, sfp_wrapper.SchDoc, usb_uart.SchDoc]
2011-09-22 release for review
    [mini_backplane.PcbDoc, mini_backplane.SchDoc, mini_backplane_simple.PrjPcb, power_supply.SchDoc, scb_connectors.SchDoc, sfp_wrapper.SchDoc, usb_uart.SchDoc]
2011-09-22 PCB: production docs for V3 simple mini-backplane
    [mini_backplane.DRL, mini_backplane.GBL, mini_backplane.GBS, mini_backplane.GM1, mini_backplane.GTL, mini_backplane.GTO, mini_backplane.GTP, mini_backplane.GTS]
2011-09-30 New version more similar to the Tomasz's mini version: Power supply from 12V Added USB port to FPGA Multiplexers for FPGA/ARM control removed Added fans for FPGA and Switch Box PHYs I2C signal contro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
    [Clock_1to20_Buffer.SchDoc, Connector_GTX.SchDoc, Connectors_GPIOs.SchDoc, FPGA_USB.SchDoc, I2C_Multiplexers.SchDoc, Main.SchDoc, PHY.SchDoc, Power_Supply.SchDoc]
2011-09-30 Added new schematics symbols and pcb footprints.
2011-09-30 New version more similar to the Tomasz's mini version: Power supply from 12V Added USB port to FPGA Multiplexers for FPGA/ARM control removed Added fans for FPGA and Switch Box PHYs I2C signal contro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
2011-10-04 Added Tomasz comments. Removed cupper PHYs, SFP version of switch.
    [Connectors_GPIOs.SchDoc, FPGA_USB.SchDoc, I2C_Multiplexers.SchDoc, Main.SchDoc, Power_Supply.SchDoc, WR_LINK.SchDoc, miniBackplane.PrjPCB]
2011-10-06 miniBackplane_test initial version of schematics.
    [Clock_Buffers.SchDoc, FPGA_USB.SchDoc, Main.SchDoc, Power_Supply.SchDoc, SCB_Connectors.SchDoc, WR_MEZZANINE.SchDoc, miniBackplane_test.PrjPCB]
2011-10-06 miniBackplane_SFP (optical fiber WR Switch version) initial version of schematics.
    [Connector_GTX.SchDoc, Connectors_GPIOs.SchDoc, FPGA_USB.SchDoc, I2C_Multiplexers.SchDoc, Main.SchDoc, Power_Supply.SchDoc, SFP.SchDoc, WR_LINK.SchDoc]
2011-10-06 Updated libraries including the new schematic symbols and footprints for the new miniBackplane versions.
2011-10-07 Removed 8 PCA9554A chips. Two SFPs controlled by one chip. Removed I2C multiplexer. WR_LINK.SchDoc modified, now it includes two SFPs. Removed SFP.SchDoc schematic sheet in order to remove its room (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
    [Connector_GTX.SchDoc, Connectors_GPIOs.SchDoc, FPGA_USB.SchDoc, I2C_Multiplexers.SchDoc, Main.SchDoc, Power_Supply.SchDoc, SFP.SchDoc, WR_LINK.SchDoc]
2011-10-11 Rooms routed. Changed Leds in order to reduce space.
    [Connectors_GPIOs.SchDoc, FPGA_USB.SchDoc, I2C_Multiplexers.SchDoc, Power_Supply.SchDoc, WR_LINK.SchDoc, miniBackplane_SFP.PrjPCB]
2011-10-19 First routed PCB version. Two leds of each SFP have been replaced by discrete components and placed in the bottom layer in order to reduce PCB dimensions. Removed I2C pull-up resistors.
    [Connectors_GPIOs.SchDoc, FPGA_USB.SchDoc, I2C_Multiplexers.SchDoc, Main.SchDoc, Power_Supply.SchDoc, WR_LINK.SchDoc, miniBackplane_SFP.PrjPCB]
2011-10-19 Modified silkscreen.
    [Main.SchDoc, WR_LINK.SchDoc]
2011-10-21 Added Bi-color led.
2011-10-21 Added some of the Tomasz comments.
    [Connectors_GPIOs.SchDoc, FPGA_USB.SchDoc, I2C_Multiplexers.SchDoc, Main.SchDoc, Power_Supply.SchDoc, WR_LINK.SchDoc]
2011-10-21 Added o.c. capacitor to the mounting holes.
    [Connector_GTX.SchDoc, Connectors_GPIOs.SchDoc, Main.SchDoc]
2011-10-25 Modified footprints
2011-10-25 Modified footprints of: -. SFPs -. DB-9 Connector -. S2M and SK-106 diodes -. USB connectors PCB Height increased to 1.49mm
    [Connectors_GPIOs.SchDoc, WR_LINK.SchDoc]
2011-10-28 Updated symbols and footprints for SCB bugs.
2011-10-28 Added test pads for power supplies.
2011-11-07 Routing changes. This is the version to manufacturing the PCB.
    [Connectors_GPIOs.SchDoc, Power_Supply.SchDoc, miniBackplane_SFP.PrjPCB]
2011-11-08 Changed PCB dimensions on "Multi-Layer" layer from 174.60mm to 174.40mm.
2011-12-02 Added new symbols and footprints.
2011-12-02 Fixed bugs detected in previous version of PCB. Added some modifications. For more information see "SCB_Bugs_Changes.odt" file.
    [CPU_DDR2.SchDoc, CPU_EBI1_FPGA_Memory.SchDoc, CPU_IO_Ports.SchDoc, CPU_JTAG_Power_PLL.SchDoc, Connectors.SchDoc, External WatchDogs.SchDoc, FPGA_Configuration.SchDoc, FPGA_GPIOs.SchDoc]
2011-12-07 Changed order of SMC connectors to group input and output signals.
    [Connectors.SchDoc]
2011-12-09 Updated Manufacturer and Distributors parameters.
    [CPU_JTAG_Power_PLL.SchDoc, Connectors.SchDoc, FPGA_Configuration.SchDoc, QDRII_power.SchDoc, SCB_CLKs.SchDoc]
2011-12-13 CERN copyright and licensing included.
    [CPU_100M_Ethernet.SchDoc, CPU_DDR2.SchDoc, CPU_EBI1_FPGA_Memory.SchDoc, CPU_IO_Ports.SchDoc, CPU_JTAG_Power_PLL.SchDoc, Connectors.SchDoc, External WatchDogs.SchDoc, FPGA_Configuration.SchDoc]
2011-12-13 CERN copyright and licensing included on schematics and PCB.
    [Connector_GTX.SchDoc, Connectors_GPIOs.SchDoc, FPGA_USB.SchDoc, I2C_Multiplexers.SchDoc, Main.SchDoc, Power_Supply.SchDoc, WR_LINK.SchDoc, miniBackplane_SFP.PrjPCB]
2011-12-15 First version of the White Rabbit V3 Box. Autocad and PDF files.
    [White Rabbit V3 Box.dwg]
2012-01-24 Added new symbols and footprints for SophiV4
2012-04-04 Version 3.2 of schematics and PCB. Changes inside SCB_3_1_Bugs_Changes.odt file
    [CPU_EBI1_FPGA_Memory.SchDoc, CPU_IO_Ports.SchDoc, CPU_JTAG_Power_PLL.SchDoc, FPGA_Configuration.SchDoc, FPGA_Peripherals_Control.SchDoc, FPGA_System_Monitor.SchDoc, Power_Supply.SchDoc, RS232_and_USB_ports.SchDoc]
2012-04-04 Added SCB Part List
    [SCB_White_Rabbit_Part_List_3_2a.xls]
2012-04-10 0402 footprints modified, silkscreen between pads removed.
2012-04-10 Q2 changed to NMOS R31 and R32 footprint changed to 0805 FPGA_Init_B signal modified.
    [CPU_IO_Ports.SchDoc, FPGA_Configuration.SchDoc, SCB_CLKs.SchDoc]
2012-04-16 J2 pins realigned. Added SCB net names on J2 pins.
    [Connectors_GPIOs.SchDoc, Main.SchDoc, WR_LINK.SchDoc, miniBackplane_SFP.PrjPCB]
2012-05-03 Issue 3.2 of miniBackplane 18 SFP Ports version. See "Bugs and changes of V3_2.odt" for changes.
    [Connector_GTX.SchDoc, Connectors_GPIOs.SchDoc, I2C_Multiplexers.SchDoc, Main.SchDoc, Power_Supply.SchDoc, TEST_USB.SchDoc, WR_LINK.SchDoc, miniBackplane_SFP.PrjPCB]
2012-05-03 Added pdf of schematics.
2012-05-09 Version used for manufacturing this series.
    [miniBackplane_SFP_Part_List_V3_2.xls]
2012-06-12 I2C Temperature sensor changed by TMP100. Solder mask added on two vias below the FPGA. Updated names of FPGA USB nets.
    [CPU_EBI1_FPGA_Memory.SchDoc, Connectors.SchDoc, FPGA_System_Monitor.SchDoc, SCB_CLKs.SchDoc, SCB_MAIN.SchDoc]
2012-06-12 Part List V3.2 updated.
    [SCB_White_Rabbit_Part_List_3_2.xls]
2012-06-12 Updated sheet templates in order to modify the title blocks.
    [CPU_100M_Ethernet.SchDoc, CPU_DDR2.SchDoc, CPU_EBI1_FPGA_Memory.SchDoc, CPU_IO_Ports.SchDoc, CPU_JTAG_Power_PLL.SchDoc, Connectors.SchDoc, External WatchDogs.SchDoc, FPGA_Configuration.SchDoc]
2012-07-13 Changed the address of the I2C Temperature Sensors.
    [FPGA_System_Monitor.SchDoc]
2012-10-09 Added 75R resistor to wr_switch.SchLib
2012-10-09 The schematics changes performed on the V3.2 are the following: 1.- SCB_PLLs: C165 footprint changed to 0402 in order to remove this component and reduce boom. 2.- Connectors:CN1 Ethernet connector c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
    [CPU_100M_Ethernet.SchDoc, CPU_DDR2.SchDoc, CPU_EBI1_FPGA_Memory.SchDoc, CPU_IO_Ports.SchDoc, CPU_JTAG_Power_PLL.SchDoc, Connectors.SchDoc, External WatchDogs.SchDoc, FPGA_Configuration.SchDoc]
2012-10-17 PCB V3.3 updated with schematics changes. PCB assembler suggestions added.
2012-10-19 Initial V3.3 issue.
    [Connector_GTX.SchDoc, Connectors_GPIOs.SchDoc, Connectors_GPIOs_old.SchDoc, FPGA_USB.SchDoc, I2C_Multiplexers.SchDoc, Main.SchDoc, Power_Supply.SchDoc, SFP.SchDoc]
2012-10-22 Added external GND planes
2012-10-25 Updated PCB and schematics
    [Connector_GTX.SchDoc, Connectors_GPIOs.SchDoc, I2C_Multiplexers.SchDoc, Main.SchDoc, TEST_USB.SchDoc, WR_LINK.SchDoc, miniBackplane_SFP.PrjPCB]
2012-10-26 Updated PCB routing
2012-10-31 Added Switch Right Angle Button
2012-10-31 Schematics error fixed according to the new BOM
    [FPGA_QDRII.SchDoc, SCB_PLLs.SchDoc]
2012-11-05 PCB Updated
2012-11-06 PCB footprints and schematics updated
2012-11-06 Updated PCB and schematics. Changes are in the "Bugs and changes of V3_3.odt" doc
    [Connector_GTX.SchDoc, Connectors_GPIOs.SchDoc]
2012-11-08 Updated PCB and schematics. Changes are in the "Bugs and changes of V3_3.odt" doc. Clearance of polygon increased up to 0.2 mm (PCB manufacturing requirement)
2012-11-09 ARM Led and ARM USB connector moved according to Rodrigo's suggestions. Chassis hole for SCB changed, it was bad. o.c. capacitor C42 between Chassis and a hole removed.
    [Main.SchDoc]
2012-11-12 Updated PCB and schematics. Changes are in the "Bugs and changes of V3_3.odt" doc Fans connector changed by the P/N 61900211121 of Würth
    [Connectors_GPIOs.SchDoc, Main.SchDoc, miniBackplane_SFP.PrjPCB, miniBackplane_SFP_Part_List_V3_3.xls]
2013-01-21 SCB V3.3 pdf schematics added
2013-01-21 miniBackplane V3.3 pdf schematics added
2013-07-22 mechanics: adding the 4.1.2 box (for wr switch v3.3)
    [Version 4-1-2.dwg]
2013-07-22 mechanics: Renaming files to fit with wrs version
    [White Rabbit V3 Box.dwg, wrs-v3.3-box_v4-1-2.dwg]
2014-09-25 misc: move all v2.x files to the wrs_v2 folder
    [AMC_SFP.PcbDoc, AMC_SFP.PrjPcb, AMC_SFP.SchDoc, CLKB_RS232_port.SchDoc, CLKB_SFP_wrapper.SchDoc, CLKB_analog_phase_detector.SchDoc, CLKB_clocking_fpga.SchDoc, CLKB_clocking_system.SchDoc]
2014-09-25 misc: clean-up old and unused files
    [CPU_100M_Ethernet.SchDoc, CPU_IO_Ports.SchDoc, CPU_JTAG_Power_PLL.SchDoc, CPU_Memory.SchDoc, Clock_1to20_Buffer.SchDoc, Connector_GTX.SchDoc, Connectors.SchDoc, Connectors_GPIOs.SchDoc]
2014-09-25 SCB: clean part list files
    [SCB_White_Rabbit_Part_List_3_2.xls, SCB_White_Rabbit_Part_List_3_2a.xls, SCB_White_Rabbit_Part_List_3_3.xls]
2014-09-25 misc: clean up mini-backplane folders
    Remove miniBackplane_SFP which was a copy of v3.2
    Rename miniBackplane_18Ports_SFP_V3.3/ to mini_backplane_18SFP/
    Rename miniBackplane_test/ to mini_backplane_test/
    [Clock_Buffers.SchDoc, Connector_GTX.SchDoc, Connectors_GPIOs.SchDoc, Connectors_GPIOs_old.SchDoc, FPGA_USB.SchDoc, I2C_Multiplexers.SchDoc, I2C_Peripherals.SchDoc, Main.SchDoc]
2014-09-25 misc: clean up schematics files
2014-09-25 wrs3: update altium files for SCB v3.3 to v3.4
    Schematics:
    ------------
    * C165 value changed from 100nF to 220nF
    * VCC_IN of CDCM61002 (IC13) connected to +3V3
    * RSTN pin of IC13 conected to a 47nF capacitor, not to +3V3
    * QDRII_200CLK moved to OUT3 (LVPECL) of AD9516.
    * Added LVDS termination resistor to adapt OUT3 to LVDS format
    * CLK_OUT (EXTREF125MHZOUT) connected to OUT9 (CMOS) of AD9516-4.
    * CLK_OUT transformer changed by 1:1 (WBC1-1LB)
    * R253 and R254 resistor (Ethernet sheet) changed to 0402 size in order
    to reduce items.
    * Changed EXTPPSIN input stage in order to add 50 R termination
    selectable by the FPGA.
    * Name of nets QDRII_CLK and QDRII_200CLK changed to REF_CLK and
    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
    [CPU_100M_Ethernet.SchDoc, CPU_DDR2.SchDoc, CPU_EBI1_FPGA_Memory.SchDoc, CPU_IO_Ports.SchDoc, CPU_JTAG_Power_PLL.SchDoc, Connectors.SchDoc, External WatchDogs.SchDoc, FPGA_Configuration.SchDoc]
2014-09-25 scb: add partlist file 3.4.1 for SCB v3.4
    [SCB_White_Rabbit_Part_List_3_4.1.xls]
2014-09-25 scb: add pdf file of schematics for v3.4
2014-09-25 mechanics: update box files for SCB v3.4
    [silk-screen_printing_v3.4.dwg]
2014-09-25 SCB - fixed PCB manufacturing issues mini backplane - PCB synchronization with SCH, signal integrity issues
    [CPU_EBI1_FPGA_Memory.SchDoc, Connectors.SchDoc, Connectors_GPIOs.SchDoc, FPGA_Configuration.SchDoc, FPGA_GPIOs.SchDoc, FPGA_GTX.SchDoc, FPGA_POWER_DGND.SchDoc, FPGA_Peripherals_Control.SchDoc]
2015-11-12 box: adding partlist for v3.3/v3.4 scb
    [BOX_WRS_PART_LIST.xls]
2016-04-26 Added Creotech mechanical files
    [WRS_assembly_20160425.stp]
